jdb666/cao_hc16/book/img/m_glissiere_transp.jpg

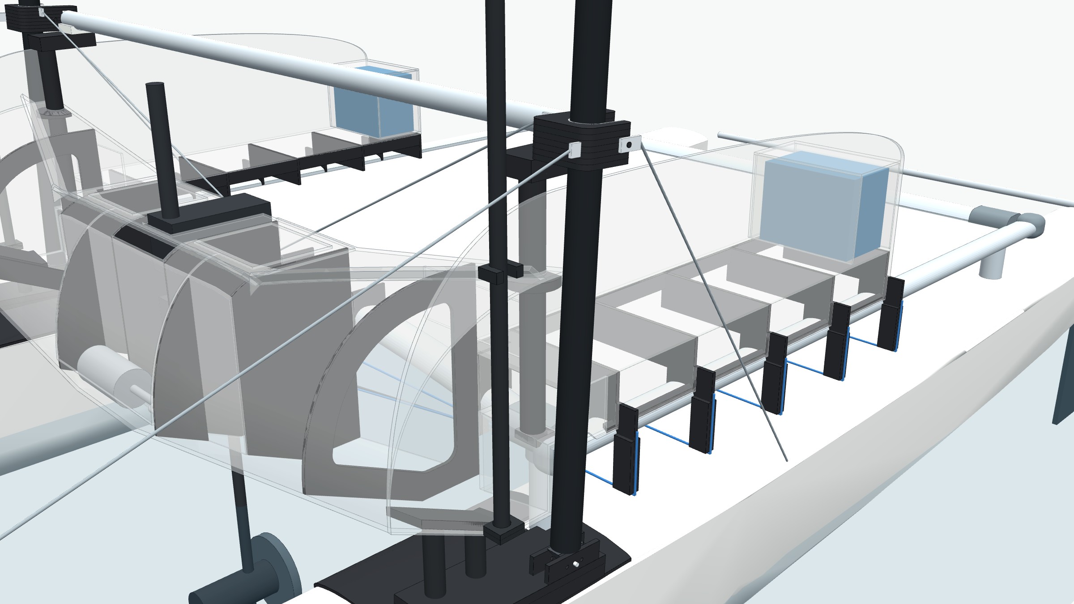
book/img/m_glissiere_transp.jpg
