jdb666/cao_hc16/book/img/blobs/b29e73918799de3eab84e8f3c63f0d14.jpg

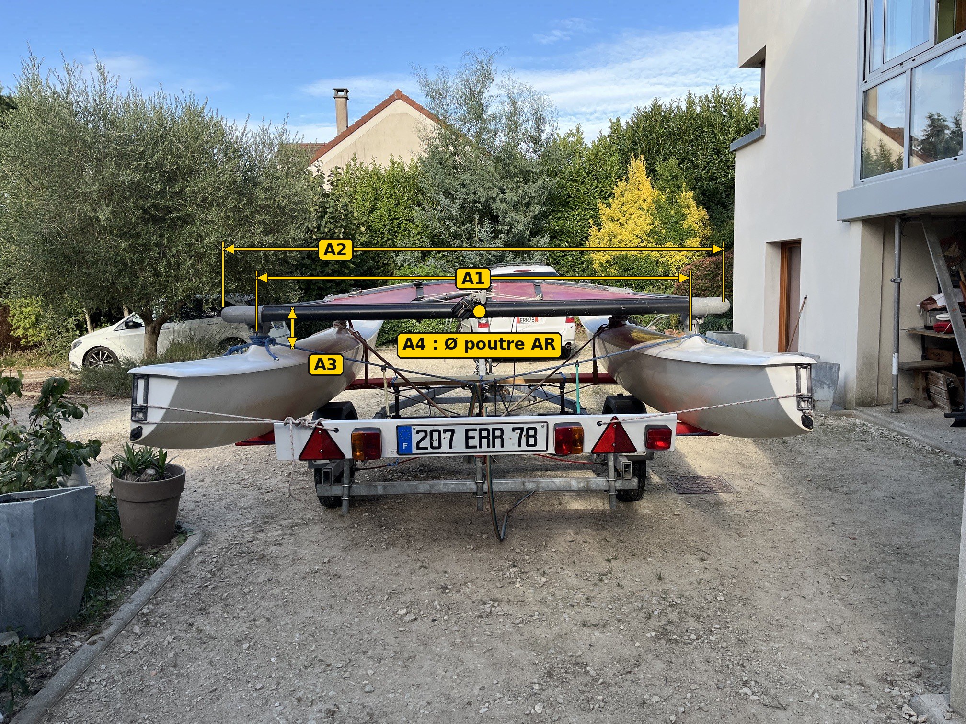
book/img/blobs/b29e73918799de3eab84e8f3c63f0d14.jpg
