jdb666/cao_hc16/SYNTHESE_coffre_hc16.md

# HC16 Rando — coffre porte-mâts et bancs : état du projet (12/10/2026)

## Repère et sources
- Origine : étrave à la flottaison, dans l'axe. X vers l'arrière, Y vers bâbord, Z vers le haut. Unités : mm.
- Ce repère est indirect : un logiciel de CAO affiche les STEP en miroir (bâbord à droite en regardant vers l'avant). Sans effet sur la plateforme, symétrique ; à garder en tête pour le moteur décalé. Les pages 3D (three.js) remettent le bon côté.
- Coques : profil et plan F. Chevalier recalés (±30 mm), sections simplifiées. Plan de voilure : plan Rando de JD (1/25).
- Modèle paramétrique : `hc16_rando.py` lit `cotes.yaml` et régénère le STEP (`python hc16_rando.py cotes.yaml sortie.step`).

## Contraintes figées (décisions JD)
- Nom du projet : HC16 Rando (JD 08/10/2026 : plus de référence au Nacra 5.80).
- Voile d'origine et hauteur de bordure inchangées ; mâts posés sur le pont des coques (pas emplantés au fond).
- Quête 3° ; pied de mât placé pour que le CV voiles pleines = CV HC16 d'origine.
- Collier de mât à 70–80 cm du pied, porté par la joue (JD 06/10 : il tourne sur le tube des colliers ; JD 08–09/10 : c'est le tube qui repose, à plat, sur deux poteaux carbone logés dans le coffre).
- Joues arrondies (JD 30/09) : superellipses, avant tangent à l'horizontale au collier (exposant 2,3 ; 2 = ellipse), dessus plat du collier à C4, dossier en quart de superellipse (2,2) ; extrémités = pointe avant du coffre, collier, bout arrière du banc. JD 09/10 : la joue monte d'un seul trait de la pointe au haut du dossier (400 au-dessus de l'assise, z 1 085), sans décrochage ; le coffre s'arrête dessous (927 contre la joue).
- Coffre cousu-collé : fond et dessus polygonaux à 3 segments (bas au milieu), dessus qui rejoint les colliers de mât ; fond d'abord plat (pente 0°, JD 29/09), puis descendu sous le puits moteur pour que l'hélice relevée y rentre (JD 29/09 soir : z 250, pente 12° vers l'avant) ; rien ne descend sous le fond ; pylônes au bout. JD 09/10 : coffre en moustache, dessus et fond à 10° vers les joues (fond plat ±150 à z 270), fond à 25° vers l'avant, hiloire en haut de l'arrondi ; poche à ancre ouverte devant, puits du moteur ouvert derrière.
- Moteur (JD 29/09/2026 soir) : bascule abandonnée ; relevage vertical dans l'axe, l'arbre coulisse dans sa bride ; l'hélice rentre dans le coffre (puits 256 × 300 ouvert dessous) ; bras rabattu du tube des colliers pour le tenir en haut. Voir « Moteur à relevage vertical dans l'axe ». Variantes « avant2 » (bascule vers l'avant), « arriere », « transversal », « avant » et « vertical » conservées dans le script.
- Batterie (JD 29/09 soir) : bac 650 × 315 × 320 (longueur, largeur, hauteur) devant le moteur, en travers, dans un compartiment ajusté dont les cloisons raidissent le coffre ; pas de couvercle, celui du bac suffit. Coffre agrandi un peu, au milieu seulement (plus haut, pointe du fond avancée). Autres accès au coffre uniquement par des trappes de visite dans C4.
- Joues coffre + dossier d'une pièce, jamais plus hautes que le collier ; le dossier ne couvre que la moitié avant du banc (JD 09/10 : dossier de 400 au-dessus de l'assise, plus haut que le coffre ; la joue va jusqu'à l'accoudoir).
- Un banc par bord sur les longerons, longueur 1,20 m (validée), dossier = joue.
- Voile réduite : ni livarde ni bôme, lattes diagonales ; écoute sur la poutre arrière.

## Poutre avant et martingale (relevées sur photos, 25/09/2026 — remplacé par les relevés du 28/09, voir « Plateforme recalée »)
- Échelle : entraxe des pylônes 2 100, recoupée avec une règle 200 × 100 posée devant ; incertitude ≈ ±20 mm.
- Poutre avant cintrée vers le haut : flèche ≈ +100 au milieu (profil parabolique entre les pièces d'angle) ; diamètre ≈ 65 (à confirmer au pied à coulisse).
- Martingale : pilier sous le milieu de la poutre, pied 144 sous l'axe de poutre aux extrémités (≈ 210 sous le dessous de poutre au milieu), soit z ≈ 446 ; câbles vers les pylônes, fixés ≈ 50 sous l'axe de poutre.
- Hauteurs absolues calées sur l'axe de poutre aux extrémités z 590 (profil Chevalier, à mesurer).

## Géométrie du coffre avant recalage (26/09, plateforme d'avant les relevés — remplacé par « Coffre recalé »)
| Élément | Valeur |
|---|---|
| Pied de mât | x 1 766, y ±1 151 (contre la joue), z 325 ; mât 7 300 × Ø60 |
| Collier | 750 mm du pied (z ≈ 1 074) |
| CV voiles pleines | x 3 010 (= HC16), z ≈ 3 930 ; enroulé 50 % : x ≈ 2 600 |
| Coffre | largeur 2 240, face AR x 1 972, pointe avant x 1 400 ; fond z 378 (milieu) → 465 (joues) ; dessus z 760 (milieu) → 1 099 (joues) ; ≈ 524 L |
| Joues | quart d'ellipse avant + quart d'ellipse arrière jusqu'au bout des bancs (x 3 172), base z 465, sommet z 1 099 au collier ; 9 mm |
| Collier | demi-collier boulonné en haut de la joue (plus de pattes) |
| Pylônes | sous chaque joue, au droit du mât, 120 × 90, CP 9 mm (ou tube alu), du pont à z 500 |
| Bancs | 1 200 × 310 (y 800 → 1 111), assise +100 au-dessus du trampoline, ≈ 40 L dessous, entaillés sur poutre AV et longeron |
| Bois | ≈ 28 kg |

## Moteur (Haswing Protruar 2.0 24 V) — bascule arrière décentrée (26/09/2026 — remplacé le 29/09 par « Moteur à l'envers, relevé vers l'avant »)
| Élément | Valeur |
|---|---|
| Position | arbre à x 1 860, y +620 (bâbord) : tête sous la pente haute du dessus (plat élargi à ±360), loin du pilier de martingale |
| Chaise fixe | sous le fond : planche de serrage 40 × 200 × 70 (M1) entre deux joues massives M2 ; axe de bascule = axe de la bride, z 420 |
| Puits | ouvert en dessous (fond découpé x 1 439–1 966, y 495–745) ; parois N1.1, N1.2, N2 jusqu'au bordé ; encoche 90 × jusqu'à z 470 dans le bas de C4 pour l'arbre basculé |
| Carter | fond M3 et face avant M4 (CP 9) sous le coffre, devant la planche : la tête basculée s'y couche |
| En marche | axe d'hélice −410, haut des pales −292 ; tête jusqu'à +800, dans le puits |
| Relevage | barre tournée de 90° (nacelle en travers ; puits de 250 pour la rotation de la tête), puis bascule vers l'arrière jusqu'à l'horizontale |
| Relevé | embase couchée sous le trampoline (hélice à 19 mm sous la toile), point le plus bas +312 au-dessus de l'eau |
| Contrôle | aucun contact de 0 à 90° ; jeux mini : 6 mm tête / face arrière en marche, 10 mm tête / joues de chaise relevé |

## Batterie 24 V 100 Ah (26/09/2026, au milieu, bac 650 × 315 × 320 — remplacé le 29/09 : en travers à tribord du canal)
| Élément | Valeur |
|---|---|
| Batterie | Dyness 24 V 100 Ah LiFePO4 : 531 × 206 × 217, 19,3 kg ; bac réel 650 × 315 × 320 |
| Place | au milieu, à plat sur C1 (plat élargi à 720), debout, 650 parallèle à la poutre, bornes en haut, dos à 11 mm de C4 |
| Encombrement | x 1 640–1 955, y ±325, z 384–704 ; 15 mm sous la trappe, 164 mm du puits |
| Centre de gravité | x 1 798, y 0, z ≈ 497 |
| Câblage | ≈ 0,5 m jusqu'au moteur, presse-étoupe dans la paroi N1.1 du puits |
| Mise en place | trappe T1 plane dans C5 (x 1 633–1 962, y ±332 ; bords de 28 mm jusqu'aux cassures), découpée après cintrage et stratification ; le bac descend à la verticale. Descente vérifiée sans contact |

## Accès au coffre
- Trappe T1 dans C5 : batterie uniquement.
- Deux trappes de visite dans C4, au-dessus de la poutre : tribord y −1 060 à −812 (248 × 180, à tribord du compartiment batterie depuis le 29/09), bâbord y 770 à 1 060 (290 × 180), z 700–880 ; portes C4.2 et C4.3 prises dans les découpes de C4.1, sur cadre intérieur, joint et verrous.

## Coffre (version bascule arrière, 26/09/2026)
- Fond polygonal : plat C1 z 378 sur ±360 (720 de large, pour le bac), pans jusqu'à z 465 au droit des joues.
- Dessus polygonal : plat C5 z 760 sur ±360, pentes jusqu'à z 1 099 au droit des joues (haut du collier). Le milieu est limité par la tête du moteur (pic ≈ 808 en début de bascule, à y 400–600) et par le bac de batterie (15 mm sous la trappe).
- Joues : base z 465, sommet z 1 099 au collier ; demi-collier boulonné sur la joue.
- Dossier au-dessus de l'assise (z 670) : 414 mm à x 2 100, 341 à 2 500, 175 à 2 900. Garde sous la bordure ≥ 358 mm.
- Cloison C9.1 à y −500 (compartiment tribord, accès par la trappe de visite tribord). Le puits du moteur est côté bâbord.
- Bordé en 3 panneaux : central C5 720 × 785 (cylindrique) ; latéraux développables — les profils sont paramétrés à pente égale, les génératrices relient des points de même tangente (torsion 0° au lieu de 14° avec des génératrices transversales). ≈ 505 L.
- Plans : 2 panneaux + 1 demi-panneau CP 6 mm ; 1 panneau + 1 demi-panneau CP 9 mm ; DXF dans plans/dxf2.

## Tente igloo sur mesure (26/09/2026)
- Couvre bancs, trampoline et arrière du coffre, voiles roulées : 2570 × 2240 au sol (x 1 550 → 4 120, y ±1 120), sommet z 1901 (1331 au-dessus du trampoline). Le nez du coffre (x 1 400–1 550) reste dehors : le bord avant se lace sur une latte transversale du dessus du coffre.
- Arceaux : 2, en diagonale, croisés au sommet ; forme d'équilibre d'une tige élastique articulée aux pieds (elastica) passant par le sommet → longueur 4238 mm entre pointes, angle au pied 51° sur la corde. Tube alu 7001 Ø 9,5–11, 9 brins ≈ 47 cm.
- Pieds : sur le dessus des joues à x 1 550 (z ≈ 958) et aux bouts de la poutre arrière (z 622).
- Surface de toile : les diagonales suivent exactement l'arceau ; le reste est interpolé (courbes de niveau carrées, arêtes aux arceaux). Garde mini toile / coffre 17 mm près du bord avant.
- Patron (simple paroi) : 4 pans séparés par les coutures d'arceau, 4 fuseaux par pan rayonnant du sommet (AV1–4, AR1–4, L1–4 ×2 en miroir) + 2 jupes J ; développement par moindres carrés, allongement max 0.75 %. Couture 15 mm, ourlet 30 mm. 10.9 m² coupés ; 12.61 m de toile en laize 1 500.
- Fichiers : `plans/tente.py` (surface, arceaux), `plans/patron.py` (développés, placement), `plans/dxf_tente/patron_tente_laize1500.dxf` (calques DECOUPE, COUTURE, REPERES).
- Une tente du commerce ne couvre pas le coffre (joues à +530 au-dessus du trampoline, mâts à ±1 151) ; une dôme 210 × 210 × 130 posée entre C4 et la poutre arrière couvre le trampoline seul.

## Contrôles
- Garde tête / bordure (assise +100, tête à 0,98 m de l'axe) : −40 mm à x 2 450, 0 à 2 800, +16 à 2 950, +33 à 3 100, +68 à 3 400. Avec des bancs de 1,20 m, une seule place par bord, au bout.
- Couple de chavirage (surface × hauteur du CV), refait le 05/10 avec le rond de chute compté pour les deux gréements : deux voiles pleines +24 % vs HC16 ; une voile pleine −38 % ; deux voiles à 50 % −44 % ; une seule voile à 50 % −72 %. L'ancien +37 % comparait la Rando avec son rond de chute au HC16 sans (triangles). Réduire tôt.
- Vent arrière : au-delà de ~80° de choqué du même bord, la livarde au vent touche le mât sous le vent → ciseaux.

## Construction (cousu-collé, CP okoumé)
- Bordé cintré (rayon mini ≈ 330 depuis les joues arrondies) : 4 mm ; fond 6 ; face AR 6 ; joues 9 (doublées au collier) ; cloisons 6 (évidées) ; assises 9 (ou 6 + lisses).
- Arêtes extérieures arrondies R ≥ 15 sous tissu ; trappes d'accès sur la face arrière.
- Allègement possible vers ≈ 25 kg de bois : joues 6 mm hors zone collier, assises 6 mm sur lisses, cloisons évidées.

## Écoute (voile réduite)
- Tire idéale = prolongement milieu du guindant → point d'écoute. Surface 75 % : hors bateau (≈ 5,45 m) ; 50 % : ≈ 4,78 m ; 25 % : sur la poutre AR.
- Montage : écoute sur rail de poutre AR ; barber (anneau sur l'écoute → poulie sur pontet extérieur du pont arrière vers 4,90–4,95 m → renvoi le long du bord extérieur → taquet vers 2,8 m, à portée de l'assise).
- Barre d'accouplement 20–30 cm derrière la poutre AR : barber toujours à l'extérieur des bras de safran, jamais sous la barre.
- Côté extérieur, angle d'écoute limité à ~3° sans bras en porte-à-faux.

## Photos du bateau (28/09/2026) et relevés
- 4 photos sur remorque (profil tribord, dessus, avant, arrière) annotées : repères P1–P7, Q, D1–D4, V1–V7, A1–A4 (`releves/`, page « Relevés HC16 » avec saisie).
- Angle du pont au pied de mât, d'après le profil : la bande décorative a son point bas sous la poutre avant ; au pied de mât prévu, le pont monte vers l'étrave de ≈ +1,7° par rapport au longeron (±0,7°). Le modèle donne −0,7° (point bas de la ligne de pont à x 1 630) : table `coques.pont` à recaler après relevé P7. Remorque : bateau nez en bas ≈ 1,1°.
- En travers : non mesurable sur ces photos ; modèle ≈ 10° (pied sur le bombé). À relever (V6, V7) pour les cales d'embase de mât.

## Profils des poutres et longerons (DWG, 28/09/2026)
- Relevés sur les DWG « pince DN » (longerons) et « pince 2 étambrai » (poutres avant et arrière), unités lues en mm ; profils dans `profils_hc16.json`, figure `releves/profils_poutres_dwg.png`.
- Longerons : goutte Ø 44 au nez, ≈ 73 × 44,5, queue vers l'intérieur relevée de 7,5°, fente de trampoline 2 mm au bout (y ≈ ±999).
- Poutres AV et AR : goutte Ø 62 au nez, 95,5 × 62, queue symétrique vers le trampoline (vers l'arrière pour la poutre AV, x ≈ 2 075 ; vers l'avant pour la poutre AR, x ≈ 4 056), fente 2 mm, entrée 10 mm.
- Intégré au modèle : poutres et longerons extrudés au profil (poutre AV cintrée par sections), trampoline lacé au bout des queues (z 593), joues à encoche en U au profil (575–679 mm depuis la pointe), bancs décalés à x 2 084 (derrière la queue de la poutre AV), encoche des bouts de banc B4 au profil du longeron, fond B3 arrêté avant le longeron. Contrôles moteur 0–90°, descente du bac et tente refaits : sans contact ; nez de poutre à 7 mm de C4.

## Plateforme recalée sur les relevés (28/09/2026)
- Relevés JD : P1 5 050 · P2 2 070 · P3 4 140 · P4 +1,7° avec Q 0° (longerons de niveau) · P5 250 · P6 500 · P7 flèches cordeau → pont (bord extérieur) à 0,5 … 5,0 m : 45, 85, 105, 110, 105, 90, 75, 55, 30, 2 · D1 2 080 · D3 190 · D4 2 000 × 2 100 · V1 2 000 · V2 100 · V4 170 · V5 1 000 (distance à l'axe) · A1 2 000 · A2 1 850 · A3 210 · D5 2 170 (face avant de la poutre AV → face arrière de la poutre AR, le long d'un longeron) · V5 : jour de 15 entre le dessous de la poutre AV et la tige, au ras de la pièce d'angle (confirmé sur photo) · D2 : 2 230 entre faces extérieures des longerons, en travers au milieu du trampoline. V6, V7 non disponibles. À relever : D6 (nez à nez des pièces d'angle le long d'un longeron, modèle ≈ 2 269), V9 (dessus de la poutre AV au-dessus du pont au ras de la pièce d'angle, modèle 261). Sections des poutres et longerons : DWG. Martingale : pilier + deux tiges inox rigides (pas des câbles).
- `cotes.yaml` recalé (ancien : `cotes_avant_releves.yaml`, `hc16_rando_avant_releves.py`) : entraxe 2 000 ; demi-largeurs × 1,168 ; quilles × 0,895 ; pont = corde étrave 450 → tableau 380 (plan Chevalier) moins les flèches P7, appliquées à l'axe de coque avec un bouge constant de 35.
- Poutre AV x 2 070, axe z 539,5 aux bouts, flèche 100 ; poutre AR x 4 145 (compromis entre P3 et D1), axe z 524 ; entraxe des poutres 2 075. Plateforme cabrée de 0,43° dans le repère flottaison.
- D5 : l'axe relevé (axe des pièces d'angle) passe au milieu de la section, 16,5 derrière le centre du nez du profil DWG (`poutre_axe_u: 16.5`). Poutre AV : nez x 2 022,5, queue 2 118 ; poutre AR : queue 4 097, nez 4 192,5. Poutres de 2 080 (bouts dans les pièces d'angle, y ±1 040).
- Cintrage de la poutre AV : parabole entre les pièces d'angle (y ±925, flèche 100), horizontale dans les pièces (`poutre_av_y_libre: 925`) ; ajustée sur la photo de face du 25/09 (rms 0,6 px, contre 2 px pour une poutre encastrée). Hauteur poutre / longeron au ras de la pièce supposée égale (V9).
- Longerons en goutte à y ±1 093 (D2 : 2 230 / 2 − 22 de rayon de nez), prolongés de 60 dans les pièces d'angle. Pièces d'angle d'après photos (28/09) : manchon 108 × 80 autour de la poutre (y 925 → 1 050), nez arrondi autour du bout du longeron (y 1 040 → 1 122, 70 de haut) qui dépasse jusqu'à 97 devant l'axe de la poutre AV (derrière pour l'AR), soit ≈ 50 devant la face de la poutre, emboîture Ø 84 sur le pylône. Nez à confirmer par D6.
- Trampoline lacé au bout des queues : 1 979 × 2 084 entre fentes ; D4 (2 000 × 2 100) est plus grand de 21 et 16 : la toile entre d'une dizaine de mm dans chaque fente.
- Martingale : pied du pilier 170 sous l'axe (z 369,5), tiges inox rigides Ø 6 (mesuré sur photo) vers y ±1 000 ; tige à 49 sous l'axe au ras de la pièce d'angle (jour de 15 sous la poutre), z 450,6 au droit du moteur (y 620) : 7 plus haut que l'hypothèse de départ (et non +22 comme annoncé un moment).
- Contrôles : largeur hors-tout 2 396 (fiche HC16 : 2 413). Pente du pont au pied de mât par rapport aux longerons : modèle +0,9° (+1,4° / flottaison), P4 +1,7° ; on retient P4 pour la cale de pied de mât.
- Mât posé à plat sur le pont (x 1 766, y 1 101) : quête 2,1° / flottaison avec P4 (1,3° avec la tonture du modèle) → cale de 0,9° pour 3° (1,5 mm sur 100, plus épaisse à l'avant) ; en travers, le bombé du modèle pencherait le mât de 6,6° vers l'extérieur (cale ≈ 11,5 mm sur 100, plus épaisse à l'extérieur).
- Scripts : `build(cfg, plateforme_seule=True)` → `hc16_plateforme.step` ; `plateforme/dessins.py` (vues cotées SVG), `plateforme/export3d.py` (maillages, modèle précédent en fantôme), `plateforme/page.py` → page « Plateforme HC16 ».
- À reprendre sur le coffre après validation : pieds de mât y ±1 101 et z 312 ; coffre 2 140 de large ; les joues (y ≈ ±1 066) traversent le nez des pièces d'angle AV (y 1 040 → 1 122, jusqu'à x 1 973, au contact de la face C4 à x 1 972) : pied de joue à redessiner autour ; garde du moteur relevé à recalculer (trampoline ≈ 55 plus bas et plus bas sur les côtés, tige à z 450,6 à y 620) ; bancs à partir de x 2 124 (derrière le manchon de la pièce d'angle) ; tente jusqu'à la poutre AR (nez des pièces d'angle à x 4 242).

## Pied de mât : semelle CP sur bourrage époxy (décision JD, 28/09/2026)
- Le pied de mât pose sur un plat CP collé au pont, assez grand pour reprendre la compression du mât ; il est parfaitement parallèle au collier, lui aussi en CP. Ces deux pièces fixent la quête (3°) et l'inclinaison en travers (0° retenu, mât vertical). Le plat est collé sur un bourrage époxy qui rattrape le bombé et la pente du pont.
- Proposition (cotes.yaml `mats.semelle`) : semelle 220 × 190, CP 18 (2 × 9), x 1 656 → 1 876, y 960 → 1 150 (mât à y 1 101) ; elle reçoit aussi le pylône du coffre (y 971 → 1 061).
- Bourrage calculé sur le pont recalé, pente locale P4 (2,13° / flottaison) : 3 mini → 20 maxi (coins : AV int. 7, AV ext. 20, AR int. 4, AR ext. 16), ≈ 350 cm³ par semelle, époxy chargée silice + fibres. Au-delà de 10 mm : cale CP biseautée sous le côté extérieur.
- Dessus de semelle au pied de mât z 340,5 (28 au-dessus du pont) ; centre du collier x 1 805, z 1 090 ; quête à la remorque (longerons de niveau) 2,6°.
- Pose : collier en place, mât ou tube Ø 60 passé dedans jusqu'à l'embase sur la semelle posée sur trois plots, puis bourrage.
- Collier CP fixé / stratifié au coffre (croquis de JD attendu) ; inclinaison en travers 0° retenue (mât vertical : jeu constant le long de la joue, voile qui se recentre seule avec la quête).
- Coffre haubané (décision JD) : à l'avant sur les pattes d'étrave (pointes), à l'arrière sur les cadènes d'origine, sur le bord du pont environ 600 derrière la poutre AV (lu sur la photo de dessus) ; haubans croisés devant et derrière pour l'effort latéral. Ordres de grandeur pour 4,2 kN au collier (20 nœuds apparents, voile pleine) : hauban AR ≈ 5,6 kN (dont 3,7 kN vers le bas sur le coffre), hauban AV ≈ 4,5 kN.
- Tenue : charge de pointe sur une semelle ≈ 5–8 kN (pied de mât 1–3 kN + pylône du coffre qui reprend la composante verticale des haubans), soit 0,1–0,2 MPa : sans souci pour le CP. Points à soigner : talon de pied de mât plein (Ø ≥ 60, mieux une rondelle Ø 90–100) car le tube nu concentrerait 4–8 MPa sur le CP ; embase (bague) collée et vissée pour l'effort horizontal de 3–5 kN ; pont du HC16 (sandwich mousse ancien) à sonder, idéalement renfort intérieur (épontille ou petite cloison) sous la semelle par une trappe de visite.

## Moteur à l'envers, relevé vers l'avant (JD 29/09/2026 — abandonné le soir même pour le relevage vertical)
| Élément | Valeur |
|---|---|
| Montage | bride à l'envers au milieu (arbre à y 35), planche de serrage CP 40 × 70 derrière l'arbre, collée entre les parois du canal (x 1 680–1 720, z 420–490) ; direction serrée à 160° : hélice derrière l'arbre, poussée vers l'avant à 20° de l'axe |
| En marche | arbre x 1 610 ; axe d'hélice −310, bas de pale −428 ; tête (200 × 140 × 260 estimée, barre repliée) au-dessus du dessus, z 640–900 |
| Axe de bascule | axe de la bride, x 1 620, z 530 (avancé de 16 le 29/09 : à 1 636, le coin de la tête passait 5 dans C4 entre 65 et 82°) |
| Puits (réduit au maximum) | fente de 60 pour l'arbre à travers le fond et la face avant, de la pointe à x 1 635, coffrée et fermée à z 580 ; canal de la tête de 236 (y −83 → 153), de x 1 460 à C4, ouvert dessus de x 1 460 à 1 975 ; parois CP 6. Nacelle et hélice n'entrent jamais dans le coffre |
| Relevage | poignée sur 0, barre repliée ; rien à tourner ; levier d'inclinaison (accès par l'ouverture du canal), tête poussée vers l'arrière : elle descend dans le canal, l'arbre glisse dans la fente, la nacelle remonte devant la pointe ; dernier des 10 crans = arbre horizontal |
| Relevé (90°) | arbre horizontal à z 540 ; nacelle debout devant la pointe, jusqu'à x 662 (728 devant la pointe), point bas z 330 ; tête couchée dans le canal (x 1 730–1 990) |
| Contrôle | balayage 0 → 90° tous les 5° contre toutes les pièces (`etudes/balayage_moteur.py` → `plateforme/balayage.json`) : aucun contact. Jeux mini : 10 arbre / fond de fente (0°) et tête / planche (90°), 11 tête / C4 (75°), 31 poutre AV (60°), 57 nacelle / haubans croisés du collier (90°), 75 bac de batterie, ≥ 120 trampoline et laçage |
| Haubans | croisés du collier : traversent le plan de l'arbre à x 811, z 761 et x 866, z 783, 57 au-dessus de la nacelle relevée. Croisés des semelles retirés : devant, leur croisement (x 820, z 412) est dans la nacelle relevée ; vers la cadène opposée (croisés AR, que JD ne voulait pas), ils traversent le pont de l'autre coque sur ≈ 300 (y 872 → 1 168, bombé). Reste dans le plan des semelles : directs AV et AR. Un croisé bas demanderait un pontet neuf sur le bord intérieur du pont d'en face (proposé à JD) |
| Page | bouton « Relevage du moteur » 0–90° : maquette 3D, coupe dans le plan de l'arbre, jeux au cran de 5° le plus proche, bouton Relever / Baisser animé |

## Batterie en travers à tribord du canal (29/09/2026 — remplacé le soir : batterie devant le moteur)
- Demande JD : bac en long (650 dans le sens de la marche), coffre agrandi devant si nécessaire. Sous le dessus à 800, l'arrondi avant ne laisse 320 de haut qu'à partir de x ≈ 1 550 ; dos du bac à 11 de C4 → avant du bac à x 1 355, devant la pointe (1 390) : il faudrait avancer la pointe de 336 (x ≈ 1 054 ; 518 avec l'ancien dessus à 760), et les haubans AV du collier traverseraient alors les joues rallongées. Pas fait, en attente de JD.
- Retenu en attendant : bac en travers x 1 690,5–2 005,5, y −790 → −140 (à tribord du canal), sur deux cales CP qui rattrapent le pan du fond (z 437–757), dos à 11 de C4, CdG x 1 848, y −465, z 549. Dessus relevé de 760 à 800 pour le bac. Compartiment juste au bac : cloisons CP 6 avant (x 1 674,5–1 680,5), côté canal (y −130 → −124) et côté joue (y −806 → −800) + C4 ; trappe T1 x 1 681,5–2 010,5, y −795 → −135, à cheval sur le plat et le pan du dessus. Jeux : 3 au fond, 51 au canal. Sortie verticale du bac libre une fois le tube des colliers démonté (86 au-dessus du bord haut de T1, 272 au-dessus du bord bas).

## Moteur à relevage vertical dans l'axe (JD 29/09/2026 soir, retenu)
| Élément | Valeur |
|---|---|
| Cotes du moteur | Protruar 2.0 85 lbs 24 V (manuel : 960 W, arbre 900, 6,7 kg ; en ligne : arbre 90 cm, aucune course donnée). Relevées sur le schéma p. 13 à l'échelle de l'arbre (900 entre tête et nacelle, Ø 30) : tête 264 de long (135 derrière l'arbre, 129 devant avec l'articulation de la barre), 140 de haut sans la barre, largeur estimée 120 ; barre repliée vers le haut (Ø 40 × 315, articulation 99 devant l'arbre) ; nacelle Ø 100 × 220, nez 159 devant l'arbre ; aileron 90 sous la nacelle ; hélice Ø 236 (9,3"), disque 66 → 91 derrière l'arbre ; fourreau de bride 164 ; collier de hauteur 52 ; face de planche à 56 de l'arbre |
| Course de l'arbre | 900 − 164 − 52 ≈ 684 (736 sans le collier) ; JD pensait 76 cm : il faudrait un fourreau plus court que sur le schéma. Levée retenue 674 (nacelle 10 sous la bride) |
| Montage | normal, dans l'axe : arbre x 1 910, y 0 ; planche CP 40 × 110 (x 1 814–1 854, z 480–590) collée entre les parois du puits, vis de serrage devant elle ; bride fixe z 474–638 ; poussée dans l'axe |
| En marche | tête z 690–830 (barre jusqu'à 1 145), axe d'hélice −260, bas de pale −378, aileron −400 |
| Relevé (674) | l'hélice rentre dans le coffre : z 296 → 532 (bas à +296 au-dessus de l'eau) ; avec le fond descendu (voir plus bas), tout le bas du moteur est dans le puits (bord bas z 250, 24 sous l'aileron, 46 sous l'hélice) ; nacelle z 364–464 (10 sous la bride, 16 sous la planche) ; aileron +274 ; tête z 1 364–1 504, barre jusqu'à 1 819 ; bras alu 30 × 8 rabattu du tube sur l'arbre |
| Puits | CP 6, 256 × 300 intérieur (y ±128, de x 1 717 à C4), ouvert dessous et dessus : c'est le disque d'hélice (Ø 236) qui fixe la largeur ; paroi avant = cloison arrière du compartiment batterie ; C4 échancrée à y ±70 au-dessus de z 680 (l'arrière de la tête dépasse de C4 de 22 au-dessus du nez de la poutre, 20 au-dessus en marche) |
| Tube des colliers | avancé à x 1 741 (de 64) et descendu à z 1 075 (de 22), juste devant les colliers, entre les joues : la tête passe 15 derrière lui et il reste sous le haut des joues ; démontable. Sans ça, la tête (264) ne peut pas passer derrière le tube en gardant l'hélice devant C4 |
| Contrôle | `etudes/balayage_levee.py` (0 → 674 tous les 25, contre toutes les pièces) : aucun contact. Jeux mini : 10 tête / échancrure de C4 (en bas), 10 hélice / parois du puits et nacelle / bride (en haut), 15 tête / tube, 20 tête / poutre (en marche), 26 hélice / bride, 29 arbre / étrier, 43 nacelle / bac (à travers la cloison), 57 hélice / pilier de martingale. Contrôle statique en marche et relevé : seuls les recouvrements voulus |

## Batterie devant le moteur (JD 29/09/2026 soir)
- Bac 650 × 315 × 320 (JD : longueur, largeur, hauteur) en travers : x 1 393–1 708, y ±325, z 384–704, CdG x 1 550,5, y 0 ; depuis le fond descendu, posé de niveau sur deux cales (voir « Fond descendu sous l'hélice relevée »).
- Caisse ajustée à 3 du bac pour qu'il participe à la rigidité (JD) : cloison avant x 1 384–1 390, côtés y ±328 → ±334, arrière = paroi avant du puits moteur (x 1 711–1 717, largeur 668), CP 6 du fond jusqu'à z 900. La caisse traverse le dessus (découpé à son contour extérieur) et monte en parallélépipède au-dessus de l'avant arrondi (JD) ; couvercle CP 9 amovible (z 900–909) ; l'ancre posée dessus, sanglée (JD) : grappin pliant ≈ 3–4 kg dans le modèle (faisceau Ø 100 × 200, verge 120, anneau Ø 50), couché en travers. JD 30/09 : hauteur du compartiment de l'ancre divisée par 2, et il reste ouvert → caisse jusqu'à z 810 là où le dessus du coffre est plus bas (91 au-dessus à l'avant au lieu de 181), affleurant le dessus plus loin ; plus de couvercle ; l'ancre couchée en travers dans la caisse sur le couvercle du bac (z 704 → 804). Paramètres `compartiment_batterie.caisse` {z_haut 810, couvercle 0}, `ancre.sur: bac`.
- Sortie de la batterie : ancre (et couvercle, avant le 30/09) ôtés, le bac monte à la verticale, 8 devant le tube des colliers (face AV x 1 716) : vérifié sans le démonter. Nable au fond de la caisse.
- Coffre agrandi au milieu seulement : dessus z 900 sur ±360 (abaissé à 810 le 30/09, voir « Partie centrale plate et table »), pointe du fond avancée à x 1 250 sur le plat C1, raccord droit jusqu'aux joues ; joues inchangées (pointe 1 390). Bordés latéraux développables (paramétrage à pente égale étendu aux pointes différentes). Volume 774 L (831 L avec le fond descendu). Paramètres `avant_x_milieu`, `avant_plat_demi`.
- Tenue (question JD, 20 kg) : poutre-caisson, contraintes globales négligeables. Fond sous le bac (portée 334 × 670) à 4 g : CP 6 → 7 MPa, 3,5 mm ; CP 9 → 3 MPa, 1 mm. Conseil : fond de la caisse en CP 9 ou CP 6 stratifié des deux côtés, bac sanglé sur ses cales, cloisons collées-congées.

## Couples intérieurs derrière les accroches de la poutre AV (JD 29/09/2026 soir)
- Question JD : pourquoi pas de couples dans le coffre au droit des accroches ? Ils manquaient : les accroches n'étaient que collées sur C4 (CP 6), avec un doublage pour les boulons des cornières ; les efforts de la poutre passaient en flexion dans C4.
- Corrigé : 6 accroches à y ±131, ±331, ±850, chacune dans le plan d'un couple intérieur qui reprend C4, le fond et le dessus : ±131 = parois du puits moteur ; ±331 = côtés de la caisse batterie prolongés jusqu'à C4 (CP 6, évidés derrière la caisse : cadre 50, R 25) ; ±850 = couples CP 9 sur toute la section du coffre (x 1 347 → C4), évidés (cadre 60, R 30), sous l'avant des bancs. Cornières boulonnées à travers C4 dans un tasseau collé contre le couple. Paramètre `couples_coffre`.
- Trappes de visite de C4 déplacées entre les couples : y ±400 → ±790, z 700–880.
- Question JD : assez de couples pour tenir le coffre ? Pas dans les baies latérales : rien en travers entre la caisse ou le puits et les joues, là où le coffre porte sur ses 4 pylônes (x 1 716 et 1 816, y ±1 066, à 45 de la joue) et où les colliers tirent sur les joues ; les panneaux du fond y faisaient 510 × 770 en CP 6.
- Essai du 29/09 (retiré le 30/09, voir la puce suivante) : de chaque côté trois couples transversaux évidés (cadre 60, R 30), de la caisse ou du puits jusqu'à la joue, en tronçons entre les couples longitudinaux ; ceux-ci gardent un poteau plein (épaisseur + cadre) au croisement pour le collage : x 1 705–1 714 CP 9, sur les pylônes AV, 2 devant le tube des colliers ; x 1 811,5–1 820,5 CP 9, sur les pylônes AR et au droit des colliers, dans le plan de la planche du moteur (départ contre le puits, y ±134) ; x 1 497–1 503 CP 6, qui coupe en deux les panneaux de devant. Le haut des pylônes porte sous ces couples (coupé à la pente du fond). Panneaux du fond des baies latérales ≈ 250 × 510 au plus ; le plus grand reste le fond sous la batterie (CP 9 ou CP 6 stratifié). + 13 dm³ de CP (≈ 7 kg) ; pour alléger, CP 6 et cadre 50 : ≈ 4,5 kg. Contrôles : pas de recouvrement nouveau hors dessus des pylônes ; relevage 0 → 674 sans contact, couples à ≥ 74 des pièces mobiles ; sortie du bac inchangée. Paramètre `couples_travers`.
- JD 30/09 : « tous les couples sont nécessaires ? j'aurais gardé que ceux dans le sens de la longueur ». Non, les transversaux ne sont pas indispensables : le coffre est fermé par C4 derrière et se referme en pointe devant (pas de déformation de la section à reprendre loin d'une cloison) ; les colliers sont à 217 de C4 et reliés par le tube ; les tubes carbone portent à 45 des joues, qui reprennent leur effort. Retirés (`couples_travers: []`, paramètres gardés en commentaire) ; restent les couples en long (±131 parois du puits, ±331, ±850), C4 et la caisse. À la place : une semelle CP 18 de 220 × 100 collée sur le fond contre chaque joue, sur les deux tubes, dont le haut est coupé à la pente du fond (`pylones.renfort`). Fond des baies latérales en panneaux de 510 × 700, en V à 14° : à stratifier (ou CP 9). Poids : ≈ 7 kg de moins que l'essai, + 0,4 kg de semelles.

## Haubans et finition (JD 29/09/2026 soir)
- Plan des semelles : directs AV et AR, croisés AV (vers la patte d'étrave opposée) et croisés AR rétablis. Les croisés AR vont à un pontet neuf au bord intérieur du pont d'en face, au droit de la cadène (x 2 690, 186 à l'intérieur de l'axe de coque, 8 au-dessus du pont) : jusqu'à la cadène, ils traversaient le pont bombé sur ≈ 300. Ils se croisent sous le trampoline, derrière la poutre AV. Paramètre `semelle.pontet_interieur`.
- Finition : coffre, joues, assises, trappes C4 et caisse batterie (parois, couvercle) peints en blanc ; couples des bancs, couples intérieurs, accroches de la poutre AV, colliers, fourreaux de livarde, semelles, renforts, bourrages, puits et planche du moteur en noir ; brêlage et laçage en bout bleu. Trampoline en mesh blanc (JD). Couleurs dans le STEP (`peinture` de `cotes.yaml`) et sur la page (trame ajourée pour le mesh).
- Dessin du bateau (JD) : yin-yang (taijitu, anneau noir) Ø 360 sur la face extérieure de chaque joue, sur le dossier derrière le mât (centre x 2 250, z 870) ; sur les deux faces de chaque voile, même taille (JD : plus petit), dans le coin du point d'écoute au-dessus de la livarde (JD, après un essai en haut de la voile) : centre x 4 324, z 2 139, à 100 de la chute et 60 de la livarde (entre la livarde et la bordure, il ne reste que 35 cm) ; voile en partie roulée : il avance avec la toile et la partie roulée le coupe. Décalques de 0,4–0,5 dans le STEP (`decor_yinyang_*`). Paramètre `coffre.yinyang`.

## Fond descendu sous l'hélice relevée (JD 29/09/2026 soir)
- Demande JD : faire descendre le puits arrière central sous l'hélice relevée, quitte à changer la pente du fond. Relevé (674) : aileron à z 274 (x 1 860–1 920), hélice à 296 (x 1 976–2 001), nacelle à 364.
- Fond : z 250 sur ±250, de x 1 860 à C4 : bord bas du puits 24 sous l'aileron, 46 sous l'hélice ; tout le bas du moteur relevé est dans le puits. De x 1 860, le fond remonte à 12° jusqu'à la pointe (z ≈ 380 au milieu, comme avant). Même pente partout (montée calculée à chaque station) : les panneaux de fond restent plans malgré les pointes différentes (x 1 250 au milieu, 1 390 aux joues). Au droit des joues, le bas de la pointe remonte de 100 (465 → 565) ; bas des joues à l'arrière inchangé (465).
- Contrainte : les haubans croisés AR du plan des semelles passent sous les coins arrière du coffre (z 342 au droit de C4, y ±704). Avec le plat à ±360, le V latéral serait passé à 5 d'eux ; plat réduit à ±250 (V à 14°) : 17 sous le fond. Pointe du fond gardée à x 1 250 sur ±360 (paramètre `avant_plat_demi`).
- Batterie : bac de niveau, à la même hauteur (z 384–704), sur deux cales transversales CP de 40 taillées au fond en pente et en V (14 à 91 de haut), 10 au-dessus du point le plus haut ; caisse et cloison du puits descendent jusqu'au fond. Pylônes : haut coupé à la pente du fond (z 490 devant, 469 derrière, au lieu de 466).
- Volume 831 L (774 avant). Contrôles : relevage 0 → 674 sans contact, jeux mini inchangés (10 hélice / parois du puits, 10 nacelle / bride, 15 tête / tube, 20 tête / poutre) ; sortie du bac inchangée (8 au tube) ; recouvrements : seuls les voulus (tubes carbone à travers le fond, coupés à sa pente, sous les semelles CP 18). Haubans croisés AR à 17 du fond, tiges de martingale à 44, pilier à 35.
- Paramètres : `fond_z` 250, `fond_plat_demi` 250, `avant_plat_demi` 360, `fond_pente` {deg 12, x0 1 860}, `batterie.cales` {ep 40, jeu 10}. Sauvegarde avant : `cotes_avant_fond_puits.yaml`, `hc16_rando_avant_fond_puits.py`.

## Partie centrale plate et table (JD 30/09/2026)
- JD : « le niveau haut du coffre batterie + ancre est bien ; mettre au même niveau et plat toute la partie centrale jusqu'au-dessus de la poutre ; une planche légère vient fermer le tout pour faire une table ».
- Dessus central (plat C5, ±360) abaissé de 900 à 810, au niveau du haut de la caisse ; de là il remonte jusqu'aux colliers au droit des joues (1 122, inchangé ; pans à 22,6°). La caisse monte à 810 partout : devant, elle dépasse de l'arrondi (150 à la cloison avant x 1 384). Volume 748 L.
- Table : planche légère de 10 (CP 6 raidi, ou sandwich) posée à z 810, x 1 384 → 2 118 (96 en porte-à-faux au-dessus de la poutre AV), y ±360. Découpe 284 × 140 (x 1 771–2 055, y ±70) pour la tête et la barre du moteur, à 10 de jeu : en marche la tête dépasse de 10, au relevage elle monte au travers ; la vis de direction se desserre par la découpe. Elle ferme la caisse (batterie + ancre, 6 au-dessus de l'ancre) et le haut du puits ; à ôter pour sortir la batterie. Paramètre `table`.
- Trappes de visite de C4 ramenées sous le haut de C4 : y ±500 → ±800, z 700 → 850.
- Question JD : « tu n'as pas dessiné la planche qui maintient la pince du moteur ? » Elle y était (`moteur_tableau`, CP 40 × 110, x 1 814–1 854, z 480–590, collée entre les parois du puits, pince serrée sur son bord haut, vis devant), mais la coupe du relevage la fondait avec la bride sous l'étiquette « bride » : elle est maintenant dessinée à part et nommée « planche ».
- Sauvegarde avant : `cotes_avant_table.yaml`, `hc16_rando_avant_table.py`.

## Assiette avec le coffre chargé (JD 30/09/2026 : « chargé à bloc, 100 kg ou plus »)
- Hydrostatique des coques du modèle, par sections tous les 50 mm : flottaison du plan Chevalier = 259 L de carène (266 kg), centre de carène x 2 311 ; flottaison 2,46 m², centre x 2 506, I_L 2,80 m⁴ ; 2,5 kg par mm d'enfoncement, 50 kg·m par degré d'assiette.
- Charge ajoutée au CdG du coffre (x ≈ 1 700, 0,8 m devant le centre de flottaison), équilibre exact (volume et centre de carène) :

| Charge | Assiette sur le nez | Eau à l'étrave / au tableau | Eau sous le coffre (x 1 250 / 1 860 / C4) | Bas du puits (z 250) / pointe (z 380) au-dessus de l'eau calme |
|---|---|---|---|---|
| 50 kg | 0,75° | +52 / −14 | +36 / +28 / +25 | ≈ 222 / 344 |
| 100 kg | 1,43° | +100 / −26 | +68 / +53 / +49 | ≈ 197 / 312 |
| 150 kg | 2,05° | +144 / −37 | +99 / +77 / +72 | ≈ 173 / 281 |

- Même 100 kg à x 1 550 : 1,71° ; à x 1 850 : 1,16° ; au centre de flottaison (x 2 500) : 0,1° (+38 partout). Pour 100 kg dans le coffre, deux équipiers de 75 kg au bout des bancs (x ≈ 3,1 m) compensent (89 kg·m contre 81). Ranger le lourd sous les bancs, le léger dans le coffre. En marche, l'hélice s'enfonce de ≈ 50 : sans effet gênant.
- Page : menu « coffre vide / chargé 100 kg / 150 kg » qui incline le plan d'eau de la maquette ; flottaison du coffre chargé à 100 kg en pointillé dans la coupe du relevage. Script : `etudes/hydro_assiette.py`.

## Joues arrondies, voiles réglables, livardes rangées (JD 30/09/2026)
- JD : « arrondir un peu les joues pour que la tangente au niveau du collier soit continue et horizontale ». Avant de la joue : superellipse d'exposant 2,3 (2 = ellipse), de la pointe (x 1 390, tangente verticale) au collier (x 1 805, z 1 122, tangente horizontale, sans cassure de courbure) ; dessus plat du collier à C4 (x 2 022,5) ; dossier en quart de superellipse (2,2) de C4 au bout du banc (x 3 212). Le bordé du coffre suit le même arrondi à la station des joues ; le loft reste à pentes égales, les panneaux restent développables. Rayon de cintrage mini ≈ 330 (épaule de l'arrondi aux joues, pointe au milieu). Volume 755 L.
- Le hauban croisé AV touchait presque la joue arrondie (4,6) : œil sur un plot 45 au-dessus du collier (au lieu de 35) et exposant 2,3 : 15 au-dessus de la joue. Paramètres `joues_forme: {n_avant, n_arriere, plat_jusqu_a_c4}`, `haubans.croise_dz`.
- Page : panneau « Voiles et écoute » sous la maquette : enroulement de chaque voile (0–100 % de la surface), choqué, amures, point d'écoute sur la poutre AR (rail, y réglable) ou sur le flotteur AR (pontet sur l'axe, x réglable), bouton « Sur la tire » ; tableau surface, écoute, tire idéale et écart (dans le plan de la voile ; hors du plan, l'écoute borde la voile ou ne la retient plus) ; voilure et couple de chavirage. La voile se roule autour du guindant, le yin-yang suit la toile. Voiles, livardes et écoutes générées dans la page à partir des cotes.
- Livardes rangées (JD : « plus en avant, verticales, trou + collier ouvert, pour ne pas gêner l'enroulement » ; le soir : « il doit être à l'extérieur contre la joue ») : debout, verticales, contre la face extérieure de la joue, 180 devant l'axe du mât au collier (x 1 625, axe à y ±1 137, 2 de la joue). Deux blocs CP de 60 × 45 collés sur la joue : en bas un godet (2 × CP 10, pli percé Ø 34 sur un pli plein, 15 au-dessus du bas de la joue) où repose le pied ; en haut un collier ouvert vers l'extérieur (2 × CP 10, 60 sous le haut de la joue, z 985 → 1 005), sangle pour le fermer. Livarde Ø 30 de z 540 à 3 380 ; garcette au mât si elle bat. Le hauban direct AV du collier passait contre la joue, juste là : son attache est portée 40 plus à l'extérieur sur l'oreille du collier (`haubans.attache_dy_av`) ; jeux : 23 au hauban, 20 entre le hauban et le collier de livarde, 11 au bordé du coffre, plus de 150 à la voile roulée. Le trou dans le dessus et le fourreau intérieur du matin sont supprimés (`coffre.fourreaux_livarde: null`, `coffre.rangement_livarde`). Sauvegarde avant : `cotes_avant_livarde_joue.yaml`, `hc16_rando_avant_livarde_joue.py`.
- Partage de la page à l'extérieur : Share → « Anyone with the link » (Pro / Max ; sur un compte Team ou Enterprise, un Owner doit d'abord autoriser le partage externe) ; les destinataires ont besoin d'un compte Claude. Sinon, envoyer le fichier HTML autonome.

## Attaches clipsées et brêlage (JD 30/09/2026)
- JD : « les mâchoires s'assemblent seules sans pièces supplémentaires, un peu comme si on clipsait tout ça, et ensuite on lace en dessous, aussi en diagonale, pour les mâchoires de la poutre avant ».
- Cornières de la poutre AV et mâchoires des bancs supprimées : accroches et couples de banc (profil + 2) se posent par-dessus, coffre et bancs descendent d'une pièce. Un crochet sous le nez n'est pas possible : C4 touche le nez (la lèvre serait détachée de l'accroche) et la poutre cintrée interdit d'engager un crochet en tournant le coffre.
- Brêlage : au droit de chaque accroche (y ±131, ±331, ±850), un œil dans C4, 12 sous le nez (trou renforcé par un tasseau collé contre le couple) ; un bout Ø 5 file sous la poutre jusqu'au pied du pilier de martingale et passe sous son bord avant, d'où il ne peut pas remonter le long du pilier. Six brins en éventail de 260, 395 et 860 ; 19 sous la poutre, 10 devant les tiges de martingale, 1,5 du pilier. Tendus, ils plaquent C4 et les accroches sur la poutre et tiennent le coffre en travers ; le trampoline reste libre. Paramètre `accroches_poutre.brelage: {diam, sous_nez}`.
- Bancs : laçage dans le plan de chaque couple : il descend le long de la face extérieure, passe sous le bas de la joue du couple, fait le tour du nez du longeron et file sous la toile ; c'est lui qui tient les bancs.
- Contrôles : recouvrements (voiles pleines et moteur relevé) : seuls les voulus (brins du brêlage réunis au pied du pilier, laçage au contact du bas des couples). Relevage 0 → 674 sans contact ; jeux mini 10 (tête / coque), 10 (nacelle / bride), 15 (tête / tube), 20 (tête / poutre), 34 (hélice / brêlage, C4 entre les deux), 43 (nacelle / bac) ; sortie du bac : 8 au tube. Coupes des deux attaches redessinées sur la page.

## Accroches d'une pièce avec les couples, pose en diagonale, couples de banc renforcés (JD 30/09/2026 après-midi)
- JD : « les accroches BC1…2 et AC ne sont pas assez enveloppantes dessous ; BC sera trop fragile, l'encoche pour le dossier est trop profonde ; AC peut être découpé solidairement des couples du coffre ??? »
- Plus d'accroche rapportée : les couples du coffre dans le plan des accroches (±131 parois du puits et ±331 côtés de caisse prolongés, CP 6 ; ±850 couples CP 9) traversent C4 par une fente et se prolongent jusqu'à x 2 112 (6 avant la fente du trampoline) : chacun est l'accroche, d'une seule pièce, et l'effort de la poutre va droit dans le fond et le dessus.
- Plus enveloppantes : lèvre sous le nez (quart avant-bas, jusqu'à 45° sous l'avant du nez, 64 sous l'axe) ; seul le dessous de la queue reste ouvert, pour le trampoline. Découpe = rectangle moins le profil + 2 balayé pendant la pose (paramètres `accroches_poutre.integre`, `pose: {angle, course}`, `sous_axe`).
- Pose : le coffre descend à la verticale jusqu'à 23 au-dessus de sa place et 23 devant, puis finit en diagonale arrière-bas (33 à 45°) : la lèvre passe sous le nez. En place, il ne ressort qu'en avançant et en montant, ce que les haubans directs AR et le brêlage empêchent.
- Simulation de la pose (`etudes/pose_coffre.py` → `plateforme/pose_coffre.json` ; moteur relevé ; de 150 au-dessus jusqu'en place) contre poutre, longerons, pièces d'angle, trampoline, martingale et semelles : aucun contact, jeu mini 1,2 en fin de course, 2 ailleurs. Elle a montré que les poches des pièces d'angle, fermées par le fond, empêchaient de poser le coffre par-dessus (le fond et C4 sous la poche butaient sur la pièce d'angle, défaut déjà présent avant) : poches ouvertes dessous (`poches_pieces_angle.ouverte_dessous`). Le dégagement des joues au-dessus du nez des pièces d'angle suit aussi la diagonale. Premier couple de banc reculé de 2 136 à 2 160 : pendant la diagonale, il passe au-dessus de la queue de la pièce d'angle (fin à x 2 124).
- Brêlage : d'un trou Ø 8 dans la lèvre (20 devant et 50 sous le centre du nez) au pied du pilier ; brins de 255, 390 et 855 ; plus d'œil dans C4 ni de tasseau.
- Couples de banc : c'était le couple qui était entaillé par la joue, et sa joue extérieure ne tenait plus que par 3 mm. Désormais la joue (dossier) est entaillée par le bas au droit de chaque couple (9 × ≈ 55) et le couple reste entier ; sa joue extérieure monte à 25 au-dessus du fond du banc (cou ≈ 50) et descend à 44 sous l'axe (22 sous le nez). Évidement : marge au longeron 15 → 35, âme 45 → 55 (le passage sous les couples perd 10 de haut). Lame d'épaisseur nulle retirée au bord intérieur, sous la queue du longeron. Paramètres `bancs.entaille_dans_joue`, `couple_ext_haut`, `couple_sous_axe`, `evidement`.
- Un couple de banc ne peut pas passer sous le longeron : il est posé d'en haut et la toile quitte le longeron par sa queue. C'est le laçage qui ferme le dessous : il descend le long de la joue du couple, passe sous son bas et file tout droit d'un bord à l'autre (z ≈ 484–491, `lacage.droit`).
- Contrôles : recouvrements (voiles pleines, moteur relevé) : seuls les voulus ; relevage 0 → 674 sans contact, jeux inchangés (10, 10, 15, 20) ; sortie du bac inchangée (8 au tube). Coupes des attaches redessinées. Sauvegardes : `cotes_avant_clips2.yaml`, `hc16_rando_avant_clips2.py`.

## Plan de découpe (30/09/2026)
- `plans/decoupe3.py`, tout depuis le modèle (`v_pleine_0.yaml`) : `plans/dxf3/planche_*.dxf` (une plaque par fichier ; calques PANNEAU, DECOUPE, REPERES), `plans/dxf3/pieces/*.dxf` (une pièce par fichier, échelle 1, mm), `plans/decoupe3.json` ; page « Découpe coffre HC16 » (`plans/page_decoupe.py` → `plans/decoupe_coffre_hc16.html`), publiée à part.
- Bordé : faces extérieures de `coffre_coque` (point pris sur la face : le centre de gravité d'une face en anneau, la tranche du bordé contre la joue, tombait hors de la face et la faisait passer pour un panneau), regroupées en panneaux à moins de 8° entre facettes voisines sans traverser les stations du loft (±250, ±360), puis dépliées exactement facette par facette : surfaces 3D et dépliées égales à 0,01 % près. D'un seul tenant, l'avant + dessus perdait 3 % (non développable). Panneaux : B1 (côtés, avant cintré + dessus jusqu'à C4, trou du fourreau), B2 (avant du milieu), B3 (dessus près du puits), B4 (bandes entre ±250 et ±360), C4, F1–F5 (fond), P1–P3 (poches des pièces d'angle).
- Épaisseurs (construction) : bordé cintré CP 4 ; fond et C4 CP 6 ; joues CP 9 ; cloisons, puits, couples ±331 CP 6 ; couples ±850, accroches, assises, couples de banc CP 9 ; table CP 10 ; plis collés pour 18 à 40 (semelles 2 × CP 9, cales et planche 4 × CP 10, colliers de fourreau 2 × CP 10, renfort de pont 2 × CP 4). Rayon de cintrage mini ≈ 330 : essai à froid du CP 4 sur une chute.
- Résultat (30/09 soir, couples-accroches et supports de livarde sur les joues) : 37 repères, 81 pièces ; plaques 2 500 × 1 220 : CP 4 : 1,5 ; CP 6 : 2,5 ; CP 9 : 2 ; CP 10 : 1. Les deux demi-plaques ne portent qu'une pièce chacune (un renfort de pont en CP 4, un couple ±331 en CP 6) : à prendre dans des chutes si possible. K850, K331 et PM portent leur accroche (lèvre et trou du brêlage compris), C4 a ses 6 fentes, les joues leurs entailles, les poches sont ouvertes dessous. Trappes de C4 découpées dans la chute de C4 (pas imbriquées à part). Supports de livarde : LG (godet, pli percé), LF (pli du fond), LC (collier ouvert, 2 plis), en CP 10 ; plus de trou dans le dessus (B1). Archive `dxf_decoupe_coffre_hc16_3009_v3.zip` (remplace les précédentes).
- Imbrication : grille de 4 mm et corrélation FFT (règle bas-gauche, 150 ordres de pose), puis contrôle exact des jeux (8 entre pièces) et des marges (10) ; l'ancienne imbrication vectorielle ne finissait pas en 20 min. Contours exacts dans `plans/pieces.pkl` : `plans/imbrique3.py [essais] [graines…]` réimbrique sans reconstruire le modèle (petites pièces admises dans les évidements des cadres).
- Non tracés, à percer au montage : tube des colliers Ø 50 (joues, dessus), tubes carbone Ø 40 (fond), œils du brêlage Ø 8 (C4, avec tasseaux), passages du laçage.

## Coffre recalé sur la plateforme relevée (29/09/2026)
- Principe (JD) : le coffre ne touche le pont que par ses pylônes, en tubes carbone ; ailleurs il s'accroche à la poutre AV et aux longerons par des pièces découpées au demi-profil DWG des poutres (+ 2 mm de jeu), ouvertes vers le bas : posé par-dessus, tenu par les haubans.
- Mâts tout près du bord du pont (JD) : y ±1 151 (bord du mât à 9 du bord du pont, 1 190) ; la paroi de coque reprend l'effort vertical, l'épontille carbone intérieure devient inutile. Coffre 2 240 de large, joues à ±1 120, mâts contre les joues.
- Pied de mât : renfort de pont CP cintré sur toute la largeur (2 × CP 4, y 814 → 1 186, x 1 616 → 1 916), semelle CP 18 de 220 × 166 (y 1 020 → 1 186) sur bourrage 3 → 35 (≈ 470 cm³, cale biseautée côté extérieur), dessus de semelle z 348,1 (+23 sur l'ancien pied : raccourcir le mât de 23 garde la bordure) ; collier centré x 1 805, z 1 097.
- Appuis sur le pont : 4 tubes carbone Ø 40 × 2 (x 1 716 et 1 816, y ±1 066) sur les semelles.
- Poutre AV : 7 accroches CP 9 derrière C4 (x 1 962 → 2 112) à y −850, −500, −150, 150, 495, 745, 850 ; 495 et 745 encadrent le moteur.
- Bancs : couples CP 9 à x 2 136, 2 410, 2 680, 2 950, 3 212 accrochés au nez des longerons ; fond z 585 (au-dessus du trampoline), assise 685, de x 2 130 (derrière le manchon des pièces d'angle) à 3 218 ; joues arrêtées au fond du banc le long du longeron, dégagées au-dessus des pièces d'angle AV.
- C4 à x 1 962 (coffre décalé de −10) : 11 devant le nez des pièces d'angle, à confirmer par D6. Volume 511 L.
- Moteur : axe de bascule de la bride à z 405 ; balayage 0 → 90° sans contact, relevé à 17 sous la tige de martingale ; en marche, bas de pale à −543.
- Haubans du coffre Ø 4 (JD 29/09), même configuration à deux niveaux : au collier (±60 de l'axe du mât) et dans le plan des semelles (pontets ±60 du pied) ; directs vers la patte d'étrave et la cadène du même bord, croisés vers la patte d'étrave opposée (au collier, œil sur un plot 45 au-dessus du collier pour passer 15 au-dessus de la joue arrondie, 30/09). Haubans en travers dans le plan de la poutre AV retirés.
- Tube alu Ø 50 × 2 entre les colliers (z 1 097), d'une joue à l'autre : traverse les joues et le dessus près des joues (manchons) ; 312 au-dessus de la trappe de batterie (< bac 320) → tube démontable, goupillé aux colliers.
- Haubans : pas de croisés AR (29/09). Dans le plan du pont, le croisé semelle bâbord → cadène tribord touche l'arbre du moteur entre ≈ 62 et 73° de relevage (tribord → bâbord libre) ; toute diagonale partant de la semelle bâbord vers l'arrière-intérieur traverse y 620 dans le balayage. Les croisés AV aux deux niveaux + le tube entre colliers tiennent le coffre en travers, les directs AR la poussée vers l'avant. Sécurité AR possible : une seule diagonale semelle tribord → cadène bâbord. Martingale comme point d'ancrage : non (hauban bâbord dans le balayage à 55–62°, et il tire le pied du pilier vers l'avant, sens que rien ne tient). Variantes `semelle.croises_arriere` / `semelle.vers_martingale` dans le script, désactivées.
- Livardes (JD 29/09) : un tube carbone droit par voile, d'un seul côté de la toile, du mât (w 2 060, 5,10 m sous la têtière, mâchoire contre le mât) au point d'écoute voile pleine : 2 841 de long. Ø 30 × 1,5 dans le modèle (à confirmer : flambement ≈ 1,2 kN sur cette longueur à 70 GPa, 1,9 kN en Ø 35 × 1,5). Voile roulée, même en partie : livarde démontée et rangée verticale dans un fourreau du coffre (30/09, voir « Joues arrondies, voiles réglables, livardes rangées ») ; ancienne place (debout devant le mât, à 85, pied dans un godet sur le collier) abandonnée : elle gênait l'enroulement. Paramètres `voile.livarde` (`rangee: auto`, `rangement`) ; ancienne livarde double = `type: wishbone`.
- Laçage des bancs (JD 29/09 ; depuis le 30/09, dans le plan de chaque couple et seul à tenir les bancs, voir « Attaches clipsées et brêlage ») : d'un longeron à l'autre sous la toile, aux couples 2 136, 2 410, 2 950, 3 212 ; la ligne descend le long de la face extérieure du couple, fait le tour du nez du longeron et file sous le trampoline (z ≈ 503–511 tendue), sans traverser la toile. Moteur couché : 79–81 sous la ligne aux couples 2 136 et 2 410 (l'arbre tourne autour de l'axe de bride à z 405, ne monte jamais plus haut), 174 de l'hélice au couple 2 950 ; pas de laçage au couple 2 680 (nacelle et hélice couchées x 2 552 → 2 788, 19 sous la toile). Balayage 0 → 90° refait : sans contact.
- Bancs ouverts dessous (JD 29/09) : plus de caisson ; assise CP 9 (z 676 → 685, y 800 → 1 111, x 2 130 → 3 218) posée sur les 5 couples seuls, dont le bas passe à z 585 au-dessus de la toile ; tout repose sur les longerons. Joues arrêtées à z 585 le long du banc. Paramètre `bancs.caisson: false` (true = ancien caisson de 40 L).
- Fond du coffre en pente vers l'avant (JD 29/09) : plat à z 378 (milieu) / 440 (y 900) derrière x 1 625 (batterie dès x 1 630, puits moteur, pylônes inchangés), puis remonte à 10° jusqu'à la pointe (x 1 390) : +41, soit z 419 au milieu et 506 au droit des joues ; les vagues qui passent sous le coffre sont renvoyées vers le bas. Panneaux de fond plans (cassure à x 1 625) ; bas des joues, joues de chaise et face avant du carter suivent. Volume 509 L. Balayage moteur 0 → 90° refait : sans contact. Paramètre `fond_pente: {deg, x0}`.
- Rangement sous l'assise (JD 29/09) : le long du banc, la joue (dossier) descend jusqu'au longeron (bas de joue au-dessus du longeron sous son épaisseur + 2, jeu mesuré 2,8 ; z ≈ 556 → 548 de l'avant à l'arrière) ; les couples sont entaillés pour la laisser passer (assemblage collé). Entre la toile et l'assise : 110 à 145 de haut, fermé côté extérieur, cases de 270 entre couples, ouvertes côté trampoline. Joue toujours dégagée au-dessus des pièces d'angle AV (6,5). Paramètres `bancs.joue_jusqu_au_longeron`, `jeu_joue_longeron`.
- Couples évidés sous l'assise (JD 29/09) : ouverture de y 820 jusqu'à 15 du longeron, âme de 45 sous l'assise, angles R 25 ; passage de 85 à 100 sous chaque couple : le rangement court sur toute la longueur du banc. Paramètre `bancs.evidement`.
- Étude moteur à l'envers, replié vers l'avant, au milieu (JD 29/09, manuel Protruar 2.0 : arbre 900, 6,7 kg, 10 crans d'inclinaison, poignée télescopique 400 et repliable à 180°, collier de hauteur) : `etudes/moteur_avant.py` → `etude_moteur_avant.png`. Axe de bascule x 1 646, z 560 (la tête relevée s'arrête à 10 de C4 : c'est elle qui fixe l'axe) ; en marche nacelle −290, bas de pale −408, tête au-dessus du coffre (z 660–920) ; relevé à 90° nacelle en travers : dépasse de ≈ 710 devant la pointe du coffre (hélice jusqu'à x 678), au-dessus du croisement des haubans de semelle (z 412, hélice au plus bas 452) et 84 sous celui des haubans de collier (z 772) ; nacelle en long relevée : debout, touche les haubans de semelle. Puits central de 380, ouvert dessous, devant et dessus ; plus de carter ni de moteur sous le trampoline. Coffre agrandi pour loger le moteur relevé : pointe à x ≈ 650 avec un avant plus haut, haubans de semelle croisés dedans : déconseillé. Batterie en long à côté du puits : ne rentre pas (pleine hauteur sur ≈ 400 seulement) ; en travers côté tribord. En attente : choix de JD et hauteur réelle de la tête (260 dans le modèle).
- C4 contre la poutre AV, sans jour, et bancs liés au coffre (JD 29/09) : C4 à x 2 022,5 (au lieu de 1 962), en appui sur le nez de la poutre sur toute la largeur ; coins arrière évidés autour du nez et du manchon des pièces d'angle (poches à 4 de jeu, parois CP 6). Coffre 567 L. Puits moteur prolongé jusqu'à C4 (x 2 016,5), bac et trappe T1 reculés avec C4 (bac x 1 690,5–2 005,5, dos à 11 de C4 ; T1 x 1 681,5–2 010,5 ; compartiment x 1 680,5–2 016,5), fond plat jusqu'à x 1 683 puis rampe (10° : +52, pointe z 430 / 517). Assise des bancs collée à C4 : x 2 022,5 → 3 218 (1 195), 79 au-dessus de la poutre, 96 au-dessus des pièces d'angle ; les accroches à ±850 montent jusqu'à l'assise (couples avant). Sous le nez de la poutre : cornière alu 50 × (32 + 40) × 4 à chaque accroche, boulonnée à travers C4 (2 × M6, doublage intérieur), aile à 2 sous le nez jusqu'à son centre ; 30 mm de la tige de martingale. Balayage moteur 0 → 90° : sans contact (tête à 51 de la coque à 0°). Cornières supprimées le 30/09 (voir « Attaches clipsées et brêlage »).
- Attaches à mâchoire (JD 29/09) : chaque attache entoure toute la section sauf le quart inférieur côté trampoline. La partie fixe reste ouverte vers le bas (coffre et bancs posés d'une pièce par-dessus : la poutre AV est cintrée, on ne peut pas engager un crochet fermé en tournant le coffre) ; une mâchoire CP 9 boulonnée (2 × M6) ferme ensuite le dessous du nez. Poutre AV : accroches descendues à 45 sous l'axe devant le nez, mâchoire côté extérieur de chaque accroche, lèvre 12, jeu 2 (calée sur la face la plus basse, poutre cintrée) ; quart inférieur arrière ouvert pour le trampoline et la tige de martingale (29 mm à y ±850). Longerons : joue extérieure des couples jusqu'à y 1 140 et 36 sous l'axe, mâchoire contre la face arrière de chaque couple ; laçage déplacé devant le couple, descend le long de la joue du couple, passe sous le nez et file sous la toile (z ≈ 513) : il devient une sécurité. Balayage moteur 0 → 90° refait : sans contact ; laçage à 79–81 de l'arbre, 167 de l'hélice. Paramètres `accroches_poutre.machoire`, `bancs.machoire`. Mâchoires supprimées le 30/09 (voir « Attaches clipsées et brêlage »).
- Compartiment batterie juste au bac (JD 29/09) : 3 cloisons CP 6 à 10 du bac (avant x 1 614–1 620, côtés y ±335 → ±341) + C4 + trappe T1 : intérieur 336 × 670 pour le bac 315 × 650 ; sortie verticale du bac libre. Cloison C9.1 (y −500) supprimée : le reste du coffre forme un seul volume autour du compartiment, accès par la trappe tribord de C4. Paramètres `compartiment_batterie: {jeu, ep}`, `cloisons_y: []`.
- Page : maquette agrandissable (plein écran ou pleine fenêtre), zoom jusqu'à 12 cm, déplacement (clic droit, Maj + glisser, deux doigts), double-clic / double tape pour centrer sur un point ; bouton de pente du fond (0–30°) avec coupe dans l'axe ; coupes cotées des deux attaches.
- Carter moteur à reprendre, plus hydrodynamique (JD 29/09, à voir) : c'est le point bas du coffre (fond z 295, 83 sous le fond du coffre), face avant plate à x 1 420 ; la tête couchée arrive à x 1 460, z 345.
- Moteur à arbre plus long (question JD 29/09) : tous les Protruar 1.0 à 5.0 ont 900 mm (35,4") ; arbres longs en 24 V sur des moteurs d'étrave (Haswing Cayman B 24 V 80 lb, 48" ou 54") ou quelques moteurs à barre brushless 40–42". Bride remontée dans le coffre : impossible avec la bascule arrière (erreur corrigée le 29/09) : axe à z ≈ 760, l'arbre traverse C4 dès 18°, touche la tige de martingale vers 35° et la poutre AV vers 50°. L'axe doit rester sous la tige et la poutre, et l'hélice couchée (Ø 236) sous la toile : c'est ce qui le fixe à z 405. À axe inchangé, 355 d'arbre en plus iraient soit sous la bride (hélice à ≈ −780 en marche, couchée jusqu'à x ≈ 3 140 : laçage à 2 950 barré), soit au-dessus (tête couchée devant le coffre, x ≈ 1 100). Conclusion : l'arbre de 900 du Protruar est la bonne longueur ; la hauteur du carter vient de la tête couchée à hauteur d'axe (z 345–485), pas de l'arbre. Relevage vertical : un arbre plus long n'aide pas (tête ≈ 600–700 au-dessus du coffre relevé).
- Fichiers : `hc16_rando_complet.step` (voiles pleines, livardes en service, laçage), page « Plateforme HC16 » (maquette avec coffre, voiles, haubans ; case « Voiles roulées, livardes rangées »). Sauvegardes : `cotes_avant_recalage_coffre.yaml`, `hc16_rando_avant_recalage_coffre.py` ; avant évidement des couples : `cotes_avant_evidement.yaml`, `hc16_rando_avant_evidement.py` ; avant joues jusqu'au longeron : `cotes_avant_joue_longeron.yaml`, `hc16_rando_avant_joue_longeron.py` ; avant C4 contre la poutre : `cotes_avant_c4_poutre.yaml`, `hc16_rando_avant_c4_poutre.py` ; avant mâchoires et compartiment batterie : `cotes_avant_machoires.yaml`, `hc16_rando_avant_machoires.py` ; avant fond en pente et bancs ouverts : `cotes_avant_fond_pente.yaml`, `hc16_rando_avant_fond_pente.py` ; avant livardes droites : `cotes_avant_livarde_tube.yaml`, `hc16_rando_avant_livarde_tube.py`.
- État au 29/09 soir (relevage vertical, hélice rentrée) : fond descendu à z 250 sous le puits (plat ±250 de x 1 860 à C4), remontant à 12° jusqu'à la pointe ; partie centrale plate à z 810 fermée par une table (x 1 384 → 2 118, ±360, découpée pour le moteur) ; pointe du fond à x 1 250 au milieu ; volume 748 L ; bac de batterie sur deux cales ; trampoline en mesh blanc ; 6 accroches symétriques sur la poutre AV, sans cornière ; laçage des bancs aux 5 couples ; haubans des semelles : directs et croisés AV et AR ; tube des colliers à x 1 741, z 1 075 ; trappes de visite de C4 à y ±500 → ±800, z 700–850 ; caisse batterie montée à z 900 avec couvercle et ancre ; accroches à ±131, ±331, ±850 sur couples intérieurs ; couples en long seulement (transversaux essayés puis retirés, JD 30/09), semelles CP 18 sur les tubes carbone ; caisse de la batterie ouverte, jusqu'à z 810, ancre dedans ; yin-yang Ø 360 sur les joues et au point d'écoute des voiles. Au 30/09 matin : joues arrondies (superellipses, tangentes au collier), livardes rangées verticales (le soir : à l'extérieur, contre la joue, godet et collier ouvert), attaches posées par-dessus sans pièce en plus, brêlage en diagonale sous la poutre AV jusqu'au pied du pilier de martingale, laçage des bancs dans le plan des couples ; volume 755 L. Au 30/09 après-midi : accroches d'une pièce avec les couples du coffre (au travers de C4), lèvre sous le nez et pose finie en diagonale, poches des pièces d'angle ouvertes dessous, couples de banc entiers (joue entaillée), laçage droit sous leur joue. Au 30/09 soir : livardes rangées contre la face extérieure des joues, hauban direct AV attaché 40 plus à l'extérieur. Les puces précédentes sur le moteur arrière et le moteur à l'envers sont historiques. Sauvegardes : avant les attaches clipsées `cotes_avant_clips.yaml`, `hc16_rando_avant_clips.py` ; avant les joues arrondies `cotes_avant_joues_rondes.yaml`, `hc16_rando_avant_joues_rondes.py` ; avant la table `cotes_avant_table.yaml`, `hc16_rando_avant_table.py` ; avant la caisse basse `cotes_avant_caisse_basse.yaml`, `hc16_rando_avant_caisse_basse.py` ; avant le fond descendu `cotes_avant_fond_puits.yaml`, `hc16_rando_avant_fond_puits.py` ; avant les couples transversaux `cotes_avant_couples_travers.yaml`, `hc16_rando_avant_couples_travers.py` ; avant l'hélice rentrée `cotes_avant_helice_rentree.yaml`, `hc16_rando_avant_helice_rentree.py` ; avant le relevage vertical `cotes_avant_vertical2.yaml`, `hc16_rando_avant_vertical2.py` ; avant le moteur à l'envers `cotes_avant_moteur_avant2.yaml`, `hc16_rando_avant_moteur_avant2.py`.
- Plan de découpe et imbrication refaits le 30/09 (voir « Plan de découpe »). Reste à refaire : la tente ; forme du collier CP (croquis de JD attendu) ; hauteur réelle de la tête du Protruar (260 dans le modèle).

## Centres véliques, gréement HC16 d'origine, book (05/10/2026)
- Gréement HC16 d'origine redessiné (`cotes.yaml` : `hc16_origine` ; `etudes/greement_hc16.py`) : mât 8,08 m sur le milieu de la poutre AV (rotule z 700), quête 7,5° ; GV 13,77 m² (guindant de w 600 à 7 950, bordure 2 740, chute 7 666, rond parabolique de 730), bôme à z 1 295 ; foc 5,12 m² sur l'étai (pattes d'oie de 1 130 depuis les ferrures d'étrave à x 250, point d'étai x 721 z 675, capelage à w 6 100), point d'écoute x 2 250 z 1 000. Contours approchés, surfaces officielles (manuel Hobie Cat Europe 2015, Wikipedia, Good Old Boat).
- CV par les contours, rond de chute compris (comme pour la Rando) : HC16 x 3 206, z 3 735. Par les seuls triangles de voilure : x 2 964, z 3 418, proche de la référence du 24/09 (3 010 / 3 360), qui était donc un CV de triangles.
- À méthode égale, la Rando voiles pleines a son CV devant celui du HC16 : contours x 3 010 contre ≈ 3 206 (196 devant, 216 plus haut) ; triangles 2 884 contre 3 010 (126 devant). Pour retrouver le CV d'origine, il faudrait reculer le pied de mât de 0,13 à 0,2 m : à décider (JD).
- Voilure réduite, voiles dans l'axe : une voile pleine, l'autre roulée : 11,1 m², CV x 3 010 z 3 951, couple 62 % ; une à 50 % : 5,5 m², CV x 2 601 z 3 563, 28 % ; une à 75 % : 2,8 m², CV x 2 359 z 3 173, 12 %.
- Page 3D : case « HC16 d'origine (gréement Hobie) » (plateforme nue, gréement Hobie), case « Centres véliques » : CV de chaque voile et des deux en bleu, CV du HC16 au même réglage en rouge, aplombs jusqu'à la flottaison, ligne « Centre vélique » dans le panneau Voiles ; couple de chavirage rapporté au HC16 calculé de la même façon. Contre-jour doux ajouté (revers des voiles clair). `window.__cam` pour les vues scriptées.
- Book (deck Slides de 63 pages) : HC16 d'origine, modèle actuel, coffre transparent, voilure réduite (0/50/75 % + 100 %), moteur en marche et relevé, détails, plans de découpe, points ouverts. Captures : `book/captures_3d.py` et `book/captures_page.py` (Playwright, three.js et polices en local) → `book/img/`.
- Plan de découpe : notes corrigées (plus de trous de fourreau de livarde dans le dessus ni de fourreaux en tube carbone).
- Demandé par JD le 05/10 : hauban du collier au milieu de la poutre AV, en diagonale au-dessus du coffre, avec plus de pente au capot (fait, section suivante) ; puis emplantures et collier.

## Haubans des colliers vers le milieu de la poutre AV, capot arrière en pente (JD 05/10/2026)
- Demande JD : un hauban de chaque collier au milieu de la poutre AV, en diagonale, qui passe au-dessus du coffre ; le capot peut prendre plus de pente.
- Tracé : de l'attache arrière du collier (60 derrière l'axe du mât), sur un plot de 100 (œil x 1 865, y ±1 151, z 1 194), jusqu'à une ferrure sur le dessus de la poutre AV au milieu, 15 derrière son axe (x 2 085, y 0, z 677), là où était le pied de mât du HC16 ; Ø 4, 1 285 de long, 24° sous l'horizontale, 11° vers l'arrière en plan ; les deux haubans arrivent sur la même ferrure. Avec le tube entre les colliers, ils tiennent les mâts en travers : le hauban sous le vent travaille quand le mât pousse son collier vers l'extérieur.
- Le hauban descend en travers presque à la pente des pans du dessus (21° contre 22°) : avec un œil à 45 il raclait les pans ; à 100 il passe 28 à 51 au-dessus. Le puits moteur n'aide pas : il s'arrête à C4, et le hauban passe derrière C4 pour |y| < 270, au-dessus de la poutre.
- Ce qui coinçait : le milieu du dessus contre C4 (table et haut de C4 à z 810, le hauban à 795 au droit de C4). D'où le capot arrière : la table s'arrête à x 1 760 (elle ne couvre plus que la caisse) ; derrière, panneau fixe CP 6 en pente (15°) de z 810 à x 1 760 jusqu'à z 740 contre C4, sur ±360, découpé sur ±70 pour la tête et la barre du moteur ; deux joues triangulaires CP 4 à y ±360 jusqu'aux pans ; C4 arasée à 740 au milieu, couples ±331 et parois du puits arasés sous le capot ; plus de porte-à-faux de la table au-dessus de la poutre.
- Jeux, moteur en marche et relevé : pans 28 à 51, capot 36, coin des joues du capot 22, tête du moteur en marche 26 (ferrure reculée de 15 pour cela : 12 sur l'axe de la poutre), accroches des parois du puits derrière C4 17, joue 47, trampoline 48. Contrôle de toutes les paires : aucun recouvrement nouveau.
- Paramètres : `coffre.haubans.collier_poutre: {dz: 100, poutre_dz: 10, x_poutre: 2085}`, `coffre.capot_arriere: {x0: 1760, z_c4: 740, demi_y: 360, ep: 6, decoupe_moteur}`, `coffre.table.x1: 1760`. Étude : `etudes/hauban_collier_poutre.py`. Sauvegardes : `cotes_avant_hauban_poutre.yaml`, `hc16_rando_avant_hauban_poutre.py`.
- À refaire une fois les modifications des emplantures et du collier arrêtées : plan de découpe (nouvelles pièces CR et CJ ; C4, table, K331 et PM modifiés), STEP, balayage du relevage, book.

## Collier indépendant du coffre, emplanture sur rail (JD 06/10/2026)
- Demandes JD : « la pièce de collier de mât doit accueillir le mât bien sûr mais aussi s'emmancher dans le tube pour pouvoir tourner, elle est aussi le point d'accroche des haubans, collier haubans tube mât forme un ensemble indépendant du coffre » ; « l'emplanture est mobile le long d'un petit rail pour régler la quête (un simple U avec des perçages pour un boulon transverse). Le mât tourne sur un ergot reposant sur une pièce solide de profil triangulaire percée qui s'emmanche dans le rail et est boulonnée ».
- Puis (JD 06/10, 9 h) : « le collier doit rester ouvert vers l'arrière pour installer le mât ; le hauban vers l'arrière reste à l'extérieur du mât ; le triangle sous l'emplanture a sa pointe vers le bas pour permettre une rotation, ça tient avec le boulon » ; « le mât ne peut pas être raccourci » ; matériau du collier : POM ou Ertalyte ?
- Lecture retenue : le collier tourne autour de l'axe du tube quand on change de trou à l'emplanture (il suit la quête) ; le mât tourne dans le collier et sur l'ergot ; pour le poser, on le relève depuis l'arrière en pivotant sur le boulon de l'emplanture, il entre dans le collier par l'arrière.
- Emplanture : rail U alu 40 × 30 × 4, 180 de long, sur la semelle (perpendiculaire au mât), 5 trous Ø 8 tous les 20 dans les ailes, axe à 18 au-dessus de la semelle ; cale alu pleine en triangle pointe en bas (70 en haut, 6 à la pointe, 38 de haut, 31,5 de large ; pointe à 7 au-dessus de la semelle, 3 au-dessus de l'âme) : elle pivote sur le boulon Ø 8, qui la tient, jusqu'à ±55° avant de toucher l'âme ; ergot inox Ø 20 × 20 sur le dessus, embout du mât percé.
- Mât non raccourci (JD) : pied à z 393, 45 au-dessus de la semelle ; voile, bordure et CV montent de 45 (68 avec la semelle, par rapport au plan) : CV deux voiles pleines x 3 012, z 3 996 ; couple de chavirage 126 % de celui du HC16 (124 % avant).
- Quête (le mât pivote sur le boulon, le collier reste en place et tourne sur le tube) : 5,8 · 4,4 · 3,0 · 1,6 · 0,2° du trou avant au trou arrière, 1,4° par trou, 3° au milieu. Le direct AR bouge d'environ 3 par trou : retendre après un changement.
- Collier : bloc d'Ertalyte (PET-P) ou de POM, 70 d'épaisseur, 160 × 110 (105 devant l'axe du mât, 55 derrière), tout boulonné ; alésage Ø 62 où le mât tourne directement ; ouvert vers l'arrière sur 62, fermé par un axe inox Ø 10 goupillé à 38 derrière l'axe du mât (3 du mât) à travers les deux branches ; tourillon alu Ø 45 × 80 vers l'intérieur, sur l'axe du tube (68 devant l'axe du mât, x 1 741), gorge + goupille : le tube ne sort pas et tourne ; ferrures inox boulonnées : devant, direct AV (40 vers l'extérieur) et croisé AV (30 vers l'intérieur) ; sur la face extérieure, de 20 à 70 derrière l'axe du mât, le direct AR (à 61 du mât, l'axe de fermeture traverse aussi la ferrure) ; en haut de la face intérieure, la diagonale vers la poutre. Centre x 1 809, z 1 170 (823 le long du mât depuis le dessus de semelle, 778 depuis le pied du mât) ; dessous 10 au-dessus du haut des joues (hauteur calculée par `jeu_joue`).
- Matériau du collier (question JD) : charges de l'ordre de 4 kN du mât et 5,6 kN par hauban au plus fort (20 nœuds apparents, voile pleine). Contraintes dans le bloc : ≈ 5 MPa sous une ferrure tenue par deux vis M8 (10 avec une seule), ≈ 9 MPa sur l'axe de fermeture Ø 10 dans les deux branches de 24 si le mât pousse vers l'arrière, 1 à 2 MPa ailleurs. POM-C : ≈ 65 MPa à la limite élastique en traction, ≈ 19 MPa en compression à 1 % de déformation ; Ertalyte (PET-P) : ≈ 90 et ≈ 26 MPa, plus raide, flue moins, plus stable ; plus cassant (rayons aux angles de l'ouverture, pas de chocs). Les deux tiennent ; Ertalyte préférable pour le fluage sous la prétension des haubans. En noir pour les UV ; pas de colle ; contre-plaques sous les écrous ; ≈ 1,2 kg par collier.
- Mâts à y ±1 161 (1 151 avant) : 11 de jeu à la joue, le mât tourne et ne tient plus au coffre ; bord du mât au bord du pont (1 190). Semelle inchangée (dy −141 → 25). Coffre inchangé (2 240, joues à ±1 120) ; plus de demi-collier boulonné sur la joue.
- Tube alu Ø 50 × 2 d'un collier à l'autre, au-dessus du coffre : axe x 1 741 (la tête du moteur passe toujours 15 derrière), z 1 174, 2 206 de long ; 31 au-dessus du haut des joues : plus de trous ni de manchons dans le coffre. Le bras du moteur relevé reste sur le tube.
- Haubans : sur les ferrures du collier, plus de plot (croisé AV à plus de 60 de la joue) ; direct AV à 40 et croisé AV à 30 des livardes rangées ; pontets du pied à ±100, au bout du rail (60 avant). Diagonale vers la poutre AV : 1 231 de long, 25° sous l'horizontale ; jeux 23 au coin de C4, 28 au capot, 30 aux joues du capot, 22 à la tête du moteur en marche, 20 aux parois du puits.
- Jeux du gréement au coffre : collier 10 (joue), mât 11 (joue) et 20 (bordé, renfort des tubes), tourillon 32, tube 31 (joues) et 33 (barre du moteur). Direct AR à 61 du mât, diagonale à 48. Contrôle de toutes les paires : aucun recouvrement nouveau. Relevage du moteur (pas de 25) : aucun contact, tête à 15 derrière le tube.
- Paramètres : `mats.collier`, `mats.emplanture`, `mats.y_axe: 1161`, `mats.semelle.{y_mat, dy}`, `coffre.haubans.tube_colliers: {diam, ep, x}` (z calculé), `coffre.haubans.semelle.attache_dx: 100`. Fonctions `collier_geom`, `collier_tourillon`, `emplanture`, `quetes_crans` (`hc16_rando.py`). Étude : `etudes/collier_tube.py` → `etudes/collier_tube.json`. Sauvegardes : `cotes_avant_collier_tube.yaml`, `hc16_rando_avant_collier_tube.py`.
- Reste à refaire avec ces pièces : plan de découpe (collier en 7 × CP 10 ; capot arrière du 05/10), STEP, book.

## CV réalignés : mâts reculés de 194, côtés du coffre raccourcis (JD 06/10/2026)
- Demande JD : « vérifier et réaligner les CV ; tu peux diminuer la taille du coffre en longueur, il faut conserver la place pour la batterie et le moteur, c'est la cote incompressible » ; puis « mettre à jour le book ». Choix JD pour le coffre : côtés raccourcis, joue toujours tangente au collier, milieu inchangé.
- Vérification, voiles dans l'axe, même méthode pour les deux gréements : HC16 d'origine (GV 13,77 m² + foc 5,12 m²) : contours, rond de chute compris, x 3 206, z 3 735 ; triangles x 2 964, z 3 418 (la référence du 24/09, 3 010 / 3 360, était un CV de triangles). Rando avec le pied de mât à x 1 766 (mât posé sur la cale) : contours x 3 012, z 3 996 ; triangles x 2 886. Écart : 194 par les contours, 78 par les triangles ; la différence vient du grand rond de la GV du HC16. Retenu : les contours, la vraie surface des deux gréements.
- Mâts reculés de 194 : pied à x 1 960. CV Rando x 3 206, z 3 993, aligné sur le HC16 ; 258 plus haut ; couple de chavirage 125 % du HC16. Quête au cran inchangée : 5,8 · 4,4 · 3,0 · 1,6 · 0,2°.
- Coffre : sommet des joues au droit du collier (x 1 999), pointe des joues reculée de 1 390 à 1 584, même arrondi ; milieu inchangé (courbe avant sur l'ancien pied de mât : batterie, caisse, puits, table, capot) ; raccord linéaire de ±360 aux joues. Volume 754 → 676 L ; environ 1,8 dm³ de CP de bordé et 1 dm³ de joues en moins. Livardes rangées à x 1 819, toujours 180 devant le mât.
- Pont : semelle du mât 250 × 141 (x 1 860 → 2 110, y 1 045 → 1 186, à 10 du pylône de la poutre AV), dessus z 345,4, bourrage 3 → 34 (≈ 525 cm³) ; les tubes carbone du coffre restent à x 1 716 et 1 816, sur leurs semelles CP 18 (190 × 91, dans le plan de l'ancienne semelle, 14 devant celle du mât) ; renfort de pont de x 1 616 à 2 130, découpé autour du pylône de la poutre AV.
- Collier : centre x 2 003, z 1 173 (829 le long du mât depuis la semelle, 784 depuis le pied) ; le tube passe derrière la tête du moteur, au-dessus de la poutre AV : x 2 085, z 1 169, 2 156 de long ; tourillon 82 derrière l'axe du mât, sur la branche intérieure prolongée (collier 180 × 135, face intérieure à 80 de l'axe du mât) ; l'ouverture arrière reste libre, le tube est à l'intérieur.
- Moteur : la tête passe 15 devant le tube ; le bras qui tient le moteur relevé se rabat vers l'avant ; la batterie sort sans gêne (≥ 129 du tube). Balayage du relevage tous les 25 : aucun contact.
- Haubans du pied : pontet AV 14 vers l'extérieur (le croisé AV passait à 5 du tube arrière du coffre, maintenant 14) ; pontet AR à 140 derrière le pied (le croisé AR passait à 2 du pylône de la poutre AV). Jeux : mât 18 à la pièce d'angle, 31 au longeron, 11 à la joue ; collier 11 à la joue ; diagonale (1 181, 26° sous l'horizontale, presque en travers) 21 au puits, 33 à la tête du moteur, 50 au-dessus du bordé ; tube 22 au-dessus des joues ; direct AV à 36 de la livarde rangée. Contrôle de toutes les paires : aucun recouvrement nouveau.
- Paramètres : `mats.x_pied: 1960`, `z_pied: 345.4`, `semelle.dx/dy`, `renfort.dx/evite` ; `coffre.ref_mat: {z_pied}`, `coffre.milieu_x_pied: 1766`, `coffre.avant_x: 1584`, `pylones.x_ref: 1766` et `pylones.semelle` ; `tube_colliers.x: 2085` ; `collier.nez: 60`, `demi_y_int: 80` ; `haubans.semelle.attache_dx_av/ar`, `attache_dy_av`. Sauvegardes : `cotes_avant_recul_mats.yaml`, `hc16_rando_avant_recul_mats.py`.
- Voilure réduite, voiles dans l'axe : une pleine, l'autre roulée : 11,1 m², CV x 3 206 z 3 993, couple 63 % ; une à 50 % : 5,5 m², x 2 797 z 3 605, 28 % ; une à 75 % : 2,8 m², x 2 555 z 3 216, 13 %.
- Volume du coffre (question JD) : intérieur 649 L (725 avant le recul) ; zone centrale entre les couples ±331, inchangée, 216 L (caisse de la batterie 93, puits 42, flancs du puits 64, devant la caisse 17) ; hors zone centrale 432 L (509 avant) : 306 L entre ±331 et ±850, 127 L entre ±850 et les joues, soit 216 L par côté. Volumes d'air, poches des pièces d'angle déduites, bancs non compris (`etudes/vol_zones.py`).
- Contrôles finaux : recouvrements 87, la base (fonderies, pylônes, bouts de haubans, yin-yang), plus de renfort ↔ semelle ; balayage du relevage refait, identique à 0,1 près ; STEP complet exporté. Book mis à jour (65 pages, deux nouvelles : collier sur le tube, emplanture sur rail ; retouches de JD des pages 9 et 28 gardées), page 3D v29, plan de découpe v5.

## Formulaire des cotes manquantes (06/10/2026)
- Demande JD : « prépare un formulaire clair pour les cotes manquantes ». Page « Cotes manquantes HC16 » (https://claude.ai/artifact/5wKurd3juf33NEJfvPDqQu), générée par `releves/page_cotes.py` : 45 cotes en 5 sections, chacune avec son croquis coté (repères jaunes) et la valeur du modèle.
- 1 · Pied de mât et pièce d'angle AV (avant de découper) : M4 bord de la coque → flanc du nez de la pièce d'angle (modèle 71 ; le mât Ø 60 loge là), M5 dépassement du nez devant la poutre (50), M6 bord → pylône (159), M7 Ø du pylône (70), D6 (2 269) ; bâbord et tribord.
- 2 · Pont au pied de mât et poutre AV (avant de découper) : M1 largeur bord à bord (385), T1–T5 jours sous une règle de niveau à 10, 30, 60, 100, 150 du bord (24, 16, 10, 4, 1), M2–M3 liston, V9 (261), L1 pente en long (+0,6° / longerons), Q, R (gîte de la plateforme).
- 3 · Haubans : H1–H3 patte d'étrave (50 de la pointe, 12 de haut, Ø), H4–H7 cadène (620 de l'axe du pylône, 12 du bord, 8 de haut, Ø). 4 · Moteur Protruar : seulement E1, largeur de la tête (estimée 120 ; elle passe dans l'échancrure de C4, 140), et E2, ouverture maxi de la bride (planche PL 40) ; les cotes de profil viennent du schéma du manuel p. 13 (remarque JD : déjà connues), affichées en gris sur le croquis. 5 · Barre et safrans : S1–S7.
- Saisie enregistrée dans le db de la page : collection `releves` (un document par repère, `-bd` / `-td` pour bâbord / tribord, `{v, at}`), `remarques` (une par section), `photos` (ids d'assets) ; « Copier le texte » en secours. Lecture : ArtifactData `list` sur `releves`.

## Collier et emplanture en CP collé stratifié, haubanage à nu, fiche technique (JD 06/10/2026 soir)
- Demande JD : « dessiner le système d'emplanture et de collier en CP collé stratifié et le mettre dans les panneaux à découper ; ajouter au book le projet sans le coffre et le trampoline pour voir le haubanage des pieds de mât ; donner les specs (volume, poids du coffre…), le poids maxi en charge, équipage et bagages ; estimer la différence entre le HC16 et cette version deux mâts, coffre et moteur ».
- Collier : 7 plis de CP 10 collés à l'époxy (70), contour inchangé 180 × 135, verre-époxy sur toutes les faces, arêtes arrondies. Alésage Ø 66 dans le bois, chemise PEHD de 2 (Ø 62, le mât tourne dedans) qui borde aussi l'ouverture ; le PEHD ne se colle pas : chemise fendue, emboîtée par l'ouverture, tenue par deux vis inox noyées à ses bouts (variante : 2 d'époxy graphite coulée sur le mât ciré). Tourillon : tube alu Ø 45 de 115, 35 collés dans une encoche des plis 2 à 6 (34 de large aux plis 2 et 6, 45 aux plis 3 à 5) et goupillé, 80 dans le tube. Axe de fermeture Ø 10 percé après collage à travers les 7 plis. Ferrures inox boulonnées à travers les plis, sur contre-plaques. ≈ 0,6 kg par collier (CP 0,41, stratification 0,15, chemise 0,03), ≈ 0,9 kg avec tourillon, axe et ferrures (bloc d'Ertalyte : 1,2 kg).
- Emplanture : le rail U alu devient deux joues de CP 10 × 40 × 180 collées sur la semelle avec congés et stratifiées, 31 entre elles (cale 30 + 2 × 0,5), percées Ø 8 tous les 20 (5 crans, axe à 18 au-dessus de la semelle : quêtes inchangées 5,8 · 4,4 · 3,0 · 1,6 · 0,2°). Cale en 3 plis de CP 10 (30), même triangle pointe en bas (70 en haut, 38 de haut, pointe à 7 au-dessus de la semelle), ergot inox Ø 20 dessus. ≈ 0,2 kg par emplanture.
- Boulon de l'emplanture : au plus fort (voile pleine, 20 nœuds apparents) le collier reprend ≈ 4 kN et le pied ≈ 3 kN, tout entier par le boulon Ø 8 (la pointe de la cale ne porte pas) : ≈ 20 MPa de matage sur 2 × 10 de CP nu, trop pour le bois. Trous surpercés Ø 16, remplis d'époxy chargée et repercés Ø 8 (≈ 10 MPa sur le bois), dans les joues et dans la cale.
- Plan de découpe : CO1 (plis 1 et 7, ×4), CO2 (plis 2 et 6, encoche 34, ×4), CO3 (plis 3 à 5, encoche 45, ×6), 176 × 135 ; JE joues 180 × 40 (×4) ; CE plis de cale 70 × 30 (×6) ; tous en CP 10, sur la plaque 10-A (45 pièces, 31 % utilisés). SM semelle 250 × 142 (2 × CP 9). Total : 45 repères, 112 pièces, 7 plaques (CP 4 : 1,5 ; CP 6 : 2,5 ; CP 9 : 2 ; CP 10 : 1). Notes et fournitures mises à jour (tourillons, chemises et vis, axes, ferrures, ergots, boulons Ø 8 × 70).
- Modèle : `mats.collier.{materiau: cp, plis: 7, chemise: 2}`, `tourillon.prise: 35` ; `mats.emplanture.rail.type: joues_cp` (`joue_ep`, `h`, `jeu`), `cale.plis: 3` ; pièces `collier_pli1…7_*`, `collier_chemise_*`, `emplanture_joue_int/ext_*`. Semelle 250 × 142 (y 1 045 → 1 187), bourrage 3 → 35 (≈ 535 cm³). Contrôles : recouvrements 89 = les 87 de base + l'axe de fermeture dans le pli 4 de chaque collier (voulu, percé après collage) ; jeux (`collier_tube.py`) : plis du collier 11 à la joue du coffre, chemise 16, tourillon 25, tube 40, mât 18 à la pièce d'angle. Sauvegardes : `cotes_avant_collier_cp.yaml`, `hc16_rando_avant_collier_cp.py`.
- Book (71 pages, v11) : « Haubans des mâts, pieds de mât à nu » (sans coffre ni trampoline : 3/4 avant et dessus) et le détail d'un pied ; collier, emplanture, semelle, nomenclature (4 pages) et fabrication refaits en CP ; section 08 « Fiche technique » (intercalaire, comparaison avec le HC16, poids et assiette). Page 3D v31, plan de découpe v7, STEP complet refait.
- Fiche technique (`etudes/fiche_technique.py` → `etudes/fiche_technique.json`), poids estimés : HC16 145 kg prêt à naviguer (Hobie), dont un gréement d'origine estimé à 34 kg (mât 18, bôme 3, voiles 9, câbles 2, écoutes 2) : plateforme nue ≈ 111 kg.

| | HC16 d'origine | HC16 Rando |
|---|---|---|
| Gréement | ≈ 34 kg | ≈ 34 kg : mâts carbone 2 × 6,5 (estimé), voiles 2 × 3,5, livardes 1,2, colliers 1,8, emplantures 0,4, semelles, renforts et bourrage 3,6, tube 1,8, haubans 2,8, écoutes 2 |
| Coffre et bancs | — | ≈ 40 kg : CP 33 kg sur 9,2 m² ; époxy, verre et peinture 5,5 (0,6 kg/m²) ; tubes, cordages, quincaillerie 1,7 |
| Moteur et batterie | — | 30,5 kg : Protruar 6,7 ; Dyness 19,3 ; bac 3 ; câbles 1,5 |
| À vide, prêt à naviguer | 145 kg | ≈ 215 kg (+ 70), ancre 3,5 en plus |
| Rangement | — | coffre 649 L intérieur (676 extérieur) : 432 L hors zone centrale (216 par côté), 216 L au centre ; 47 L sous chaque banc |
| Voilure, CV, couple de chavirage | 18,9 m², x 3 206 z 3 735, 100 % | 22,2 m², x 3 206 z 3 993, 125 % |
| Charge utile au déplacement maxi CE (385 kg) | 240 kg | ≈ 170 kg : 2 équipiers de 80 + 10 kg de bagages |
| Charge utile au déplacement maxi US (507 kg) | 362 kg | ≈ 292 kg : 2 × 80 + 130 kg |

- Charge maxi : la plaque du HC16 (240 kg en CE catégorie C, 362 kg aux États-Unis) vaut pour son déplacement ; en gardant ce déplacement maxi, la Rando perd ce que pèsent coffre, moteur et batterie. Ce n'est pas une limite de flottabilité : 2,52 kg par mm d'enfoncement, 100 kg de plus enfoncent de 4 cm.
- Assiette, refaite après les remarques de JD (06/10 soir : « on navigue assis près de la poutre avant » ; 07/10 : « le Hobie a plutôt tendance à s'enfoncer derrière en navigation, tu es sûr de tes calculs d'assiette ? »). Calcul statique, au repos : référence = HC16 avec 2 équipiers près de la poutre AV (x 2 300), supposé à plat ; CdG des gréements calculés poste par poste (HC16 x 2 869 : mât à 7,5° de quête, bôme, voiles ; Rando x 2 404) au lieu d'un décalage fixe sur le pied de mât (2 370 et 2 210), d'où un CdG du HC16 nu à x 2 382.
- Écart Rando − HC16 à équipage égal : 1,1° de plus sur le nez coffre vide (étrave + 75 mm, tableau − 23) ; 1,4° avec 30 kg au coffre ; 1,8° avec 60 kg (étrave + 125) ; 0,7° avec 60 kg sous l'arrière des bancs (x 2 920). Point bas du coffre (puits, z 250) à 196 au-dessus de l'eau calme coffre vide, 168 avec 60 kg. Bilan des moments (kg·m, sur le nez) : batterie, bac et câbles 22,7 ; coffre et bancs 21,6 ; gréement 15,8 (12,4 en enlevant celui du HC16, 3,4 pour celui de la Rando) ; moteur 4,0 ; total 64,1 ≈ 1,1° (58,8 kg·m par degré vers 375 kg).
- Ce que le calcul ne voit pas : il est statique. En route, la vitesse enfonce l'arrière (vague d'étrave, creux sous l'arrière ; le plus fort vers Fn 0,5–0,6, 6 à 8 nœuds pour ces coques de ≈ 4,7 m à la flottaison) et la poussée de la voile, appliquée haut, appuie sur le nez (CV de la Rando 258 plus haut : + 7 % de couple à poussée égale). Ces effets valent pour les deux bateaux ; l'écart statique s'y ajoute. Le HC16 s'assied sur l'arrière en navigation (JD), d'où l'équipage près de la poutre AV : la Rando le fera d'environ 1° de moins, à son avantage par petit et moyen temps ; au portant dans la brise (enfournement), réduire tôt et reculer, comme sur le HC16.
- Conclusion : la batterie reste au centre du coffre (la reculer ramènerait l'assiette du HC16 et son arrière qui s'enfonce) ; l'équipage règle l'assiette comme sur le HC16 : même assiette que lui en s'asseyant 0,43 m plus en arrière coffre vide, 0,76 m avec 60 kg au coffre ; le lourd sous les bancs plutôt qu'au coffre. À vérifier aux essais : repères de flottaison à l'étrave et au tableau.

## Batterie sur le banc, coffre raccourci, coffre à ancre (JD 07/10/2026)
- Demande JD : « supprimer le coffre de batterie, garder un petit coffre pour l'ancre, diminuer la longueur du coffre vers l'avant ; faire deux petits caissons sur les bancs contre la poutre avant pour accueillir une batterie 50 Ah ». Réponses de JD : une seule batterie 24 V 50 Ah ; avant au ras des joues.
- Coffre : avant droit à x 1 584 sur toute la largeur (le bec central jusqu'à 1 250 disparaît) ; au milieu, l'avant monte en quart d'ellipse jusqu'au dessus plat (z 810, x 1 805). Plus de caisse ni de bac de batterie, plus de table. Volume 481 L à l'extérieur, 457 L à l'intérieur (676 et 649 avant) : 162 L de chaque côté hors du milieu, coffre à ancre 20 L, puits 42 L et ses flancs 64 L, coins 6 L.
- Coffre à ancre : deux cloisons CP 6 à ±250, de l'avant à la cloison du puits (x 1 711), élargie à ±256 pour le fermer. Couvercle (CV) : le bordé central (±250, station du loft : une seule pièce développable, 0,19 m²) au-dessus de z 450, de l'avant au capot arrière (x 1 590 → 1 776), rogné au plan du capot et échancré au-dessus du puits ; ses bords portent sur des tasseaux le long des cloisons. Grappin plié couché en travers sur le fond, contre la cloison du puits (x 1 606 → 1 706, z 302 → 402).
- Caissons sur l'avant des bancs, contre C4 : C4 fait l'avant, la joue l'extérieur, l'assise le fond ; côté intérieur (BB) et face arrière (BR) en CP 6 collés sur l'assise, couvercle amovible (BV) ; x 2 022,5 → 2 308,5, y ±920 → ±1 111, z 685 → 916 ; intérieur 280 × 185 × 225 (11,7 L). Batterie LiFePO4 24 V 50 Ah (type Sterling LH2450 : 260 × 165 × 210, 11 kg, 80 A en continu, 1,3 kWh, la moitié de l'ancienne) à bâbord, sanglée sur l'assise, câbles 25 mm² par un presse-étoupe dans C4 (≈ 1,3 m jusqu'au moteur) ; caisson tribord pour le rangement. Sortie de la batterie : couvercle ôté, elle monte de 230 (5 au-dessus des parois, 19 sous le tube des colliers), puis glisse vers l'intérieur ; à + 250 elle toucherait le collier et le tube.
- Contrôles : recouvrements 89, la base, aucun nouveau ; relevage du moteur : aucun contact, mêmes jeux (hélice et nacelle à 38–46 du brêlage et du grappin, moteur relevé) ; jeux du gréement inchangés, le mât passe à 30 du couvercle du caisson, la joue entre les deux.
- Plan de découpe : 44 repères, 107 pièces, 7 plaques dont 2 demi-plaques (CP 4 : 1,5 ; CP 6 : 2 ; CP 9 : 2 ; CP 10 : 0,5). Nouvelles pièces AN, BB, BR, BV, CV ; disparues CA, CB, TA, CL, B4. L'imbrication essaie maintenant aussi la demi-plaque quand une épaisseur tient sur une seule plaque (CP 10).
- Fiche technique : à vide ≈ 200 kg (215 avant ; coffre et bancs 33,7 kg, moteur et batterie 19,2 kg) ; charge utile au déplacement maxi CE du HC16 ≈ 185 kg (2 × 80 + 25 kg), chiffre US ≈ 307 kg. Assiette au repos, équipage égal près de la poutre AV : 0,7° de plus sur le nez que le HC16 coffre vide (étrave + 49), 1,4° avec 60 kg au coffre, 0,3° avec 60 kg sous l'arrière des bancs (1,1 ; 1,8 ; 0,7° avant) ; même assiette que le HC16 avec l'équipage 0,26 m plus en arrière, 0,58 m avec 60 kg au coffre. Bilan (kg·m, sur le nez) : gréement 15,8 ; coffre et bancs 13,8 ; batterie et câbles 4,3 ; moteur 4,0 ; total 37,9 ≈ 0,6°.
- Book (71 pages) : nouvelle page « Batterie sur le banc, coffre à ancre », vues du coffre refaites, nomenclature (AN, BB, BR, BV, CV), demi-plaques 4-B et 10-A, fiche technique. Page 3D v32, plan de découpe v8, STEP refait. Paramètres : `coffre.avant_x_milieu: 1584`, `batterie: null`, `batterie_banc`, `compartiment_batterie: null`, `table: null`, `coffre_ancre`, `trappe` (x 1 560 → 1 800, ±250, z 450, couvercle). Sauvegardes : `cotes_avant_batterie_bancs.yaml`, `hc16_rando_avant_batterie_bancs.py`.

## Accoudoirs, rangements, trappes de C4, glissière du tube, bancs renforcés (JD 08/10/2026)
- Batteries (JD 08/10, après le caisson sur l'avant du banc du 07/10 et un essai au fond du coffre, de chaque côté du puits, le matin) : deux LiFePO4 24 V 50 Ah en parallèle (100 Ah, 2,6 kWh ; 260 × 165 × 210, 11 kg), une dans chaque **accoudoir** au bout des bancs, « la version avec coffre au bout est OK, pas besoin d'allonger le banc ». Accoudoir : caisson CP 6 étanche, x 3 031 → 3 218, toute la profondeur de l'assise (y 800 → 1 111), z 685 → 916 ; batterie en travers, 5 de jeu devant et derrière, 15 dessus ; la joue fait l'extérieur, l'assise le fond ; couvercle sur joint, deux grenouillères ; l'arrondi du dossier finit sur son dessus ; 12 L à l'intérieur. Câbles 25 mm² sous l'assise, presse-étoupe dans C4, ≈ 2,2 m par batterie. Paramètre `coffre.accoudoirs` ; `batterie_banc: null`, `batteries_puits: null`.
- Dessus plat élargi (JD : « agrandir la surface plate de chaque côté du moteur ») : ±360 → ±450 (`dessus_plat_demi`), capot arrière élargi d'autant (±450). **Caissons de rangement** de chaque côté du moteur : de la paroi du puits à un **couple plein** CP 6 déplacé de ±331 à ±420 (« déplacer le couple un peu vers l'extérieur »), de la cloison du puits (prolongée jusqu'aux couples) à C4, fermés par le capot : 42 L chacun. Trappe 205 × 250 découpée dans le capot (x 1 785 → 1 990, y ±150 → ±400), sur un cadre de tasseaux 15 × 15, joint, deux tourniquets. Le couple ±420 est aussi l'accroche de la poutre AV ; brêlage 255, 462 et 854 (±131, ±420, ±850).
- **Trappes de C4** (JD : « la plus grande trappe rectangulaire possible sur la paroi verticale pour les compartiments extérieurs seulement ») : une par compartiment extérieur (de ±420 à la joue, 139 L chacun), 398 × 188 (y ±690 → ±1 088, z 710 → 898) : sous le haut de C4 qui monte vers la joue (25 de bord), 25 au-dessus de l'assise. Le couple ±850 passe derrière, au milieu, et porte le couvercle ; le poteau de la glissière est à 33 derrière C4, devant le bout extérieur : le couvercle se retire en glissant vers l'intérieur. Un essai de grande trappe dans le dessus a été abandonné (`trappes_exterieures: null`).
- **Glissière du tube des colliers** (JD : « il faut que le tube dans lequel les colliers peuvent tourner repose sur le sabot et que le sabot soit suffisamment long ; ce n'est pas le collier qui repose sur le sabot ») : à chaque bout, le tube repose dans un berceau en U (4 × CP 9, de y 990 à 1 078) garni de PEHD 3, où il glisse dans son axe et tourne ; ses joues s'arrêtent 11 sous l'axe (le tube s'enlève par le haut). Berceau collé sur un sabot de 70 × 121 × 60 (6 × CP 10) au ras du haut de la joue, de y 990 à la joue, sous tout le tourillon (1 001 → 1 081). Dessous, poteau caisson de trois parois CP 9 (60 × 121) collé contre la joue, du sabot à l'assise et de l'assise au bas de la joue, sur une cale coulée en époxy chargée posée sur la pièce d'angle AV et le longeron (coulée coffre en place). Le collier ne touche rien : 10 au-dessus du sabot, 3 du berceau (en long) ; tube 0,5 du PEHD (contact), 3,5 des joues du U. Paramètre `coffre.glissiere_collier`.
- Efforts (`etudes/efforts_colliers.py` → `etudes/efforts_colliers.json`) : modèle à deux nœuds (les colliers), haubans en traction seule, tube en compression ; prétension 300 à 500 N ; poussée de la voile limitée par le couple de redressement (une coque décolle, 160 kg d'équipage au rappel) : 642 N par voile, réaction d'étambrai 3,0 kN par collier, dans toutes les directions de −30 à 90°. Effort vertical sur chaque glissière : 0,95 à 1,6 kN au réglage, 5,1 kN au plus, 7,4 kN avec × 1,5. À 7,4 kN : PEHD 2,8 MPa, poteau 2,9 MPa, tourillon alu 38 MPa, pièce d'angle 1,0 MPa. Haubans : jusqu'à 5,3 kN (8,0 kN × 1,5) : **Ø 5** inox 1 × 19 (rupture 19,5 kN, 3,7 fois ; le Ø 4, 12,6 kN, était juste). Tube : 4,6 kN de compression au plus, flambage 12,7 kN. Le collier pique autour du tube (50 à 84 N·m au réglage, 305 au plus) : le mât, dans l'alésage, l'en empêche (≈ 4,4 kN aux bords).
- **Bancs renforcés** (JD : « es-tu sûr que le banc va être assez costaud pour s'asseoir à deux ? »), étude `etudes/banc_resistance.py` (assise en plaque orthotrope, éléments de Morley ; 100 kg par personne, × 2 assis, × 1,5 pour un pied ; CP okoumé 40 MPa le long du fil, 22 en travers). Le point faible était la jambe des couples sous le laçage : le banc ne peut que basculer vers l'intérieur autour de la queue du longeron, le laçage le retient ; pied sur la rive au-dessus d'un couple : 4,5 kN de laçage, 252 MPa dans la jambe, 8,3° de bascule. Renforts : lisse CP 9 × 40 collée sous la rive intérieure de l'assise d'un couple à l'autre ; couples pleins (plus d'évidement) ; jambe descendue à 115 sous l'axe du longeron, jusqu'à y 1 162, doublée de deux joues CP 9 ; laçage Dyneema Ø 5 en double. Résultat (avant → renforcé) : deux assis, assise 2,6 fois sous la rupture (inchangé) ; un pied sur la rive entre couples 1,1 → 2,9 ; âme des couples 23 → 9 MPa ; laçage 4,5 → 2,1 kN ; jambe 252 → 26 MPa ; bascule 8,3 → 0,9°. Dossier : 500 N en haut, solide mais souple (1,4 à 4,7 cm). Paramètres `bancs.evidement: null`, `jambe`, `lisse_rive`, `lacage.matiere`.
- Contrôles : recouvrements 89, la base, aucun nouveau ; pose du coffre : aucun contact, jeu mini 1,2 en fin de course, 1,9 ailleurs (couples ±420 contre la poutre) ; relevage du moteur : aucun contact, jeux inchangés (10 tête / capot en marche, 10 nacelle / bride relevé, 15 tête / tube, 20 tête / poutre) ; gréement : tube 0,5 du PEHD, collier 3 du berceau et 10 au-dessus du sabot, mât 11 de la joue ; hauban collier → poutre AV : 21 au-dessus des parois du puits, 33 de la tête du moteur, 41 du berceau, 55 du capot.
- Volumes : coffre 469 L à l'extérieur, 446 L à l'intérieur ; compartiments extérieurs 139 L par côté ; caissons de rangement 2 × 42 L ; puits 42 L ; coffre à ancre 20 L ; accoudoirs 2 × 12 L.
- Plan de découpe : 56 repères, 173 pièces (plis compris), 5,5 plaques (CP 4 : 1 ; CP 6 : 2 ; CP 9 : 2 ; CP 10 : 0,5) : la demi-plaque de CP 4 disparaît. Nouvelles pièces K420 (remplace K331), TG, AF, AI, AV (remplacent BB, BR, BV), BL1–BL4, BJ, GS, GB, GP1–GP4 ; TR et TG sont pris dans la chute de C4 et du capot. Dépliage : les panneaux plans et coplanaires sont réunis (le fond de chaque côté, de ±250 à la joue, sort d'un seul tenant : F1, au lieu de F1, F5 et F6) ; le biseau de la peau coupée par le plan du capot (16 de large) n'est plus pris pour un panneau.
- Fiche technique : à vide ≈ 215 kg (216 : coffre et bancs 40,2 ; gréement 35,0 dont haubans Ø 5 4,2 ; moteur et batteries 30,2), ancre 3,5 en plus ; charge utile au déplacement maxi CE du HC16 ≈ 170 kg (US ≈ 292). Assiette au repos, équipage égal près de la poutre AV : 0,4° de plus sur le nez que le HC16 coffre vide (étrave + 43, tableau + 10), 1,1° avec 60 kg au coffre, 0,1° avec 60 kg sous l'arrière des bancs (0,7 ; 1,4 ; 0,3° le 07/10) ; garde du coffre 204, 175 avec 60 kg. Bilan (kg·m, sur le nez) : gréement 17,0 ; coffre et bancs 13,1 ; moteur 4,0 ; batteries − 14,5 ; total 19,6 ≈ 0,3°. Rangement : coffre 2 × 139 L, caissons 2 × 42 L, 45 L sous chaque banc.
- Book (74 pages) : nouvelles pages « Le tube des colliers repose sur les joues » (coupes), « Caissons de rangement et trappes de C4 », « Assez costaud pour s'asseoir à deux » (tableau de résistance) ; « Bancs renforcés et laçage » (coupes), « Batteries dans les accoudoirs, coffre à ancre » refaites ; vues du coffre, nomenclature, plaques, fiche technique refaites. Page 3D (v33), plan de découpe (v9) et STEP refaits. Figures : `book/fig_coupes.py` (depuis `etudes/coupes_book.py`). Sauvegardes : `cotes_avant_rangements.yaml`, `hc16_rando_avant_rangements.py`.

## Simplifications du gréement, pont surélevé essayé puis abandonné (JD 08/10/2026 soir – 09/10 matin)
- **Trois haubans par collier** : direct AV vers la patte d'étrave, direct AR vers la cadène, diagonale vers le milieu de la poutre AV ; plus de croisé AV (`haubans.croises_avant: false`). **Plus de haubans de pied** (`haubans.semelle: null`) : la semelle collée sur le renfort passe au pont l'effort du pied (≈ 2,4 kN). Le plus chargé monte à 6,5 kN à la gîte maxi (Ø 5 : 3,0 fois sous la rupture).
- **Semelle unique** par bord pour le mât et les deux tubes du coffre : x 1 656 → 2 050, y 1 020 → 1 187 (394 × 167, CP 18), coin arrière intérieur échancré autour du pylône de la poutre AV (10 de jeu) ; tubes posés dans son plan ; plus de pontets. Bourrage 3 → 39, ≈ 980 cm³ par semelle.
- **Emplanture à 3 crans** (quête 4,4 · 3,0 · 1,6°), joues de 140 (180 et 5 crans avant).
- Glissière du 08/10 soir (`glissiere_collier_avant_0910`) : bloc PEHD vissé à la joue, poteau carbone Ø 40 × 2 à travers l'assise, sur la pièce d'angle ; remplacée le 09/10 par le poteau dans le coffre (ci-dessous).
- **Pont surélevé** en mousse sur les coques (cc8a5ac, 08/10 soir : de l'étrave au plateau z 495, coffre et bancs posés dessus, puits de mât) : abandonné le 09/10 matin (4453534) — il ne porte qu'une fois le bord du pont dans l'eau et ses 32 kg font enfoncer davantage la coque sous le vent à la gîte. À la place : liston en mousse sur le flanc extérieur des coques, à l'étude.

## Coffre en moustache, hiloire, poteau de glissière dans le coffre, trampoline étanche (JD 09/10/2026)
- Gîte au décollage d'une coque (question JD) : HC16 à 305 kg, 9,2° ; Rando à 376 kg, 10,8° (385 kg : 11,0° ; 406 kg : 11,6°). Au décollage, le pont sous le vent au droit du coffre est à 130 au-dessus de l'eau à l'axe de la coque, 60 au bord extérieur (376 kg).
- Étrave étanche formée par le fond du coffre : dessinée, puis abandonnée (JD : « ça ne sert pas à grand-chose »).
- **Moustache** (JD : « angle de 10° à peu près, même angle au-dessus et en dessous ») : vu de face, le dessus va de 810 (plat sur ±450) à 926,6 contre la joue (avant : jusqu'au collier, ≈ 25°) ; le fond, plat sur ±150 à z 270 (250 sur ±250 avant), remonte à 10° jusqu'à 439,4 contre la joue (465, 14° avant). Variante B (fond relevé à 25° au-dessus des coques, 12 L de moins) écartée : A retenue (« 3 A »). Garde au-dessus du pont à l'axe des coques (x 1 900) : 105 (123 avant). Fond remonté de 20 : l'aileron relevé (274) est au ras, l'hélice 26 au-dessus. Paramètres `fond_plat_demi`, `fond_z_cotes`, `dessus_pente_cotes_deg`.
- **Fond vers l'avant** (JD : « garder voire augmenter l'angle du fond vers l'avant, c'est lui qui protège des vagues ») : 25° depuis x 1 860 (12° avant ; 20° coûtait 5 L, 25° 10 L) : pointe à z ≈ 400 au milieu, ≈ 565 contre les joues. Le bas du coffre protège aussi le trampoline des vagues qui passent dessous ; en cas d'enfournement, le coffre porte.
- **Hiloire** (JD : « petit hiloire en haut de la partie bombée », puis « moins haut et 45° vers l'avant ») : CP 9, 30 de haut, penchée à 45° vers l'avant ; droite devant le capot et les trappes (x 1 755, ±460), puis en V jusqu'aux joues (x 1 950, devant le poteau de la glissière). Paramètre `coffre.hiloire`.
- **Trampoline étanche** en toile PVC (mesh avant). Eau entre les poutres et le dessous du banc (JD : « s'assurer que l'eau ne peut pas entrer ») : joint néoprène 10 × 10 sur le longeron, sous la joue, de x 2 130 au bout du banc ; tape CP 6 contre la joue au-dessus de la pièce d'angle AV, de C4 à x 2 130, au profil de la pièce d'angle et du longeron (1 de jeu), jusque sous l'assise. Les deux se posent une fois le coffre en place (la fin de pose en diagonale les heurterait). Paramètre `bancs.etancheite`.
- Yin-yang retiré des joues (JD), gardé sur les voiles (`yinyang.joues: null`).
- **Poteau de la glissière dans le coffre** (JD : « essaie de mettre le poteau du collier dans le coffre », « 4 ok ») : tube carbone Ø 50 × 2,5, axe x 1 988,5 (3 devant C4), y ±1 045, de z 589,5 (toit de la poche de la pièce d'angle, cale coulée dessous) à 1 113,8 (524 de long) ; il sort par le dessus du coffre (z 915) dans une bague CP 18 collée dessous ; potence 4 × CP 10 (40 de haut) de x 1 953,5 à 2 120, au-dessus de C4, douille de 20 ; bloc PEHD sous le bout du tube (berceau creusé, 0,5 de jeu, joues 11 sous l'axe) ; porte-à-faux 96,5. Efforts par collier : 0,6 à 1,0 kN au réglage, 4,8 kN à la gîte maxi, 7,2 kN avec × 1,5 ; à 7,2 kN : poteau ≈ 165 MPa en flexion (693 N·m), 2,1 kN à la bague et au pied, PEHD 2,7 MPa, potence 22 MPa, tourillon 37 MPa. Collier à 3 du bloc et de la potence. `glissiere_collier.type: poteau_coffre`.
- **Dossier** (JD : « est-ce que 24 cm de dossier est confortable ? », puis « 2 oui ») : 400 au-dessus de l'assise (z 1 085), indépendant du dessus du coffre ; courbe de la joue continue de la pointe au dossier (JD : « sans remonter le coffre, pas de décrochage ») : `dossier: {h: 400, courbe_continue: true}`. Collier 47 au-dessus de la joue.
- **Capot arrière horizontal** à 810 (question JD : « le dessus des compartiments adjacents au moteur est-il bien horizontal ? ») : il descendait à 740 contre C4 ; les haubans collier → poutre AV passent à 38 au-dessus ; plus de joues triangulaires ; trappes des caissons de rangement à plat. Trappes de C4 : 320 × 117 (y ±690 → ±1 010, z 710 → 827) sous le dessus abaissé, le poteau à 10 du bout.
- **CP 4 + verre** (JD : « ok pour CP 4 + verre ») : tout le bordé (dessus, fond, C4, poches), le capot et les trappes ; verre compté à 0,35 kg/m² dans la fiche technique.
- Contrôles : recouvrements 66, la base, en marche et relevé ; pose du coffre : aucun contact, jeu mini 1,2 en fin de course, 2,0 ailleurs ; relevage du moteur : aucun contact (10 tête / coffre en marche, 15 tête / tube en montant, 10 hélice / puits et 10 nacelle / bride relevé) ; gréement : tube 0,5 du PEHD, collier 3 du bloc et de la potence, mât 11 de la joue et 31 de l'hiloire ; hauban collier → poutre AV : 21 au-dessus des parois du puits, 24 de la potence, 33 de la tête du moteur, 38 du coffre.
- Volumes : coffre 400 L à l'extérieur (469 avant), 378 L à l'intérieur ; compartiments extérieurs 112 L par côté (139) ; caissons de rangement 2 × 41 L ; puits 40 L ; coffre à ancre 17 L ; accoudoirs 2 × 12 L.
- Plan de découpe : 52 repères, 150 pièces (plis compris), 5,5 plaques (CP 4 : 2 ; CP 6 : 1 ; CP 9 : 2 ; CP 10 : 0,5). Nouvelles pièces HI1 et HI2 (hiloire : bandes droites, pied biseauté en place ; le milieu de la bande droite restait sur le couvercle du coffre à ancre), GQ (potence), GA (bague), TP (tape) ; plus de GS, GB, GP, CJ, ST ; tout le bordé, le capot (CR) et les trappes en CP 4. Dépliage : plus de borne au bord du plat du fond (±150 : le fond se sépare déjà à l'angle du V ; elle coupait le bordé avant et le couvercle du coffre à ancre en trois) ; faces extérieures sondées à plusieurs profondeurs (avec le fond à 25°, la peau du fond avant fait plus de 7 d'épaisseur normale : le fond du milieu manquait) ; copeaux sans épaisseur laissés sous le capot horizontal écartés.
- Fiche technique : à vide ≈ 210 kg (212,3) ; charge utile au déplacement maxi CE du HC16 ≈ 175 kg. Assiette au repos, équipage égal près de la poutre AV : 0,3° de plus sur le nez que le HC16 coffre vide, 1,0° avec 60 kg au coffre, 0,1° avec 60 kg sous l'arrière des bancs ; garde du coffre (z 270) 226, 197 avec 60 kg.
- Book : nouvelles pages « Coffre en moustache, fond qui ouvre les vagues, hiloire » et « Dessous des bancs fermé à l'eau » ; « Le tube des colliers repose sur deux poteaux, dans le coffre » (coupes), haubans, pied de mât, semelle, emplanture, joue, rangements refaits ; plus de page « Haubans des pieds de mât » ; toutes les vues refaites. Sauvegardes : `cotes_avant_moustache.yaml`, `hc16_rando_avant_moustache.py`.

## Plus de glissière, poche à ancre et puits ouverts, trampoline lacé au milieu, tente igloo (JD 09/10/2026 après-midi)
- **Plus de glissière** (JD : « la glissière est inutile car c'est le collier qui tourne dans le tube ; par contre on peut utiliser les haubans pour avancer ou reculer le tube ») : plus de bloc PEHD (`glissiere_collier.bloc: null`) ; le tube repose **à plat sur la potence** (4 × CP 10, x 1 953,5 → 2 120, y 990 → 1 078, z 1 103,8 → 1 143,8 : remontée de 40, son dessus au bas du tube) et les haubans l'avancent ou le reculent. Le poteau carbone Ø 50 × 2,5 monte d'autant : z 589,5 → 1 123,8 (534 de long). À 7,2 kN (× 1,5) : poteau 164 MPa en flexion (96,5 de porte-à-faux ; 130 à 198 si le tube avance ou recule de 20 ; en Ø 50 × 4 : ≈ 112), potence 22 MPa. Collier : tourillon à 2,5 de la potence (au travers de la paroi du tube), plis à 3 ; hauban collier → poutre AV à 15 de la potence.
- **Coffre à ancre ouvert, comme une poche** (JD : « le bac à ancre n'est pas fermé, c'est comme une poche avec évacuation en dessous », puis « face du coffre à ancre remonte plus haut ») : plus de couvercle (`trappe.ouverte: true`, `x1: 1711`) ; la face avant remonte jusqu'à z 650 (`z_seuil`, 450 d'abord : une simple lèvre de 50) ; ouverture en pente ≈ 150 × 500 (x 1 625 → 1 711, z 650 → 775, ±250) ; deux trous Ø 25 dans le fond, au point bas, contre la cloison du puits (x 1 698, y ±120 : `trappe.evacuation`). 17 L.
- **Puits du moteur sans face arrière** (JD : « face arrière du puits à supprimer pour ne pas embarquer d'eau (vagues qui frappent) ») : C4 ouverte sur la largeur intérieure du puits (±128), du dessous du fond jusqu'au capot (`vertical2.puits.arriere_ouvert: true`) : l'eau des vagues qui frappent sous le coffre ressort derrière, vers la poutre AV et le trampoline, au lieu de monter dans le puits. C4 en deux moitiés (C4 × 2 au plan de découpe), collées aux parois du puits ; le capot garde sa découpe ±70 pour la tête. Relevage refait : aucun contact ; en marche 10 tête / capot, 20 tête / poutre ; relevé 10 hélice / puits, 10 nacelle / bride ; tête à 15 du tube en montant.
- **Trampoline lacé au milieu** (JD : « le trampoline est lacé au milieu dans la longueur et derrière ça se vide tout seul ») : deux moitiés, 20 de jour, laçage Dyneema Ø 4 tous les 150 (`plateforme.trampoline_milieu`) ; l'eau s'en va par l'arrière : le point ouvert « évacuation du trampoline » est réglé.
- **Trappes en jaune** (JD) : celles des caissons de rangement, dans le capot ; les couvercles des accoudoirs restent blancs.
- **Ouvertures de C4 à la place des trappes** (JD 17 h 30 : « pas de trappes sur les caissons extérieurs, une ouverture polygonale aussi grande que possible au-dessus du niveau des sièges ») : une par compartiment extérieur, sans couvercle (`trappes_c4: null`, `ouvertures_c4`) : de y ±448 (25 du couple plein ±420) à ±1 015 (5 du poteau d'appui), de z 710 (25 au-dessus des assises) à 25 sous le haut de C4, qui monte à 10° vers la joue : 567 de large, 75 à 175 de haut, coins R 30, 0,07 m² (0,037 pour la trappe de 320 × 117) ; le couple ±850, évidé, passe derrière.
- **Tente igloo** (JD : « ajouter une tente igloo 2 arceaux diagonaux », puis « tente inclut le coffre, ou derrière l'hiloire ») : `plans/tente.py` refait ; toile simple paroi sur deux arceaux alu Ø 11 de 4,03 m croisés au sommet, pieds aux quatre coins (52°). Elle couvre le dessus du coffre derrière l'hiloire, le tube des colliers, les bancs et le trampoline : de x 1 770 au milieu (1 902 aux coins) à la poutre AR, 2 375 × 2 224, sommet z 1 884, 1 304 au-dessus du trampoline. Bord avant posé sur le dessus du coffre 15 derrière le pied de l'hiloire (z 813 au milieu), en V jusqu'aux coins sur les joues, juste devant les colliers (z 1 077) : la poche à ancre et la pointe restent dehors ; bords latéraux sur dossiers et accoudoirs puis longerons ; bord arrière sur la poutre AR, porte dans le pan arrière ; jupes derrière les bancs. La toile est soulevée à 25 au moins au-dessus du coffre, du tube et du moteur (petite bosse sur la barre relevée : la rabattre) ; les colliers traversent les flancs juste au-dessus des joues (manchons). Toile 8,8 m², jupes 0,5 m². Page 3D : bouton « Tente » (toile opaque). Première version (16 h 40) : bord avant lacé sur le tube des colliers, porte dessous jusqu'au trampoline (2 020 × 2 224, 7,7 m²).
- Contrôles : recouvrements 66, la base, en marche et relevé ; pose du coffre : aucun contact, jeu mini 1,2 en fin de course, 2,0 ailleurs ; hauban collier → poutre AV : 21 au-dessus des parois du puits, 15 de la potence, 33 de la tête du moteur, 38 du coffre.
- Plan de découpe : 49 repères, 147 pièces (plis compris), 5,5 plaques (CP 4 : 2 ; CP 6 : 1 ; CP 9 : 2 ; CP 10 : 0,5) ; plus de couvercle CV ; C4 en deux moitiés ; bordé central (B2) plus grand avec la face avant de la poche ; hiloire d'un tenant devant le capot (plus de coupe à ±250).
- Fiche technique : à vide ≈ 210 kg (211,3) ; charge utile au déplacement maxi CE du HC16 ≈ 175 kg. Assiette au repos, équipage égal près de la poutre AV : 0,3° de plus sur le nez que le HC16 coffre vide, 1,0° avec 60 kg au coffre, 0,1° avec 60 kg sous l'arrière des bancs ; garde du coffre (z 270) 227, 197 avec 60 kg.
- Book : trois pages « Coffre par en dessous » (3/4 avant, 3/4 arrière sans le trampoline, de face), « Poche à ancre ouverte, puits ouvert derrière », « Tente igloo sur deux arceaux en diagonale », « Caissons de rangement, ouvertures de C4 » (figure refaite) ; « Le tube des colliers posé à plat sur deux poteaux » (coupes refaites), « Dessous des bancs fermé à l'eau », coffre de près, fabrication, points ouverts mis à jour ; toutes les vues refaites (trappes jaunes). Page 3D : bouton « Tente », vue « Dessous ». Sauvegardes : `cotes_avant_tente.yaml`, `hc16_rando_avant_tente.py` (16 h 40), `cotes_avant_puits_ouvert.yaml`, `hc16_rando_avant_puits_ouvert.py` (17 h) ; les trappes de C4 restent en commentaire dans `cotes.yaml`, la tente de 16 h 40 dans `plans/tente_avant_hiloire.py`.

## Équipage assis face à face, point d'écoute automatique (JD 12/10/2026)
- **Équipage** (JD : « visualisation de deux personnes assises face à face, 1,80 m et 1,60 m (H/F) ») : page 3D, case « Équipage assis » (cochée par défaut) ; un homme de 1,80 m et une femme de 1,60 m, un sur chaque banc, face à face, à la même hauteur (x 2 450 par défaut, réglable de 2 290 à 2 780) ; « Changer de bord » les échange. Mannequins en ellipsoïdes et cylindres, proportions moyennes en fractions de la taille (Drillis et Contini : cuisse 0,245 H, jambe 0,246 H, bras 0,186 H, avant-bras 0,146 H, hauteur assise 0,52 H ; écart des épaules 0,21 H pour H, 0,194 H pour F, hanches plus larges chez F). Assis au fond de l'assise (z 685), dos contre la joue (y ±1 111), pieds à plat sur le trampoline (bombé : z 640 à l'axe, 614 à ±470, 540 aux longerons), mains sur les cuisses ; l'assise n'est qu'à 61 au-dessus du trampoline sous les pieds (125 au bord du banc) : genoux relevés, pointes de pied à 0,2 m l'une de l'autre.
- **Gardes** calculées en direct par la page (`etudes/equipage_ecoutes.py` → `etudes/equipage_ecoutes.json`) : tête (ellipsoïde) / toile des deux voiles ; bras / tube des colliers. Sommet des têtes à z 1 621 (H) et 1 517 (F) ; la bordure passe à z ≈ 1 560 au-dessus des bancs (x 2 450). Voiles dans l'axe, la toile est à côté des têtes : 108 (H) et 142 (F). Choquée, la voile au vent passe au-dessus du banc au vent : F y tient sous la bordure (45 à 67 à 15–25°) ; **H a la bordure sur la tête** : −1 à 15°, −52 à 25° à x 2 450 ; de +8 à −24 le long du banc à 15° (x 2 400 → 2 780) ; à 25°, dégagé à partir de x 2 700. Sous le vent : 196 au moins. Bras : contact avec le tube des colliers devant x 2 370 (H) et 2 320 (F), 81 et 127 de jeu à x 2 450.
- **Point d'écoute automatique** (JD : « on avait déjà étudié les points d'écoute optimaux, entre l'angle des poutres et le flotteur arrière, en fonction de l'enroulement : il faut un switch automatique quand on enroule les voiles ») : page 3D, case « automatique » (par défaut) ; chaque voile a son point. Voile pleine, livarde posée : rail de la poutre AR (y 900). Roulée, même en partie : point qui suit au mieux la tire idéale en bordant la voile, cherché tous les 5 mm sur un pontet du flotteur (x 4 300 → 5 000) si la tire tombe sur le flotteur ou derrière, sinon sur la poutre AR (y 150 → 1 000, angle des poutres) ; à écart égal, le plus près du plan de la voile. Choqué 15°, voile sous le vent : 10 à 55 % → bout du flotteur (x 5 000 ; écart 37° à 10 %, 24° à 25 %, 4° à 50 %) ; 60 % → x 4 890 ; 70 % → 4 595 ; 75 % → 4 425 ; 78 % → poutre AR à l'angle (y 1 000) ; 80 % → y 950 ; 85 % → y 205 ; 90 % → y 150 (6°). Plus choquée, la bascule vient plus tôt (25° : vers 75 % ; 40° : vers 60 %). Même résultat que l'étude du 25/09 (tire à ≈ 5,45 m pour 75 % de surface, ≈ 4,78 pour 50 %, sur la poutre pour 25 %). À la main (case décochée) : un même point pour les deux voiles, comme avant.
- Page 3D : coupe du relevage sans toile dans l'axe (erreur d'affichage depuis le laçage du trampoline au milieu, 09/10).
- Book (81 pages) : nouvelle page « Deux équipiers assis face à face » (de l'arrière, bâbord amures : la voile au vent sur la tête de H ; de face, tribord amures : F sous la bordure) ; « Point d'écoute automatique : il suit l'enroulement » refaite (tableau) ; vues des voiles à 50 et 75 % refaites (écoute sur le flotteur) et une phrase sur l'écoute dans ces pages.

## Tente : arceaux sur le tube des colliers et la poutre AR, avancée sous le tube (JD 12/10/2026)
- Demande JD : « une tente avec arceaux reposant sur les poutres arrière et le tube avant au niveau du collier (dimension de ce rectangle ?) avec une avancée qui permettrait de couvrir l'avant sous le tube » ; arceaux : igloo, deux arceaux croisés ; avancée : « sur le tube au niveau du collier ». `plans/tente.py` refait (v3).
- **Rectangle d'appui** des quatre pieds : **2 060 × 2 100** (2 080 derrière) ; devant, sur le dessus du tube des colliers, à ses bouts, contre les joues (x 2 085, y ±1 050, z 1 194) ; derrière, sur la poutre AR, à ses bouts, contre les pièces d'angle (x 4 145, y ±1 040, z 555) : l'avant est 639 plus haut. Paramètres `tente.pieds_av`, `tente.pieds_ar`.
- **Arceaux** alu Ø 11 croisés, chacun d'un pied avant au pied arrière de l'autre bord, en élastique articulée aux pieds (forme d'une tige souple) : 3 755 de long, 40° au pied avant, 65° au pied arrière ; croisement à x 3 120, z 1 885. Sommet de la toile à z 1 881 (x 3 076), 1 301 au-dessus du trampoline.
- **Toile** : membrane tendue (surface harmonique) accrochée sous les arceaux et à ses bords, soulevée à 25 au moins au-dessus du coffre, du tube et du moteur. Bords latéraux sur le haut des dossiers et des accoudoirs, puis le long des longerons ; bord arrière sur la poutre AR, porte dans le pan arrière ; jupes derrière les bancs ; les colliers traversent les flancs (manchons). Toile 8,48 m², jupes 0,46 m².
- **Avancée** (`tente.avancee`) : `hiloire`, par défaut : devant le tube, la toile redescend jusqu'au dessus du coffre, 15 derrière le pied de l'hiloire (x 1 770, z 813 au milieu, 315 devant le tube ; aux coins, sur les joues devant les colliers, x 1 902, z 1 077) ; elle couvre le capot, la tête du moteur et les haubans collier → poutre AV ; la poche à ancre et la pointe restent dehors. `c4` : rideau du tube au haut de C4 (x 2 020, z 833 ; toile 8,22 m²) : les haubans collier → poutre AV le traversent et la tête du moteur reste dehors. À choisir (JD).
- **Hauteur sous la toile** : assis sur les bancs, dos à la joue, il manque 0,40 (H) et 0,31 (F) au-dessus de la tête (x 2 450 ; 0,43 et 0,34 à x 2 700) : la tête est à 15 cm à l'intérieur du bord de la toile, posé sur le haut du dossier (z 1 085), et 54 cm plus haut ; monter le sommet n'y change rien, il faudrait des parois presque verticales. Assis au milieu du trampoline : 0,08 (x 2 600) à 0,30 (x 3 100) au-dessus de la tête de H, 0,19 à 0,41 pour F.
- Page 3D : bouton « Tente » ; book : page « Tente igloo : arceaux croisés du tube des colliers à la poutre AR » (vues refaites). Version du 09/10 (arceaux aux coins du bord avant) : `plans/tente_avant_tube.py`, `plans/tente_info_avant_tube.json`, `plans/tente_3d_avant_tube.json` ; variante `c4` : `plans/tente_info_c4.json`, `plans/tente_3d_c4.json` (`python3 plans/tente.py c4`).

## CP 6 partout ? (JD 12/10/2026, étude)
- Demande JD : « tout faire en CP 6 mm ? ». Poids : CP 4 → 6 (bordé, fond, C4, poches, capot, trappes : 3,2 m²) +3,2 kg ; CP 9 → 6 (joues, assises, couples de banc, ±850, hiloire : 3,2 m²) −4,8 kg ; plis collés à même épaisseur (colliers 12 × 6 = 72, potences et planche du moteur 7 × 6 = 42, semelles 3 × 6 = 18, joues d'emplanture 2 × 6) +0,1 kg : −1,6 kg sur 35,6 (coffre et bancs), avant renforts. 9,3 m² à débiter, ≈ 4 plaques au lieu de 5,5 en quatre épaisseurs.
- Ne passe pas tel quel : **bordé cintré de l'avant** (rayons de 150 à 500 mesurés sur la maquette, ≈ 100 vers le dessus au milieu ; CP 6 à 5 plis : 0,5 m au mieux à froid, 0,8 en travers du fil ; CP 4 : 0,25 à 0,4, déjà juste : cintrer humide ou chaud là où ça serre ; tableau FAA AC 43.13-1B) et **renfort de pont** cintré en place : rester en CP 4. **Assises** (`etudes/banc_resistance.py` relancé en CP 6) : coefficient 2,5–2,9 → 1,1–1,3, flèche 2 → 7, jambes des couples 39 MPa (40) ; couples doublés : flèche 0,5 mais 1,1–1,2 sous un pied au bord → CP 9, ou CP 6 avec un doublant de 150 le long de la rive et couples doublés (même poids). **Dossiers** : coefficient 2,5 → 1,1, flèche en tête × 3,4 (5 à 16 cm sous 500 N) → raidisseur en tête de dossier.
- Proposé : CP 6 pour tout le plat et les plis collés, CP 4 pour le bordé cintré et le renfort de pont, CP 9 (ou CP 6 doublé) pour les assises. Plan de découpe non refait : en attente de JD.
- Fichiers : `etudes/cp6_poids.py` → `etudes/cp6_poids.json` (poids, surface, rayons du bordé) ; `etudes/banc_cp6.json`, `etudes/banc_cp6_couples_doubles.json` (`BANC_EP=6 [BANC_COUPLES_DOUBLES=1] BANC_OUT=… python3 etudes/banc_resistance.py`).

## Tente igloo du commerce ? (JD 12/10/2026, étude)
- Demande JD : « pour les arceaux c'est bien ; pour la toile, il faudrait trouver une tente du commerce dont la dimension correspondrait à des arceaux un peu plus longs devant, on pourra recouvrir le coffre et les joues », puis « tente igloo du commerce en 200 × 250 à peu près ».
- Calcul (`etudes/tente_commerce.py`) : dôme du commerce à deux arceaux croisés monté normalement (arceaux en élastique, toile en membrane), incliné sur ses quatre pieds ; pieds AR sur la poutre AR comme aujourd'hui, pieds AV posés sur le bateau à la distance L (arceaux rallongés devant). **250 × 200 × 130** : pieds AV à x 1 655, y ±1 000, z ≈ 805, sur l'arrondi avant du coffre, 7 cm derrière la pointe et 43 cm devant le tube ; arceaux de 4,35 m (4,51 pour 140 de haut ; 3,76 aujourd'hui) ; 5,4° ; sommet à 1,40 m au-dessus du trampoline (1,50 pour 140 de haut ; 1,30 avec la toile sur mesure) ; le coffre est couvert jusqu'à la poche à ancre. **240 × 210 × 130** : pieds AV à x 1 765, y ±1 050, z ≈ 885, sur le dessus du coffre contre les joues, 32 cm devant le tube ; arceaux 4,34 m ; 7,5° ; sommet 1,43 m ; couvert à partir de l'hiloire. **260 × 210 (Quechua MH100 4 places)** : trop long, les pieds AV tombent sur les coques devant le coffre et la toile retombe de partout (+ 8 % de toile).
- Sous la toile : coffre, capot, tête du moteur (barre rabattue), tube, haubans collier → poutre AV, bancs, trampoline ; dehors : mâts, colliers, livardes rangées, haubans AV et AR. **Les joues restent dehors** : bords latéraux 6 (210) à 11 cm (200) à l'intérieur des joues, 8 à 16 cm au-dessus de l'avant des assises, au niveau de l'assise au bout ; pour couvrir les joues, il faudrait au moins 2,3 m de large, et le mât (11 mm de la joue), la livarde rangée (2 mm) et le collier traverseraient la toile.
- À adapter : de chaque côté, juste derrière le pied AV (x 1 950 à 2 130), une fente à rabat velcro (bout du tube, potence, tourillon du collier, pied du hauban collier → poutre AV traversent la toile de 35 à 43 cm) ; bosse d'environ 25 cm sur les accoudoirs ; fond cousu à découper ; bord avant à brider sur l'hiloire. Sur les bancs, on tient encore moins assis qu'avec la toile sur mesure (la paroi part de l'intérieur du dossier).
- Modèles trouvés : High Peak Monodome XL 240 × 210 × 130 (simple paroi, polyester 190T PU 1 500 mm, UV 60, arceaux fibre Ø 7,9 dans des fourreaux courts, fond PE cousu, 2,6 kg, ≈ 65–70 €) ; Aktive 210 × 240 × 130 (polyester 170T, arceaux fibre au velcro, double toit, ≈ 45 €) ; entrée de gamme : garder leur toile, arceaux alu de 4,35 m. Recherche d'un modèle plus robuste (≥ 3 000 mm, alu) à ce format à finir.
- Fichiers : `etudes/tente_commerce/` (chiffres `*.json`, maillages `*_3d.json`, vues `*.jpg` par `etudes/tente_vues.py`) ; page 3D d'une variante : `TENTE_JSON=etudes/tente_commerce/igloo_250x200_3d.json PAGE_OUT=… python3 plateforme/page.py`.

## Points ouverts / mesures à prendre
- Équipage (12/10) : au vent, la tête de H (1,80 m) touche la bordure de la voile au vent dès 15° de choqué (−1 à −52) ; F (1,60 m) passe dessous (45 à 67). Baisser la tête quand on choque, ou relever la bordure d'environ 100 mm (point d'amure), à décider (JD) ; s'asseoir à x 2 400 au moins (tube des colliers devant les épaules).
- Tente (12/10) : toile du commerce (igloo ≈ 250 × 200 ou 240 × 210 sur arceaux alu de 4,35 m, voir « Tente igloo du commerce ? ») ou toile sur mesure (avancée jusqu'à l'hiloire ou rideau du tube au haut de C4) : à choisir (JD) ; on ne tient pas assis droit sur les bancs sous la toile, seulement au milieu du trampoline.
- Épaisseurs (12/10) : CP 6 pour tout le plat et les plis collés, CP 4 pour le bordé cintré, CP 9 ou CP 6 doublé pour les assises ? (voir « CP 6 partout ? ») ; plan de découpe à refaire après le choix.
- À valider (JD) : tente sur arceaux croisés du tube des colliers à la poutre AR (12/10) ; équipage assis et point d'écoute automatique (12/10) ; tube posé à plat sur les potences et déplacé par les haubans, poche à ancre ouverte (face avant à z 650), puits ouvert derrière, ouvertures de C4 sans trappe, trampoline lacé au milieu, trappes jaunes, tente igloo derrière l'hiloire (09/10 après-midi) ; coffre en moustache, hiloire, poteaux d'appui dans le coffre, dessous des bancs fermé, dossier à 400, CP 4 + verre (09/10) ; trois haubans par mât, semelle unique, emplanture à 3 crans (08/10 soir) ; accoudoirs, caissons de rangement et trappes de C4, bancs renforcés (08/10) ; collier et emplanture en CP collé stratifié (06/10 soir) : chemise PEHD vissée ou époxy graphite, trous du boulon d'emplanture bouchés à l'époxy.
- Poteau d'appui du tube dans le coffre : 164 MPa en flexion à 7,2 kN (× 1,5), 130 à 198 si les haubans avancent ou reculent le tube de 20 : à vérifier sur la fiche du tube carbone retenu (roulé ou pultrudé), ou Ø 50 × 4 (≈ 112) ; potence CP 22 MPa (CP okoumé ≈ 40 à la rupture) : plis à fil croisé ou renfort carbone dessus si besoin.
- Poche à ancre : hauteur de la face avant (z 650) et taille de l'ouverture (≈ 150 × 500) à confirmer avec le grappin et le mouillage réels.
- Liston en mousse sur le flanc extérieur des coques (après l'abandon du pont surélevé) : options à étudier.
- Appui du tube : course du tube sur la potence (axe de x 1 979 à 2 095 au plus) et réglage par les haubans, à l'essai ; cale coulée sous le poteau, sur le toit de la poche de la pièce d'angle, une fois le coffre posé et brêlé.
- Tente : patron (toile, avancée, jupes, porte arrière, manchons des colliers, fourreaux des arceaux) à refaire sur la tente du 12/10 avec `plans/patron.py`.
- Compartiments extérieurs ouverts dans C4 : l'eau qui y entre (embruns, pluie) reste au fond ; un trou d'évacuation au point bas, comme la poche à ancre ? (à décider par JD).
- Assiette en route : relever aux essais les hauteurs d'eau à l'étrave et au tableau (repères), au repos et en navigation, pour recaler le CdG du HC16 nu et l'écart calculé (0,3° statique avec les batteries dans les accoudoirs, 09/10).
- Batteries : deux 24 V 50 Ah en parallèle (2,6 kWh), une dans chaque accoudoir (paramètre `accoudoirs.cotes`) ; câbles de même longueur vers le moteur.
- Poids : mâts carbone, voiles et gréement du HC16 estimés ; peser le HC16 nu et les mâts pour recaler la fiche technique.
- Cotes à relever : formulaire « Cotes manquantes HC16 » (45 cotes ; sections 1 et 2 avant de découper la semelle et le renfort de pont : nez de la pièce d'angle, pylône, bombé du pont, D6, V9).
- Système de barre : section 5 du formulaire (recul et hauteur de la barre d'accouplement, bras, débattement, axe des safrans).
- Choix restant : hauteur de coupe du coffre, longueur du plateau devant les mâts, hauteur exacte du collier (700–800 mm).
- Développés des panneaux en DXF, imbriqués sur 2 500 × 1 220 : faits le 30/09 (`plans/decoupe3.py`).

## Fichiers
- `hc16_plateforme.step` : plateforme HC16 seule, recalée sur les relevés du 28/09/2026 (D5 et V5 inclus ; sauvegardes `cotes_avant_D5.yaml`, `hc16_rando_avant_D5.py`) ; `plateforme/plateforme_hc16.html` : page correspondante.
- `hc16_rando_complet.step` : bateau complet au 09/10 (coffre en moustache, hiloire, poche à ancre ouverte, puits ouvert derrière, grandes ouvertures dans C4, tube posé à plat sur deux poteaux dans le coffre, trampoline étanche lacé au milieu, joint et tapes sous les bancs ; trois haubans par mât, semelle unique, emplanture à 3 crans ; batteries dans les accoudoirs, caissons de rangement et trappes de C4, bancs renforcés ; moteur en marche ; voiles pleines ; peint, trappes jaunes ; sans la tente), exporté par `export_step.py`. `etudes/balayage_levee.py` : balayage de la levée et sortie du bac → `plateforme/balayage_levee.json` ; `etudes/recouvrements.py` : contrôle statique de toutes les paires de pièces ; `etudes/balayage_moteur.py` : ancien balayage de la bascule vers l'avant.
- `hc16_rando_moteur_en_marche.step`, `hc16_rando_moteur_releve.step` : anciens assemblages complets (moteur arrière, en marche / basculé à 90°).
- `cotes_bac_590.yaml` : variante bac 590 × 260 × 330 (plats ±200, moteur à +500).
- `hc16_rando_hayon_batterie_tribord.py`, `cotes_hayon_batterie_tribord.yaml` : variante batterie à tribord avec hayon d'angle.
- `hc16_rando_avant_bascule_arriere.py`, `cotes_transversal_dessus_polygonal.yaml`, `plans/*_transversal.*` : version moteur transversal.
- `hc16_rando_avant_dessus_polygonal.py`, `cotes_avant_dessus_polygonal.yaml` : version à dessus plat (960).
- `regen_v.py` : génère v_pleine_0.yaml / v_releve.yaml depuis cotes.yaml.
- `etudes/equipage_ecoutes.py` → `etudes/equipage_ecoutes.json` (12/10) : gardes de l'équipage et points d'écoute automatiques, calculés par la page 3D (après `plateforme/page.py`) ; `book/slides_1210.py` : pages du book correspondantes.
- `plans/tente.py [hiloire|c4]` (12/10) : tente sur arceaux croisés du tube des colliers à la poutre AR (élastiques, membrane au-dessus du bateau) → `plans/tente_3d.json`, `plans/tente_info.json` (à lancer après `export3d.py`, avant `plateforme/page.py`).
- `plans/decoupe3.py` (plan de découpe du 30/09 : dépliage, imbrication, DXF), `plans/imbrication.py` (imbrication par grille + FFT, contrôle exact), `plans/page_decoupe.py` → `plans/decoupe_coffre_hc16.html`, `plans/dxf3/` (plaques et pièces), `plans/decoupe3_extra.json` (notes et fournitures). `plateforme/attaches.py` : coupes des attaches (accroche posée + brêlage, couple de banc + laçage).
- `plans/` : tente.py (toile et arceaux), construire2.py (plans, data2.json), vue_globale.py (maillage du bateau complet, global.json), page.py (assemble gabarit2.html → coffre_hc16_plans.html), dxf2/.
- `hc16_rando_coffre_joues_voiles_pleines.step`, `hc16_rando_coffre_joues_voiles_50.step` : assemblage complet.
- `hc16_rando.py` + `cotes.yaml` : modèle paramétrique (CadQuery 2.8).
- `etudes/greement_hc16.py` : gréement HC16 d'origine approché et ses CV ; `book/` : scripts de capture et images du book.
- `etudes/collier_tube.py` : jeux du gréement indépendant (collier, tube, emplanture, haubans) contre le reste, moteur en marche, relevé, voiles roulées. `etudes/vol_zones.py` : volume intérieur du coffre par zones.
- `releves/page_cotes.py` → `releves/cotes_manquantes_hc16.html` : formulaire des cotes manquantes (06/10).
- `etudes/fiche_technique.py` → `etudes/fiche_technique.json` : poids estimés, charge utile, assiette, comparaison avec le HC16 (06/10 soir). `book/fiche_slides.py` : pages de la fiche technique ; `book/maj_book.py` : numéros, sommaire, nomenclature et images du book ; `book/deck/` : sources du deck.
- Études du 08/10 : `etudes/efforts_colliers.py` → `etudes/efforts_colliers.json` (efforts sur les colliers, le tube, les glissières et les haubans) ; `etudes/banc_resistance.py` → `etudes/banc_resistance.json` (assise, couples, laçage, dossier) ; `etudes/infos_texte.py` → `etudes/infos_texte.json` (chiffres du modèle pour les textes) ; `etudes/coupes_book.py` → `etudes/coupes_book.json` (coupes planes) et `book/fig_coupes.py` (figures du book) ; `book/slides_0810.py`, `book/textes_book_0810.py`, `plateforme/maj_textes_0810.py` (textes du book et de la page 3D) ; 09/10 : `book/slides_0910.py`, `book/textes_book_0910.py`, `plateforme/maj_textes_0910.py`, `book/fig_trappe_c4.py` ; 09/10 après-midi : `book/slides_0910b.py`, `book/textes_book_0910b.py`, `plateforme/maj_textes_0910b.py`, `plans/tente.py` (→ `plans/tente_3d.json`, `plans/tente_info.json`, fusionnés dans la page par `plateforme/page.py`).
- `dessins/` : superpositions profil Chevalier, plans de pont, vues 3D de la conversation « Centre vélique sur la voile du HC 16 ».
