jdb666/cao_hc16/book/img/blobs/5de96b645b316623129a3217aa1db5d4.jpg

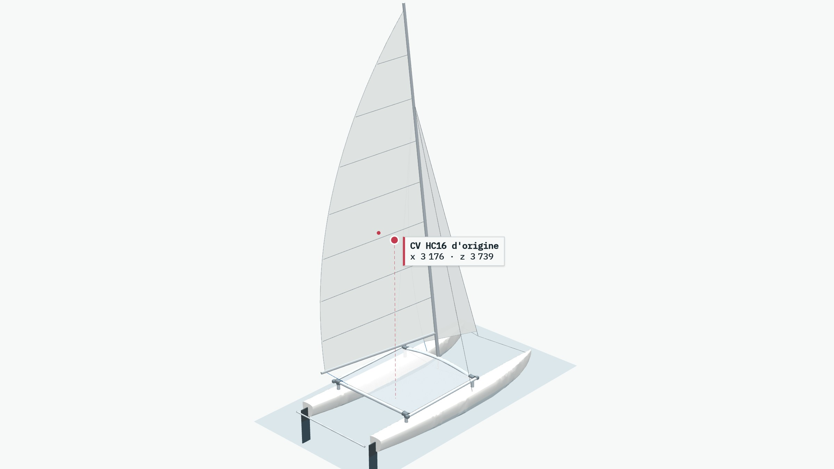
book/img/blobs/5de96b645b316623129a3217aa1db5d4.jpg
