jdb666/cao_hc16/book/img/blobs/6c7d9499422aae9bc247626f5ca647bf.jpg

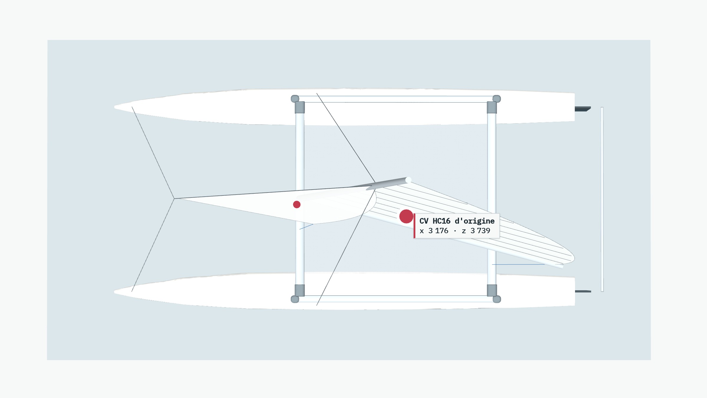
book/img/blobs/6c7d9499422aae9bc247626f5ca647bf.jpg
