jdb666/cao_hc16/book/img/blobs/6c9f9e04f1f5fb8762b66dff07506649.jpg

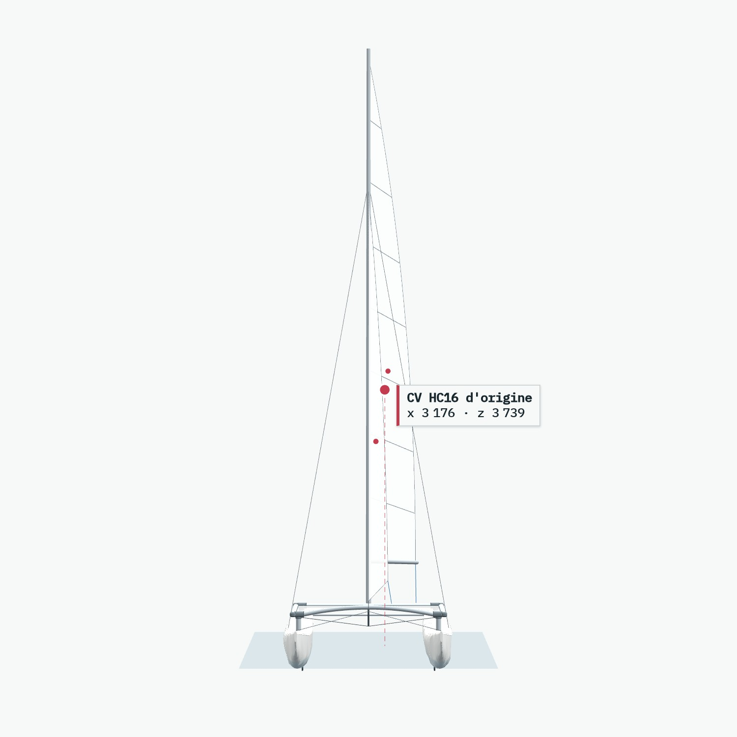
book/img/blobs/6c9f9e04f1f5fb8762b66dff07506649.jpg
