jdb666/cao_hc16/book/img/blobs/9b3d16ed749dcf8eda2864bda4eeb75a.jpg

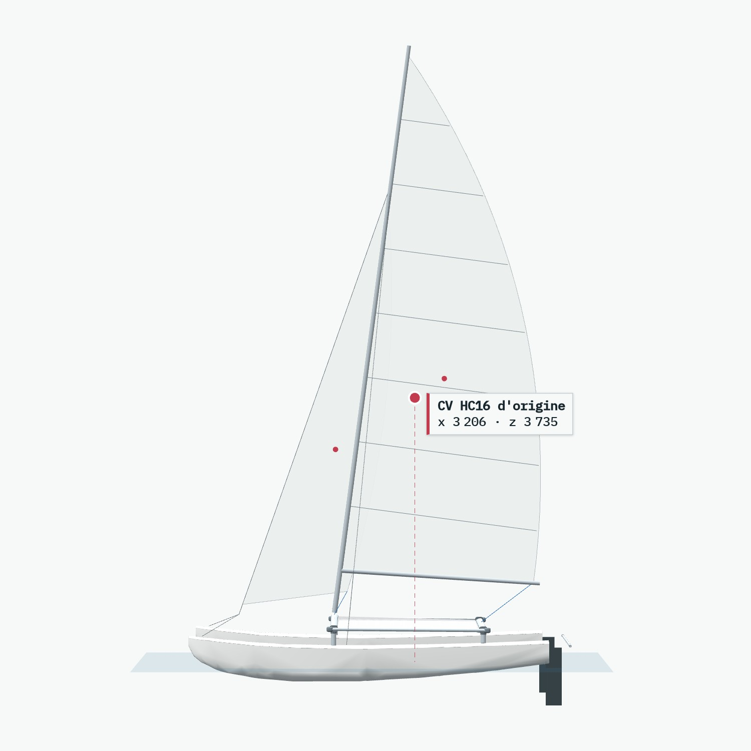
book/img/blobs/9b3d16ed749dcf8eda2864bda4eeb75a.jpg
