jdb666/cao_hc16/book/img/blobs/119724a5bfda7cafe2361aaf8632432a.jpg

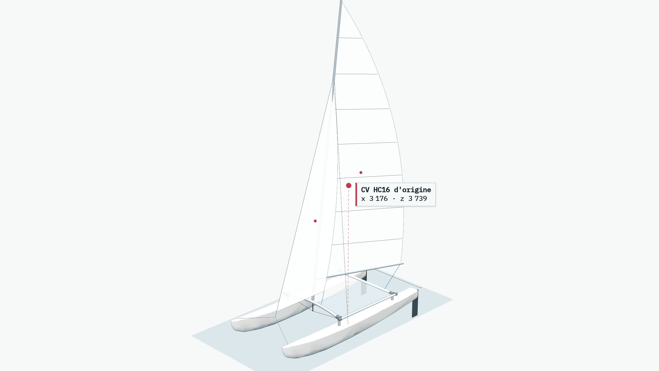
book/img/blobs/119724a5bfda7cafe2361aaf8632432a.jpg
