jdb666/cao_hc16/book/img/blobs/dd07590b8cb2da6c8de052697ad0b4f4.jpg

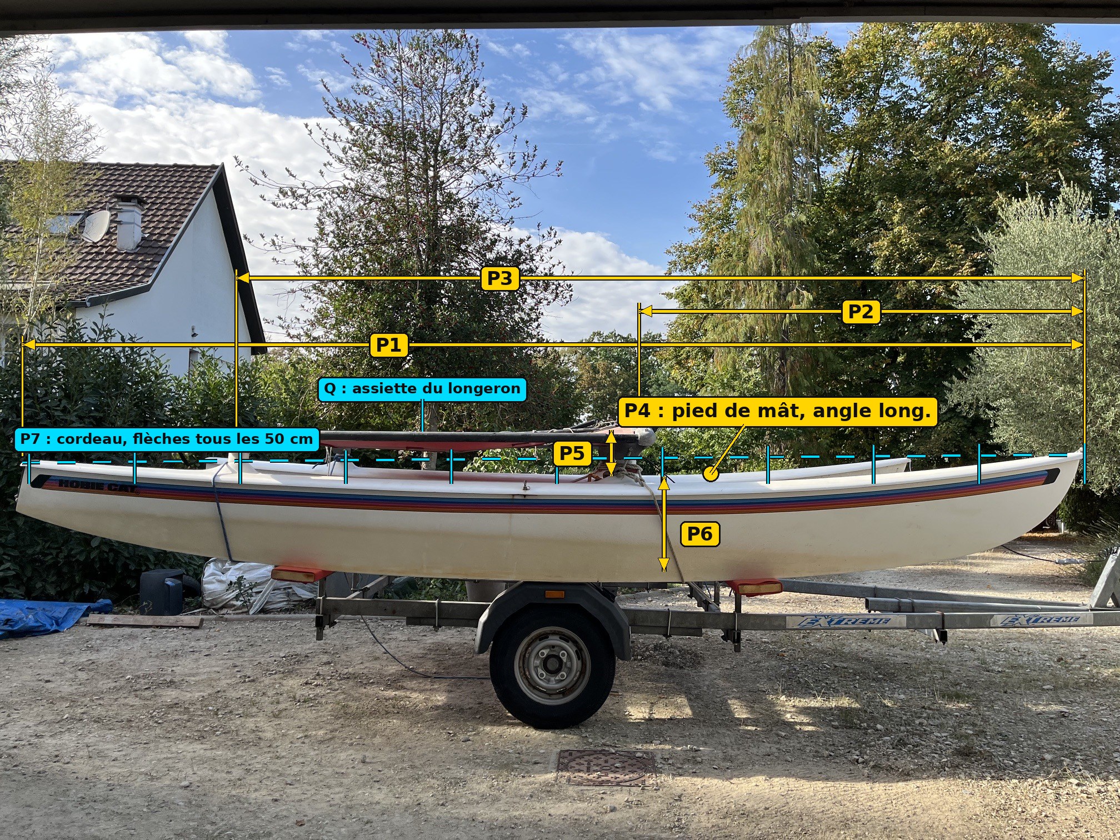
book/img/blobs/dd07590b8cb2da6c8de052697ad0b4f4.jpg
