jdb666/cao_hc16/book/img/d_accroches.jpg

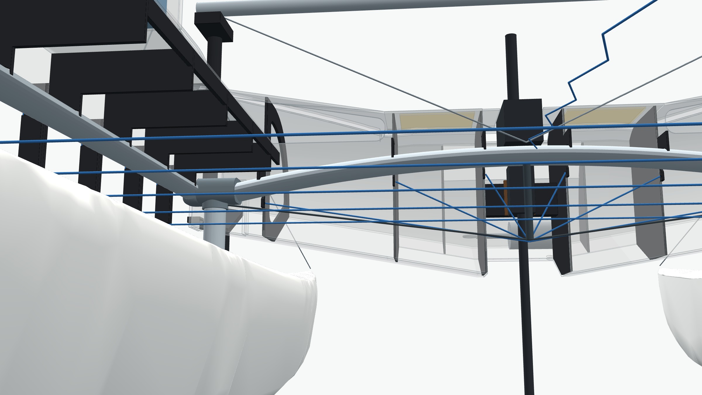
book/img/d_accroches.jpg
