jdb666/cao_hc16/book/img/d_assiette_0.jpg

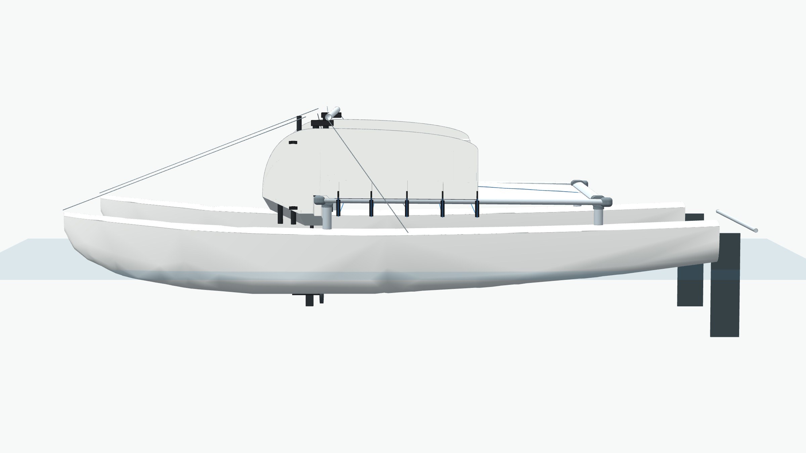
book/img/d_assiette_0.jpg
