jdb666/cao_hc16/book/img/d_bancs.jpg

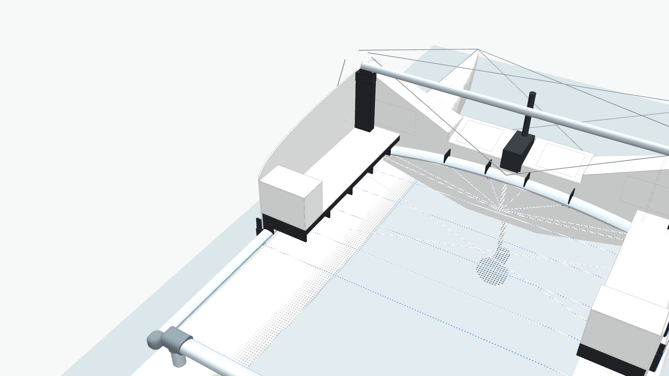
book/img/d_bancs.jpg
