jdb666/cao_hc16/book/img/d_brelage.jpg

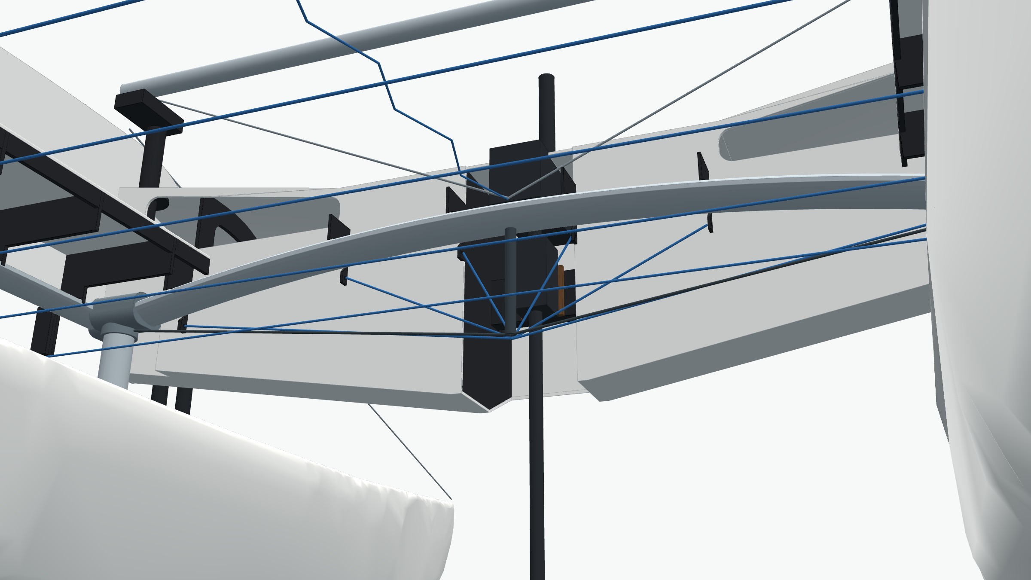
book/img/d_brelage.jpg
