jdb666/cao_hc16/book/img/h_pieds_ar.jpg

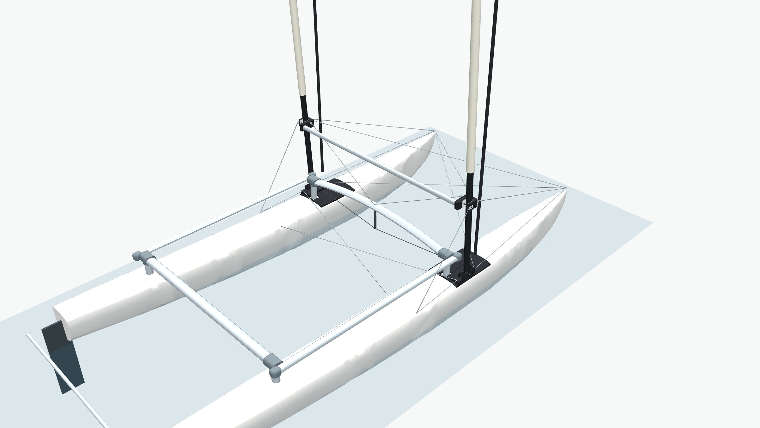
book/img/h_pieds_ar.jpg
