jdb666/cao_hc16/book/img/h_pieds_de.jpg

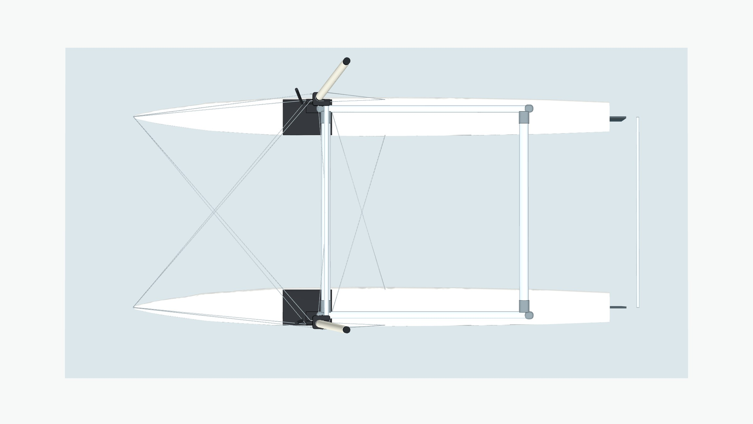
book/img/h_pieds_de.jpg
