jdb666/cao_hc16/book/img/m_coffre_ar.jpg

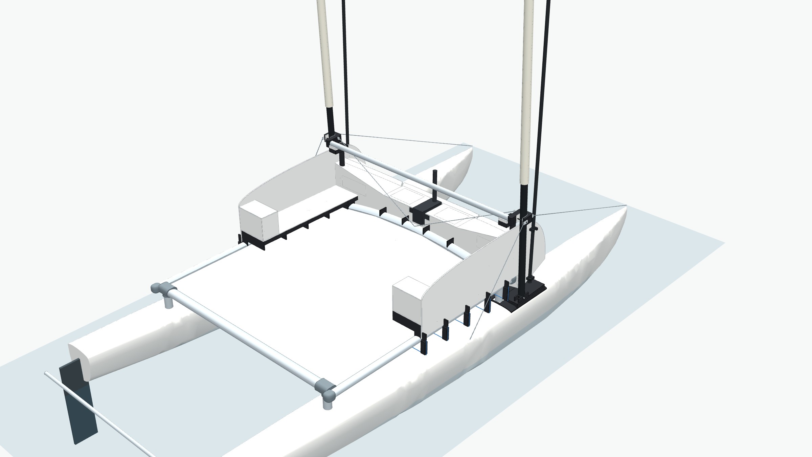
book/img/m_coffre_ar.jpg
