jdb666/cao_hc16/book/img/m_coffre_av.jpg

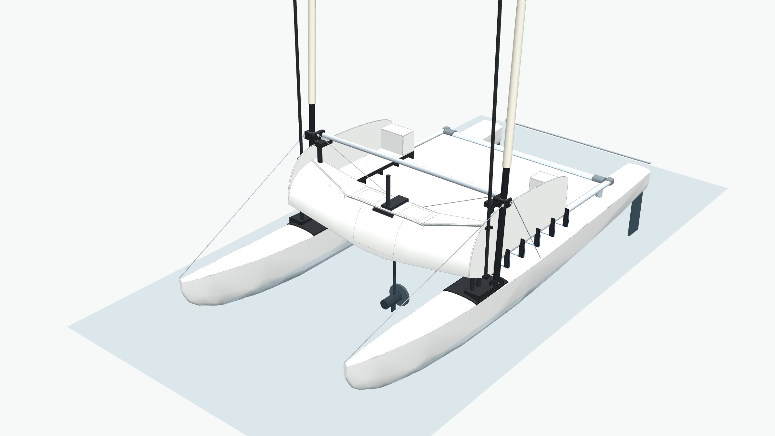
book/img/m_coffre_av.jpg
