jdb666/cao_hc16/book/img/planche_4-B.png

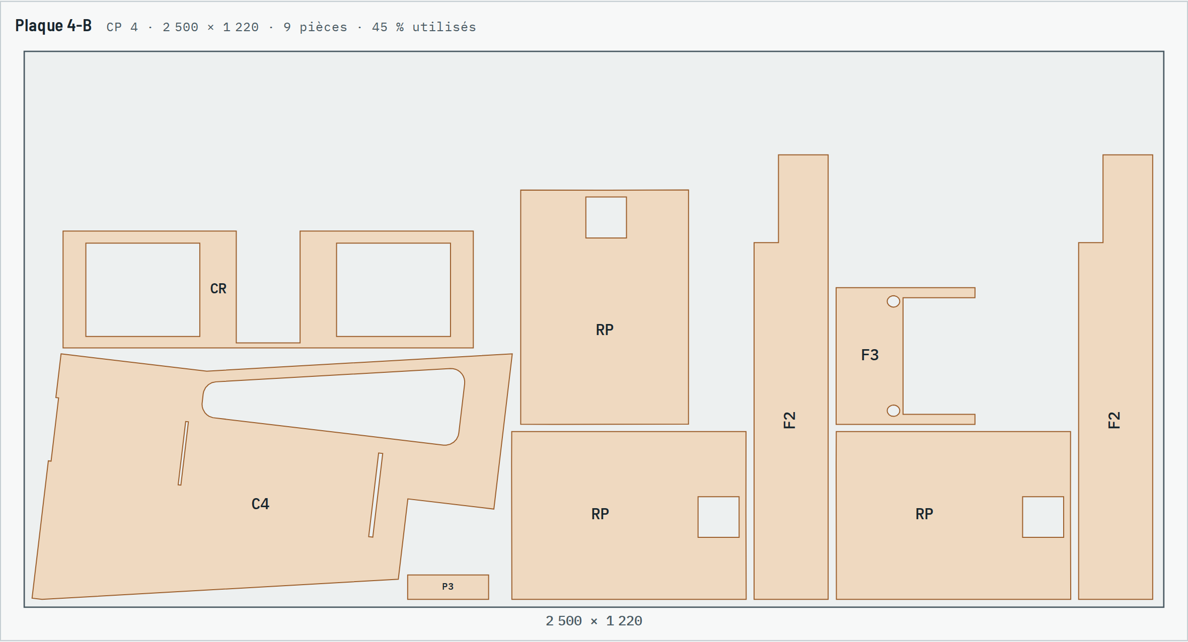
book/img/planche_4-B.png
