jdb666/cao_hc16/book/img/planche_6-A.png

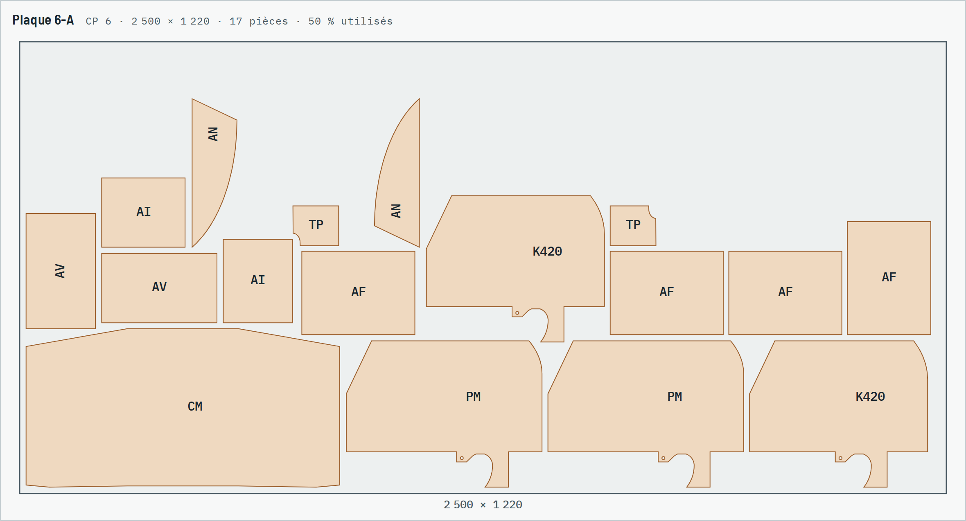
book/img/planche_6-A.png
