jdb666/cao_hc16/book/img/planche_9-A.png

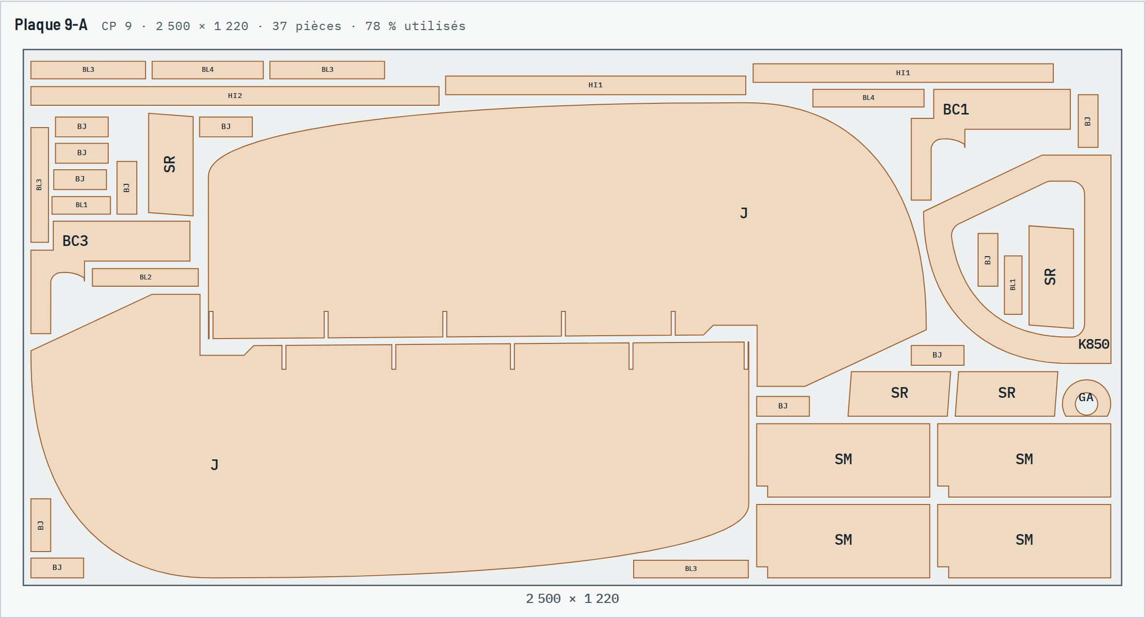
book/img/planche_9-A.png
