jdb666/cao_hc16/book/img/s2_rando_av.jpg

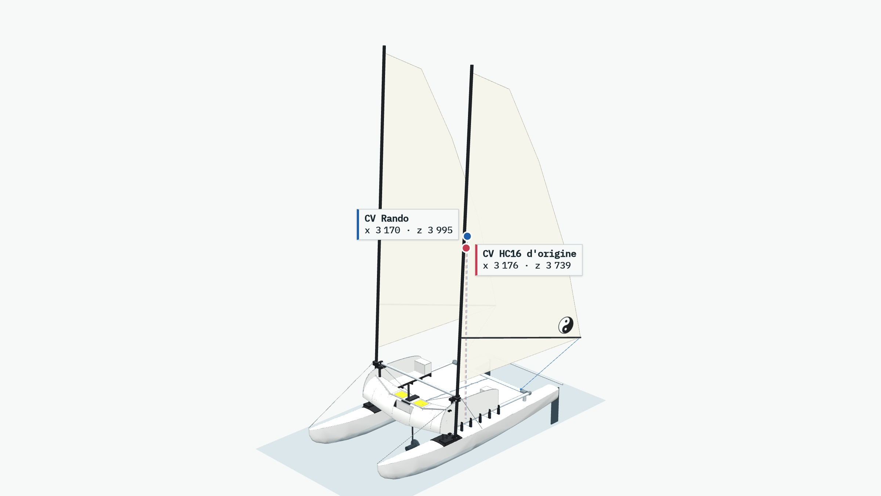
book/img/s2_rando_av.jpg
