jdb666/cao_hc16/book/img/s2_rando_fa.jpg

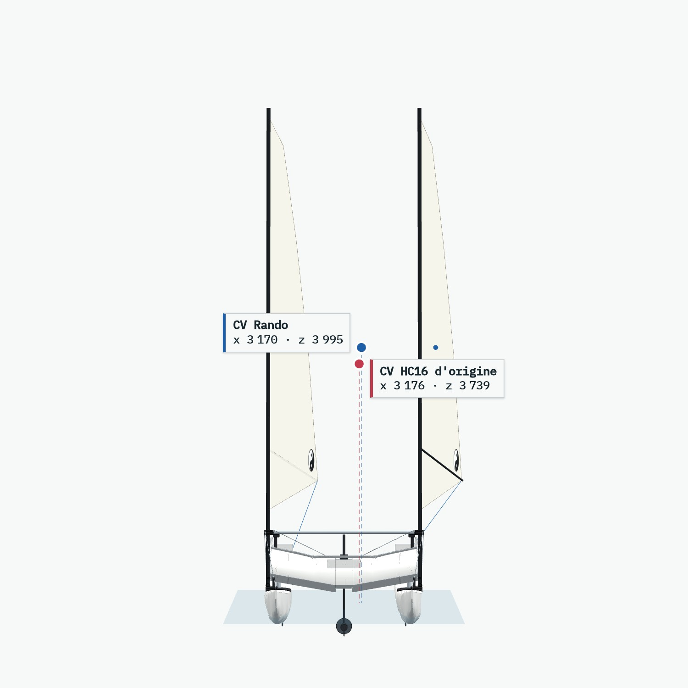
book/img/s2_rando_fa.jpg
