jdb666/cao_hc16/book/img/s2_rando_pr.jpg

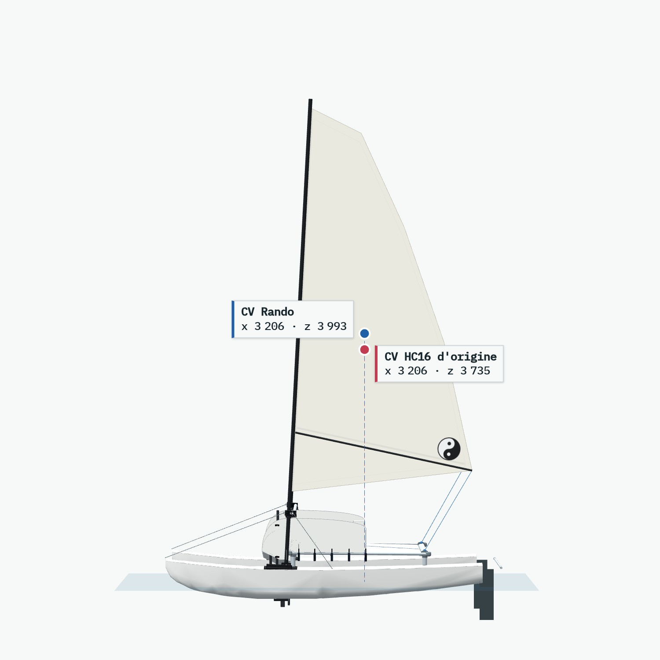
book/img/s2_rando_pr.jpg
