jdb666/cao_hc16/book/img/s3_coffre_av.jpg

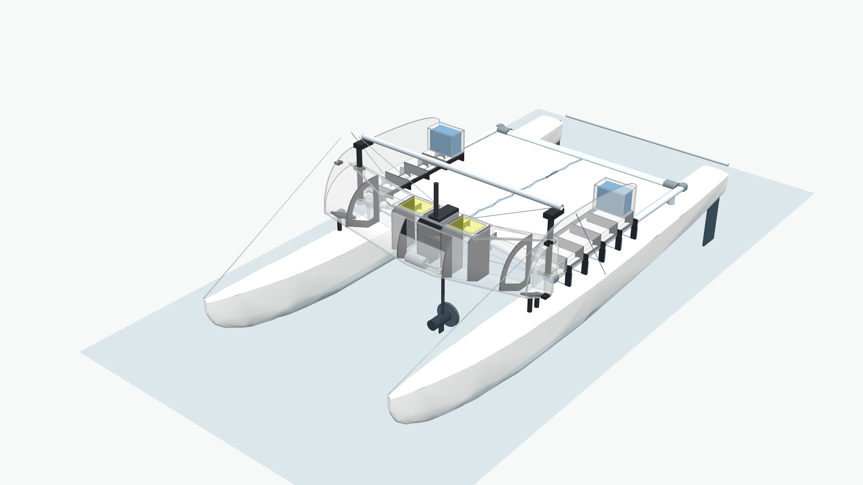
book/img/s3_coffre_av.jpg
