jdb666/cao_hc16/book/img/s3_dessous_ar.jpg

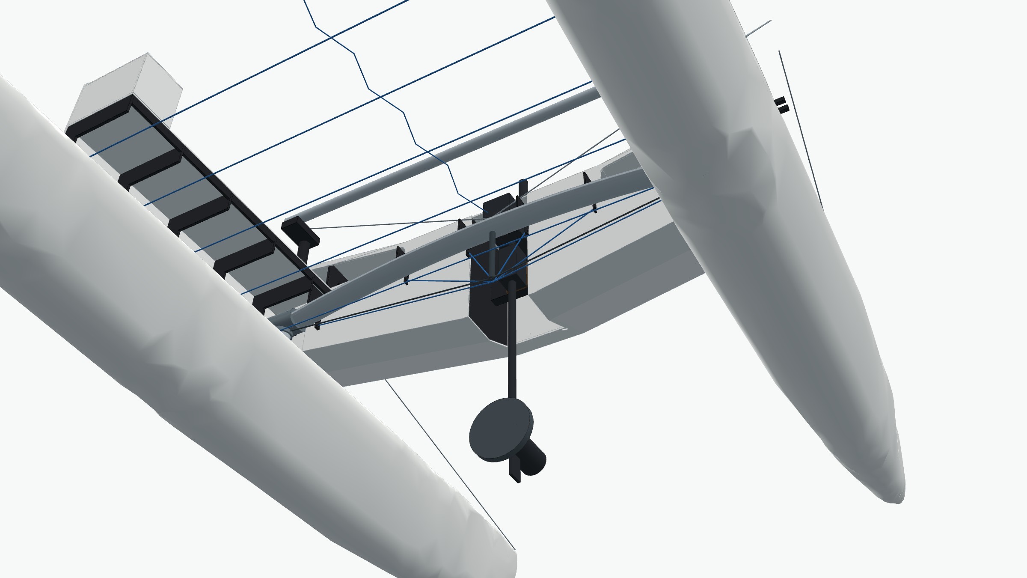
book/img/s3_dessous_ar.jpg
