jdb666/cao_hc16/book/img/s3_transp_de.jpg

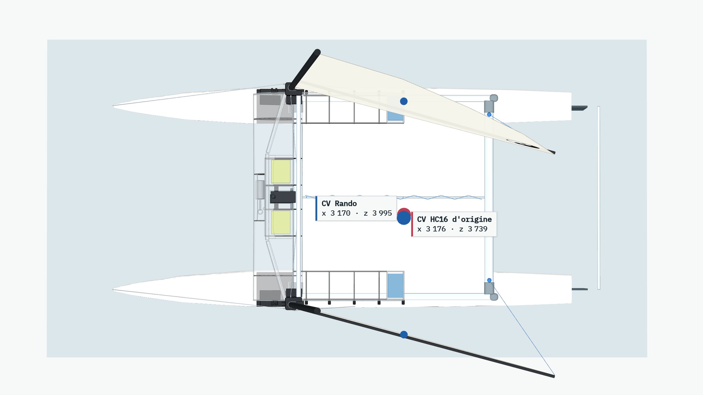
book/img/s3_transp_de.jpg
