jdb666/cao_hc16/book/img/s4_75_av.jpg

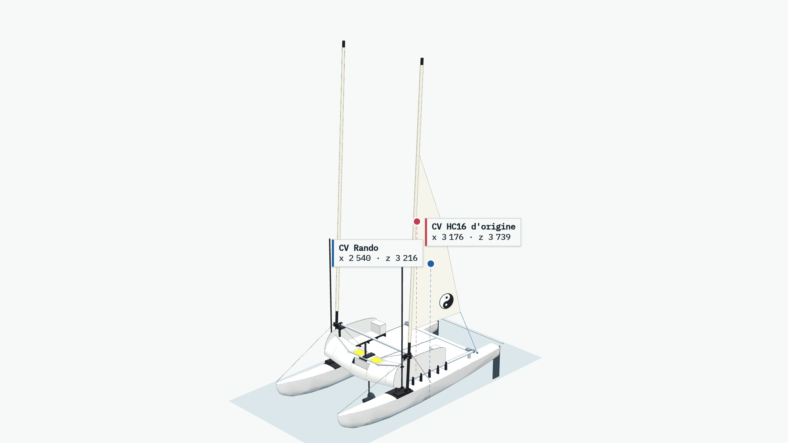
book/img/s4_75_av.jpg
