jdb666/cao_hc16/book/img/s5_bas_ar_transp.jpg

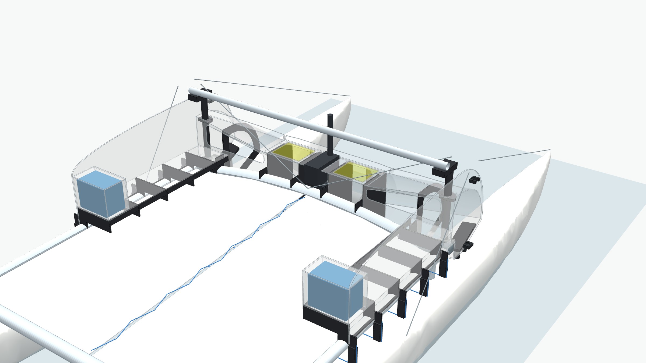
book/img/s5_bas_ar_transp.jpg
