jdb666/cao_hc16/book/img/s5_haut_ar.jpg

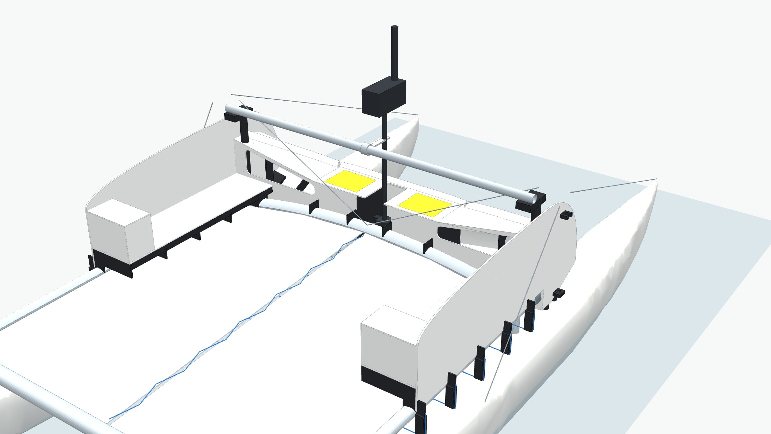
book/img/s5_haut_ar.jpg
