jdb666/cao_hc16/book/img/s5_haut_av_transp.jpg

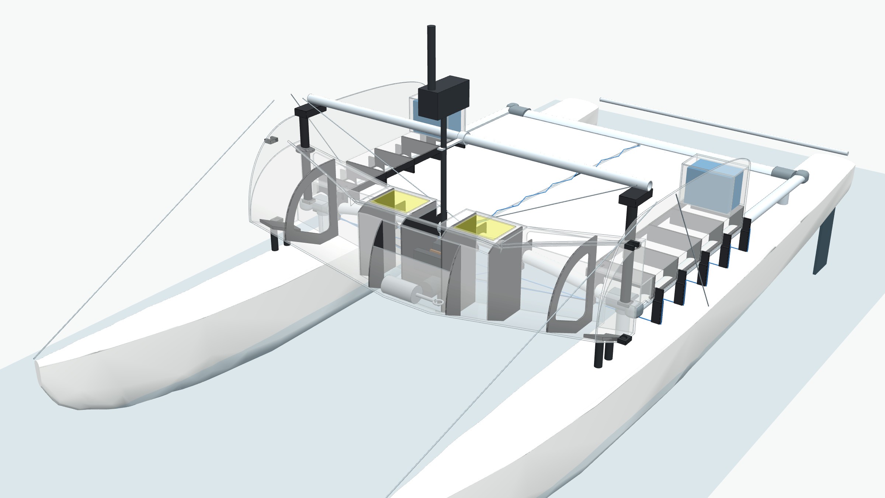
book/img/s5_haut_av_transp.jpg
