jdb666/cao_hc16/book/img/t_tente_ar.jpg

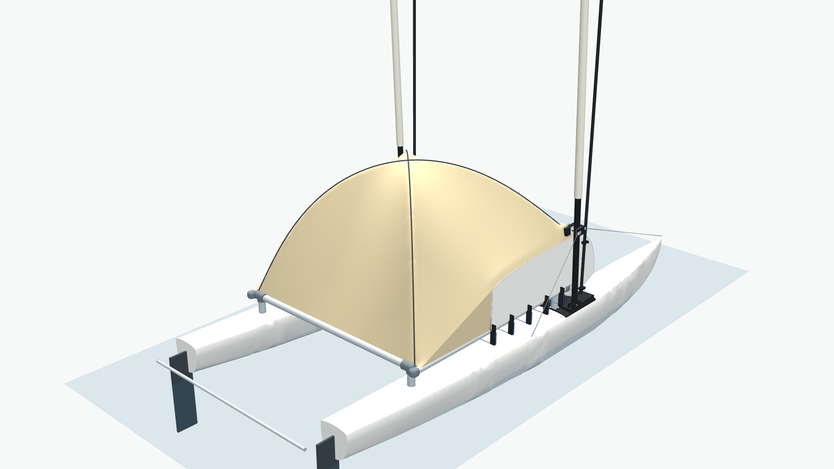
book/img/t_tente_ar.jpg
