jdb666/cao_hc16/book/img/v_acc_ar.jpg

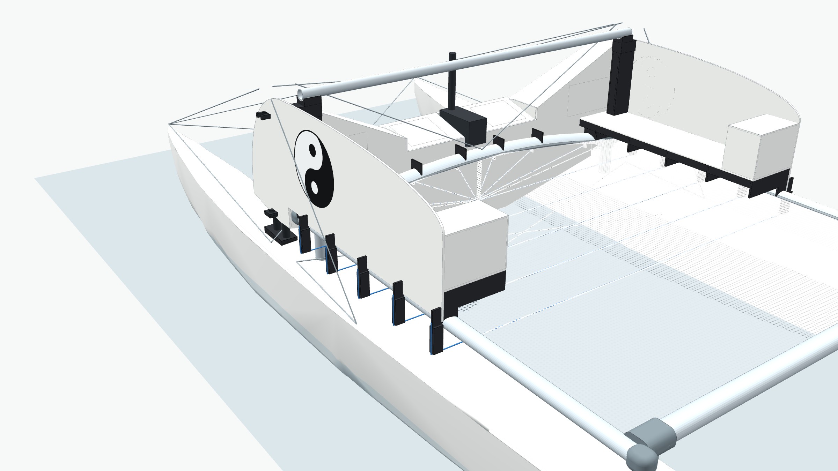
book/img/v_acc_ar.jpg
