jdb666/cao_hc16/book/img/v_acc_int.jpg

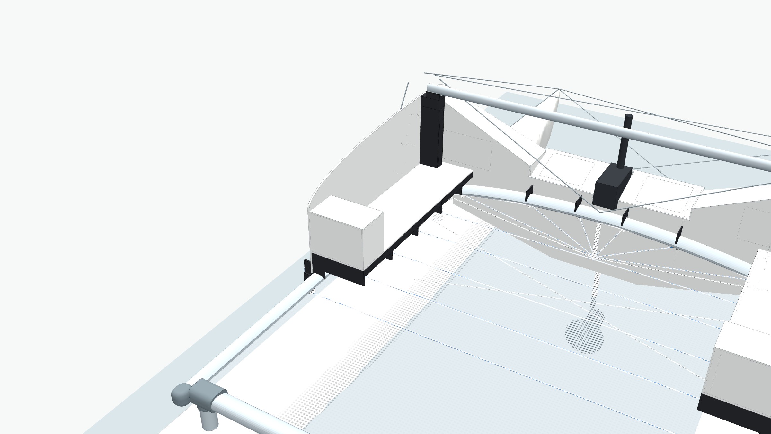
book/img/v_acc_int.jpg
