jdb666/cao_hc16/book/img/v_acc_pr.jpg

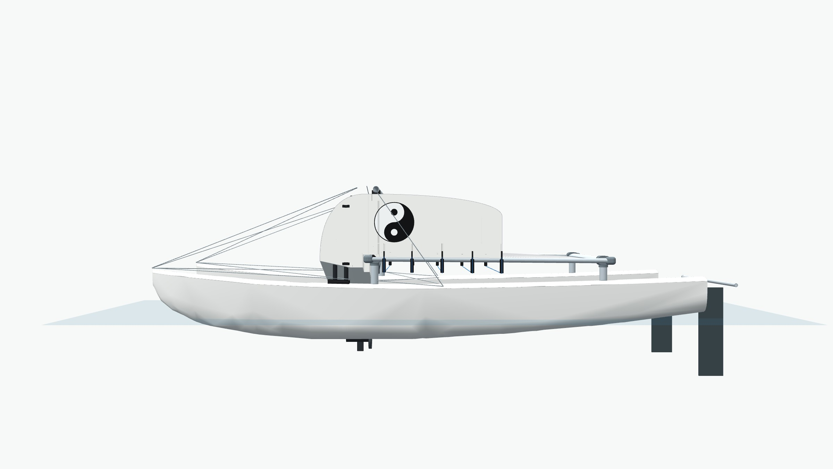
book/img/v_acc_pr.jpg
