jdb666/cao_hc16/book/img/v_banc_dessous.jpg

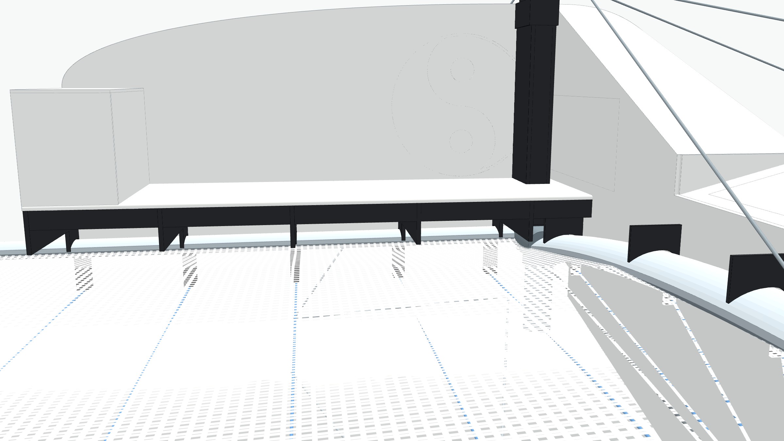
book/img/v_banc_dessous.jpg
