jdb666/cao_hc16/book/img/v_glissiere.jpg

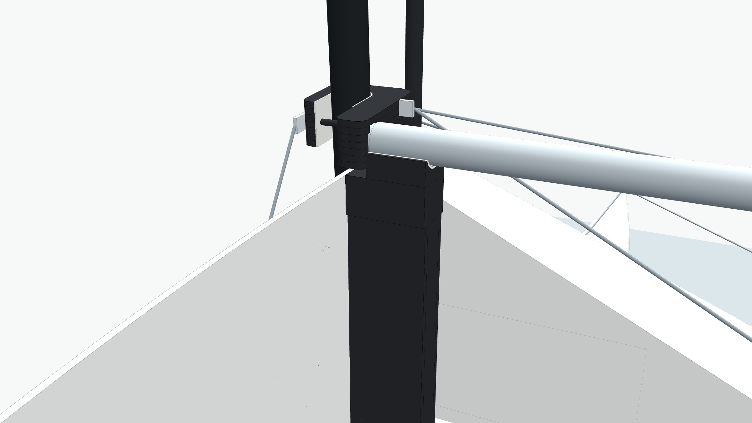
book/img/v_glissiere.jpg
