jdb666/cao_hc16/book/img/v_glissiere_berceau.jpg

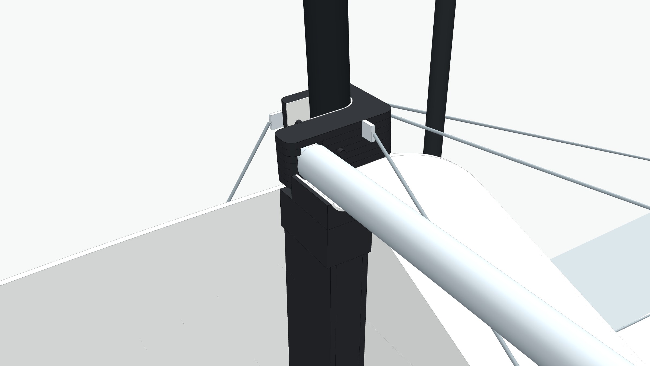
book/img/v_glissiere_berceau.jpg
