jdb666/cao_hc16/book/img/v_rang_ar.jpg

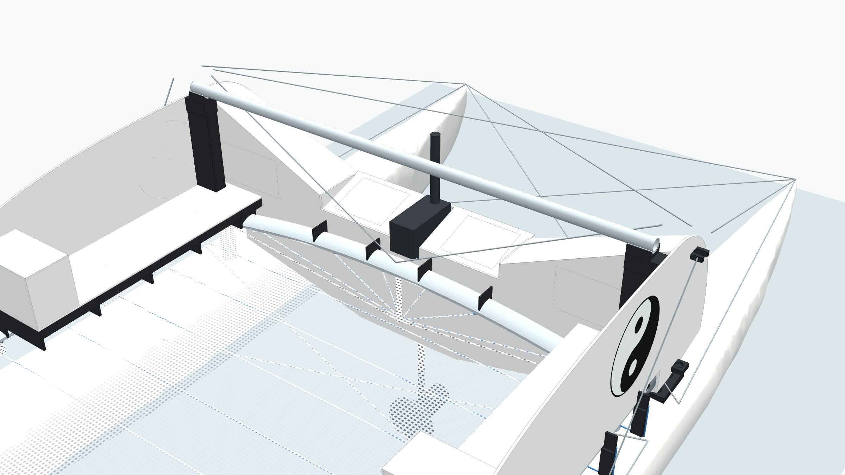
book/img/v_rang_ar.jpg
