jdb666/cao_hc16/book/img/v_trappes_c4.jpg

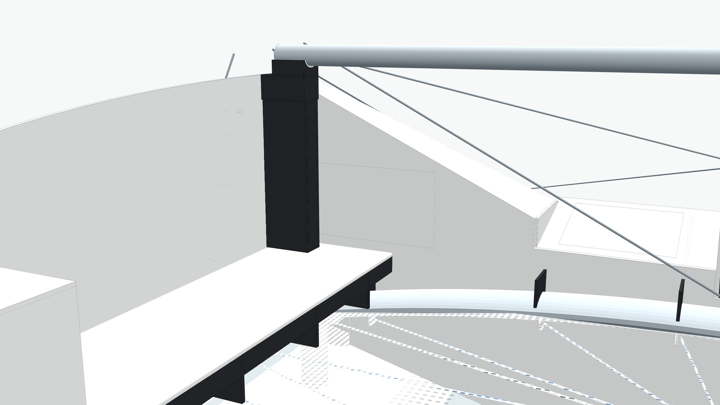
book/img/v_trappes_c4.jpg
