jdb666/cao_hc16/book/img/v_trappes_dessus.jpg

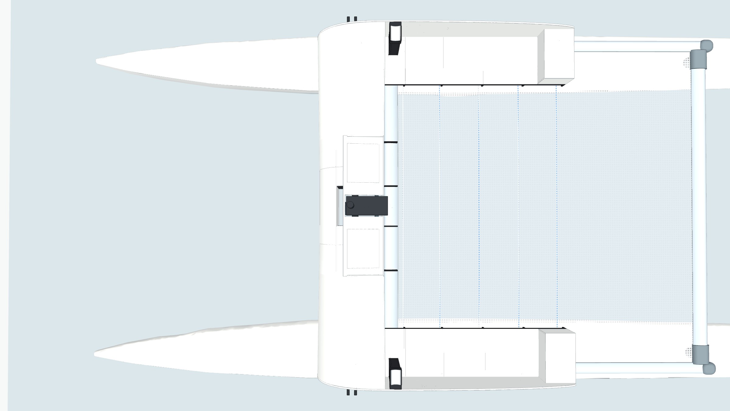
book/img/v_trappes_dessus.jpg
