jdb666/cao_hc16/bundle/dessins/plan_pont_hc16_chaises.png

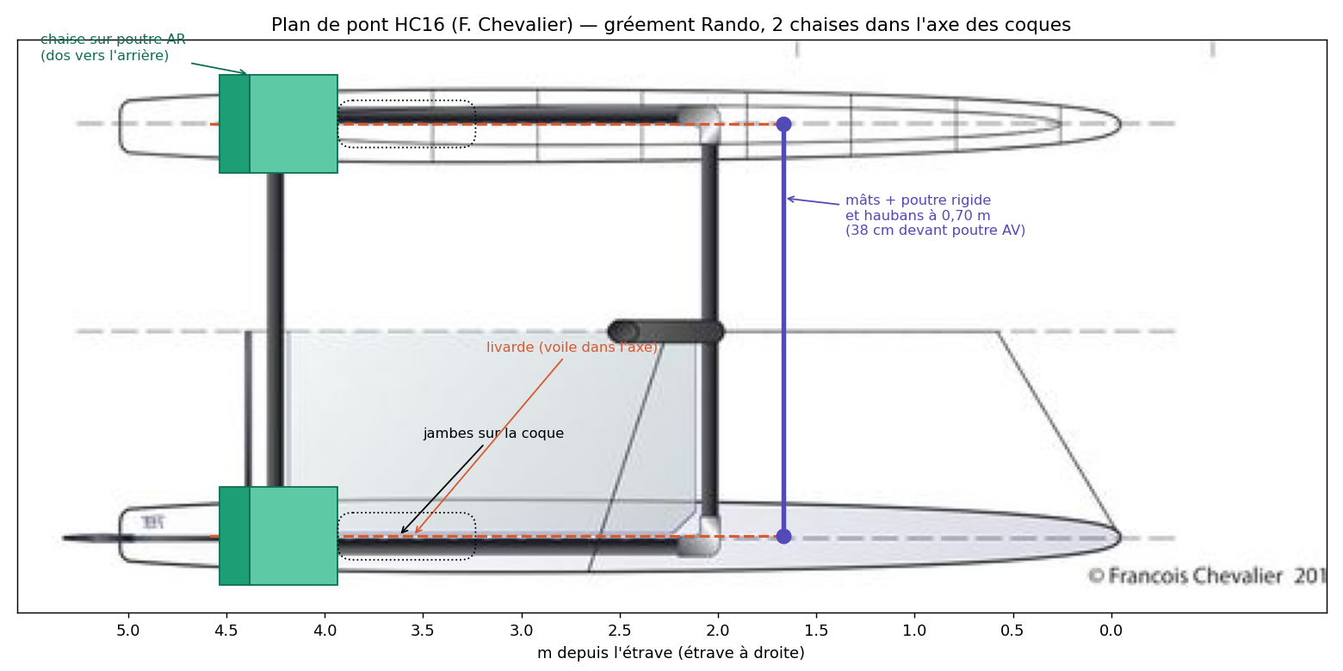
bundle/dessins/plan_pont_hc16_chaises.png
