jdb666/cao_hc16/bundle/dessins/rando_hc16_mats_exterieurs.png

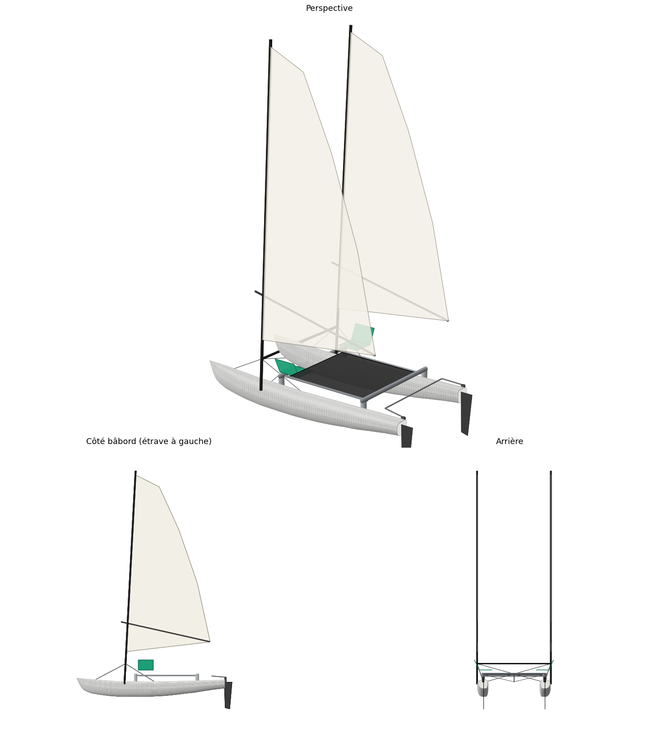
bundle/dessins/rando_hc16_mats_exterieurs.png
