jdb666/cao_hc16/bundle/dessins/rando_hc16_vues_3d_v2.png

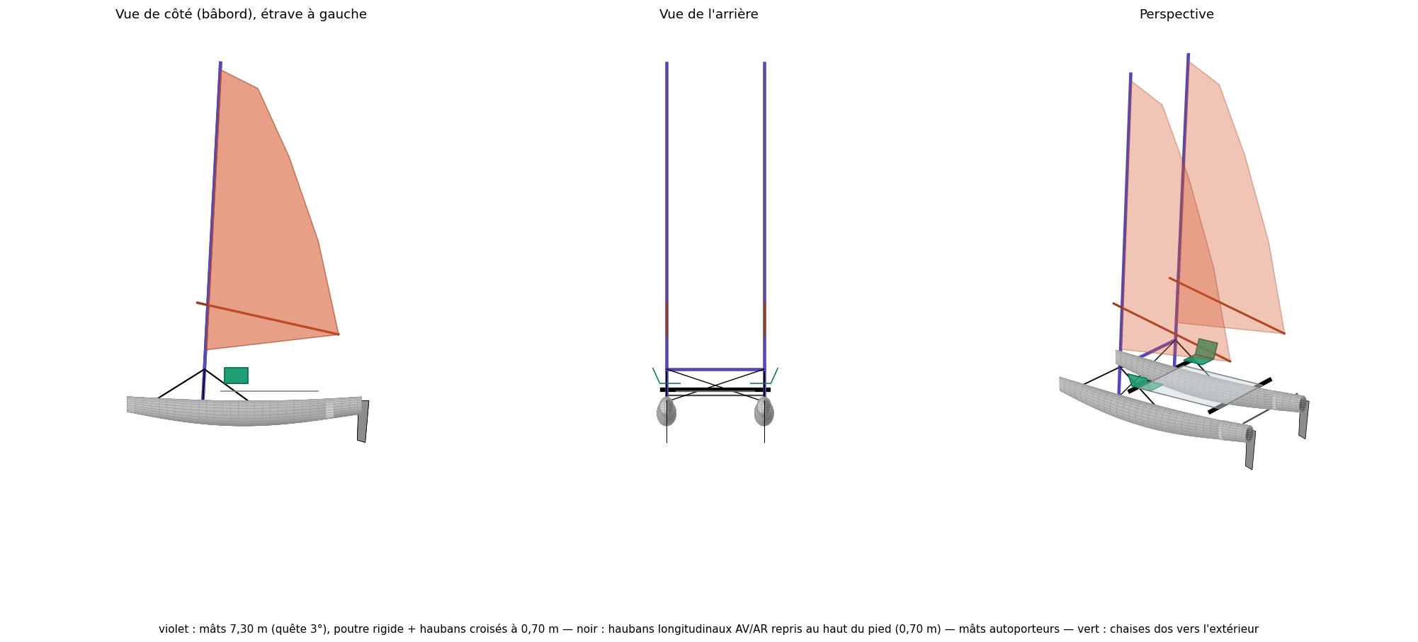
bundle/dessins/rando_hc16_vues_3d_v2.png
