jdb666/cao_hc16/bundle/dessins/rando_profil_complet.png

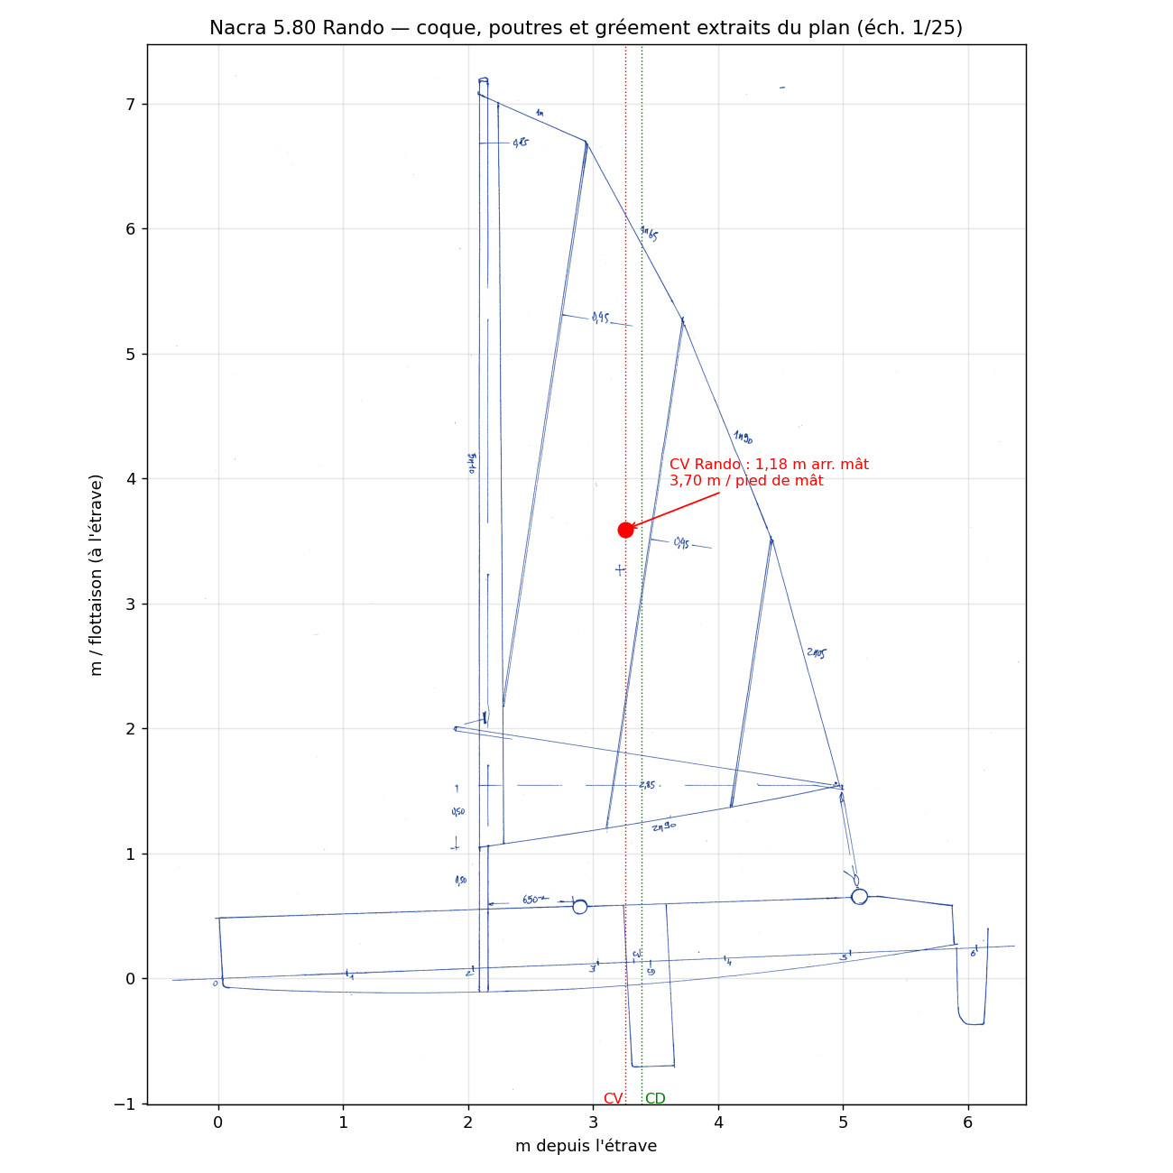
bundle/dessins/rando_profil_complet.png
