jdb666/cao_hc16/bundle/dessins/rando_sur_hc16.png

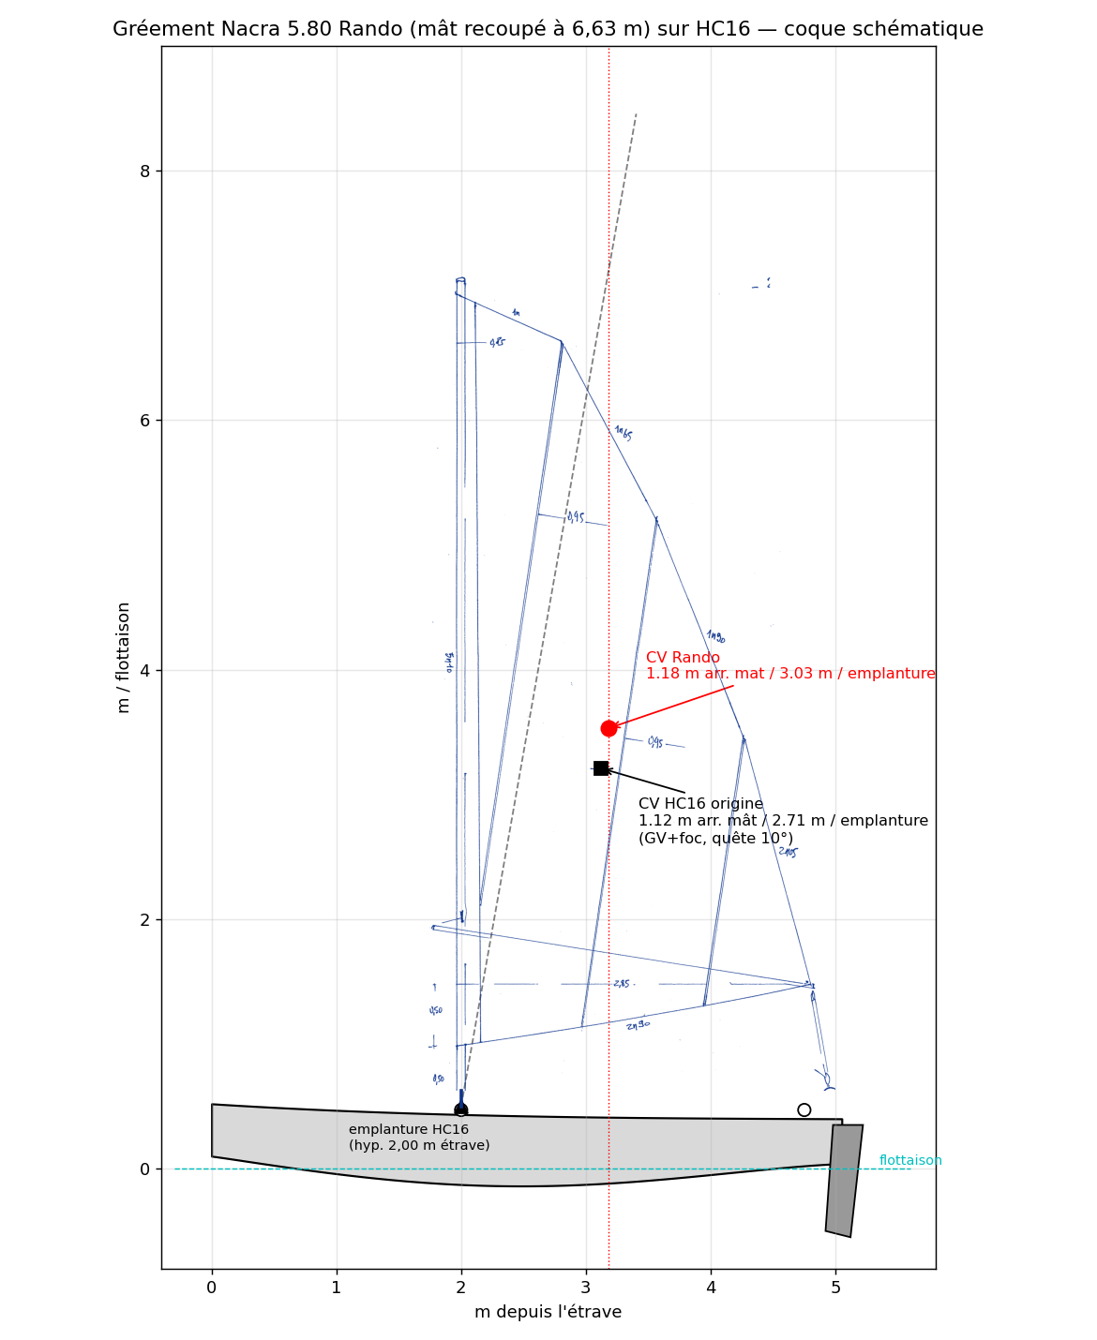
bundle/dessins/rando_sur_hc16.png
