jdb666/cao_hc16/bundle/dessins/rando_sur_hc16_v3.png

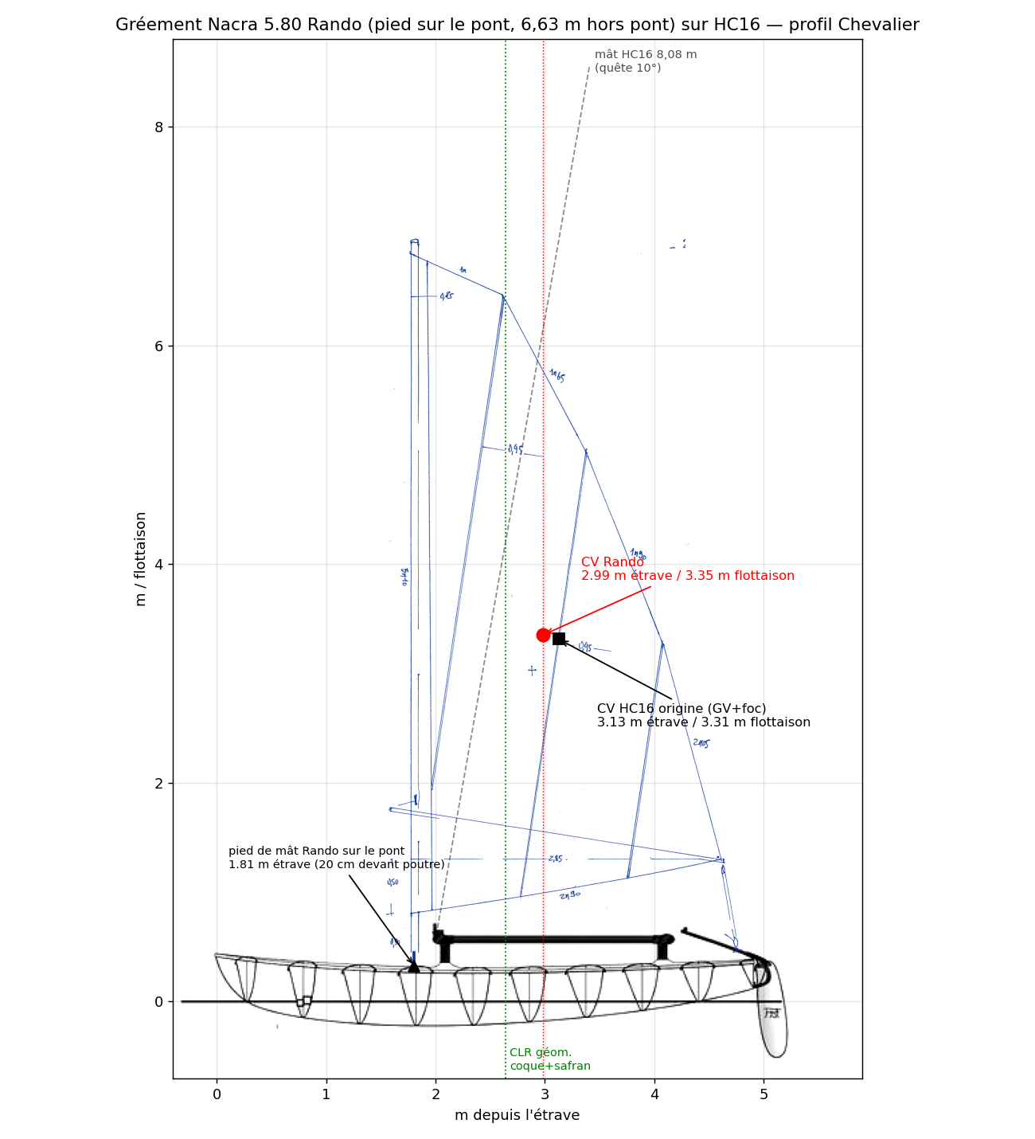
bundle/dessins/rando_sur_hc16_v3.png
