jdb666/cao_hc16/bundle/dessins/rando_sur_hc16_v5.png

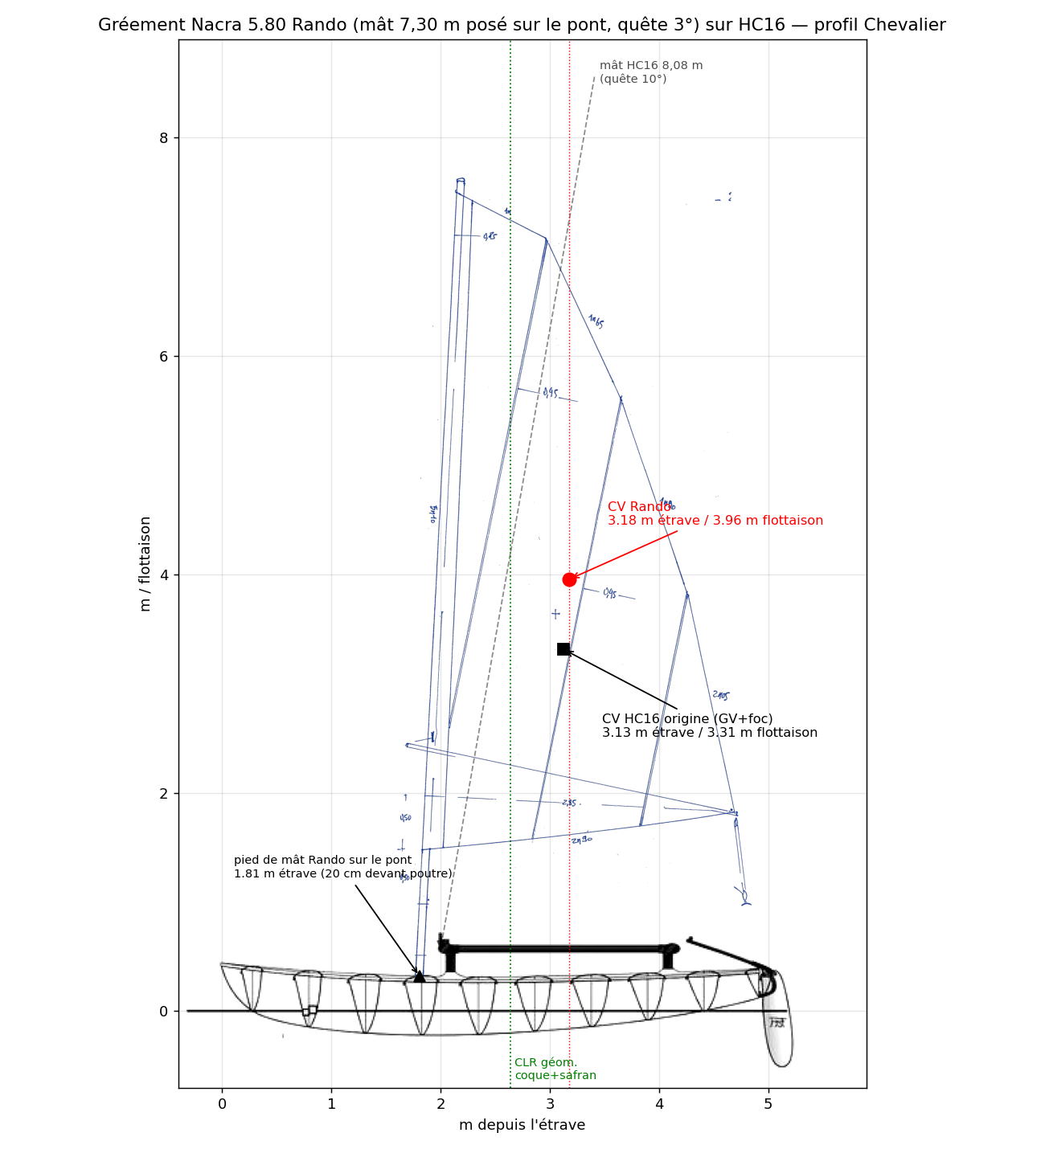
bundle/dessins/rando_sur_hc16_v5.png
