jdb666/cao_hc16/bundle/photos/IMG_8672.jpeg

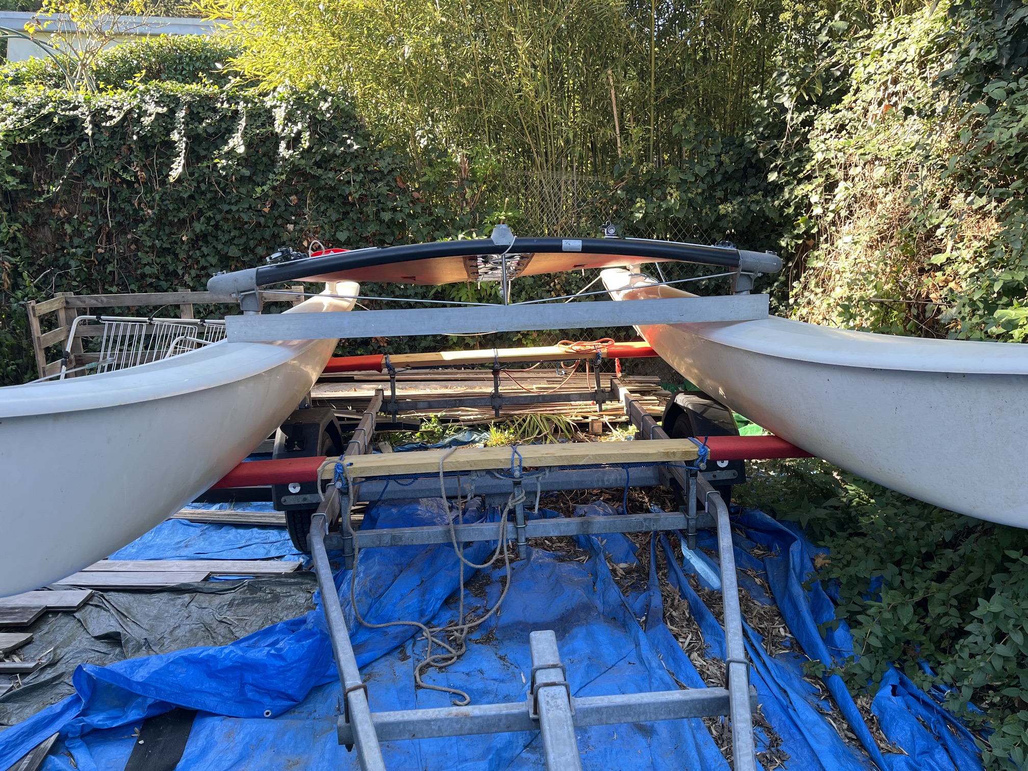
bundle/photos/IMG_8672.jpeg
