jdb666/cao_hc16/bundle/photos/IMG_8673.jpeg

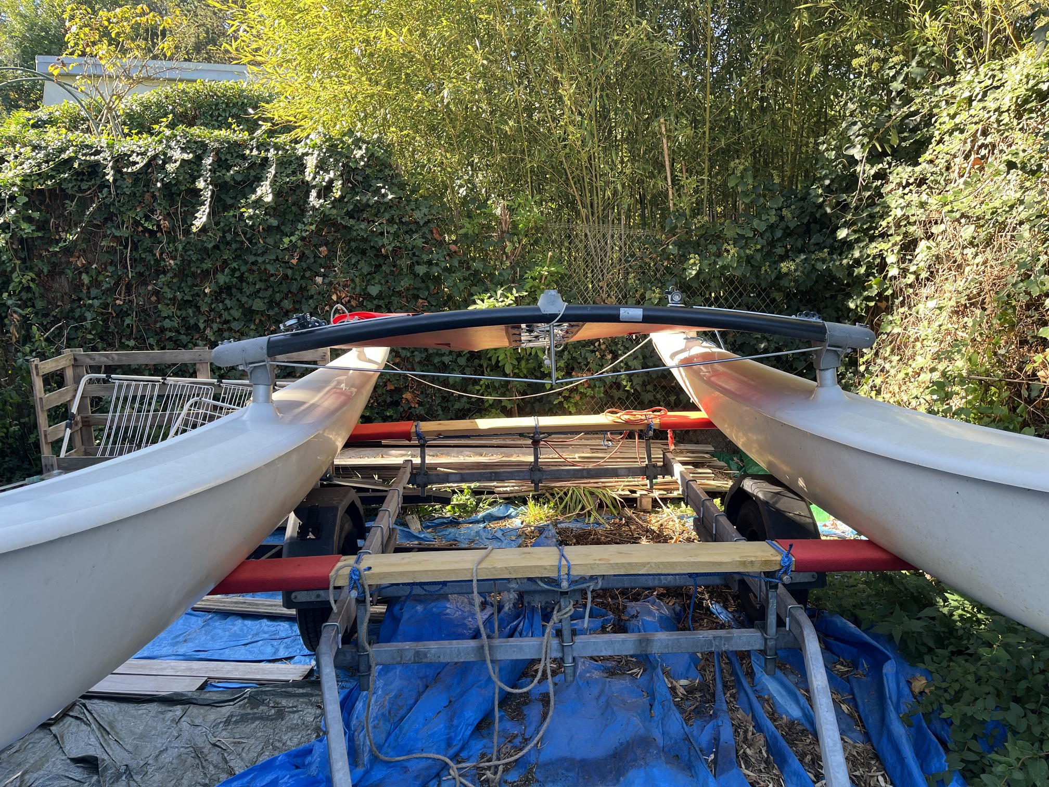
bundle/photos/IMG_8673.jpeg
