jdb666/cao_hc16/dessins/rando_profil_redresse.png

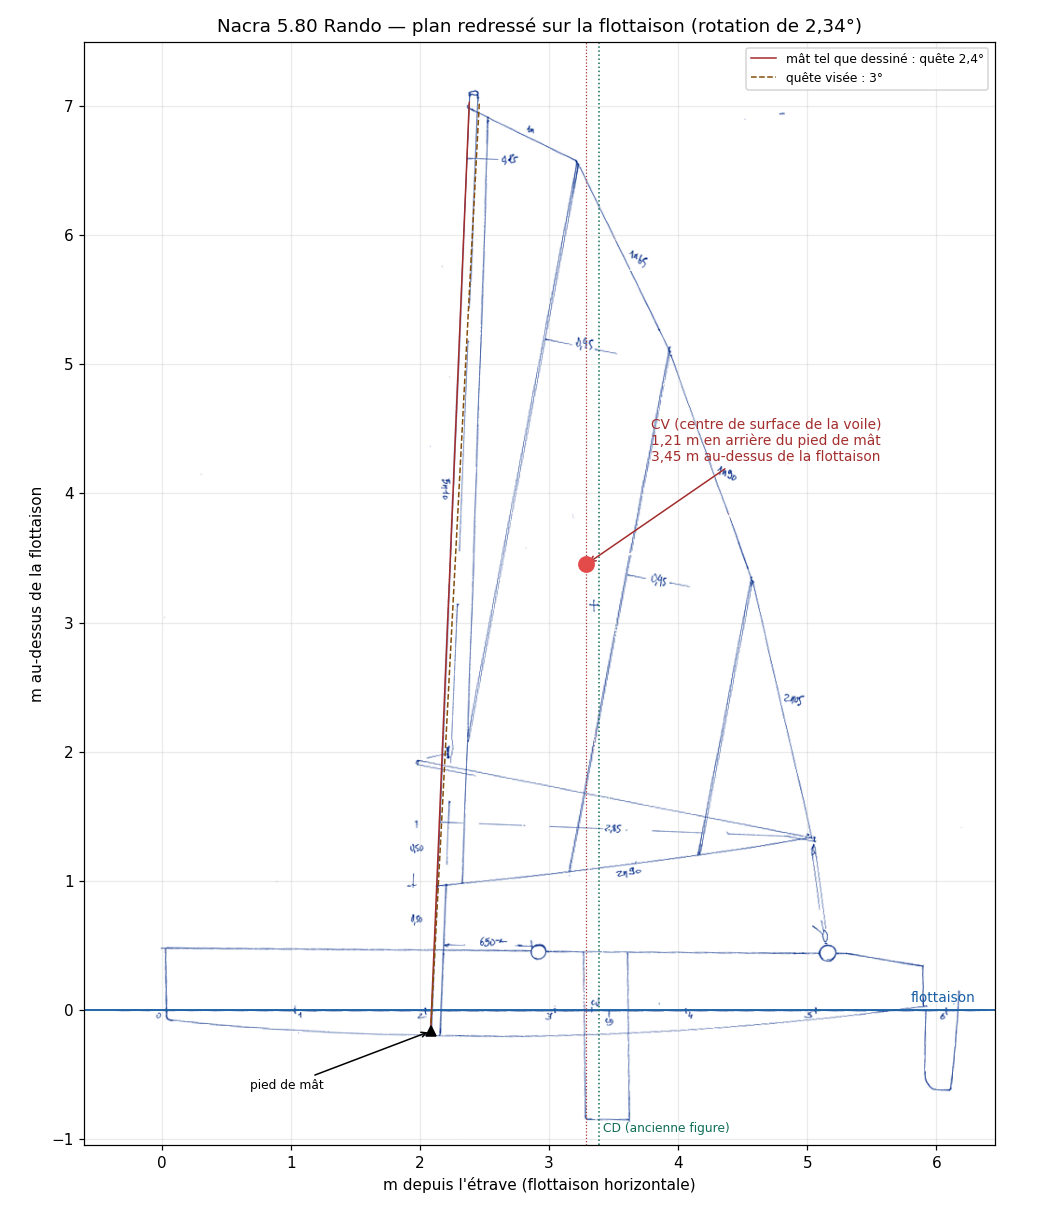
dessins/rando_profil_redresse.png
