jdb666/cao_hc16/etudes/etude_moteur_avant.png

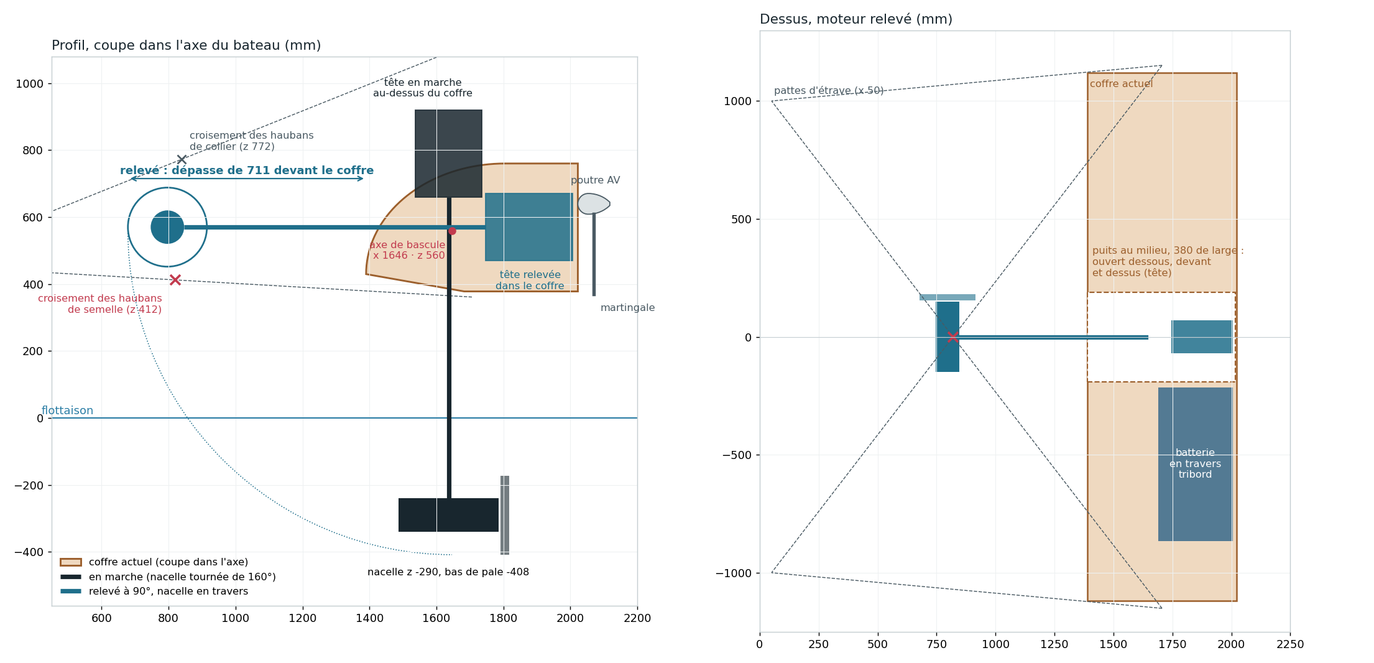
etudes/etude_moteur_avant.png
