jdb666/cao_hc16/etudes/tente_commerce/igloo_250x200_ar.jpg

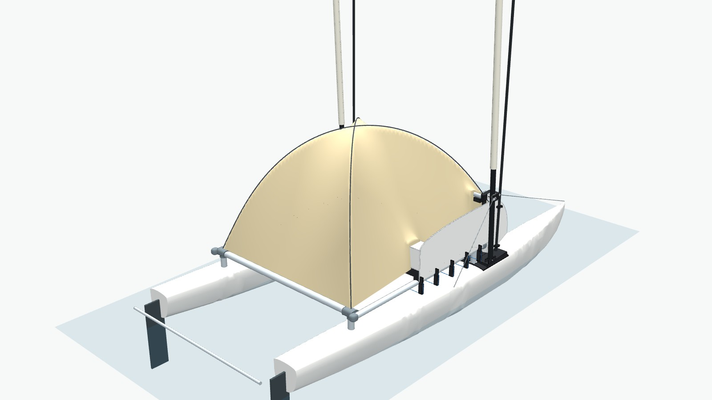
etudes/tente_commerce/igloo_250x200_ar.jpg
