jdb666/cao_hc16/etudes/tente_commerce/igloo_250x200_fa.jpg

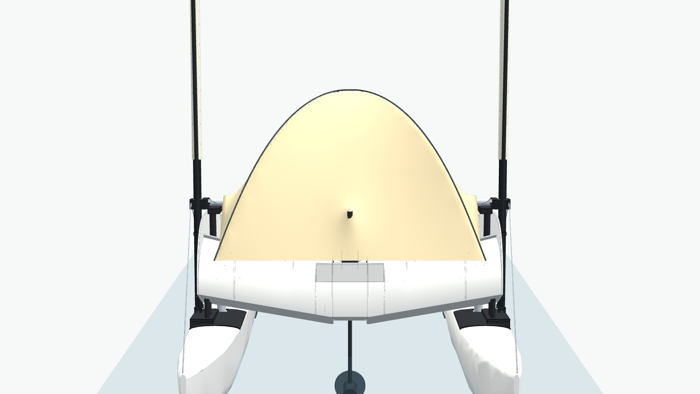
etudes/tente_commerce/igloo_250x200_fa.jpg
