jdb666/cao_hc16/etudes/tente_commerce/monodome_240x210_pr.jpg

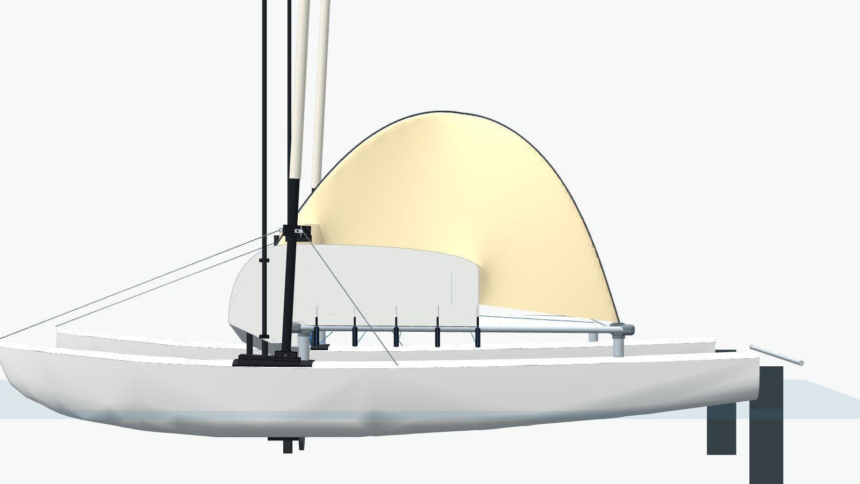
etudes/tente_commerce/monodome_240x210_pr.jpg
