jdb666/cao_hc16/releves/avant.jpg

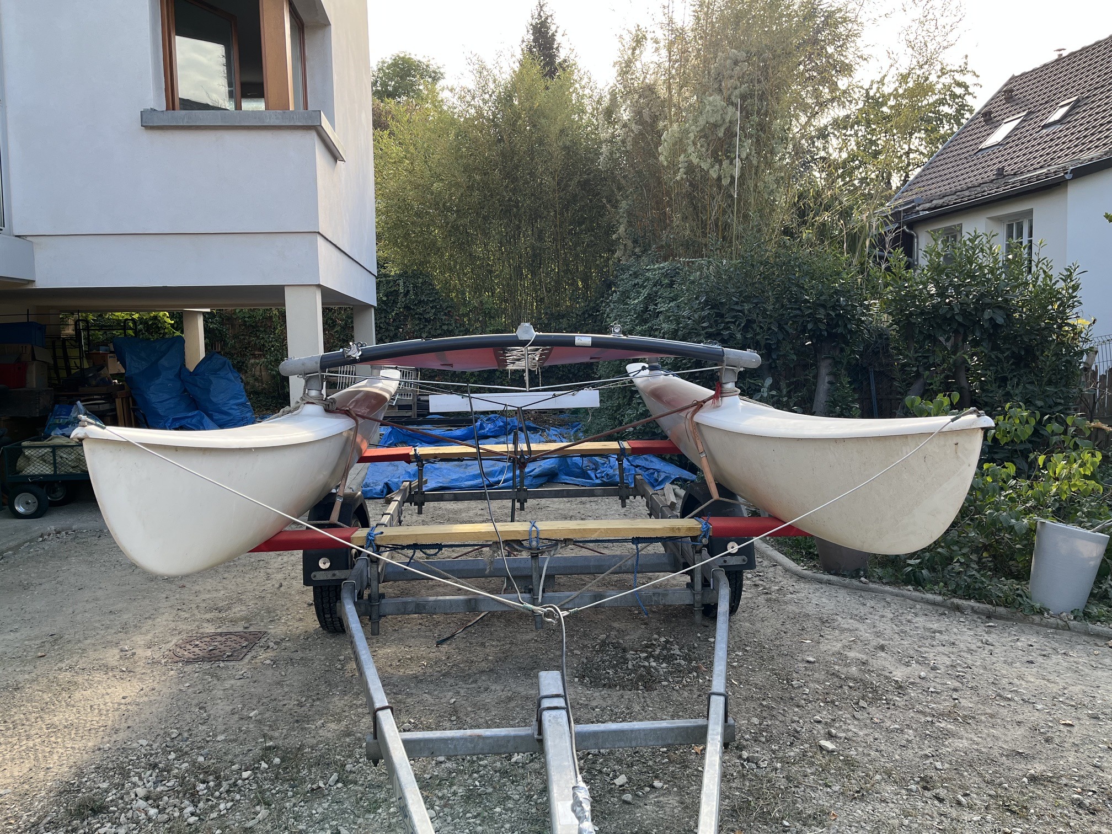
releves/avant.jpg
