jdb666/cao_hc16/releves/profils_poutres_dwg.png

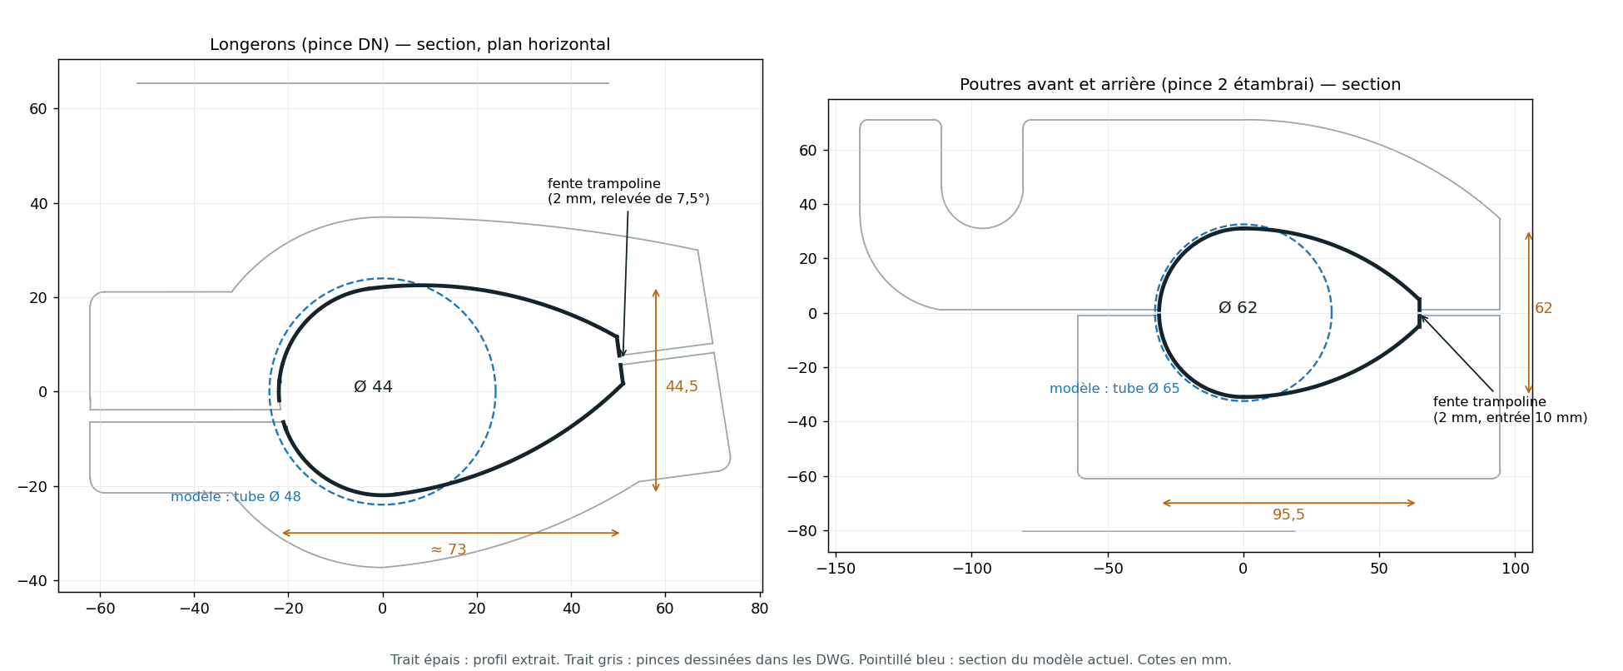
releves/profils_poutres_dwg.png
