jdb666/cao_hc16/bundle/hc16_rando_moteur_releve.step

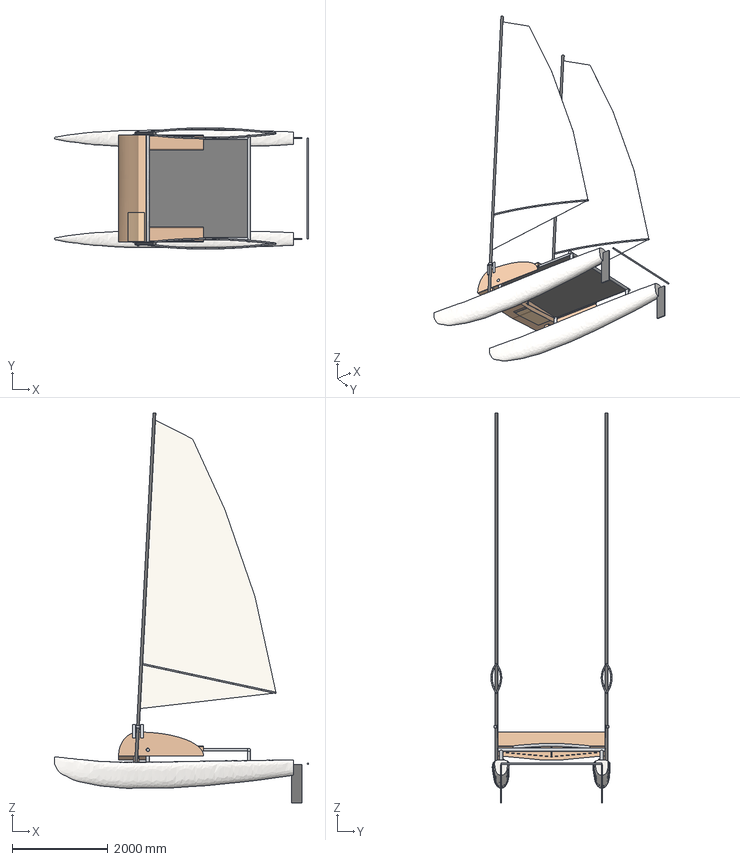
[picture p155: CAD file, 2026-10-05]
bundle/hc16_rando_moteur_releve.step
5305.0 x 2532.0 x 8136.6 mm
coque_babord
pylone_av_babord
pylone_ar_babord
longeron_babord
safran_babord
coque_tribord
pylone_av_tribord
pylone_ar_tribord
longeron_tribord
safran_tribord
poutre_av
poutre_ar
barre_accouplement
trampoline
fond_volet
coffre_capot
coffre_coque
coffre_cloison_1
coffre_cloison_2
patte_collier_babord_av
patte_collier_babord_ar
patte_collier_tribord_av
patte_collier_tribord_ar
joue_babord
joue_tribord
martingale_pilier
martingale_cable_babord
martingale_cable_tribord
charniere_palier_av
charniere_palier_ar
charniere_axe
chaise_planche
chaise_flasque
chaise_bras
moteur_arbre
moteur_tete
moteur_nacelle
moteur_helice
pylone_coffre_babord
pylone_coffre_tribord
banc_babord_caisson
banc_babord_assise
banc_tribord_caisson
banc_tribord_assise
mat_babord
collier_babord
repere_haubanage_babord
voile_babord
livarde_babord_a
livarde_babord_b
mat_tribord
collier_tribord
repere_haubanage_tribord
voile_tribord
livarde_tribord_a
livarde_tribord_b
