jdb666/cao_hc16/bundle/plans/dxf/planche_9-A.dxf

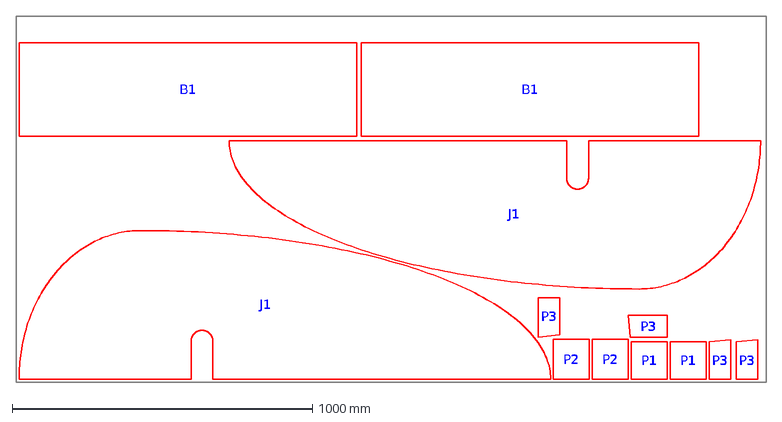
[picture p156: CAD file, 2026-10-05]
bundle/plans/dxf/planche_9-A.dxf
J1
B1
P2
P1
P3
