jdb666/cao_hc16/hc16_plateforme.step

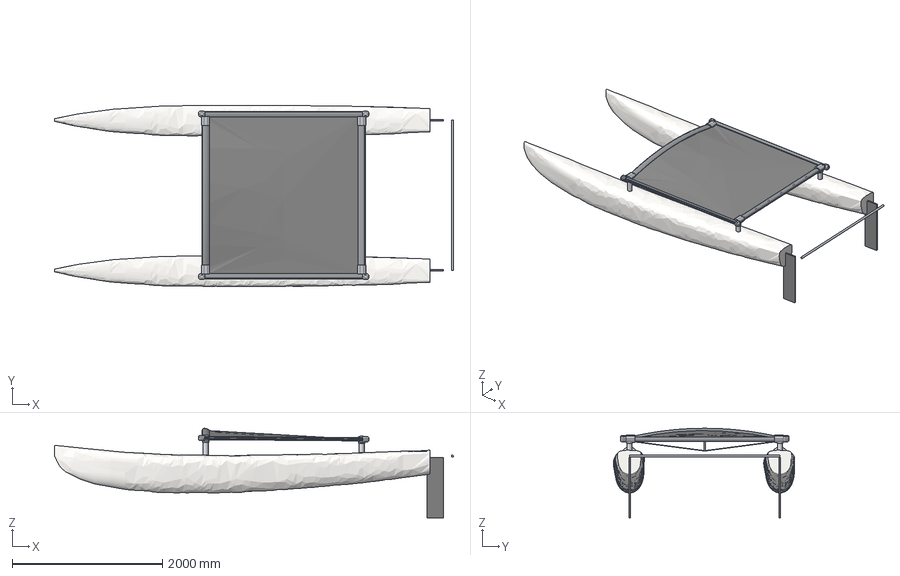
[picture p157: CAD file, 2026-10-05]
hc16_plateforme.step
5304.9 x 2412.7 x 1190.4 mm
coque_babord
pylone_av_babord
pylone_ar_babord
longeron_babord
piece_angle_av_babord
piece_angle_ar_babord
safran_babord
coque_tribord
pylone_av_tribord
pylone_ar_tribord
longeron_tribord
piece_angle_av_tribord
piece_angle_ar_tribord
safran_tribord
poutre_av
poutre_ar
barre_accouplement
trampoline
martingale_pilier
martingale_tige_babord
martingale_tige_tribord
