jdb666/cao_hc16/plans/dxf/planche_9-A.dxf

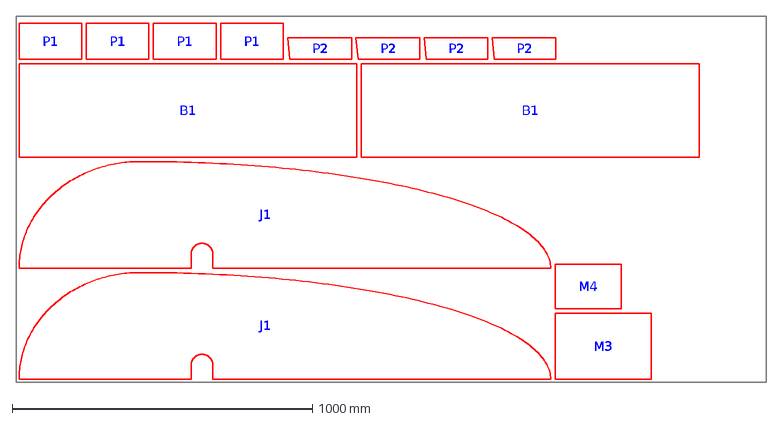
[picture p158: CAD file, 2026-10-05]
plans/dxf/planche_9-A.dxf
J1
B1
P1
P2
M3
M4
