jdb666/cao_hc16/plans/dxf2/planche_9-A.dxf

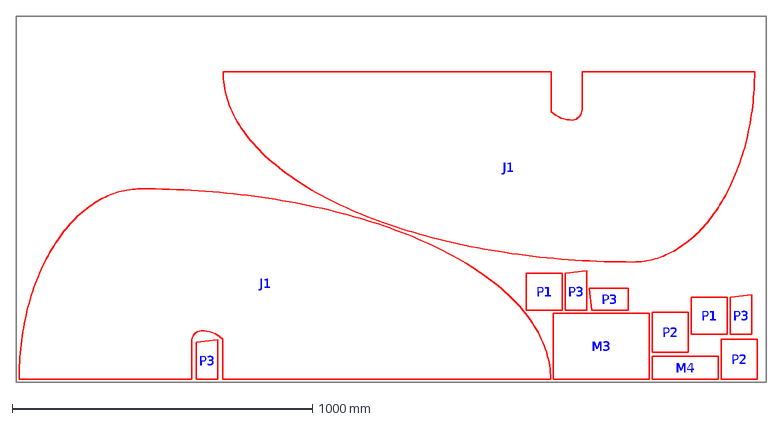
[picture p159: CAD file, 2026-10-05]
plans/dxf2/planche_9-A.dxf
J1
M3
M4
P2
P1
P3
