jdb666/cao_hc16/plans/dxf3/pieces/CM.dxf

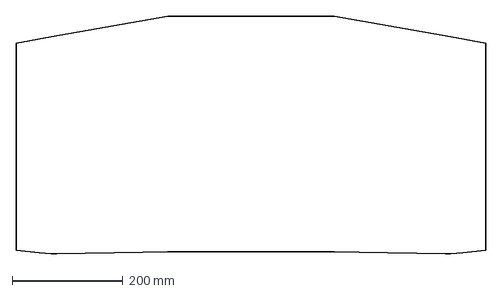
[picture p160: CAD file, 2026-10-10]
plans/dxf3/pieces/CM.dxf
846.0 x 428.0 mm
