jdb666/cao_hc16/plans/dxf3/planche_9-B.dxf

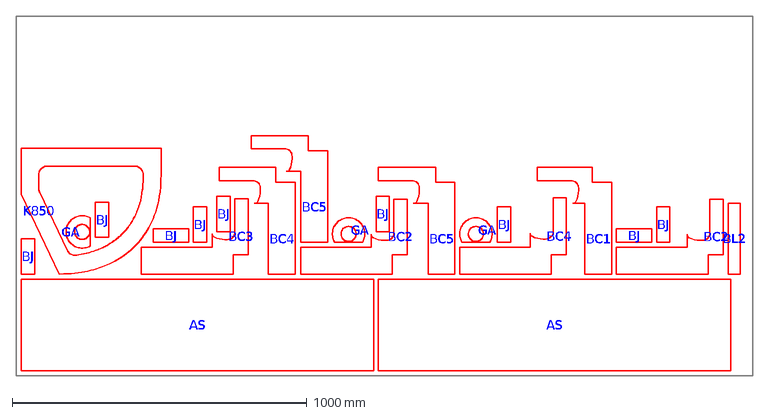
[picture p161: CAD file, 2026-10-10]
plans/dxf3/planche_9-B.dxf
AS
K850
BC3
BC4
BC2
BC5
BC1
BL2
GA
BJ
