jdb666/cao_hc16/bundle/plans/dxf/planche_6-B.dxf

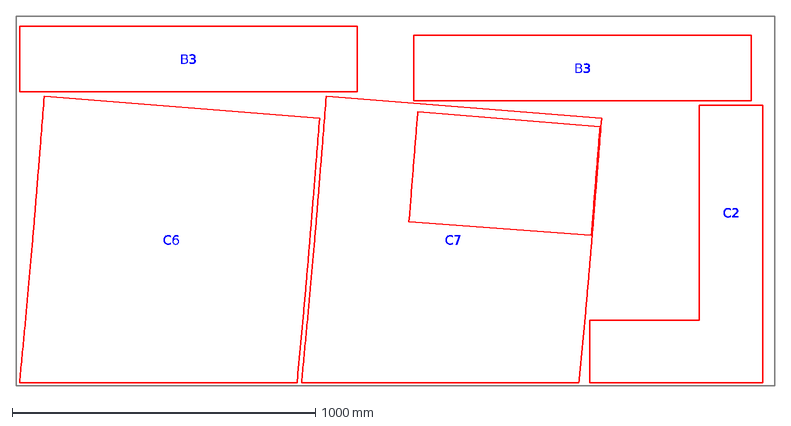
[picture p162: CAD file, 2026-10-05]
bundle/plans/dxf/planche_6-B.dxf
C6
C7
C2
B3
