jdb666/cao_hc16/cata_pleine_0.step

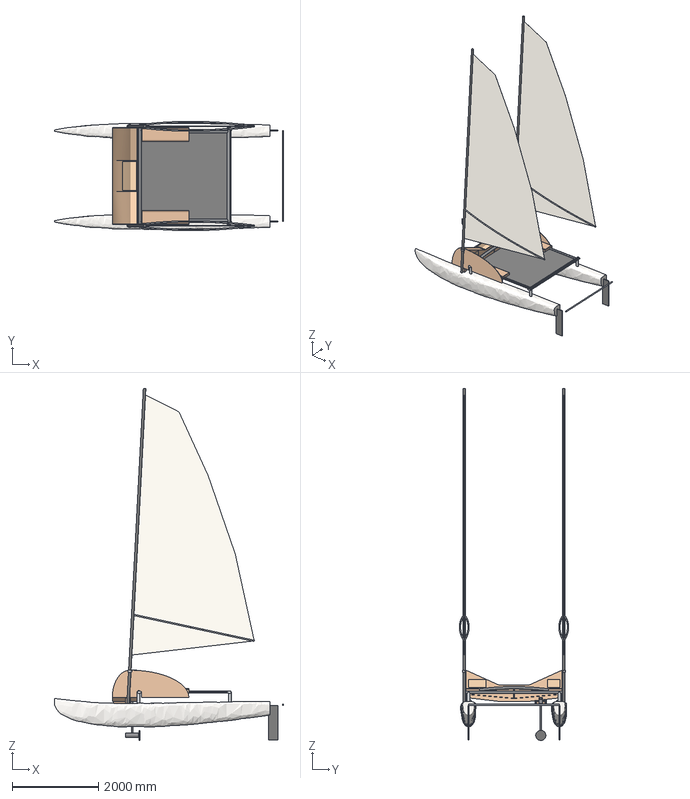
[picture p163: CAD file, 2026-10-05]
cata_pleine_0.step
5304.9 x 2531.8 x 8144.6 mm
coque_babord
pylone_av_babord
pylone_ar_babord
longeron_babord
safran_babord
coque_tribord
pylone_av_tribord
pylone_ar_tribord
longeron_tribord
safran_tribord
poutre_av
poutre_ar
barre_accouplement
trampoline
moteur_niche
coffre_capot
coffre_trappe_c4_1
coffre_trappe_c4_2
coffre_coque
coffre_cloison_1
batterie_bac
batterie
joue_babord
joue_tribord
martingale_pilier
martingale_cable_babord
martingale_cable_tribord
chaise_planche
chaise_joue_babord
chaise_joue_tribord
carter_fond
carter_face_av
moteur_arbre
moteur_tete
moteur_nacelle
moteur_helice
moteur_bride
pylone_coffre_babord
pylone_coffre_tribord
banc_babord_caisson
banc_babord_assise
banc_tribord_caisson
banc_tribord_assise
mat_babord
collier_babord
repere_haubanage_babord
voile_babord
livarde_babord_a
livarde_babord_b
mat_tribord
collier_tribord
repere_haubanage_tribord
voile_tribord
livarde_tribord_a
livarde_tribord_b
