jdb666/cao_hc16/plans/dxf/planche_6-A.dxf

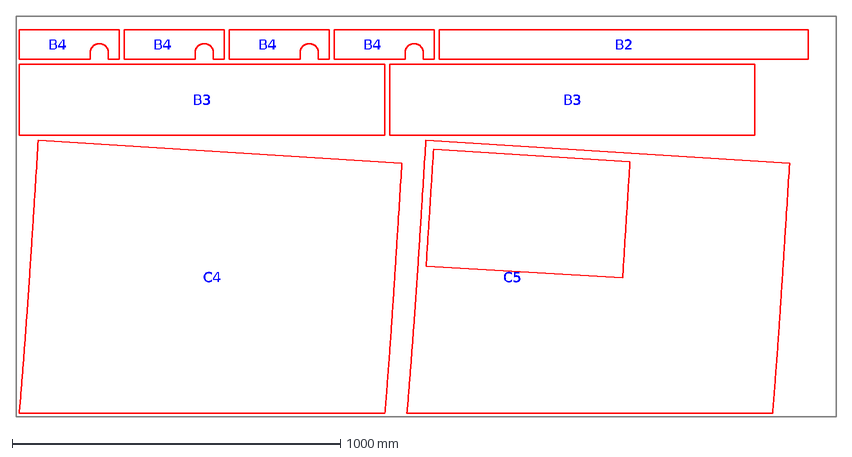
[picture p164: CAD file, 2026-10-05]
plans/dxf/planche_6-A.dxf
C4
C5
B3
B4
B2
