jdb666/cao_hc16/plans/dxf2/chaise_massif.dxf

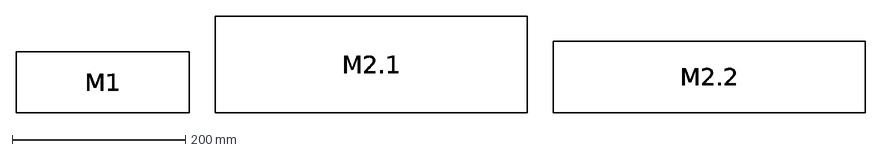
[picture p165: CAD file, 2026-10-05]
plans/dxf2/chaise_massif.dxf
M1
M2.1
M2.2
