jdb666/cao_hc16/plans/dxf3/planche_6-A.dxf

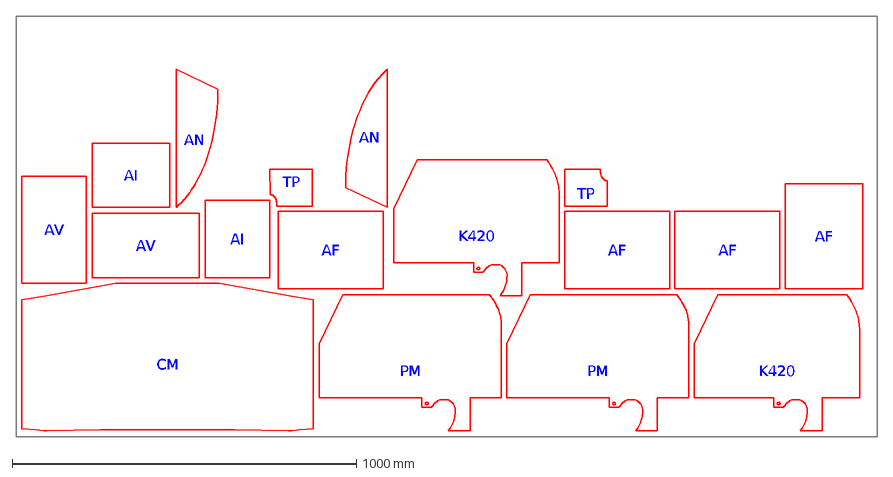
[picture p167: CAD file, 2026-10-10]
plans/dxf3/planche_6-A.dxf
CM
PM
K420
AF
AV
AI
AN
TP
