jdb666/cao_hc16/bundle/plans/dxf/planche_6-C.dxf

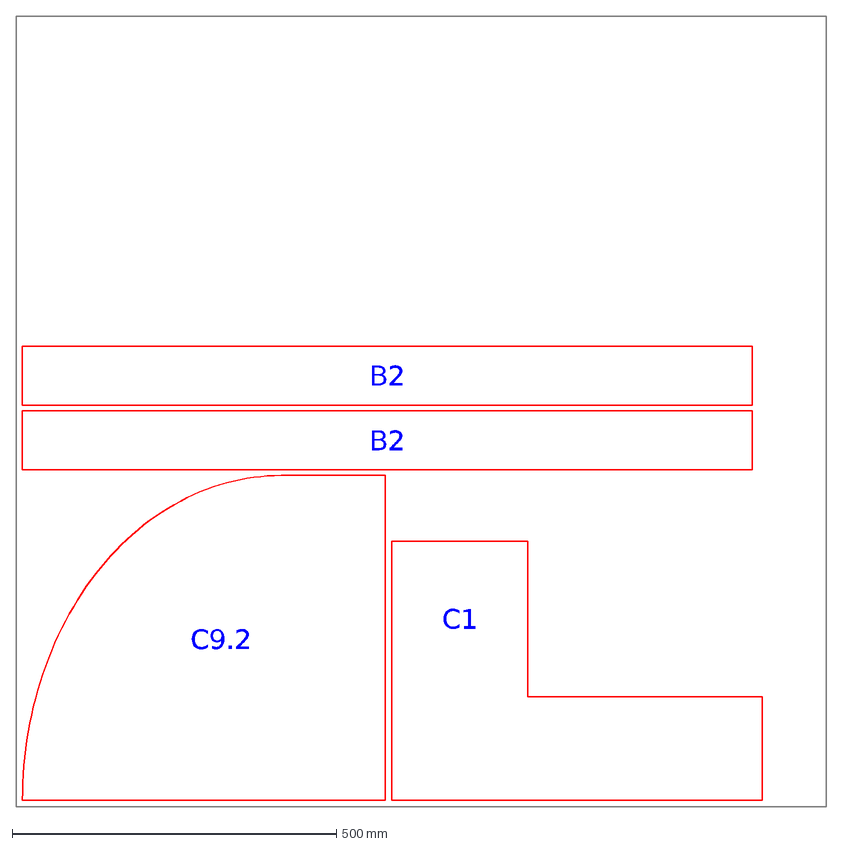
[picture p168: CAD file, 2026-10-05]
bundle/plans/dxf/planche_6-C.dxf
C9.2
C1
B2
