jdb666/cao_hc16/plans/dxf/planche_6-B.dxf

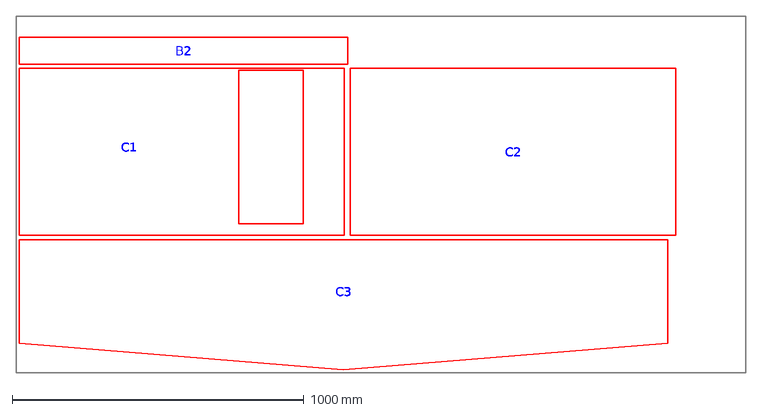
[picture p169: CAD file, 2026-10-05]
plans/dxf/planche_6-B.dxf
C3
C1
C2
B2
