jdb666/cao_hc16/plans/dxf2/planche_6-A.dxf

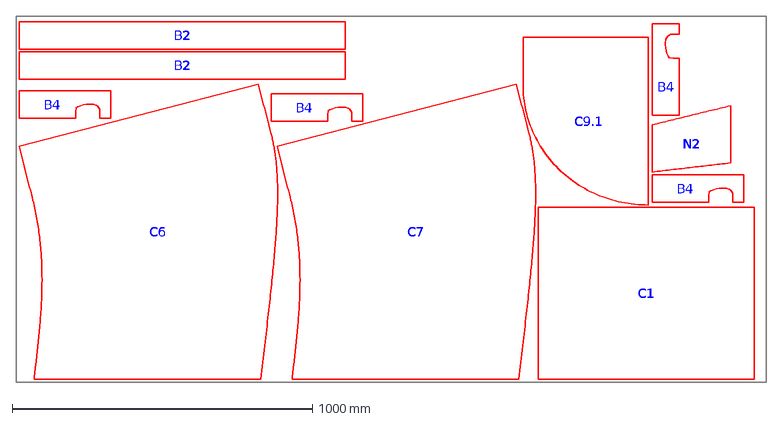
[picture p170: CAD file, 2026-10-05]
plans/dxf2/planche_6-A.dxf
C6
C7
C1
C9.1
B2
B4
N2
