jdb666/cao_hc16/plans/dxf3/pieces/GQ.dxf

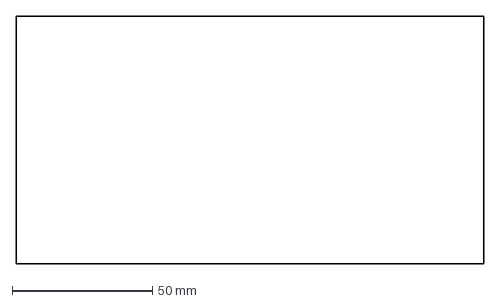
[picture p171: CAD file, 2026-10-10]
plans/dxf3/pieces/GQ.dxf
166.5 x 88.0 mm
