jdb666/cao_hc16/plans/dxf3/planche_4-A.dxf

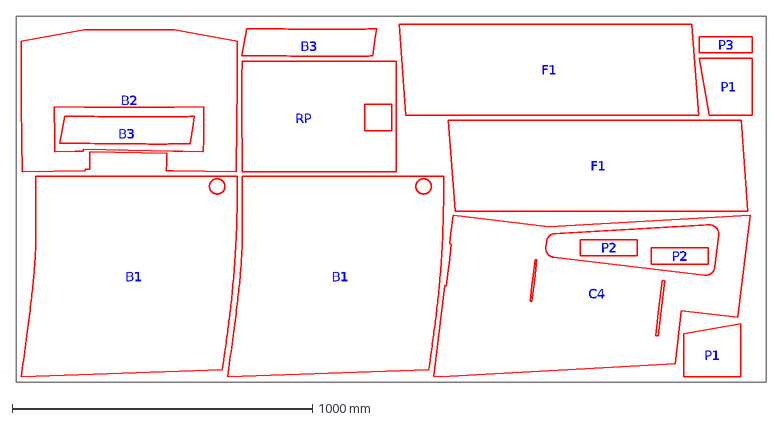
[picture p172: CAD file, 2026-10-10]
plans/dxf3/planche_4-A.dxf
B1
C4
F1
B2
RP
B3
P1
P2
P3
