jdb666/cao_hc16/bundle/plans/dxf/planche_6-A.dxf

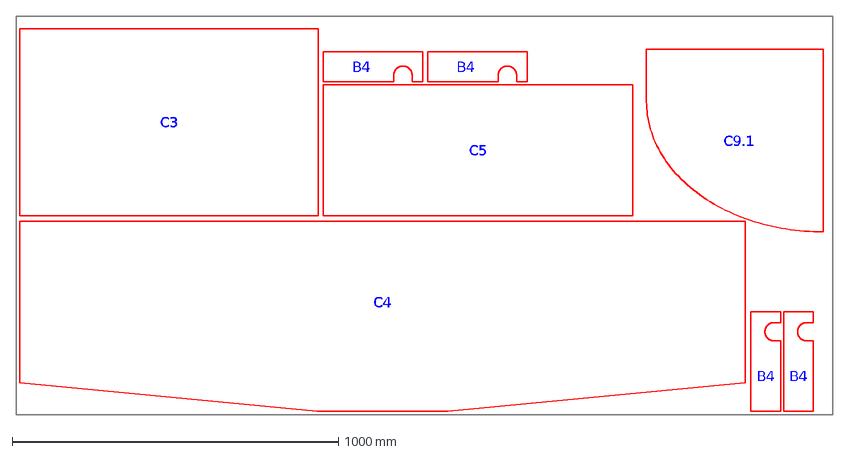
[picture p173: CAD file, 2026-10-05]
bundle/plans/dxf/planche_6-A.dxf
C4
C3
C5
C9.1
B4
