jdb666/cao_hc16/plans/dxf/pieces_massif_CP25.dxf

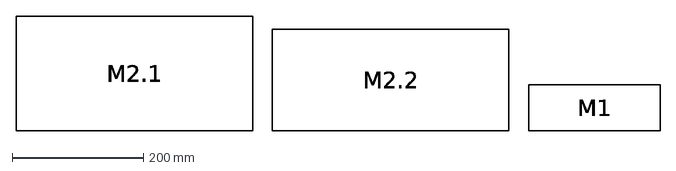
[picture p174: CAD file, 2026-10-05]
plans/dxf/pieces_massif_CP25.dxf
M2.1
M2.2
M1
