jdb666/cao_hc16/plans/dxf2/planche_6-B.dxf

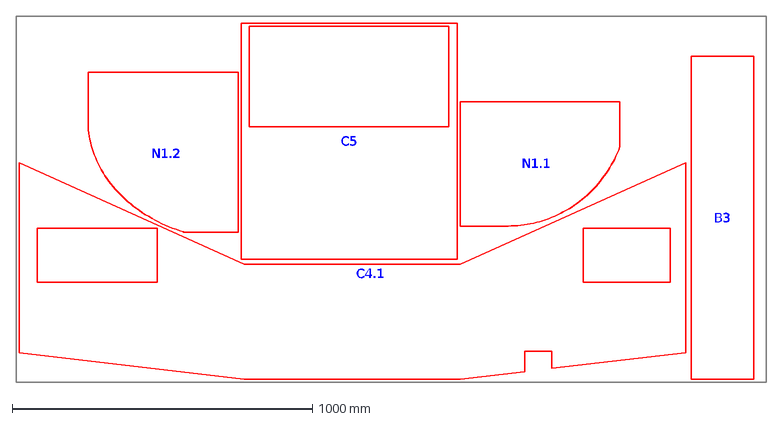
[picture p175: CAD file, 2026-10-05]
plans/dxf2/planche_6-B.dxf
C4.1
C5
B3
N1.2
N1.1
