jdb666/cao_hc16/plans/dxf3/pieces/SM.dxf

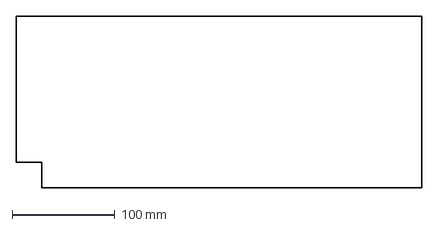
[picture p176: CAD file, 2026-10-10]
plans/dxf3/pieces/SM.dxf
394.0 x 167.0 mm
