jdb666/cao_hc16/plans/dxf3/planche_9-A.dxf

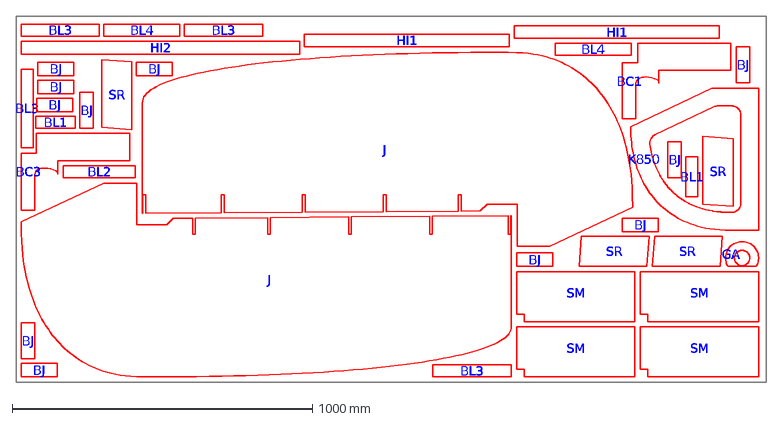
[picture p177: CAD file, 2026-10-10]
plans/dxf3/planche_9-A.dxf
J
SM
K850
HI2
BC3
BC1
SR
HI1
BL3
BL2
BL4
BJ
GA
BL1
