jdb666/cao_hc16/bundle/plans/dxf/chaise_massif.dxf

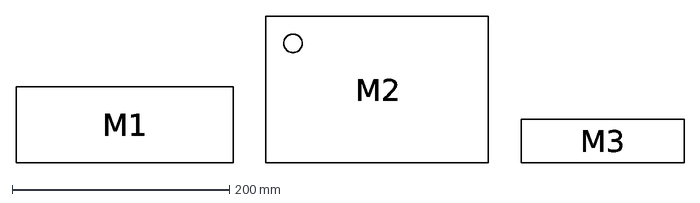
[picture p178: CAD file, 2026-10-05]
bundle/plans/dxf/chaise_massif.dxf
M1
M2
M3
