jdb666/cao_hc16/plans/dxf/planche_6-C.dxf

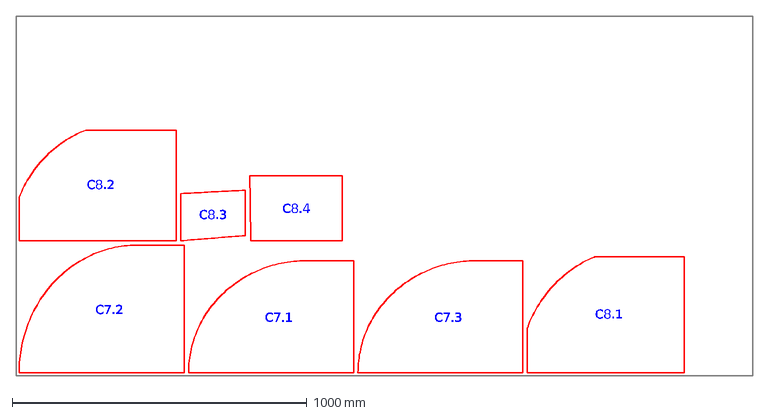
[picture p179: CAD file, 2026-10-05]
plans/dxf/planche_6-C.dxf
C7.2
C7.1
C7.3
C8.1
C8.2
C8.3
C8.4
