jdb666/cao_hc16/plans/dxf2/planche_6-C.dxf

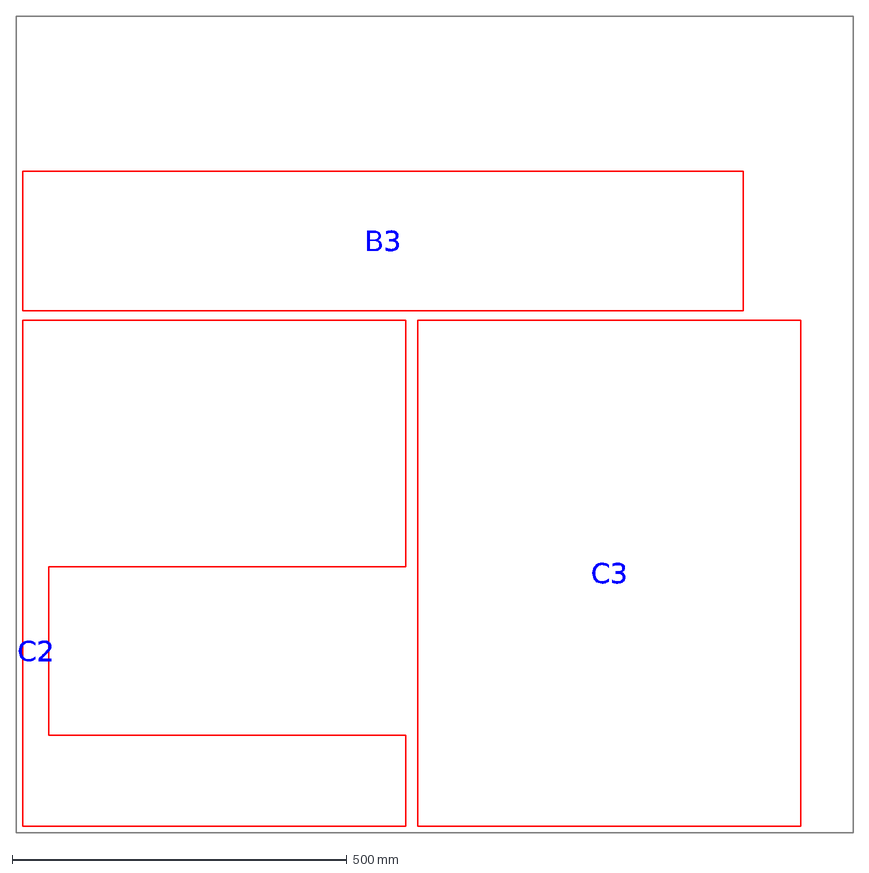
[picture p180: CAD file, 2026-10-05]
plans/dxf2/planche_6-C.dxf
C2
C3
B3
