jdb666/cao_hc16/plans/dxf3/pieces/F3.dxf

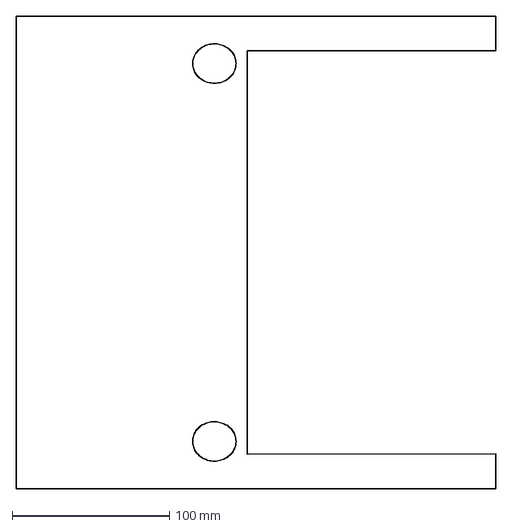
[picture p181: CAD file, 2026-10-10]
plans/dxf3/pieces/F3.dxf
304.7 x 300.1 mm
