jdb666/cao_hc16/plans/dxf3/planche_10-A.dxf

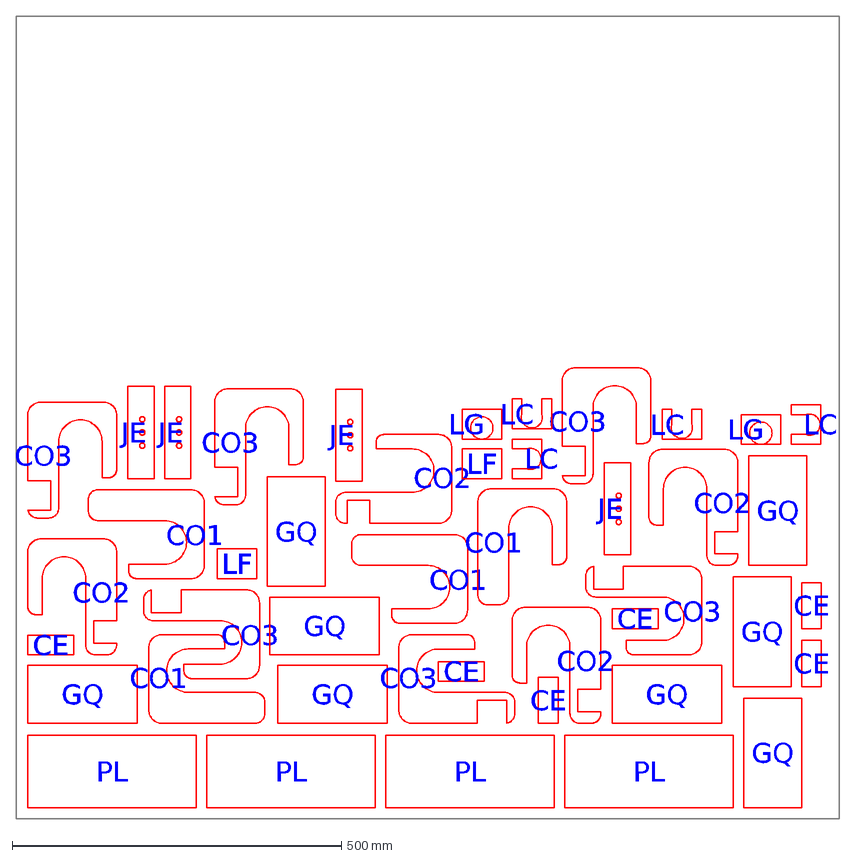
[picture p182: CAD file, 2026-10-10]
plans/dxf3/planche_10-A.dxf
PL
GQ
CO1
CO3
CO2
JE
LF
CE
LC
LG
