jdb666/cao_hc16/plans/dxf2/planche_9-B.dxf

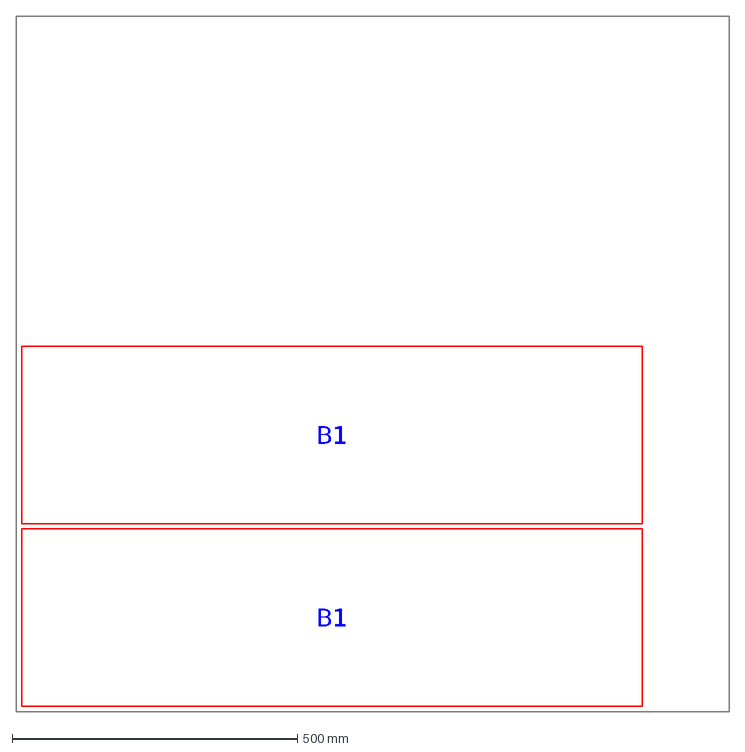
[picture p183: CAD file, 2026-10-05]
plans/dxf2/planche_9-B.dxf
B1
