jdb666/cao_hc16/plans/dxf3/pieces/LF.dxf

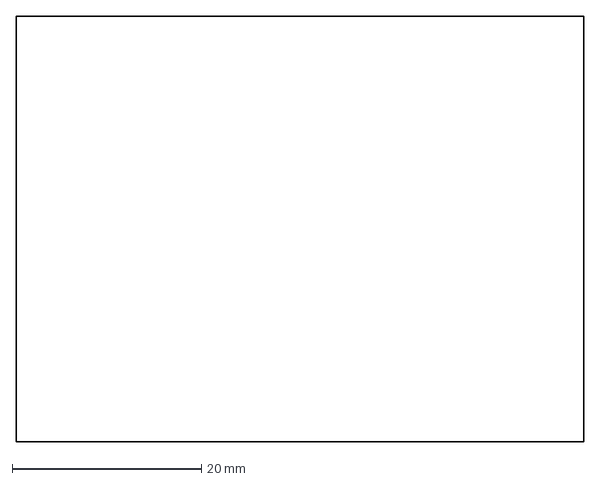
[picture p184: CAD file, 2026-10-10]
plans/dxf3/pieces/LF.dxf
60.0 x 45.0 mm
