jdb666/cao_hc16/plans/dxf3/planche_4-B.dxf

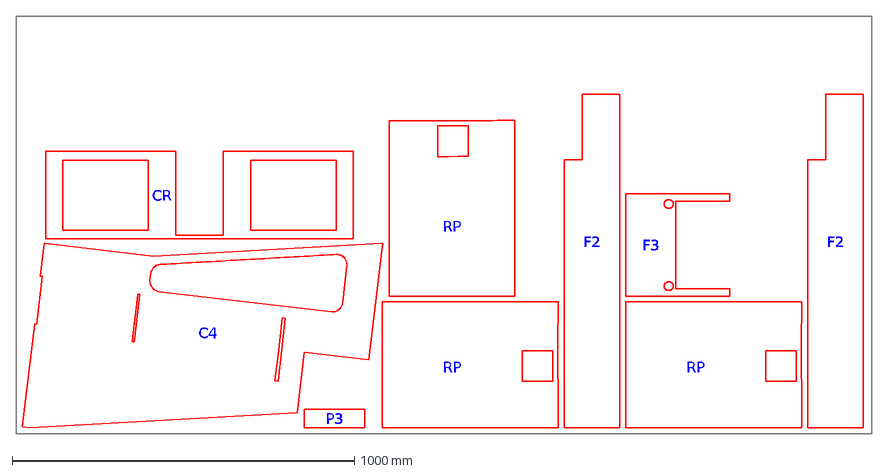
[picture p185: CAD file, 2026-10-10]
plans/dxf3/planche_4-B.dxf
C4
RP
F2
CR
F3
P3
