jdb666/cao_hc16/plans/dxf3/pieces/BC4.dxf

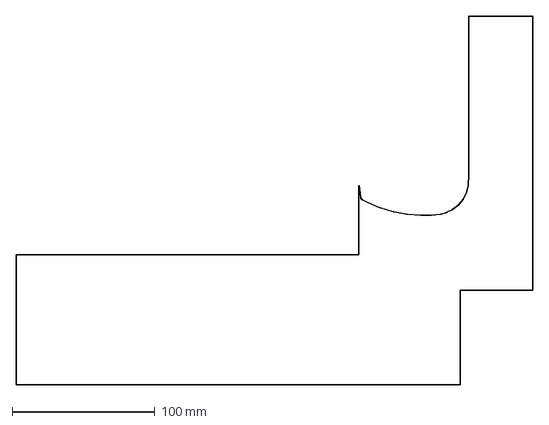
[picture p186: CAD file, 2026-10-10]
plans/dxf3/pieces/BC4.dxf
362.0 x 258.1 mm
