jdb666/cao_hc16/plans/dxf3/planche_6-B.dxf

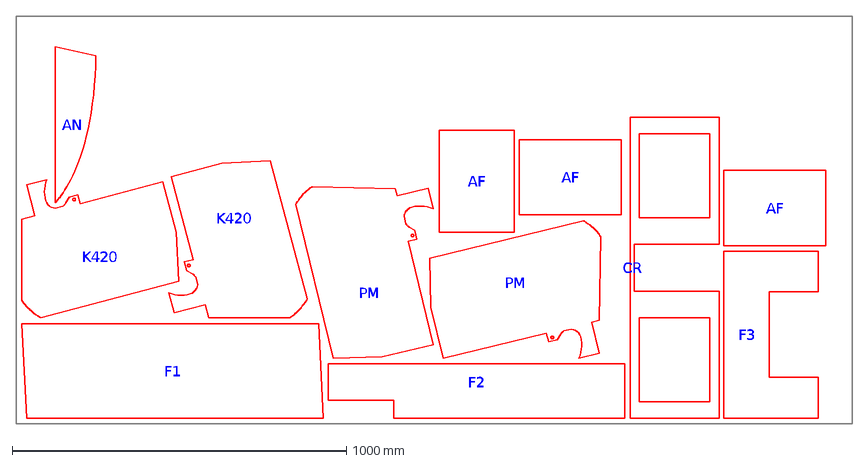
[picture p187: CAD file, 2026-10-08]
plans/dxf3/planche_6-B.dxf
F1
F2
CR
PM
K420
F3
AF
AN
