jdb666/cao_hc16/plans/dxf3/pieces/BC2.dxf

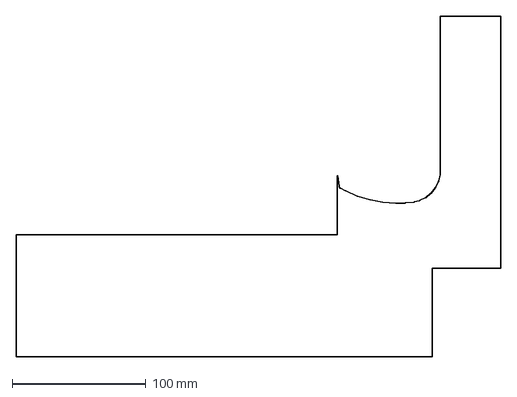
[picture p188: CAD file, 2026-10-10]
plans/dxf3/pieces/BC2.dxf
362.1 x 254.0 mm
