jdb666/cao_hc16/plans/dxf3/planche_6-C.dxf

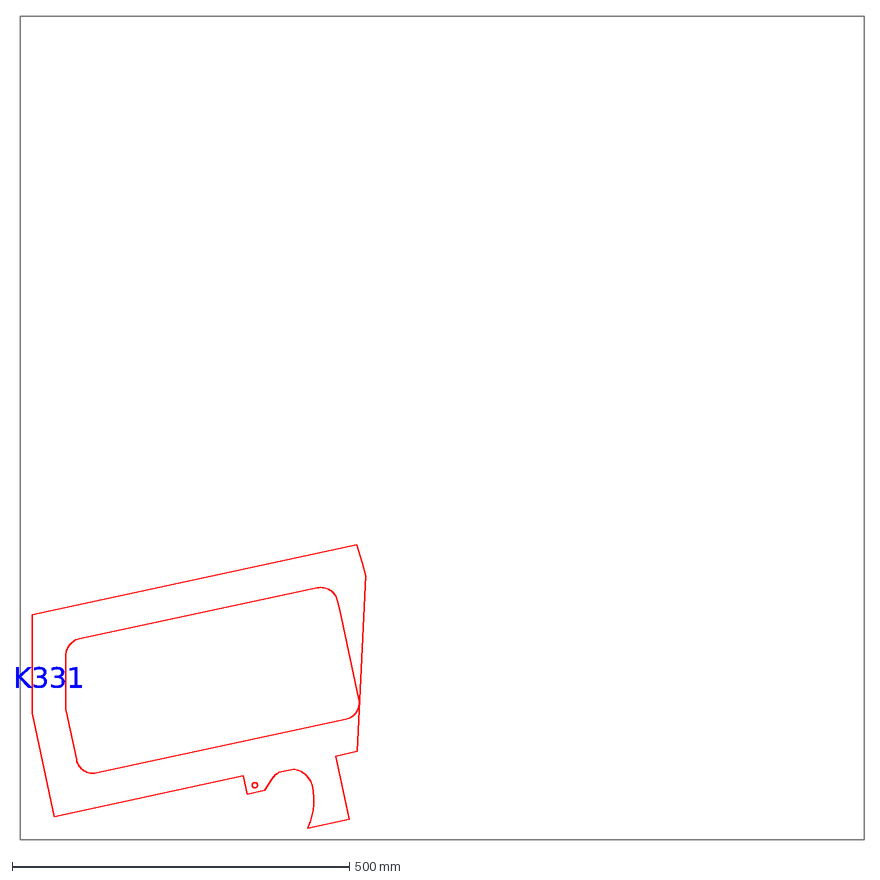
[picture p189: CAD file, 2026-10-06]
plans/dxf3/planche_6-C.dxf
K331
