jdb666/cao_hc16/plans/dxf3/pieces/BC3.dxf

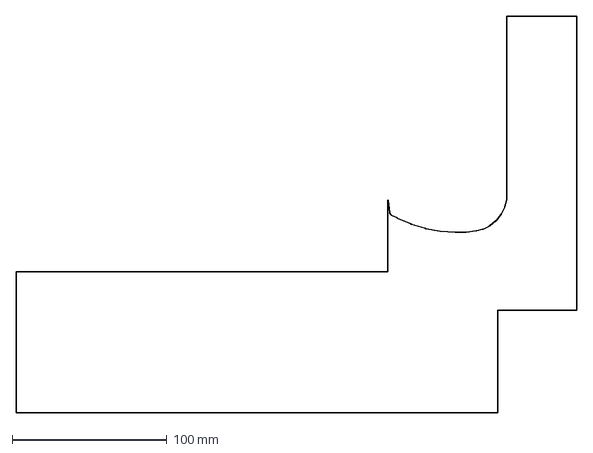
[picture p190: CAD file, 2026-10-10]
plans/dxf3/pieces/BC3.dxf
362.0 x 256.1 mm
