jdb666/cao_hc16/plans/dxf3/pieces/BL4.dxf

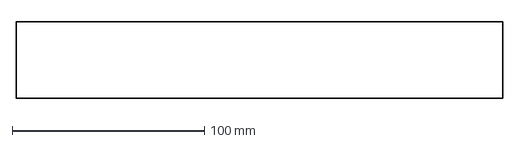
[picture p191: CAD file, 2026-10-10]
plans/dxf3/pieces/BL4.dxf
253.0 x 40.0 mm
