jdb666/cao_hc16/plans/dxf3/pieces/AI.dxf

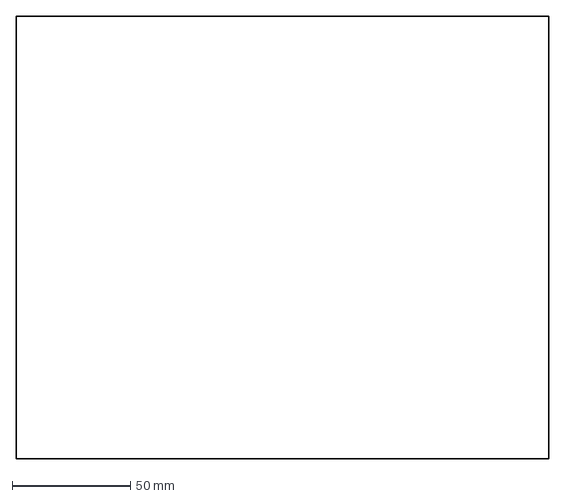
[picture p192: CAD file, 2026-10-10]
plans/dxf3/pieces/AI.dxf
225.0 x 187.0 mm
