jdb666/cao_hc16/plans/dxf3/pieces/CO1.dxf

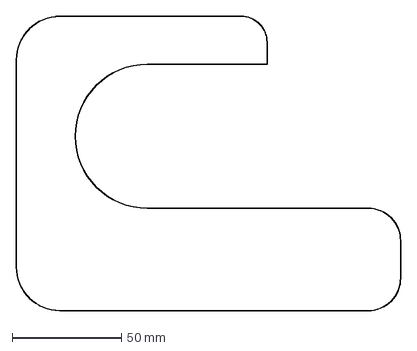
[picture p193: CAD file, 2026-10-10]
plans/dxf3/pieces/CO1.dxf
176.3 x 135.0 mm
