jdb666/cao_hc16/plans/dxf3/pieces/LG.dxf

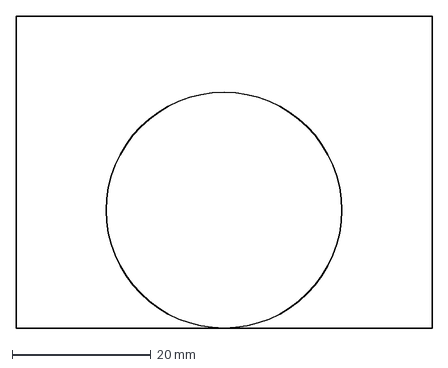
[picture p194: CAD file, 2026-10-10]
plans/dxf3/pieces/LG.dxf
60.0 x 45.0 mm
