jdb666/cao_hc16/plans/dxf3/pieces/P1.dxf

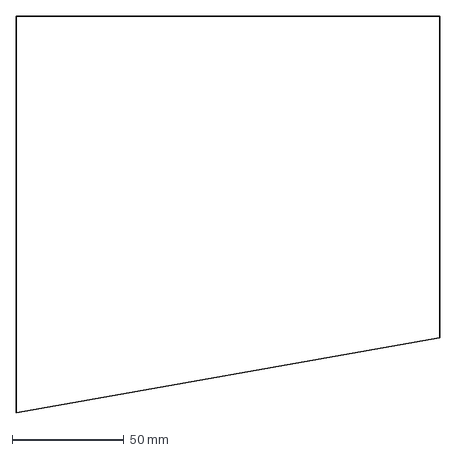
[picture p195: CAD file, 2026-10-10]
plans/dxf3/pieces/P1.dxf
190.0 x 177.6 mm
