jdb666/cao_hc16/plans/dxf3/pieces/B3.dxf

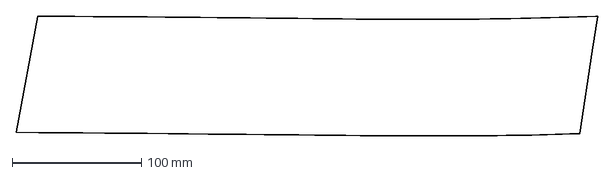
[picture p196: CAD file, 2026-10-10]
plans/dxf3/pieces/B3.dxf
449.2 x 92.7 mm
