jdb666/cao_hc16/plans/dxf3/pieces/BJ.dxf

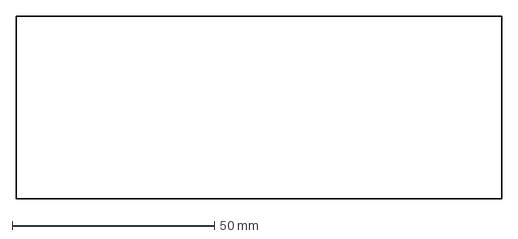
[picture p197: CAD file, 2026-10-10]
plans/dxf3/pieces/BJ.dxf
120.0 x 45.1 mm
