jdb666/cao_hc16/plans/dxf3/pieces/CO3.dxf

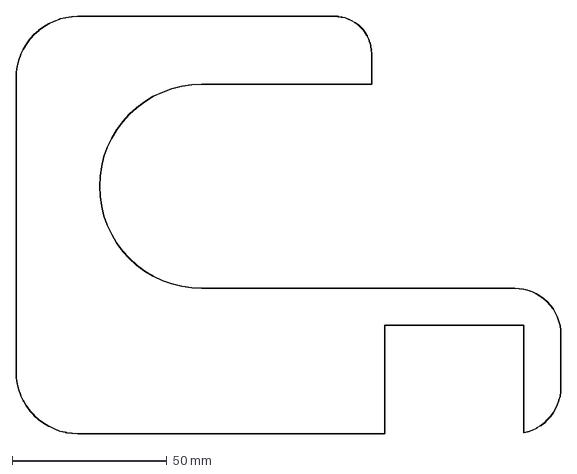
[picture p198: CAD file, 2026-10-10]
plans/dxf3/pieces/CO3.dxf
176.2 x 135.0 mm
