jdb666/cao_hc16/plans/dxf3/pieces/TP.dxf

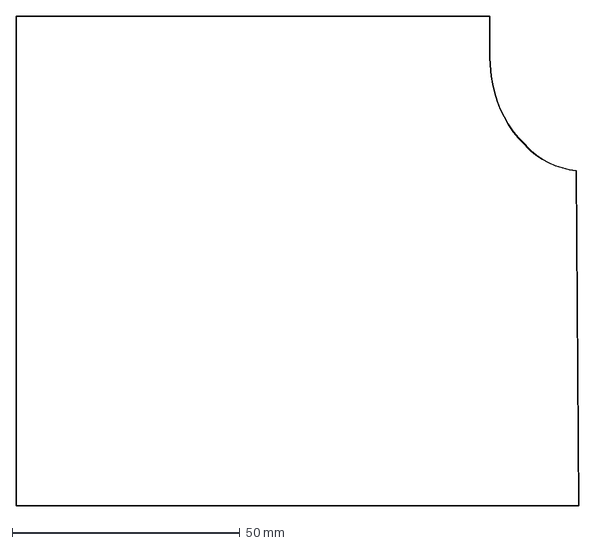
[picture p199: CAD file, 2026-10-10]
plans/dxf3/pieces/TP.dxf
123.4 x 107.5 mm
