jdb666/cao_hc16/plans/dxf3/pieces/BL2.dxf

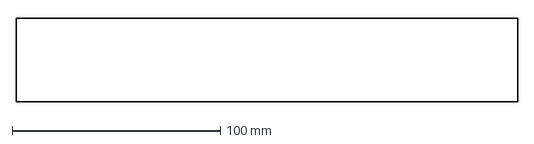
[picture p200: CAD file, 2026-10-10]
plans/dxf3/pieces/BL2.dxf
241.0 x 40.0 mm
