jdb666/cao_hc16/plans/dxf3/pieces/P3.dxf

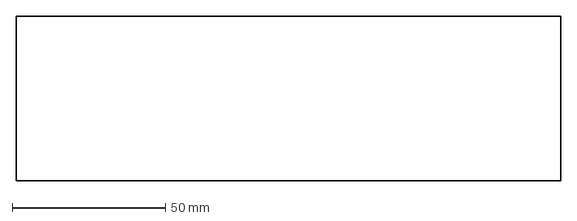
[picture p201: CAD file, 2026-10-10]
plans/dxf3/pieces/P3.dxf
177.6 x 53.5 mm
