jdb666/cao_hc16/plans/dxf3/pieces/PM.dxf

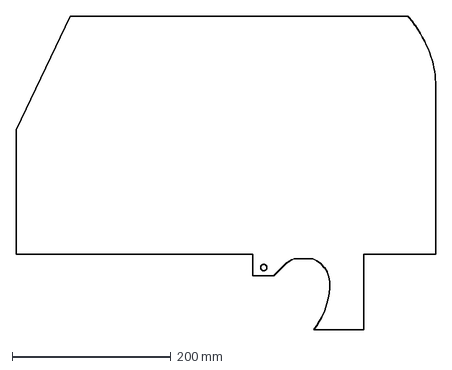
[picture p202: CAD file, 2026-10-10]
plans/dxf3/pieces/PM.dxf
528.0 x 395.0 mm
