jdb666/cao_hc16/plans/dxf3/pieces/F2.dxf

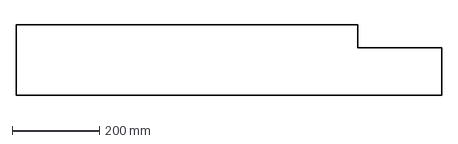
[picture p203: CAD file, 2026-10-10]
plans/dxf3/pieces/F2.dxf
975.8 x 162.5 mm
