jdb666/cao_hc16/plans/dxf3/pieces/AV.dxf

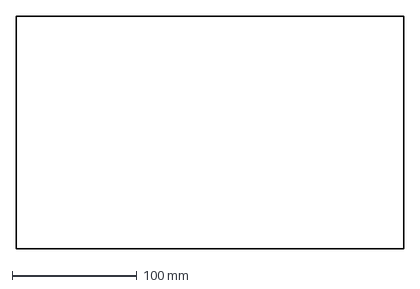
[picture p204: CAD file, 2026-10-10]
plans/dxf3/pieces/AV.dxf
311.0 x 187.0 mm
