jdb666/cao_hc16/plans/dxf3/pieces/LC.dxf

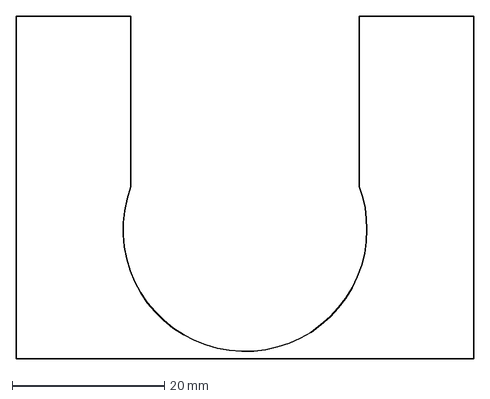
[picture p205: CAD file, 2026-10-10]
plans/dxf3/pieces/LC.dxf
60.0 x 45.0 mm
