jdb666/cao_hc16/plans/dxf3/pieces/HI1.dxf

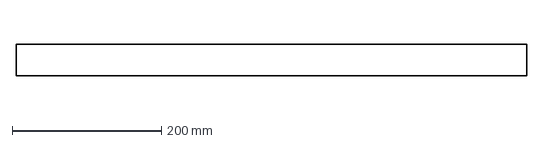
[picture p206: CAD file, 2026-10-10]
plans/dxf3/pieces/HI1.dxf
683.2 x 42.4 mm
