jdb666/cao_hc16/plans/dxf3/pieces/SR.dxf

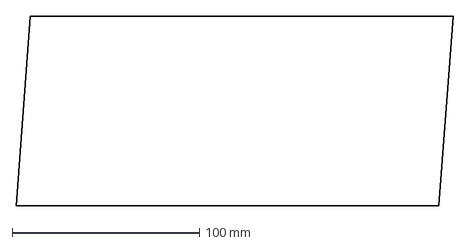
[picture p207: CAD file, 2026-10-10]
plans/dxf3/pieces/SR.dxf
233.6 x 101.3 mm
