jdb666/cao_hc16/plans/dxf3/pieces/RP.dxf

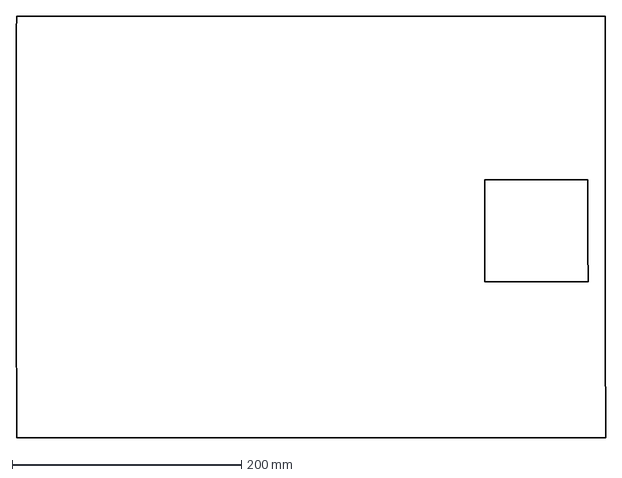
[picture p208: CAD file, 2026-10-10]
plans/dxf3/pieces/RP.dxf
514.7 x 368.2 mm
