jdb666/cao_hc16/plans/dxf3/pieces/CE.dxf

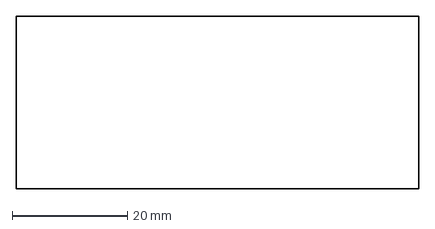
[picture p209: CAD file, 2026-10-10]
plans/dxf3/pieces/CE.dxf
70.0 x 30.0 mm
