jdb666/cao_hc16/plans/dxf3/pieces/PL.dxf

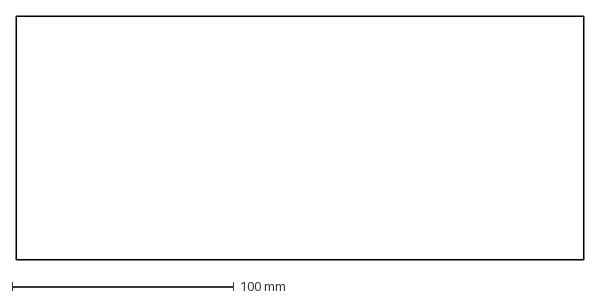
[picture p210: CAD file, 2026-10-10]
plans/dxf3/pieces/PL.dxf
256.0 x 110.0 mm
