jdb666/cao_hc16/plans/dxf3/pieces/F1.dxf

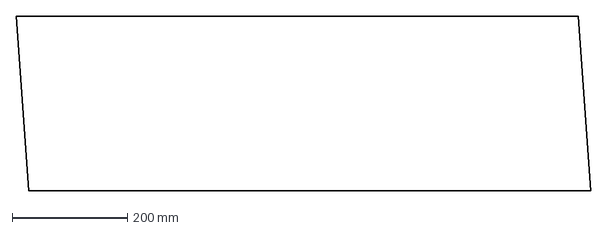
[picture p211: CAD file, 2026-10-10]
plans/dxf3/pieces/F1.dxf
998.2 x 303.7 mm
