jdb666/cao_hc16/plans/dxf3/pieces/JE.dxf

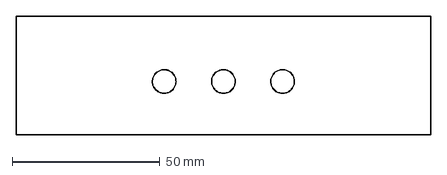
[picture p212: CAD file, 2026-10-10]
plans/dxf3/pieces/JE.dxf
140.1 x 40.0 mm
