jdb666/cao_hc16/plans/dxf3/pieces/AF.dxf

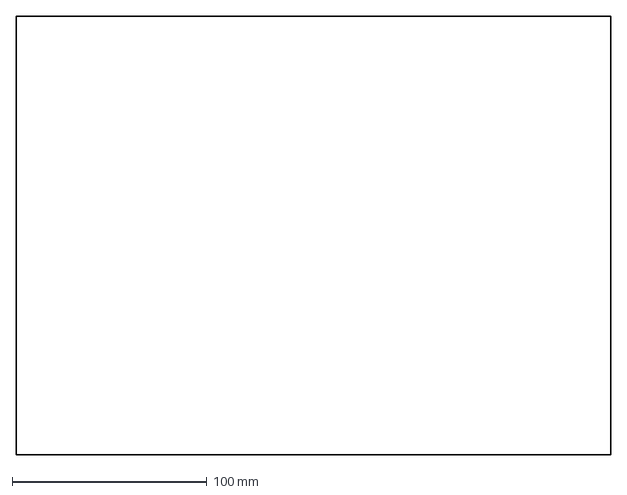
[picture p213: CAD file, 2026-10-10]
plans/dxf3/pieces/AF.dxf
305.0 x 225.0 mm
