jdb666/cao_hc16/plans/dxf3/pieces/J.dxf

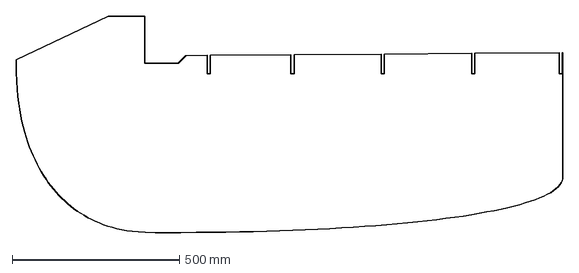
[picture p214: CAD file, 2026-10-10]
plans/dxf3/pieces/J.dxf
1634.1 x 645.6 mm
