jdb666/cao_hc16/plans/dxf3/pieces/P2.dxf

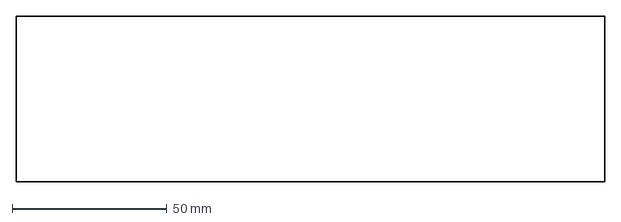
[picture p215: CAD file, 2026-10-10]
plans/dxf3/pieces/P2.dxf
190.0 x 53.5 mm
