jdb666/cao_hc16/plans/dxf3/pieces/AN.dxf

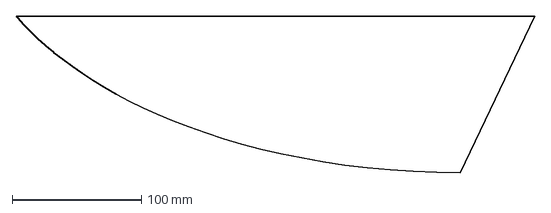
[picture p216: CAD file, 2026-10-10]
plans/dxf3/pieces/AN.dxf
400.9 x 121.0 mm
