jdb666/cao_hc16/plans/dxf3/pieces/B2.dxf

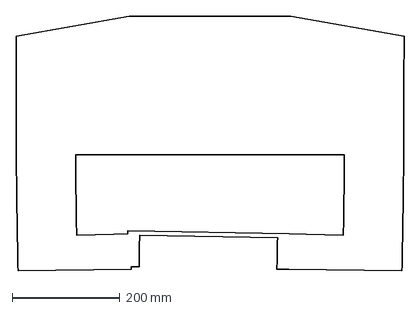
[picture p217: CAD file, 2026-10-10]
plans/dxf3/pieces/B2.dxf
720.0 x 472.5 mm
