jdb666/cao_hc16/plans/dxf3/pieces/BC1.dxf

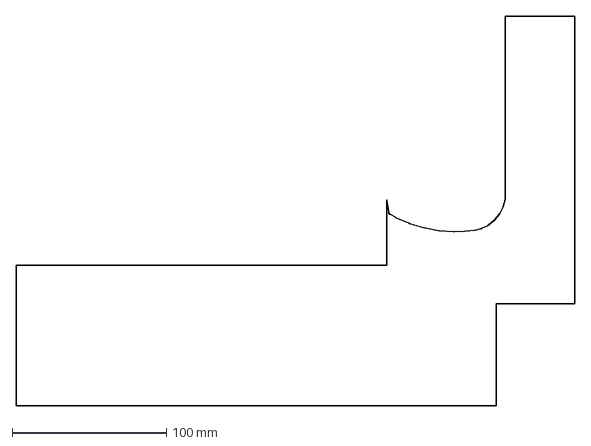
[picture p218: CAD file, 2026-10-10]
plans/dxf3/pieces/BC1.dxf
362.0 x 252.2 mm
