jdb666/cao_hc16/plans/dxf3/pieces/AS.dxf

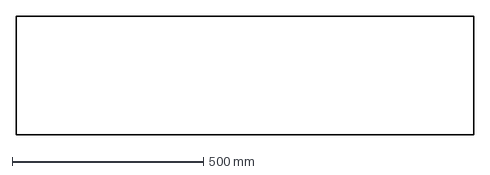
[picture p219: CAD file, 2026-10-10]
plans/dxf3/pieces/AS.dxf
1195.5 x 311.0 mm
