jdb666/cao_hc16/plans/dxf3/pieces/BL1.dxf

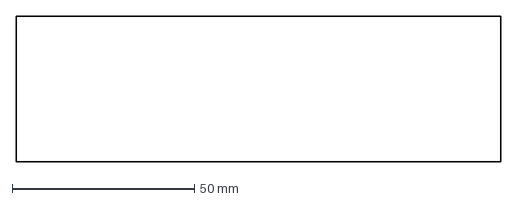
[picture p220: CAD file, 2026-10-10]
plans/dxf3/pieces/BL1.dxf
133.0 x 40.0 mm
