jdb666/cao_hc16/plans/dxf3/pieces/B1.dxf

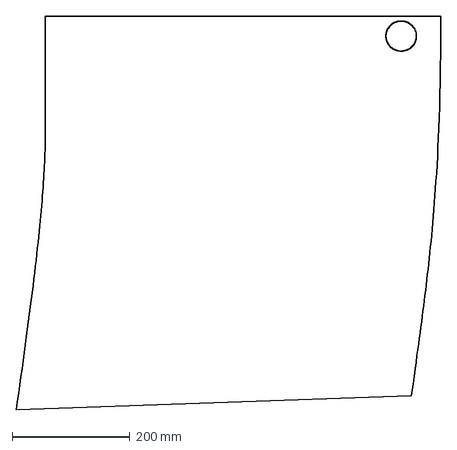
[picture p221: CAD file, 2026-10-10]
plans/dxf3/pieces/B1.dxf
720.6 x 668.9 mm
