jdb666/cao_hc16/plans/dxf3/pieces/K850.dxf

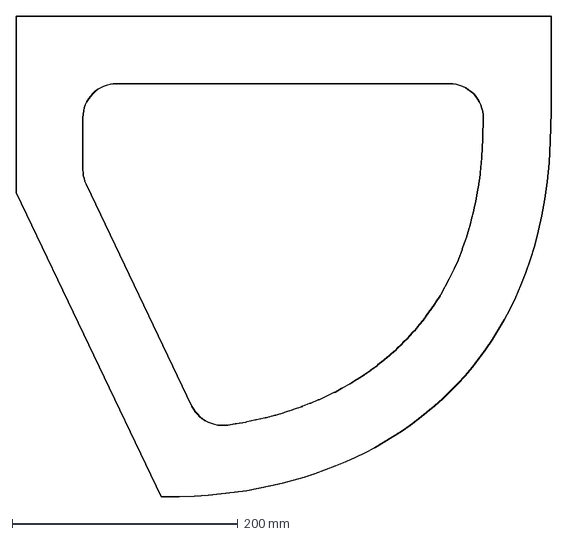
[picture p222: CAD file, 2026-10-10]
plans/dxf3/pieces/K850.dxf
474.4 x 426.5 mm
