jdb666/cao_hc16/plans/dxf3/pieces/C4.dxf

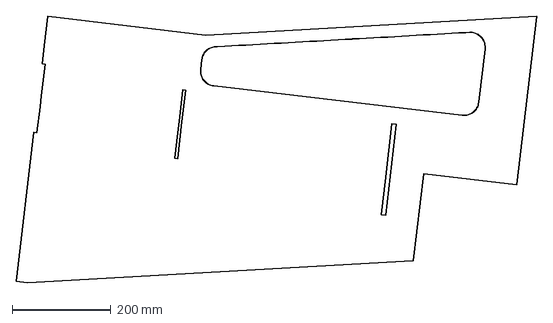
[picture p223: CAD file, 2026-10-10]
plans/dxf3/pieces/C4.dxf
1053.5 x 538.8 mm
