jdb666/cao_hc16/plans/dxf3/pieces/BL3.dxf

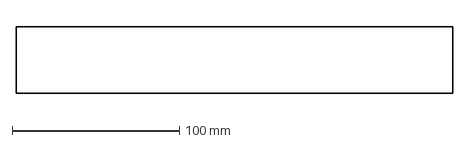
[picture p224: CAD file, 2026-10-10]
plans/dxf3/pieces/BL3.dxf
261.0 x 40.0 mm
