jdb666/cao_hc16/plans/dxf3/pieces/BC5.dxf

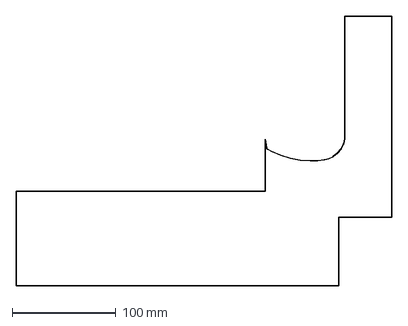
[picture p225: CAD file, 2026-10-10]
plans/dxf3/pieces/BC5.dxf
362.0 x 260.0 mm
