jdb666/cao_hc16/plans/dxf3/pieces/K420.dxf

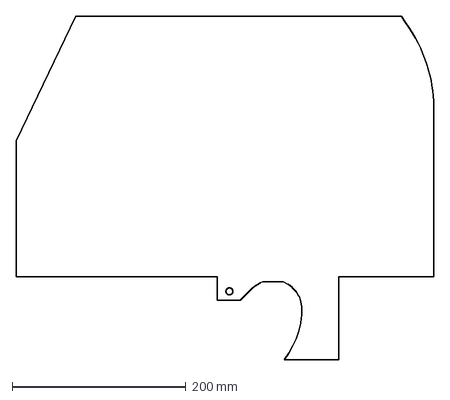
[picture p226: CAD file, 2026-10-10]
plans/dxf3/pieces/K420.dxf
480.4 x 395.0 mm
