jdb666/cao_hc16/plans/dxf3/pieces/HI2.dxf

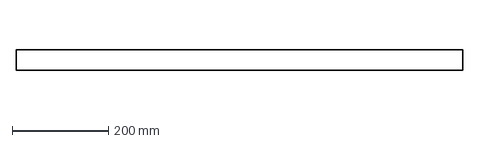
[picture p227: CAD file, 2026-10-10]
plans/dxf3/pieces/HI2.dxf
929.0 x 42.4 mm
