jdb666/cao_hc16/plans/dxf3/pieces/TG.dxf

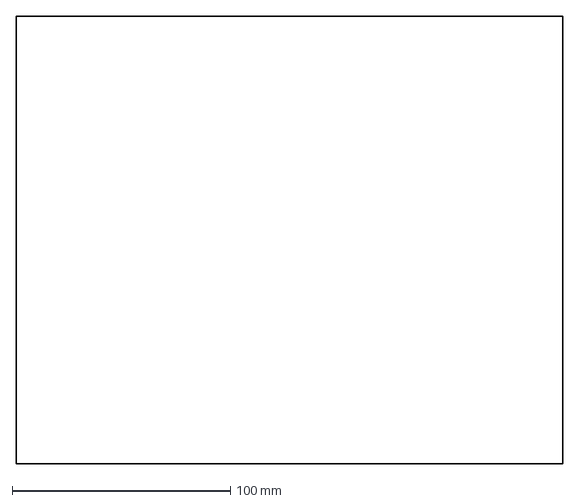
[picture p228: CAD file, 2026-10-10]
plans/dxf3/pieces/TG.dxf
250.0 x 205.0 mm
