jdb666/cao_hc16/plans/dxf3/pieces/CR.dxf

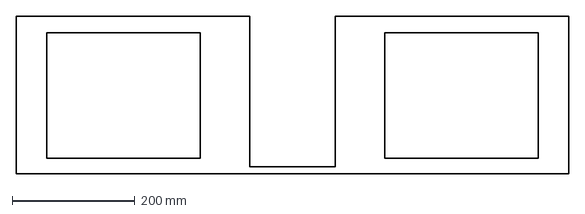
[picture p229: CAD file, 2026-10-10]
plans/dxf3/pieces/CR.dxf
900.0 x 256.5 mm
