jdb666/cao_hc16/plans/dxf3/pieces/GA.dxf

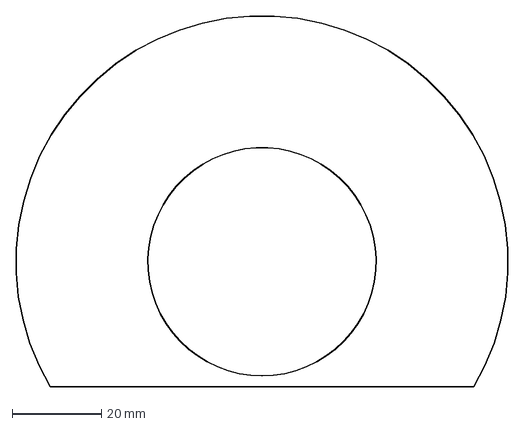
[picture p230: CAD file, 2026-10-10]
plans/dxf3/pieces/GA.dxf
109.9 x 82.9 mm
