jdb666/cao_hc16/plans/dxf3/pieces/GP2.dxf

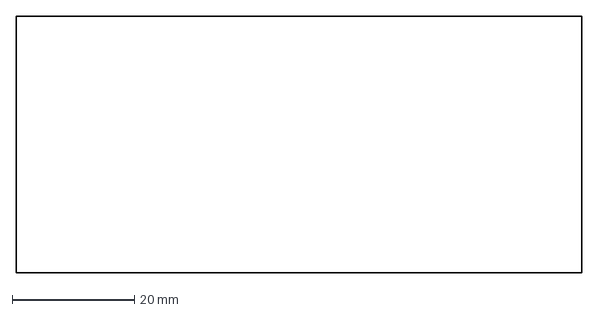
[picture p231: CAD file, 2026-10-08]
plans/dxf3/pieces/GP2.dxf
92.5 x 42.0 mm
