jdb666/cao_hc16/plans/dxf3/pieces/GP3.dxf

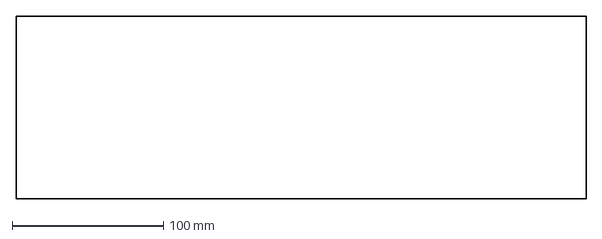
[picture p232: CAD file, 2026-10-08]
plans/dxf3/pieces/GP3.dxf
377.0 x 121.0 mm
