jdb666/cao_hc16/plans/dxf3/pieces/GP4.dxf

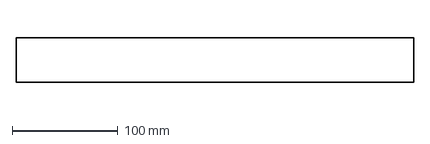
[picture p233: CAD file, 2026-10-08]
plans/dxf3/pieces/GP4.dxf
377.0 x 42.0 mm
