jdb666/cao_hc16/plans/dxf3/pieces/F4.dxf

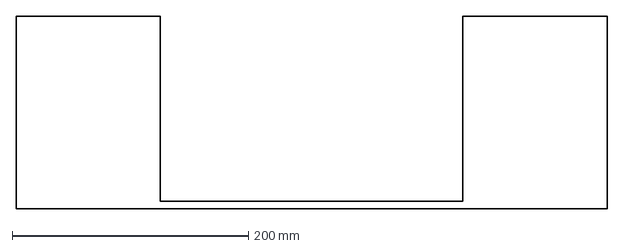
[picture p234: CAD file, 2026-10-08]
plans/dxf3/pieces/F4.dxf
500.0 x 162.5 mm
