jdb666/cao_hc16/plans/dxf3/pieces/B4.dxf

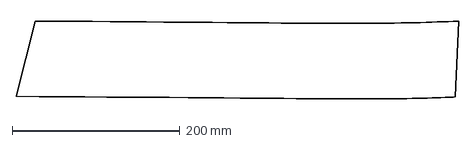
[picture p235: CAD file, 2026-10-08]
plans/dxf3/pieces/B4.dxf
528.2 x 92.8 mm
