jdb666/cao_hc16/plans/dxf3/pieces/K331.dxf

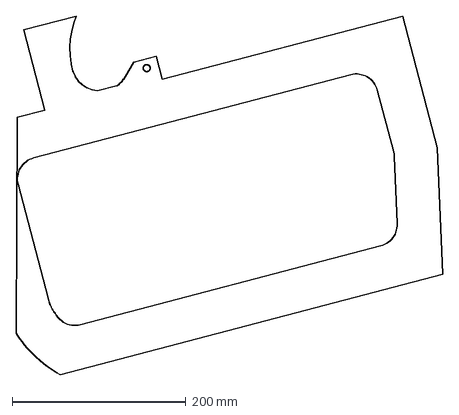
[picture p236: CAD file, 2026-10-07]
plans/dxf3/pieces/K331.dxf
491.3 x 413.3 mm
