jdb666/cao_hc16/plans/dxf3/pieces/F5.dxf

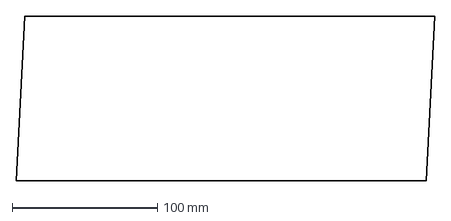
[picture p237: CAD file, 2026-10-07]
plans/dxf3/pieces/F5.dxf
287.9 x 113.2 mm
