jdb666/cao_hc16/plans/dxf3/pieces/BR.dxf

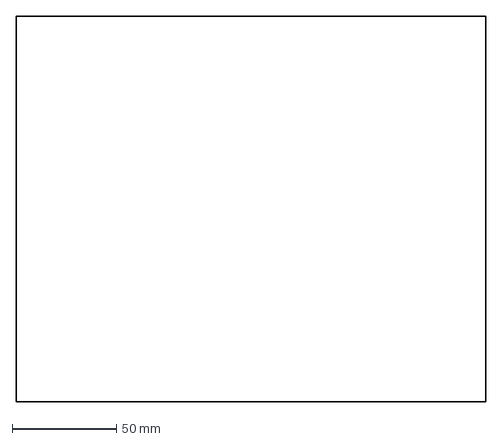
[picture p238: CAD file, 2026-10-07]
plans/dxf3/pieces/BR.dxf
225.0 x 185.0 mm
