jdb666/cao_hc16/plans/dxf3/pieces/BV.dxf

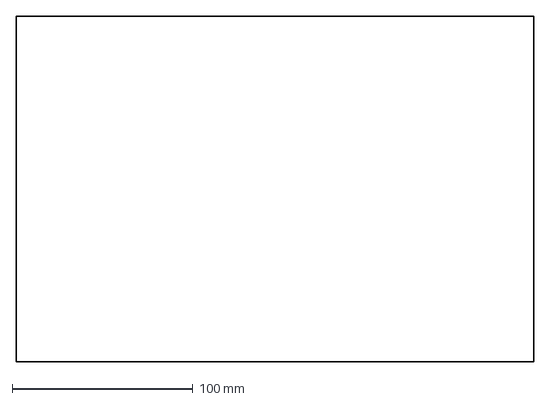
[picture p239: CAD file, 2026-10-07]
plans/dxf3/pieces/BV.dxf
286.0 x 191.0 mm
