jdb666/cao_hc16/plans/dxf3/pieces/BB.dxf

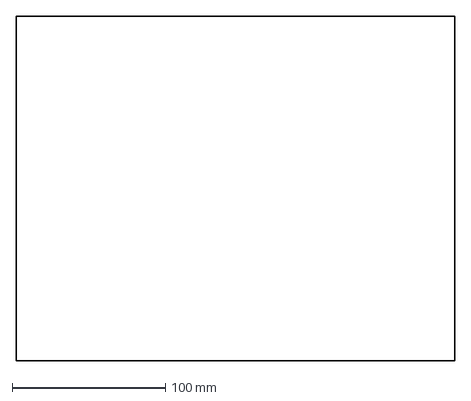
[picture p240: CAD file, 2026-10-07]
plans/dxf3/pieces/BB.dxf
286.0 x 225.0 mm
