jdb666/cao_hc16/plans/dxf3/pieces/CL2.dxf

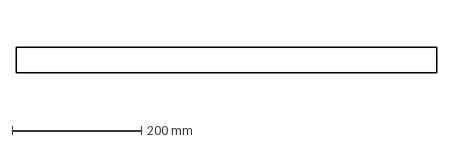
[picture p241: CAD file, 2026-10-06]
plans/dxf3/pieces/CL2.dxf
650.0 x 40.0 mm
