jdb666/cao_hc16/plans/dxf3/pieces/TA.dxf

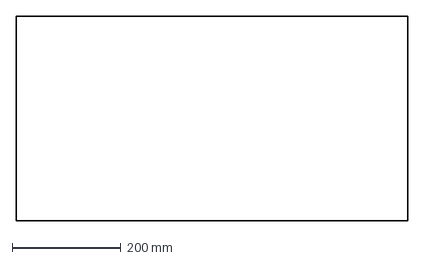
[picture p242: CAD file, 2026-10-06]
plans/dxf3/pieces/TA.dxf
720.0 x 376.0 mm
