jdb666/cao_hc16/plans/dxf3/pieces/CL1.dxf

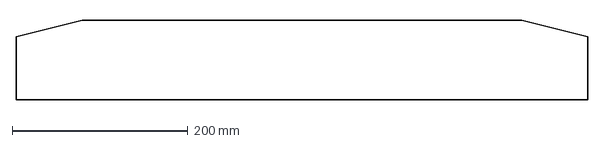
[picture p243: CAD file, 2026-10-06]
plans/dxf3/pieces/CL1.dxf
650.0 x 90.8 mm
