jdb666/cao_hc16/(list of files, cad)

Other CAD files:
plans/dxf_tente/patron_tente_laize1500.dxf
bundle/hc16_rando_moteur_en_marche.step
cata_releve.step
