jdb666/cao_hc16/cotes.yaml

# HC16 + gréement Rando, mâts posés sur le pont — sans coffre
# Repère : origine = étrave à la flottaison, dans l'axe du bateau
#   X vers l'arrière, Y vers bâbord, Z vers le haut. Unités : mm.
# Source : profil et plan F. Chevalier recalés (±30 mm), plan Rando (JD).

coques:
  longueur: 5050           # P1 (relevé 28/09/2026)
  entraxe: 2000            # V1 = A1 : axe à axe des coques, aux deux poutres
  quille:        [[0,420],[150,120],[500,-54],[1000,-143],[1500,-188],[2400,-188],[3200,-143],[4200,-54],[5050,60]]   # Chevalier, creux recalé sur P6 (500 à la poutre AV)
  pont:          [[0,450.0],[500,398.1],[1000,351.1],[1500,324.2],[2000,312.3],[2500,310.3],[3000,318.4],[3500,326.5],[4000,339.6],[4500,357.6],[5000,378.7],[5050,380.0]]   # P7 : cordeau étrave (450) -> tableau (380) moins les flèches relevées
  demi_largeur:  [[0,4],[300,70],[800,140],[1500,187],[2500,199],[3500,193],[4500,175],[5050,152]]   # Chevalier ×1,168 : D3 = 190 au pied de mât
  bouge_pont: 35           # bombé : la ligne "pont" est le dessus du bombé, dans l'axe (non relevé : V7)

plateforme:
  poutre_av_x: 2070        # P2
  poutre_ar_x: 4145        # P3 = 4 140 et D1 = 2 080 : 4 145
  poutre_av_z: 539.5       # axe aux bouts ; P5 : dessus du longeron 250 au-dessus du pont au pylône AV
  poutre_ar_z: 524         # A3 : dessus de la poutre AR 210 au-dessus du pont
  poutre_z: 532            # moyenne (utilisée par le coffre tant qu'il n'est pas recalé)
  poutre_av_fleche: 100    # V2 : dessus au milieu − dessus au ras des pièces d'angle
  poutre_av_y_libre: 925   # parabole entre les pièces d'angle (ajustement sur photo de face, écart rms < 1 px), droite au-delà
  poutre_axe_u: 16.5       # D5 = 2 170 (face AV poutre AV → face AR poutre AR) : l'axe relevé passe 16,5 derrière le centre du nez, au milieu de la section
  poutre_diam: 62          # nez du profil en goutte (DWG)
  poutre_longueur: 2080    # bouts dans les pièces d'angle (y ±1 040), le longeron passant à l'extérieur
  longeron_y: 1093         # D2 : 2 230 entre faces extérieures des longerons (28/09) → axe du nez à 1 115 − 22
  longeron_dans_pieces: 60 # le longeron entre de 60 dans chaque pièce d'angle
  longeron_diam: 44        # nez du profil en goutte (DWG)
  pylone_diam: 70          # non relevé
  piece_angle:             # pièces d'angle poutre / longeron, d'après les photos du 28/09 (cotes approchées)
    y_int: 925               # face intérieure (A2 = 1 850)
    y_ext: 1122              # nez arrondi : 7 au-delà de la face extérieure du longeron
    y_nez: 1040              # le nez couvre y 1 040 → y_ext
    y_pylone: 1000           # emboîture sur le pylône (axe de coque)
    manchon: 54              # manchon de poutre : ±54 autour de l'axe relevé (poutre 95,5 + parois)
    manchon_demi_h: 40
    nez_x: 97                # le nez dépasse de 97 devant l'axe de la poutre AV (derrière pour l'AR) : ≈ 50 devant la face de la poutre, à confirmer (D6)
    nez_x_fin: 5             # le nez s'arrête 5 devant l'axe : le longeron sort de la pièce
    nez_demi_h: 35
    nez_r: 35
    bossage_d: 84
    bossage_bas: 58          # bas de l'emboîture sous l'axe de poutre
  trampoline_z: 580        # au centre du trampoline (bord avant sur la poutre cintrée, bord arrière à 524)
  trampoline_milieu: {jeu: 20, pas: 150, diam: 4}   # (JD 09/10) deux moitiés lacées au milieu, dans la longueur : l'eau s'en va par l'arrière toute seule
  martingale:              # V4, V5 (28/09/2026) ; pilier + deux tiges inox rigides (pas des câbles)
    pied_sous_axe_extremites: 170   # V4 : bas du pilier sous l'axe de la poutre aux extrémités
    y_cable: 1000                   # V5 : attaches des tiges à 1 000 de l'axe du bateau (axe des coques)
    cable_sous_axe_extremites: 49   # (ancien paramètre) remplacé par le jour ci-dessous
    jour_sous_poutre: 15            # V5 : jour de 15 entre le dessous de la poutre et la tige, au ras de la pièce d'angle (confirmé photo)
    y_jour: 925
    tige_diam: 6                    # Ø des tiges inox : non relevé

mats:
  x_pied: 1960             # (JD 06/10 : réaligner les CV) CV voiles pleines = CV du HC16 d'origine par la même méthode (contours, rond compris : x 3 206) ; 1 766 avant (aligné sur 3 010, un CV de triangles)
  y_axe: 1161              # (JD 06/10 : gréement indépendant du coffre) largeur/2 + diam/2 + 11 : 11 de jeu à la joue pour le mât qui tourne ; bord du mât au bord du pont (1 190), la paroi de coque reprend l'effort vertical (JD 29/09) ; avant : 1 151, à 1 de la joue
  z_pied: 345.4            # dessus de la semelle CP au pied de mât : renfort de pont 8 + bourrage 3 mini (pente P4) + CP 18 (348,1 à x 1 766, avant le recul)
  collier_hauteur: 750     # référence du coffre : les joues montent à 25 au-dessus (z 1 122) ; le collier lui-même est au-dessus des joues (mats.collier)
  collier:                 # (JD 06/10) collier indépendant du coffre : bague où le mât tourne, tourillon emmanché dans le tube (il tourne quand on change de cran), attaches des haubans
    jeu_joue: 10           # dessous du collier à 10 au-dessus du haut des joues (hauteur calculée ; ou `hauteur` le long du mât depuis le dessus de semelle)
    ep: 70                 # (JD 06/10 soir) CP collé stratifié : 7 plis de CP 10 collés à l'époxy, verre-époxy dessus (arêtes arrondies) ; ferrures inox boulonnées à travers, contre-plaques
    materiau: cp
    plis: 7
    alesage: 62            # le mât Ø 60 tourne dans une chemise PEHD de 2 (fendue, emboîtée, vissée : le PEHD ne se colle pas) dans l'alésage du CP (Ø 66) et le long de l'ouverture
    chemise: 2
    r_bague: 55
    nez: 60                # avant du collier, devant l'axe du mât (105 quand le tube était devant)
    demi_y_int: 80         # face intérieure (côté tube) à 80 de l'axe du mât : la branche intérieure va jusqu'au tourillon, derrière le mât
    tourillon_bord: 12     # matière derrière le tourillon
    ouverture_ar: true     # (JD 06/10) ouvert vers l'arrière pour poser le mât (il arrive par l'arrière en se relevant sur l'emplanture), largeur = alésage
    arriere: 55            # bout des branches derrière l'axe du mât
    axe: {d: 10, s: 38}    # axe inox de fermeture derrière le mât, à travers les deux branches, goupillé
    demi_y: 55
    tourillon: {d: 45, l: 80, jeu_tube: 3, prise: 35}   # tube alu Ø 45 collé à l'époxy dans une encoche des plis 2 à 6 (35 de prise), goupillé à travers les plis ; dépasse de 80 dans le tube Ø 50 × 2
    oeil: {saillie: 22, ep: 6, h: 24, dy_av: 40, dy_croise: -30, ar: [20, 70]}   # ferrures inox boulonnées : devant (direct AV à 40 vers l'extérieur ; croisé AV à 30 vers l'intérieur, loin de la livarde rangée) ; AR sur la face extérieure, de 20 à 70 derrière l'axe du mât (JD 06/10 : le hauban AR reste à l'extérieur du mât) ; diagonale en haut de la face intérieure
  emplanture:               # (JD 06/10) cale triangulaire dans un rail U sur la semelle ; le mât tourne sur l'ergot ; la quête se règle au trou du boulon
    rail: {type: joues_cp, l: 140, joue_ep: 10, h: 40, jeu: 0.5, trou: 8, pas: 20, crans: [-1, 0, 1], axe_z: 18}   # (JD 08/10 soir) 3 crans au lieu de 5 : joues de 140 (180 avant)
    # avant le 08/10 soir : l 180, crans [-2, -1, 0, 1, 2]   # (JD 06/10 soir) deux joues CP 10 collées sur la semelle et stratifiées, trous Ø 8 tous les 20 (surpercés, remplis d'époxy, repercés), axe du boulon à 18 au-dessus de la semelle
    cale: {haut: 70, pointe: 6, pointe_z: 7, h: 38, larg: 30, plis: 3}   # (JD 06/10 soir) 3 plis de CP 10 collés, stratifiés ; triangle pointe en bas : elle pivote sur le boulon (quête, pose du mât), le boulon la tient ; dessus 70 de long à 45 au-dessus de la semelle
    ergot: {d: 20, h: 20}   # sur le dessus de la cale ; le pied du mât (embout percé) tourne dessus ; mât raccourci de 45 pour garder la bordure
  longueur: 7300
  diam: 60
  quete_deg: 3
  haubanage: 700           # le long du mât, depuis le pied
  semelle:                 # plat CP collé au pont sur bourrage époxy, perpendiculaire au mât, parallèle au collier CP (JD 28/09)
    y_mat: 1161            # axe du mât : 161 à l'extérieur de l'axe de coque (1 151 avant le 06/10)
    dx: [-304, 90]         # (JD 08/10 soir) une seule semelle par bord pour le mât et les deux tubes du coffre : x 1 656 → 2 050 (plus de pontets au bout)
    # avant : dx: [-100, 150]        # autour du pied de mât (x_pied) : x 1 860 → 2 110, 14 derrière la semelle des tubes du coffre ; à 10 du pylône de la poutre AV
    dy: [-141, 26]         # y 1 020 → 1 187 (tubes du coffre à y 1 066)
    encoche: {dx0: 65, dy1: -116}   # coin arrière intérieur échancré au pylône de la poutre AV : x ≥ 2 025 et y ≤ 1 045 (10 de jeu)
    # avant : dy: [-116, 26]         # côté bâbord (miroir à tribord) : y 1 045 → 1 187 (joue extérieure de l'emplanture CP), 10 de jeu au pylône de la poutre AV ; reçoit le rail de l'emplanture et les pontets (les tubes du coffre ont leurs semelles : coffre.pylones.semelle)
    ep: 18                 # 2 × CP 9 collés
    bourrage_min: 3
    inclinaison_laterale: 0   # mât vertical en travers ; la quête (quete_deg) et l'inclinaison sont fixées par la semelle et le collier
    pente_pont_p4: 2.13    # pente locale du pont retenue au pied de mât (P4 + assiette 0,43°), au lieu de 1,32° pour la tonture du modèle
    renfort:               # renfort de pont cintré sur toute la largeur (JD 29/09) : 2 plis croisés de CP 4 collés en place
      ep: 8
      dx: [-344, 170]      # de 150 devant les tubes du coffre (x 1 616) à 20 derrière la semelle du mât (x 2 130)
      demi_y: 186          # toute la largeur du pont (demi-largeur 190)
      evite: pylone_av     # découpé autour du pylône de la poutre AV (10 de jeu)

voile:                     # repère du mât : u perpendiculaire vers l'arrière, w le long du mât depuis le pied
  contour: [[0,1123],[2839,1603],[2295,3587],[1575,5363],[823,6803],[0,7163]]   # plan Rando 1/25 : amure, écoute, rond de chute, têtière
  livarde:                 # tube carbone droit, d'un seul côté de la voile, du mât (5,10 m sous la têtière) au point d'écoute (JD 29/09)
    w_mat: 2060
    diam: 30
    ep: 1.5
    jeu_mat: 5
    rangee: auto           # auto : rangée dès que la voile est roulée, même en partie
    rangement: {vertical: true}          # rangée debout, verticale, dans le fourreau du coffre (coffre.fourreaux_livarde, JD 30/09) : loin du mât pour ne pas gêner l'enroulement
                                         # (ancienne place : {dx: 85, dy: 0, dw: 800}, parallèle au mât, pied dans un godet sur l'avant du collier)
  enroulement: {babord: 0.5, tribord: 0.5}      # part de surface enroulée : 0 = pleine, 1 = roulée

coffre:                    # joues ellipsoïdales (pointe avant du coffre, collier, bout arrière du banc) ; coffre sous la joue ; CP cousu-collé
  largeur: 2240            # joues à ±1 120 : mâts à ±1 151, tout près du bord du pont ; joues au-dessus du nez des longerons (±1 115)
  face_ar_x: 2022.5        # C4 contre le nez de la poutre AV, sans jour (JD 29/09) ; poches dans les coins arrière pour le nez et le manchon des pièces d'angle
  poches_pieces_angle: {jeu: 4, ouverte_dessous: true}   # ouverte dessous (JD 30/09) : le coffre se pose par-dessus ; avant, le fond fermait la poche et la pièce d'angle bloquait la pose   # coins arrière du coffre évidés autour des pièces d'angle AV (nez jusqu'à x 1 973, manchon dès x 2 016), parois CP comme le bordé
  fond_z: 270              # (JD 09/10, moustache à 10°) fond remonté de 20 : aileron relevé au ras (274), hélice 26 au-dessus ; avant : 250
                           # fond polygonal à 3 segments : plat au milieu ; puits moteur descendu sous l'hélice relevée (JD 29/09 : hélice à 296, aileron à 274)
  fond_plat_demi: 150       # (JD 09/10) plat réduit à ±150 (puits ±134 + parois) : le V à 10° part plus près du milieu et reste haut au-dessus des coques ; avant : 250
                            # plat C1 de 500 ; au-delà, le V remonte aux joues et reste 19 au-dessus des haubans croisés AR (z 342 au droit de C4, y ±704)
  avant_plat_demi: 360      # pointe du fond : x 1 250 sur ±360, raccord droit jusqu'aux joues (forme de l'avant inchangée)
  fond_z_cotes: 439.4      # (JD 09/10) moustache : fond à 10° vers les joues, comme le dessus (270 + 961 × tan 10°) ; avant : 465 (14°)
  fond_pente_cotes_deg: 10 # (pour mémoire : fond_z_cotes en découle)
  dessus_z: 810            # partie centrale plate au niveau du haut de la caisse batterie + ancre (JD 30/09) ; la table se pose dessus
  fourreaux_livarde: null  # (ancien, JD 30/09 matin : trou dans le dessus + fourreau dans le coffre) {dx: 180, y: 1080, diam: 40, ep: 2, l: 300, collier: {h: 20, ouverture: 70}}
  rangement_livarde:       # (JD 30/09 soir) livarde rangée debout À L'EXTÉRIEUR, contre la face extérieure de la joue, 180 devant l'axe du mât au collier :
                           # en bas un godet (bloc CP 2 × 10 : pli percé du trou + pli plein), en haut un collier ouvert vers l'extérieur (bloc CP 2 × 10), collés sur la joue
    dx: 180
    jeu: 2                 # entre la livarde et la joue
    bloc: {larg: 60, saillie: 45, ep: 10}
    godet: {diam: 34, au_dessus_bas: 15}
    collier: {diam: 32, ouverture: 30, sous_haut: 60}   # 60 sous le haut de la joue : 20 sous le hauban direct AV   # livarde rangée (JD 30/09) : trou dans le dessus, 180 devant l'axe du mât au collier,
                                                                                                     # contre la joue ; fourreau de 300 dans le coffre, collier ouvert sur le dessus pour la tenir
  table: null              # (JD 07/10) retirée avec la caisse de la batterie qui la portait (avant : x 1 384 → 1 760, demi_y 360, CP 10, découpée pour la tête du moteur)
  capot_arriere: {x0: 1760, z_c4: 810, demi_y: 450, ep: 6, decoupe_moteur: {x0: 1771, demi_y: 70}, demontable: false}   # (JD 09/10) capot horizontal à 810 (dessus des caissons de rangement à plat, au ras du dessus) : depuis le recul des mâts (06/10), les haubans collier -> poutre passent à 38 au-dessus ; avant : en pente jusqu'à 740 contre C4   # (JD 08/10) élargi à ±450 avec le dessus plat ; fixe (collé) : les batteries sont dans les accoudoirs, une trappe par caisson de rangement   # (JD 05/10) dessus du milieu en pente de x 1 760 (z 810) à C4 (z 740) : les haubans collier -> milieu de la poutre AV passent au-dessus
  dessus_plat_demi: 450      # (JD 08/10) surface plate agrandie de chaque côté du moteur : ±360 -> ±450 (caissons de rangement dessous) ; même cassure que le fond, bordé central C5 cylindrique
  dessus_cotes_au_dessus_collier: 25   # hauteur du collier sur le mât (collier_geom) : inchangée ; le dessus ne monte plus jusqu'au collier
  dessus_pente_cotes_deg: 10   # (JD 09/10) moustache : dessus à 10° du plat (±450) jusqu'aux joues (z 926,6), même angle que le fond ; avant : jusqu'au collier (≈ 25°)
  pattes_collier: null     # (JD 09/10) inutiles : le mât ne tient plus au coffre (avant : pattes alu {larg: 60, ep: 10, ecart: 50, recouvrement: 120, au_dessus_axe_collier: 40})
  dessus_au_dessus_collier: 25   # haut du coffre et des joues = haut du collier
  avant_x: 1584            # pointe avant au droit des joues : 1 390 avant le 06/10 ; reculée de 194 avec les mâts (JD : côtés raccourcis, joue toujours tangente au collier)
  dossier: {h: 400, courbe_continue: true, x_fin_montee: 2160}   # (JD 09/10) dossier relevé à 400 au-dessus de l'assise (z 1 085), indépendant du dessus du coffre (moustache 10°, 927 contre la joue) ;
                           # courbe continue (JD 11 h 45, « pas de décrochage ») : l'arrondi de la joue monte de la pointe jusqu'au dossier, la joue dépasse au-dessus du coffre ;
                           # (courbe_continue: false : montée en S derrière le mât jusqu'à x_fin_montee)
  joues_forme: {n_avant: 2.3, n_arriere: 2.2, plat_jusqu_a_c4: true}   # joues arrondies (JD 30/09) : superellipses (2 = ellipse) ; avant tangent horizontal au collier sans saut de courbure,
                                                                       # dessus plat du collier à C4 (comme le coffre), dossier depuis C4 ; le bordé du coffre suit l'avant à la station des joues
  avant_x_milieu: 1584     # (JD 07/10) avant droit au ras de la pointe des joues : coffre raccourci de 334 au milieu (avant : 1 250, pointe avancée au milieu seulement, JD 29/09 soir)
  fond_pente: {deg: 25, x0: 1860}   # (JD 09/10 : « garder voire augmenter », c'est lui qui protège des vagues) 12° -> 25° (pointe + 55 sur 15°) ; fond bas (z 250) sous l'aileron et l'hélice relevés, de x 1 860 à C4, puis remonte à 12° jusqu'à la pointe (z ≈ 380 au milieu) ; même pente partout -> panneaux plans
  plateau_z: 900           # plateau intérieur
  ep_bordé: 6
  ep_plateau: 6
  ep_fond: 6
  ep_face_ar: 6
  ep_flasque: 9            # joues porte-mât
  ep_cloison: 6
  pas_cloisons: 560
  cloisons_y: []           # ancienne C9.1 (y -500) remplacée par le compartiment batterie (JD 29/09)
  compartiment_batterie: null   # (JD 07/10) plus de caisse de batterie dans le coffre (avant : CP 6 à 3 du bac, montée jusqu'à z 810)
  ancre: {faisceau: [200, 100], verge: [120, 20], anneau: 50, sur: fond}   # grappin pliant ≈ 3–4 kg (hypothèse), couché en travers sur le fond du coffre à ancre, contre la cloison du puits
  coffre_ancre: {demi_y: 250, ep: 6}   # (JD 07/10) petit coffre à ancre devant le puits : deux cloisons CP 6 à ±250, de l'avant à la cloison du puits ; couvercle découpé dans le bordé (trappe)
  yinyang:                 # dessin du bateau (JD 29/09) : taijitu sur la face extérieure des joues et sur les deux faces des voiles
    joues: null            # (JD 09/10) plus de yin-yang sur les joues ; avant : {x: 2250, z: 870, r: 180, ep: 0.5}, sur le dossier derrière le mât
    voiles: {dx: 2558, dz: 1791, r: 180, marge: 30}    # même taille que sur les joues, dans le coin du point d'écoute au-dessus de la livarde (JD 29/09) : centre x 4 324, z 2 139, à 100 de la chute et 60 de la livarde ; suit la toile quand elle est roulée
  couples_coffre:          # couples intérieurs dans le plan des accroches de la poutre AV (JD 29/09) : les efforts des accroches passent dans le fond et le dessus
    - {y: 420, x0: puits, ep: 6}   # (JD 08/10) couple plein déplacé de ±331 à ±420 : côté extérieur des caissons de rangement, de la cloison du puits à C4 (avant : ±331 évidé)
    - {y: 850, ep: 9, evidement: {marge: 60, rayon: 30}}              # sous l'avant des bancs ; ±131 : parois du puits moteur
  couples_travers: []      # retirés (JD 30/09 : seulement les couples dans le sens de la longueur) ; x = face avant, y0 = départ (caisse | puits), jusqu'à la joue
                           # essai du 29/09 : {x: 1497, y0: caisse, ep: 6}, {x: 1705, y0: caisse, ep: 9}, {x: 1811.5, y0: puits, ep: 9}, évidés {marge: 60, rayon: 30}
  batterie: null           # (JD 07/10) plus de batterie dans le coffre (avant : Dyness 24 V 100 Ah, 531 × 206 × 217, 19,3 kg, dans un bac 650 × 315 × 320 en travers devant le puits, x 1 393 → 1 708)
  batterie_banc: null      # (JD 08/10) plus de caisson sur l'avant du banc : deux batteries, une dans chaque accoudoir, au bout des bancs (07/10 : une 24 V 50 Ah dans un caisson sur l'avant du banc bâbord)
  batteries_puits: null    # (JD 08/10 matin, abandonné) deux batteries au fond du coffre, de chaque côté du puits
  accoudoirs:              # (JD 08/10) caisson étanche sur l'arrière de chaque banc, comme un accoudoir, le plus petit possible : toute la profondeur de l'assise, batterie en travers ; l'arrondi de la joue arrive au bout du dessus du caisson
    jeu: 5                 # autour de la batterie, dans le sens de la marche (en travers : 305 de libre pour 260)
    h_libre: 15            # au-dessus de la batterie, pour les bornes et les câbles
    ep: 6                  # CP 6 : face avant, côté intérieur, face arrière ; la joue fait l'extérieur, l'assise le fond
    couvercle: 6           # amovible, sur joint, deux grenouillères
    batterie: {l: 260, larg: 165, h: 210, masse: 11.0}   # LiFePO4 24 V 50 Ah (type Sterling LH2450), en travers : 260 en y, 165 dans le sens de la marche ; une par accoudoir, en parallèle : 100 Ah
    cotes: [babord, tribord]
  trappe:                  # (JD 07/10) couvercle du coffre à ancre, découpé dans le bordé avant au-dessus de z 450 (avant : dessus ouvert au droit de la caisse de batterie, x 1 384 → 1 717, ±334)
    x0: 1560
    x1: 1711               # (JD 09/10 après-midi) jusqu'à la cloison du puits seulement : poche ouverte (avant : 1 800, couvercle jusqu'au capot arrière)
    # x1: 1800             # jusqu'au capot arrière (rogné à son plan) : tout le bordé central devant le capot, entre les stations du loft à ±250 (un seul panneau développable), bords posés sur des tasseaux le long des cloisons
    y0: -250
    y1: 250
    z_seuil: 650            # (JD 09/10 17 h) face avant du coffre à ancre remontée : bordé découpé au-dessus de z 650 seulement (avant : 450, simple lèvre de 50 au-dessus du bas de la pointe)
    ouverte: true          # (JD 09/10 après-midi) coffre à ancre ouvert dessus, comme une poche, évacuation en dessous (avant : couvercle découpé dans le bordé)
    evacuation: {d: 25, x: 1698, y: [-120, 120]}   # deux trous Ø 25 dans le fond, au point bas de la poche, contre la cloison du puits
  trappes_c4: null         # (JD 08/10) une seule trappe rectangulaire par compartiment extérieur (de ±420 à la joue), la plus grande possible dans C4, à l'horizontale :
                           # surface maxi sous le haut de C4 qui monte vers la joue (25 de bord), 25 au-dessus de l'assise, 5 du poteau de la glissière ;
                           # le couple ±850 passe derrière, au milieu : il sert d'appui au couvercle (avant : y ±500 -> ±800, z 700 -> 850, puis deux au-dessus des bancs)
    # (JD 09/10 17 h 30) plus de trappes : ouvertures_c4 ; jusque-là : {y0: ±690, y1: ±1010, z0: 710, z1: 827} (320 × 117, sous le dessus abaissé, 10 du poteau)
  ouvertures_c4: {bas: 25, bord: 25, couple: 25, poteau: 5, rayon: 30}   # (JD 09/10 17 h 30 : « pas de trappes sur les caissons extérieurs, une ouverture polygonale aussi grande que possible
                           # au-dessus du niveau des sièges ») : dans C4, une par compartiment extérieur, sans couvercle : de 25 au-dessus des assises jusqu'à 25 sous le haut de C4
                           # (qui monte à 10° vers la joue), de 25 du couple plein ±420 à 5 du poteau d'appui du tube ; coins arrondis R 30 ; le couple ±850 passe derrière
  trappes_exterieures: null   # (JD 08/10) essai d'une grande trappe dans le dessus des compartiments extérieurs, abandonné : la trappe va dans C4
  rangements:              # (JD 08/10) caissons de rangement de chaque côté du moteur : de la paroi du puits au couple plein ±420, de la cloison du puits (prolongée jusqu'au couple) à C4 ; fermés dessus par le capot arrière
    trappe: {x0: 1785, x1: 1990, y0: 150, y1: 400}   # découpée dans le capot, posée sur un cadre de tasseaux 15 x 15 collés sous le capot, joint, deux tourniquets
  glissiere_collier:       # (JD 08/10) reprise des efforts verticaux des colliers : c'est le TUBE (où les colliers tournent sur leurs tourillons) qui repose dans une glissière ;
                           # le collier ne la touche pas (il reste libre de tourner autour du tube quand on change la quête)
    type: poteau_coffre    # (JD 09/10 : « mettre le poteau du collier dans le coffre ») poteau carbone dans le coffre, contre C4, sur le toit de la poche de la pièce d'angle ;
                           # il sort par le dessus et porte une potence CP qui passe au-dessus de C4 jusqu'au berceau PEHD du tube
    x: [2050, 2120]        # berceau centré sur l'axe du tube (x 2 085)
    y_int: 990             # sous tout le tourillon (1 001 -> 1 081 dans le tube)
    berceau: {y_fin: 1078, sous_axe: 11, jeu_x: 3}   # U sous le bout du tube, creusé dans le bloc PEHD ; joues 11 sous l'axe (le tube s'enlève par le haut), 3 de jeu
    bloc: null             # (JD 09/10 après-midi) plus de glissière : le collier tourne dans le tube, le tube n'a pas à tourner ; il repose à plat
                           # sur la potence et les haubans l'avancent ou le reculent (avant : bloc PEHD {jeu_tube: 0.5, sous_tube: 10}, berceau en U creusé)
    potence: {h: 40, devant_poteau: 10}              # CP collé (4 × CP 10), du devant du poteau au bout du berceau ; porte-à-faux ≈ 95 de l'axe du poteau à celui du tube
    poteau: {d: 50, ep: 2.5, y: 1045, jeu_c4: 3, douille: 20}   # tube carbone Ø 50 × 2,5 à 3 de C4 ; douille de 20 dans la potence ; dessus du coffre percé, bague CP 18 dessous
    cale: true             # cale coulée (époxy chargée) entre le toit de la poche et le nez de la pièce d'angle, sous le poteau (coffre en place)
  glissiere_collier_avant_0910:   # glissière du 08/10 soir : bloc PEHD vissé à travers la joue, poteau carbone Ø 40 × 2 derrière C4, à travers l'assise, sur la pièce d'angle
    type: tube_pehd
    x: [2050, 2120]
    y_int: 990
    berceau: {y_fin: 1078, sous_axe: 11, jeu_x: 3}
    bloc: {h: 60, jeu_tube: 0.5, douille: 15}
    poteau: {d: 40, ep: 2, y: 1025}
    cale: true
  hiloire: {h: 30, ep: 9, inclinaison_deg: 45, x_milieu: 1755, y_plat: 460, x_joue: 1950}   # (JD 09/10) hiloire (brise-lames) CP 9 en haut de l'arrondi avant, 30 de haut, penchée à 45° vers l'avant (JD, avant : 50 debout) : droite devant le capot et les trappes (x 1 755, ±460),
                           # puis en V jusqu'aux joues (x 1 950, 30 devant le poteau de la glissière) ; l'eau qui monte sur l'arrondi est renvoyée sur les côtés
  glissiere_collier_avant_0810:   # ancienne glissière (JD 08/10 midi) : sabot 6 × CP 10, berceau 4 × CP 9, garniture PEHD 3, poteau caisson 3 parois CP 9
      x: [2050, 2120]        # sabot centré sur l'axe du tube (x 2 085)
      y_int: 990             # sabot assez long : de la joue jusqu'à y 990, sous tout le tourillon (1 001 -> 1 081 dans le tube)
      berceau: {y_fin: 1078, sous_axe: 11, jeu_x: 3}   # glissière en U sous le bout du tube (jusqu'à 1 078), 4 × CP 9 sur le sabot ; ses joues s'arrêtent 11 sous l'axe du tube (le tube s'enlève par le haut), 3 de jeu de chaque côté
      pehd: {ep: 3}          # garniture PEHD dans le berceau : le tube glisse dans son axe
      sabot: {h: 60}         # de 1 078 à la joue, le sabot reste au ras du haut de la joue : 10 sous le collier
      poteau: {x: [2055, 2115], ep: 9}   # poteau caisson (3 parois CP 9, la joue fait la 4e) collé contre la joue, sur toute la longueur du sabot (990 -> joue) : du sabot à l'assise, puis de l'assise au bas de la joue
      cale: true             # cale coulée (époxy chargée) sous la joue et le poteau, posée sur la pièce d'angle AV
  moteur:                  # Haswing Protruar 2.0 24 V
    mode: vertical2        # JD 29/09 soir : relevage vertical dans l'axe, puits le plus petit possible ; bascule abandonnée
    vertical2:
      levee: 0             # 0 = en marche ; levee_max = relevé (l'arbre coulisse dans la bride, vis de serrage de la direction)
      levee_max: 674       # course ≈ 900 − 164 (fourreau) − 52 (collier) = 684, moins 10 : la nacelle s'arrête 10 sous la bride ; hélice et nacelle dans le coffre
      x_arbre: 1910        # hélice 15 devant C4 une fois rentrée ; tête (129 devant l'arbre) 15 derrière le tube des colliers avancé
      y: 0
      tete_bas: 690        # bas de la tête en marche : l'arrière de la tête passe au-dessus du nez de la poutre AV (z 670 au milieu)
      # cotes du Protruar 2.0 relevées sur le schéma du manuel (p. 13), à l'échelle de l'arbre (900 entre tête et nacelle, Ø 30) ; largeurs estimées
      tete: {avant: 129, arriere: 135, demi_y: 60, h: 140}        # boîtier de commande + articulation de la barre, sans la barre
      barre: {d: 40, l: 315, x: -99}                             # barre franche repliée vers le haut, articulation 99 devant l'arbre
      nacelle: {d: 100, avant: 159, arriere: 61}                 # nez 159 devant l'arbre (côté planche), arrière 61 derrière
      helice: {d: 236, x: 66, ep: 25}                            # hélice tripale Ø 236 (9,3"), disque 66 → 91 derrière l'arbre
      aileron: {h: 90, x0: -50, x1: 10, ep: 10}                  # aileron sous la nacelle
      bride: {dessous_tete: 52, h: 164, derriere: 40, demi_y: 40}  # fourreau de direction 164 de haut ; collier de hauteur (52) entre tête et bride
      tableau: {ep: 40, h: 110, devant_arbre: 56, sous_bride: 48}  # planche CP collée entre les parois du puits, face arrière à 56 de l'arbre ; bas à 16 au-dessus de la nacelle rentrée
      puits: {ep: 6, demi_y: 128, x_av: 1717, fond_ouvert: true, arriere_ouvert: true}  # puits CP 6 de 256 × 300, ouvert dessous et dessus : l'hélice (Ø 236) y rentre ; paroi avant = cloison arrière du compartiment batterie
                           # (JD 09/10 17 h) arriere_ouvert : plus de face arrière (C4 ouverte sur toute la largeur du puits, du fond au capot) : l'eau des vagues qui frappent ressort derrière au lieu de monter dans le puits
      encoche_c4_z: 680    # C4 échancrée au-dessus : l'arrière de la tête dépasse de C4 au-dessus du nez de la poutre
      encoche_c4_demi_y: 70
      trou_fond: 50
      bras_tube: {larg: 30, ep: 8}                               # bras rabattu du tube des colliers sur l'arbre, en position haute
    avant2:
      bascule: 0             # 0 = en marche ; 90 = relevé, arbre à l'horizontale devant le coffre, nacelle debout
      y: 35                  # arbre à 35 côté bâbord : nacelle tournée de 160° (hélice décalée), le bas du moteur reste centré
      pivot_x: 1620          # coin de la tête à 11 de C4 au pire de la bascule (vers 80°) ; relevé : 11
      pivot_z: 530           # en marche : nacelle à -310 ; relevé : nez de nacelle sous les haubans croisés du collier
      arbre_devant_pivot: 10
      arbre_au_dessus: 110   # arbre au-dessus de la bride : hélice au plus profond
      rotation: 160          # nacelle tournée de 160° (butée de direction) : poussée à 20° de l'axe
      tableau: {derriere_pivot: 60, ep: 40, sous_pivot: 40, h: 70, demi_larg: 118}  # planche de serrage derrière l'arbre (bride à l'envers), collée entre les parois du canal
      fente: {larg: 60, haut: 580, ep: 6}      # fente étroite de l'arbre : fond et face avant, coffrage fermé au-dessus
      canal: {x0: 1454, demi_larg: 118, ep: 6, x_ouvert: 1975}   # canal de la tête : ouvert dessus jusqu'à x 1 975 (passage de la tête)
    transversal:
      bascule: 0           # 0 = en marche ; 90 = relevé, couché vers bâbord dans le coffre
      x_arbre: 1775
      charniere_z: 500     # axe de la charnière (longitudinal)
      charniere_decalage: 80   # axe 80 côté tribord (côté tête) : relevé, le moteur se couche 80 au-dessus de la charnière
      palier_av_x: 1510
      palier_ar_x: 1625
      bride_sous_charniere: 40 # bord haut de la planche 40 sous l'axe
      arbre_au_dessus: 120 # en marche : axe d'hélice à -330
      planche_ep: 40
      planche_h: 70
      planche_demi_larg: 100
      flasque_ep: 20
      encoche_arbre: 80    # le volet laisse passer l'arbre en marche
      volet: true
      fente:               # ouverture du fond pour la bascule, fermée par le volet une fois le moteur relevé
        x0: 1610
        x1: 1966
        y0: -40
        y1: 905
    ancien_mode: transversal      # "arriere" : bascule vers l'arrière sous la martingale ; "avant" et "vertical" : variantes
    arriere:               # bascule vers l'arrière sous la martingale
      type_chaise: fixe    # "fixe" : planche fixe, le moteur bascule sur l'axe de sa bride ; "pivotante" : variante à charnière
      bascule: 0           # 0 = en marche ; 90 = relevé à l'horizontale sous la martingale et le trampoline
      y: 620               # décalé sur bâbord : tête sous la pente haute du dessus (plat élargi à ±360)
      encoche_c4:          # passage de l'arbre basculé sous le bas de la face arrière
        demi_y: 45
        z: 470
      x_arbre: 1850
      bride_axe_z: 405     # axe de bascule de la bride : descendu de 15 (plateforme relevée) ; relevé, 17 sous la tige de martingale et le trampoline
      bride_axe_devant_arbre: 10     # géométrie de bride estimée (à relever sur la Protruar)
      bride_axe_derriere_planche: 60
      bride_axe_sur_planche: 40      # l'axe est 40 au-dessus du bord de la planche
      arbre_au_dessus: 120 # arbre 120 au-dessus de l'axe : hélice à -410 en marche ; relevé, la tête reste devant la planche
      rotation_tete_avant_bascule: 90  # barre tournée de 90° avant de basculer : nacelle en travers
      planche_ep: 40
      planche_h: 70         # 7 cm suffisent au serrage de la bride
      demi_larg: 100
      demi_passage: 110    # joues de part et d'autre du passage de la tête
      ep_joue: 25
      long_joue: 160
      carter:              # boîte sous le coffre prolongeant les joues de chaise : la tête relevée y est protégée
        x_av: 1420
        ep: 9
      niche:               # boîte dans le coffre, ouverte en dessous : loge la tête en marche et son balayage
        x0: 1429
        x1: 2016.5
        demi_y: 125          # 250 : la tête (200 × 140, diagonale 244) tourne de 90° dans le puits avant la bascule
        z_haut: 2000         # parois jusqu'au bordé
        ep: 6
      # variante chaise pivotante (type_chaise: pivotante)
      charniere_z: 490
      charniere_derriere_arbre: 70
      bride_z: 500
      arbre_au_dessus_bascule: 50
      planche_ep_piv: 40
      ep_ferrure: 10
      long_ferrure: 80
    avant:                 # moteur reculé et rehaussé au maximum, dans une boîte au milieu du coffre ; bascule vers l'avant par une fente
      bascule: 0           # 0 = en marche ; 90 = relevé à l'horizontale vers l'avant
      rotation_tete: 160   # tête tournée de 160° : l'hélice tire vers l'avant (poussée à 20° de l'axe)
      x_arbre: 1575        # reculé au maximum : en bascule, l'angle de la tête passe 16 mm devant la face arrière
      pivot_z: 610         # rehaussé : axe d'hélice à -240 en marche (immersion mini raisonnable pour Ø 236)
      tableau_ep: 40       # tableau de serrage derrière l'arbre, sous le fond du coffre
      demi_larg: 90
      tableau_haut: 470    # 140 sous l'axe : la tête basculée passe au-dessus
      tableau_bas: 350
      ep_joue: 25
      long_joue: 120
      boite:               # boîte étroite dans le coffre : loge la tête en marche et au relevage ; trappe au-dessus
        demi_y: 100
        ep: 6
        x_ar: 1960
        z_fente: 660       # passage de l'arbre dans la face avant au relevage
        face_fermee: false # la tête dépasse du coffre en marche : boîte ouverte devant et dessus (capot amovible)
    levee: 0               # 0 = en marche ; 650 = relevé (course de réglage de l'arbre ≈ 620–700 mm selon Haswing)
    arbre_l: 900           # arbre 900 mm (35,5")
    arbre_d: 30
    bride_nacelle_max: 850 # distance bride -> axe de nacelle, arbre descendu au maximum (estimée)
    recul_arbre: 70        # axe de l'arbre derrière la face arrière de la chaise
    tete: [200, 140, 260]  # tête (estimée), barre franche repliée à la verticale
    nacelle_d: 100
    nacelle_l: 300
    helice_d: 236          # hélice tripale 9,3"
    chaise:                # tableau de serrage sous le fond du coffre, au milieu ; la bride serre son bord haut
      x_face_ar: 1700
      ep: 40
      demi_larg: 120
      z_bride: 500         # bord haut = fond du coffre : hélice à -350 en marche
      z_bas: 380
    puits:                 # boîte verticale à travers le coffre (tête et arbre au relevage), trappe au-dessus
      x0: 1660
      x1: 1910
      demi_y: 120
      ep: 6
  joues:
    montee_fin_devant_mat: 0
  pylones:                 # seuls appuis du coffre sur le pont : tubes carbone sous les joues, posés sur les semelles (JD 29/09)
    type: tube
    diam: 40
    ep: 2
    dx: [-50, 50]          # deux tubes par bord, de part et d'autre du pied de mât
    y_int: 45              # axe à 45 à l'intérieur de la joue
    renfort: {ep: 18, dx: 120, dy: 100}   # semelle CP 18 collée sur le fond contre la joue, sur les deux tubes (220 × 100) (JD 30/09 : pas de couple en travers) ; haut du tube coupé à la pente du fond
    dy: 90                 # (ancien pylône CP)
    x_ref: 1766            # (JD 06/10) les tubes restent à l'ancienne place du pied de mât
    semelle: null          # (JD 08/10 soir) les tubes portent sur la semelle du mât (une seule par bord) ; avant : {dx: [-110, 80], y: [1020, 1111], ep: 18}
    sur_semelle_mat: true  # pied des tubes dans le plan de la semelle du mât
    # ancienne semelle des tubes (JD 06/10, mâts reculés) semelles CP 18 des tubes, sur bourrage, à l'ancienne place de la semelle du mât (même plan), x 1 656 → 1 846
  ref_mat: {z_pied: 348.1}   # (JD 06/10) hauteurs du coffre : ancien dessus de semelle (haut des joues z 1 122) ; le sommet des joues suit le mât (x)
  milieu_x_pied: 1766        # (JD 06/10) milieu inchangé (batterie, caisse, puits, table) : courbe avant au milieu sur l'ancien pied de mât ; raccord linéaire de ±360 aux joues
  accroches_poutre:        # accroches sur la poutre AV : demi-profil DWG + jeu, ouvertes vers le bas, collées derrière C4 (JD 29/09)
    y: [-850, -420, -131, 131, 420, 850]   # dans le plan des couples intérieurs : parois du puits (±131), couples des caissons de rangement (±420, JD 08/10 ; avant ±331), couples ±850
    ep: 9
    jeu: 2
    au_dessus: 45          # dépasse de 45 au-dessus de la poutre
    sous_axe: 64           # bas de la lèvre sous le nez (JD 30/09 : accroches plus enveloppantes dessous)
    integre: true          # (JD 30/09) accroches découpées d'une pièce avec les couples du coffre (±850), les côtés de caisse (±331) et les parois du puits (±131), au travers de C4 (fentes)
    pose: {angle: 45, course: 33}   # fin de pose en diagonale arrière-bas (45°, 33 mm) : la lèvre passe sous le nez de la poutre ; seul le dessous de la queue reste ouvert (trampoline)
    sous_assise: [-850, 850]   # sous les bancs : l'accroche monte jusqu'à l'assise et sert de couple avant
    brelage: {diam: 5, trou: {u: -20, v: -50, diam: 8}}   # (JD 30/09) brêlage en diagonale, d'un trou dans la lèvre (u, v : depuis le centre du nez) au pied du pilier de martingale
                                                          # (avant : œil dans C4, 12 sous le nez : {diam: 5, sous_nez: 12})
    fin_x: 2112            # 6 avant la fente du trampoline (queue à 2 118)
  bancs:
    plan_z: 585            # fond du banc au-dessus du trampoline (574 au bord intérieur, à l'avant) : le banc repose sur ses couples
    longueur: 1195.5       # depuis C4 : fin des bancs et des joues à x 3 218 (inchangée)
    x_debut: 2022.5          # assise collée contre C4 (bancs liés au coffre, JD 29/09) : passe au-dessus de la poutre et des pièces d'angle
    y_int: 800             # assise de 311 de large (jusqu'à la joue à 1 111)
    hauteur: 100
    rayon_aretes: 20
    etancheite: {joint: {larg: 10, h: 10}, tape: {ep: 6, marge: 30, jeu: 1}}   # (JD 09/10, trampoline étanche) joint néoprène sur le longeron sous la joue, tape CP au-dessus de la pièce d'angle AV (posée après le coffre)
    ep_assise: 9
    ep_cotes: 6
    ep_fond: 4
    poutre_x: 2070
    poutre_z: 539.5
    longeron_y: 1093
    encoche_poutre_r: 42
    encoche_longeron_r: 28
    couples_x: [2160, 2410, 2680, 2950, 3212]   # couples transversaux accrochés au longeron (demi-profil DWG + jeu, ouverts vers le bas) ; 1er reculé de 2 136 à 2 160 (JD 30/09) :
                                                # pendant la fin de pose en diagonale, il passe au-dessus de la queue de la pièce d'angle AV (fin à x 2 124)
    couple_ep: 9
    caisson: false         # banc ouvert dessous (JD 29/09) : assise seule sur les couples, rien sous l'assise
    joue_jusqu_au_longeron: true   # rangement entre trampoline et assise (JD 29/09) : la joue (dossier) descend jusqu'au longeron
    entaille_dans_joue: true       # (JD 30/09 : couple trop fragile) c'est la joue qui est entaillée par le bas au droit des couples, le couple reste entier
    jeu_joue_longeron: 2
    evidement: null        # (08/10) couples pleins sous l'assise : l'âme de 55 sous un pied au bord travaillait à 23 MPa (avant : {ame: 55, rayon: 25, marge: 35}, JD 29-30/09)
    jambe: {sous_axe: 115, ext: 1162, joues: 9}   # (08/10) jambe extérieure du couple descendue à 115 sous l'axe du longeron, élargie à 1 162, doublée de deux joues CP 9 : le laçage passe dessous, 2,2 fois plus bas sous le pivot (basculement du banc vers l'intérieur)
    lisse_rive: {h: 40, ep: 9}   # (08/10) lisse CP 9 x 40 collée sous la rive intérieure de l'assise, entre les couples : un pied au bord passe de SF 1,1 à 2,9
    rayon_assise: 4
    couple_ext: 1140       # joue extérieure du couple : 25 au-delà du nez du longeron, pour boulonner la mâchoire (JD 29/09)
    couple_sous_axe: 44    # à l'extérieur du nez, descend 22 sous le nez (JD 30/09 : plus enveloppant) ; le laçage passe dessous
    couple_ext_haut: 25    # (JD 30/09) la joue du couple monte 25 au-dessus du fond du banc : la joue (dossier) est entaillée d'autant, le cou du couple fait ≈ 50
    # (JD 30/09) plus de mâchoire boulonnée : le couple tient par sa joue extérieure, qui descend sous le nez, et par le laçage sous la toile ; ancienne : {ep: 9, levre: 12, u_ext: -47, v_haut: -4}
    lacage: {x: [2160, 2410, 2680, 2950, 3212], diam: 5, haut: 25, droit: true, matiere: Dyneema}   # (08/10) Dyneema 5 (raide : le banc bascule de moins de 1°) ; droit : sous le bas des jambes de couple, d'un bord à l'autre   # d'un longeron à l'autre sous la toile (JD 29/09) ; plus de moteur sous le trampoline : tous les couples
  haubans:                 # coffre haubané sur les pièces d'origine (JD 28/09) ; attaches sur le collier, devant et derrière le mât
    diam: 5                  # (JD 08/10) Ø 5 inox 1x19 (rupture ≈ 19,5 kN) : à la gîte maxi le plus chargé monte à ≈ 5 kN (7,9 kN avec x1,5) ; Ø 4 (12,6 kN) était juste
    attache_dx: 60           # attaches à ±60 de l'axe du mât, dans le plan du collier
    attache_dy_av: 40        # (JD 30/09 soir) direct AV du collier attaché 40 plus à l'extérieur, sur l'oreille du collier : il passait contre la joue, là où la livarde est rangée
    etrave: {x: 50, dz: 12}  # pattes d'étrave (pointes des coques), sur l'axe de coque, au-dessus du pont
    cadene: {x: 2690, dy: 186, dz: 8}   # cadènes d'origine, bord extérieur du pont, ≈ 620 derrière la poutre AV (photo de dessus)
    croises_avant: false     # (JD 08/10 soir) collier à 3 haubans : direct AV, direct AR, diagonale vers la poutre ; avant : croisés vers la patte d'étrave opposée
    croise_dz: 45            # ancien collier : œil des croisés sur un plot au-dessus du collier (35 -> 45 avec les joues arrondies, JD 30/09) ; collier du 06/10 : ferrure avant
    croises_arriere: false   # retirés (JD 29/09) : remplacés par le tube entre les colliers
    x_croise_ar: 1995
    collier_poutre: {dz: 100, poutre_dz: 10, x_poutre: 2085}   # (JD 05/10) hauban du collier au milieu de la poutre AV, en diagonale au-dessus du coffre, ferrure sur le dessus de la poutre (y 0) ; ancien collier : œil sur un plot de 100 (dz) ; collier du 06/10 : ferrure en haut de sa face intérieure
    tube_colliers: {diam: 50, ep: 2, x: 2085}   # tube alu d'un collier à l'autre, au-dessus du coffre (JD 06/10 : z calculé, sur l'axe des tourillons) ; x 2 085 avec les mâts reculés : derrière la tête du moteur (15), au-dessus de la poutre AV ; avant : x 1 741, devant la tête
    semelle: null            # (JD 08/10 soir) plus de haubans de pied : la semelle collée sur le renfort passe l'effort du pied (≈ 2,4 kN) au pont
    semelle_avant_0810:      # ancien étage des semelles (JD 29/09) : directs AV et AR ; croisés passés à l'arrière (libèrent le moteur relevé)
      attache_dx: 100        # pontets sur la semelle, au bout du rail (60 avant le 06/10)
      attache_dx_av: 100     # pontet AV 100 devant le pied de mât, 14 vers l'extérieur (attache_dy_av) : le croisé AV passe à 14 des tubes du coffre
      attache_dy_av: 14
      attache_dx_ar: 140     # pontet AR 140 derrière le pied de mât : le croisé AR passe derrière le pylône de la poutre AV
      dz: 10                 # hauteur de l'œil au-dessus de la semelle
      croises_avant: true    # rétablis : le moteur ne bascule plus (croisement x 820, z 412, loin devant le coffre)
      croises_arriere: true  # rétablis (JD 29/09 soir) : vers un pontet au bord intérieur du pont opposé (jusqu'à la cadène, ils traverseraient le pont bombé)
      pontet_interieur: {x: 2690, dy: 186, dz: 8}

hc16_origine:              # gréement Hobie 16 d'origine, approché (book, comparaison des CV) : mât 8,08 m (26'6"), GV 13,77 m² et foc 5,12 m² (manuel Hobie Cat Europe 2015),
                           # GV : guindant 7 315, bordure 2 743, chute 7 666 (Good Old Boat, données voilier) ; foc : contour fait pour 5,12 m² entre l'étai et un point d'écoute plausible
  mat: {x: 2070, z: 700, quete_deg: 7.5, longueur: 8080, diam: 75}   # rotule sur le dessus de la poutre AV au milieu (670 + 30) ; quête 7,5° (hypothèse du 24/09)
  gv: {amure_w: 600, tetiere_w: 7950, bordure: 2740, chute: 7666, surface: 13.77, lattes: 7}   # bôme à 1,30 m de la flottaison
  foc: {surface: 5.12, point_ecoute: [2250, 1000], jeu_amure: 150, jeu_tete: 150}
  etai: {capelage_w: 6100, patte_oie: 1130, ferrure: [250, 1000, 440]}   # pattes d'oie ≥ 44" (1 118) entre les ferrures d'étrave et le point d'étai
  cadene_hauban: [2250, 1150, 330]
  ecoute_gv: [4145, 565]   # chariot sur la poutre AR
  ecoute_foc: [2070, 330, 690]
  cv_reference: {x: 3010, z: 3360}   # CV HC16 retenu le 24/09 (triangles de voilure) pour placer le pied de mât Rando

safrans:
  x: 5120
  corde: 220
  hauteur: 800
  z_centre: -120
  epaisseur: 20
  barre_x: 5350
  barre_z: 300

tente:                     # (JD 09/10) tente igloo, deux arceaux diagonaux croisés au sommet (camping au mouillage) : couvre le dessus du coffre derrière l'hiloire, les bancs et le trampoline ; voiles roulées. (JD 12/10) arceaux posés sur le tube des colliers et sur la poutre AR, avancée devant le tube
  derriere_hiloire: 15     # (JD 09/10 17 h 40 : « tente inclut le coffre, ou derrière l'hiloire ») bord avant posé sur le dessus du coffre, 15 derrière le pied de l'hiloire
  devant_collier: 40       # coins avant sur les joues, 40 devant les colliers : l'arceau passe en dedans du collier
  garde: 25                # la toile passe à 25 au moins au-dessus du bateau (coffre, tube, moteur) ; les colliers traversent les flancs (manchons)
  x0: 2125                 # (16 h 40) bord avant lacé sur le tube des colliers, juste derrière lui ; plus utilisé (avant, 30/09 : sur le dessus du coffre, x 1 540)
  x1: 4145                 # bord arrière : poutre arrière (axe)
  demi_y: 1112             # bords latéraux : haut des joues (dossiers) et des accoudoirs, puis le long des longerons
  z_arriere: 555           # dessus de la poutre arrière
  z_tube: 1197             # bord avant sur le dessus du tube (1 194)
  y_tube: 1040             # au-delà, le bord descend vers les coins, sur les joues, derrière les colliers
  sommet_z: 1880           # 1 300 au-dessus du trampoline
  arceau_diam: 11          # 2 arceaux alu Ø 11 en diagonale, croisés au sommet
  pieds_av: {y: 1050}      # (JD 12/10) arceaux posés sur le tube des colliers, au bout, contre les joues (au-dessus des potences) ; avant : coins sur les joues devant les colliers
  pieds_ar: {y: 1040}      # (JD 12/10) et sur la poutre AR, au bout, contre les pièces d'angle
  avancee: hiloire         # (JD 12/10) devant le tube, la toile descend en avancée jusqu'au bord avant : hiloire (dessus du coffre, 15 derrière l'hiloire) ou c4 (haut de C4, juste sous le tube)
peinture:                  # finition (JD 29/09 soir) : coffre et bancs blancs, couples et pièces de maintien noirs (le premier motif qui convient l'emporte)
  - ['^banc_.*_(couple|machoire)', [0.13, 0.13, 0.14]]
  - ['^(accroche_poutre|machoire_poutre|collier_|semelle_|renfort_pont_|bourrage_)', [0.13, 0.13, 0.14]]
  - ['^(couple_coffre|moteur_puits|moteur_tableau|pylone_renfort)', [0.13, 0.13, 0.14]]
  - ['^coffre_trappe', [0.91, 0.72, 0.14]]   # (JD 09/10) trappes en jaune
  - ['^(coffre_coque|coffre_capot|coffre_caisse|coffre_batterie_|coffre_cloison_moteur|coffre_table|joue_|banc_.*_(assise|caisson))', [0.95, 0.95, 0.93]]
  - ['^trampoline', [0.89, 0.91, 0.92]]   # (JD 09/10) trampoline étanche PVC (mesh blanc avant, JD 29/09)
  - ['^lacage_trampoline', [0.18, 0.44, 0.69]]
