jdb666/cao_hc16/v_pleine_0.yaml

coques:
  longueur: 5050
  entraxe: 2000
  quille:
  - - 0
    - 420
  - - 150
    - 120
  - - 500
    - -54
  - - 1000
    - -143
  - - 1500
    - -188
  - - 2400
    - -188
  - - 3200
    - -143
  - - 4200
    - -54
  - - 5050
    - 60
  pont:
  - - 0
    - 450.0
  - - 500
    - 398.1
  - - 1000
    - 351.1
  - - 1500
    - 324.2
  - - 2000
    - 312.3
  - - 2500
    - 310.3
  - - 3000
    - 318.4
  - - 3500
    - 326.5
  - - 4000
    - 339.6
  - - 4500
    - 357.6
  - - 5000
    - 378.7
  - - 5050
    - 380.0
  demi_largeur:
  - - 0
    - 4
  - - 300
    - 70
  - - 800
    - 140
  - - 1500
    - 187
  - - 2500
    - 199
  - - 3500
    - 193
  - - 4500
    - 175
  - - 5050
    - 152
  bouge_pont: 35
plateforme:
  poutre_av_x: 2070
  poutre_ar_x: 4145
  poutre_av_z: 539.5
  poutre_ar_z: 524
  poutre_z: 532
  poutre_av_fleche: 100
  poutre_av_y_libre: 925
  poutre_axe_u: 16.5
  poutre_diam: 62
  poutre_longueur: 2080
  longeron_y: 1093
  longeron_dans_pieces: 60
  longeron_diam: 44
  pylone_diam: 70
  piece_angle:
    y_int: 925
    y_ext: 1122
    y_nez: 1040
    y_pylone: 1000
    manchon: 54
    manchon_demi_h: 40
    nez_x: 97
    nez_x_fin: 5
    nez_demi_h: 35
    nez_r: 35
    bossage_d: 84
    bossage_bas: 58
  trampoline_z: 580
  trampoline_milieu:
    jeu: 20
    pas: 150
    diam: 4
  martingale:
    pied_sous_axe_extremites: 170
    y_cable: 1000
    cable_sous_axe_extremites: 49
    jour_sous_poutre: 15
    y_jour: 925
    tige_diam: 6
mats:
  x_pied: 1960
  y_axe: 1161
  z_pied: 345.4
  collier_hauteur: 750
  collier:
    jeu_joue: 10
    ep: 70
    materiau: cp
    plis: 7
    alesage: 62
    chemise: 2
    r_bague: 55
    nez: 60
    demi_y_int: 80
    tourillon_bord: 12
    ouverture_ar: true
    arriere: 55
    axe:
      d: 10
      s: 38
    demi_y: 55
    tourillon:
      d: 45
      l: 80
      jeu_tube: 3
      prise: 35
    oeil:
      saillie: 22
      ep: 6
      h: 24
      dy_av: 40
      dy_croise: -30
      ar:
      - 20
      - 70
  emplanture:
    rail:
      type: joues_cp
      l: 140
      joue_ep: 10
      h: 40
      jeu: 0.5
      trou: 8
      pas: 20
      crans:
      - -1
      - 0
      - 1
      axe_z: 18
    cale:
      haut: 70
      pointe: 6
      pointe_z: 7
      h: 38
      larg: 30
      plis: 3
    ergot:
      d: 20
      h: 20
  longueur: 7300
  diam: 60
  quete_deg: 3
  haubanage: 700
  semelle:
    y_mat: 1161
    dx:
    - -304
    - 90
    dy:
    - -141
    - 26
    encoche:
      dx0: 65
      dy1: -116
    ep: 18
    bourrage_min: 3
    inclinaison_laterale: 0
    pente_pont_p4: 2.13
    renfort:
      ep: 8
      dx:
      - -344
      - 170
      demi_y: 186
      evite: pylone_av
voile:
  contour:
  - - 0
    - 1123
  - - 2839
    - 1603
  - - 2295
    - 3587
  - - 1575
    - 5363
  - - 823
    - 6803
  - - 0
    - 7163
  livarde:
    w_mat: 2060
    diam: 30
    ep: 1.5
    jeu_mat: 5
    rangee: auto
    rangement:
      vertical: true
  enroulement:
    babord: 0
    tribord: 0
coffre:
  largeur: 2240
  face_ar_x: 2022.5
  poches_pieces_angle:
    jeu: 4
    ouverte_dessous: true
  fond_z: 270
  fond_plat_demi: 150
  avant_plat_demi: 360
  fond_z_cotes: 439.4
  fond_pente_cotes_deg: 10
  dessus_z: 810
  fourreaux_livarde: null
  rangement_livarde:
    dx: 180
    jeu: 2
    bloc:
      larg: 60
      saillie: 45
      ep: 10
    godet:
      diam: 34
      au_dessus_bas: 15
    collier:
      diam: 32
      ouverture: 30
      sous_haut: 60
  table: null
  capot_arriere:
    x0: 1760
    z_c4: 810
    demi_y: 450
    ep: 6
    decoupe_moteur:
      x0: 1771
      demi_y: 70
    demontable: false
  dessus_plat_demi: 450
  dessus_cotes_au_dessus_collier: 25
  dessus_pente_cotes_deg: 10
  pattes_collier: null
  dessus_au_dessus_collier: 25
  avant_x: 1584
  dossier:
    h: 400
    courbe_continue: true
    x_fin_montee: 2160
  joues_forme:
    n_avant: 2.3
    n_arriere: 2.2
    plat_jusqu_a_c4: true
  avant_x_milieu: 1584
  fond_pente:
    deg: 25
    x0: 1860
  plateau_z: 900
  ep_bordé: 6
  ep_plateau: 6
  ep_fond: 6
  ep_face_ar: 6
  ep_flasque: 9
  ep_cloison: 6
  pas_cloisons: 560
  cloisons_y: []
  compartiment_batterie: null
  ancre:
    faisceau:
    - 200
    - 100
    verge:
    - 120
    - 20
    anneau: 50
    sur: fond
  coffre_ancre:
    demi_y: 250
    ep: 6
  yinyang:
    joues: null
    voiles:
      dx: 2558
      dz: 1791
      r: 180
      marge: 30
  couples_coffre:
  - y: 420
    x0: puits
    ep: 6
  - y: 850
    ep: 9
    evidement:
      marge: 60
      rayon: 30
  couples_travers: []
  batterie: null
  batterie_banc: null
  batteries_puits: null
  accoudoirs:
    jeu: 5
    h_libre: 15
    ep: 6
    couvercle: 6
    batterie:
      l: 260
      larg: 165
      h: 210
      masse: 11.0
    cotes:
    - babord
    - tribord
  trappe:
    x0: 1560
    x1: 1711
    y0: -250
    y1: 250
    z_seuil: 650
    ouverte: true
    evacuation:
      d: 25
      x: 1698
      y:
      - -120
      - 120
  trappes_c4: null
  ouvertures_c4:
    bas: 25
    bord: 25
    couple: 25
    poteau: 5
    rayon: 30
  trappes_exterieures: null
  rangements:
    trappe:
      x0: 1785
      x1: 1990
      y0: 150
      y1: 400
  glissiere_collier:
    type: poteau_coffre
    x:
    - 2050
    - 2120
    y_int: 990
    berceau:
      y_fin: 1078
      sous_axe: 11
      jeu_x: 3
    bloc: null
    potence:
      h: 40
      devant_poteau: 10
    poteau:
      d: 50
      ep: 2.5
      y: 1045
      jeu_c4: 3
      douille: 20
    cale: true
  glissiere_collier_avant_0910:
    type: tube_pehd
    x:
    - 2050
    - 2120
    y_int: 990
    berceau:
      y_fin: 1078
      sous_axe: 11
      jeu_x: 3
    bloc:
      h: 60
      jeu_tube: 0.5
      douille: 15
    poteau:
      d: 40
      ep: 2
      y: 1025
    cale: true
  hiloire:
    h: 30
    ep: 9
    inclinaison_deg: 45
    x_milieu: 1755
    y_plat: 460
    x_joue: 1950
  glissiere_collier_avant_0810:
    x:
    - 2050
    - 2120
    y_int: 990
    berceau:
      y_fin: 1078
      sous_axe: 11
      jeu_x: 3
    pehd:
      ep: 3
    sabot:
      h: 60
    poteau:
      x:
      - 2055
      - 2115
      ep: 9
    cale: true
  moteur:
    mode: vertical2
    vertical2:
      levee: 0
      levee_max: 674
      x_arbre: 1910
      y: 0
      tete_bas: 690
      tete:
        avant: 129
        arriere: 135
        demi_y: 60
        h: 140
      barre:
        d: 40
        l: 315
        x: -99
      nacelle:
        d: 100
        avant: 159
        arriere: 61
      helice:
        d: 236
        x: 66
        ep: 25
      aileron:
        h: 90
        x0: -50
        x1: 10
        ep: 10
      bride:
        dessous_tete: 52
        h: 164
        derriere: 40
        demi_y: 40
      tableau:
        ep: 40
        h: 110
        devant_arbre: 56
        sous_bride: 48
      puits:
        ep: 6
        demi_y: 128
        x_av: 1717
        fond_ouvert: true
        arriere_ouvert: true
      encoche_c4_z: 680
      encoche_c4_demi_y: 70
      trou_fond: 50
      bras_tube:
        larg: 30
        ep: 8
    avant2:
      bascule: 0
      y: 35
      pivot_x: 1620
      pivot_z: 530
      arbre_devant_pivot: 10
      arbre_au_dessus: 110
      rotation: 160
      tableau:
        derriere_pivot: 60
        ep: 40
        sous_pivot: 40
        h: 70
        demi_larg: 118
      fente:
        larg: 60
        haut: 580
        ep: 6
      canal:
        x0: 1454
        demi_larg: 118
        ep: 6
        x_ouvert: 1975
    transversal:
      bascule: 0
      x_arbre: 1775
      charniere_z: 500
      charniere_decalage: 80
      palier_av_x: 1510
      palier_ar_x: 1625
      bride_sous_charniere: 40
      arbre_au_dessus: 120
      planche_ep: 40
      planche_h: 70
      planche_demi_larg: 100
      flasque_ep: 20
      encoche_arbre: 80
      volet: true
      fente:
        x0: 1610
        x1: 1966
        y0: -40
        y1: 905
    ancien_mode: transversal
    arriere:
      type_chaise: fixe
      bascule: 0
      y: 620
      encoche_c4:
        demi_y: 45
        z: 470
      x_arbre: 1850
      bride_axe_z: 405
      bride_axe_devant_arbre: 10
      bride_axe_derriere_planche: 60
      bride_axe_sur_planche: 40
      arbre_au_dessus: 120
      rotation_tete_avant_bascule: 90
      planche_ep: 40
      planche_h: 70
      demi_larg: 100
      demi_passage: 110
      ep_joue: 25
      long_joue: 160
      carter:
        x_av: 1420
        ep: 9
      niche:
        x0: 1429
        x1: 2016.5
        demi_y: 125
        z_haut: 2000
        ep: 6
      charniere_z: 490
      charniere_derriere_arbre: 70
      bride_z: 500
      arbre_au_dessus_bascule: 50
      planche_ep_piv: 40
      ep_ferrure: 10
      long_ferrure: 80
    avant:
      bascule: 0
      rotation_tete: 160
      x_arbre: 1575
      pivot_z: 610
      tableau_ep: 40
      demi_larg: 90
      tableau_haut: 470
      tableau_bas: 350
      ep_joue: 25
      long_joue: 120
      boite:
        demi_y: 100
        ep: 6
        x_ar: 1960
        z_fente: 660
        face_fermee: false
    levee: 0
    arbre_l: 900
    arbre_d: 30
    bride_nacelle_max: 850
    recul_arbre: 70
    tete:
    - 200
    - 140
    - 260
    nacelle_d: 100
    nacelle_l: 300
    helice_d: 236
    chaise:
      x_face_ar: 1700
      ep: 40
      demi_larg: 120
      z_bride: 500
      z_bas: 380
    puits:
      x0: 1660
      x1: 1910
      demi_y: 120
      ep: 6
  joues:
    montee_fin_devant_mat: 0
  pylones:
    type: tube
    diam: 40
    ep: 2
    dx:
    - -50
    - 50
    y_int: 45
    renfort:
      ep: 18
      dx: 120
      dy: 100
    dy: 90
    x_ref: 1766
    semelle: null
    sur_semelle_mat: true
  ref_mat:
    z_pied: 348.1
  milieu_x_pied: 1766
  accroches_poutre:
    y:
    - -850
    - -420
    - -131
    - 131
    - 420
    - 850
    ep: 9
    jeu: 2
    au_dessus: 45
    sous_axe: 64
    integre: true
    pose:
      angle: 45
      course: 33
    sous_assise:
    - -850
    - 850
    brelage:
      diam: 5
      trou:
        u: -20
        v: -50
        diam: 8
    fin_x: 2112
  bancs:
    plan_z: 585
    longueur: 1195.5
    x_debut: 2022.5
    y_int: 800
    hauteur: 100
    rayon_aretes: 20
    etancheite:
      joint:
        larg: 10
        h: 10
      tape:
        ep: 6
        marge: 30
        jeu: 1
    ep_assise: 9
    ep_cotes: 6
    ep_fond: 4
    poutre_x: 2070
    poutre_z: 539.5
    longeron_y: 1093
    encoche_poutre_r: 42
    encoche_longeron_r: 28
    couples_x:
    - 2160
    - 2410
    - 2680
    - 2950
    - 3212
    couple_ep: 9
    caisson: false
    joue_jusqu_au_longeron: true
    entaille_dans_joue: true
    jeu_joue_longeron: 2
    evidement: null
    jambe:
      sous_axe: 115
      ext: 1162
      joues: 9
    lisse_rive:
      h: 40
      ep: 9
    rayon_assise: 4
    couple_ext: 1140
    couple_sous_axe: 44
    couple_ext_haut: 25
    lacage:
      x:
      - 2160
      - 2410
      - 2680
      - 2950
      - 3212
      diam: 5
      haut: 25
      droit: true
      matiere: Dyneema
  haubans:
    diam: 5
    attache_dx: 60
    attache_dy_av: 40
    etrave:
      x: 50
      dz: 12
    cadene:
      x: 2690
      dy: 186
      dz: 8
    croises_avant: false
    croise_dz: 45
    croises_arriere: false
    x_croise_ar: 1995
    collier_poutre:
      dz: 100
      poutre_dz: 10
      x_poutre: 2085
    tube_colliers:
      diam: 50
      ep: 2
      x: 2085
    semelle: null
    semelle_avant_0810:
      attache_dx: 100
      attache_dx_av: 100
      attache_dy_av: 14
      attache_dx_ar: 140
      dz: 10
      croises_avant: true
      croises_arriere: true
      pontet_interieur:
        x: 2690
        dy: 186
        dz: 8
hc16_origine:
  mat:
    x: 2070
    z: 700
    quete_deg: 7.5
    longueur: 8080
    diam: 75
  gv:
    amure_w: 600
    tetiere_w: 7950
    bordure: 2740
    chute: 7666
    surface: 13.77
    lattes: 7
  foc:
    surface: 5.12
    point_ecoute:
    - 2250
    - 1000
    jeu_amure: 150
    jeu_tete: 150
  etai:
    capelage_w: 6100
    patte_oie: 1130
    ferrure:
    - 250
    - 1000
    - 440
  cadene_hauban:
  - 2250
  - 1150
  - 330
  ecoute_gv:
  - 4145
  - 565
  ecoute_foc:
  - 2070
  - 330
  - 690
  cv_reference:
    x: 3010
    z: 3360
safrans:
  x: 5120
  corde: 220
  hauteur: 800
  z_centre: -120
  epaisseur: 20
  barre_x: 5350
  barre_z: 300
tente:
  x0: 2125
  x1: 4145
  demi_y: 1112
  z_arriere: 555
  z_tube: 1197
  y_tube: 1040
  sommet_z: 1880
  arceau_diam: 11
peinture:
- - ^banc_.*_(couple|machoire)
  - - 0.13
    - 0.13
    - 0.14
- - ^(accroche_poutre|machoire_poutre|collier_|semelle_|renfort_pont_|bourrage_)
  - - 0.13
    - 0.13
    - 0.14
- - ^(couple_coffre|moteur_puits|moteur_tableau|pylone_renfort)
  - - 0.13
    - 0.13
    - 0.14
- - ^coffre_trappe
  - - 0.91
    - 0.72
    - 0.14
- - ^(coffre_coque|coffre_capot|coffre_caisse|coffre_batterie_|coffre_cloison_moteur|coffre_table|joue_|banc_.*_(assise|caisson))
  - - 0.95
    - 0.95
    - 0.93
- - ^trampoline
  - - 0.89
    - 0.91
    - 0.92
- - ^lacage_trampoline
  - - 0.18
    - 0.44
    - 0.69
