jdb666/cao_hc16/(commit log)

2026-10-05 Projet HC16 Nacra 5.80 Rando : modèle, cotes, synthèse, page 3D, plans de découpe (état du 30/09/2026)
    Claude-Session: https://claude.ai/code/session_013SgiKxrueiCmJhE2J2EkWc
    [AS.dxf, B1.dxf, B2.dxf, B3.dxf, B4.dxf, BC1.dxf, BC2.dxf, BC3.dxf]
2026-10-05 Exports STEP du modèle
    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
    [cata_pleine_0.step, cata_releve.step, hc16_plateforme.step, hc16_rando_moteur_en_marche.step, hc16_rando_moteur_releve.step]
2026-10-05 Photos des relevés, dessins du gréement, dossier du 26/09
    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
2026-10-05 Centres véliques, gréement HC16 d'origine, book du projet
    - page 3D : CV de chaque voile et des deux, CV du HC16 d'origine au même
    réglage, gréement Hobie d'origine approché, couple de chavirage à méthode égale
    - etudes/greement_hc16.py, section hc16_origine des cotes
    - book/ : captures Playwright des vues et des figures
    - plan de découpe : notes sur les livardes corrigées
    - synthèse à jour
    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
    [cotes.yaml]
2026-10-05 Haubans des colliers vers le milieu de la poutre AV, capot arrière en pente
    - coffre.haubans.collier_poutre : œil sur plot de 100 au-dessus de l'attache arrière du collier,
    ferrure au milieu de la poutre AV (x 2085), Ø 4, 1 285 de long
    - coffre.capot_arriere : table jusqu'à x 1 760, capot CP 6 à 15° jusqu'à z 740 contre C4,
    découpe ±70 pour la tête du moteur, joues triangulaires CP 4
    - etudes/hauban_collier_poutre.py : jeux moteur en marche et relevé
    - page 3D, règles du plan de découpe (CR, CJ), synthèse
    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
2026-10-06 Collier indépendant du coffre sur le tube, emplanture sur rail
    - mats.collier : bloc CP 7 × CP 10, bague PEHD (le mât tourne), tourillon alu Ø 45 dans le tube,
    ferrures des haubans ; dessous 10 au-dessus du haut des joues
    - tube des colliers au-dessus du coffre (x 1 741, z 1 174), plus de traversée des joues
    - mats.emplanture : rail U 40 × 25 × 4, cale triangulaire boulonnée, ergot ; quête 0 à 6° au cran
    - mâts à y ±1 161 (11 de jeu à la joue), pontets du pied au bout du rail
    - etudes/collier_tube.py, dessin de la semelle, page 3D, synthèse
    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
2026-10-06 Mâts reculés de 194 (CV alignés sur le HC16), côtés du coffre raccourcis, formulaire des cotes manquantes
    - mats.x_pied 1960, z_pied 345.4 : CV par les contours x 3 206 comme le HC16, 258 plus haut, couple 125 %
    - coffre : joues tangentes au collier (pointe des joues 1 390 -> 1 584), milieu inchangé ; 754 -> 676 L
    - semelles des tubes du coffre (ST), renfort de pont découpé autour du pylône, pontets des haubans du pied
    - tube des colliers x 2 085 derrière la tête du moteur, collier 180 x 135
    - plan de découpe : 40 repères, 88 pièces ; book : captures et textes refaits
    - etudes/vol_zones.py : volume du coffre par zones (432 L hors zone centrale)
    - releves/page_cotes.py : formula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
    [AS.dxf, B1.dxf, B2.dxf, B3.dxf, B4.dxf, BC1.dxf, BC2.dxf, BC3.dxf]
2026-10-06 Formulaire des cotes : moteur réduit à la largeur de la tête et à l'ouverture de la bride
    Les cotes de profil du Protruar viennent déjà du schéma du manuel (p. 13) :
    elles sont affichées en gris sur le croquis ; 45 cotes au lieu de 58.
    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
2026-10-06 README à jour, sources du deck du book et script de mise à jour du book
    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
2026-10-06 Collier et emplanture en CP collé stratifié, haubanage à nu, fiche technique
    - Collier : 7 plis de CP 10 collés et stratifiés, chemise PEHD de 2 vissée,
    tourillon alu collé dans les plis 2 à 6 et goupillé ; emplanture : joues
    CP 10 × 40 percées Ø 8 tous les 20, cale en 3 plis de CP 10.
    - Plan de découpe : CO1-3, JE, CE (45 repères, 112 pièces, 7 plaques).
    - Book (71 pages) : haubans sans coffre ni trampoline, détail d'un pied,
    section 08 « Fiche technique » ; images et nomenclature refaites.
    - etudes/fiche_technique.py : poids estimés (≈ 215 kg à vide), charge utile
    (≈ 170 kg au déplacement maxi CE du HC16), assiette, comparaison HC16.
    - STEP complet, page 3D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
    [AS.dxf, B1.dxf, B2.dxf, B3.dxf, B4.dxf, BC1.dxf, BC2.dxf, BC3.dxf]
2026-10-06 Assiette refaite avec l'équipage près de la poutre AV, remèdes chiffrés
    - Référence : HC16 avec 2 équipiers près de la poutre AV (x 2 300), à plat
    (JD : « on navigue assis près de la poutre avant ») ; CdG du HC16 nu x 2 380.
    - Rando, équipage au même endroit : 0,9° sur le nez coffre vide, 1,6° avec
    60 kg au coffre ; garde du coffre ; bilan des moments par poste.
    - Remèdes : batterie devant la poutre AR, lourd sous l'arrière des bancs,
    équipage reculé ; page « Poids, charge et assiette » du book à jour.
    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
2026-10-07 Assiette : CdG des gréements poste par poste, écart statique avec le HC16
    - CdG du gréement HC16 (x 2 869 : quête 7,5°, bôme, voiles) et Rando
    (x 2 404) calculés poste par poste au lieu d'un décalage fixe.
    - Écart Rando − HC16 à équipage égal : 1,1° sur le nez coffre vide, 1,8°
    avec 60 kg au coffre ; calcul statique, sans l'enfoncement de l'arrière
    en route ni le couple de la voile (communs aux deux bateaux).
    - Batterie maintenue au centre ; page « Poids, charge et assiette » du
    book et synthèse à jour.
    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
2026-10-07 Batterie 24 V 50 Ah dans un caisson sur le banc, coffre raccourci, coffre à ancre
    - Plus de caisse ni de bac de batterie dans le coffre, plus de table ;
    avant du coffre droit au ras des joues (x 1 584) : 481 L (676 avant).
    - Coffre à ancre devant le puits : cloisons CP 6 à ±250, couvercle = bordé
    central au-dessus de z 450, rogné au capot arrière (une seule pièce, CV).
    - Caissons CP 6 sur l'avant des bancs contre C4 (BB, BR, BV) ; batterie
    LiFePO4 24 V 50 Ah à bâbord, rangement à tribord.
    - Contrôles : recouvrements 89, relevage sans contact, jeux du gréement
    inchangés ; plan de découpe 44 repères, 107 pièces, CP 10 en demi-plaque.
    - Fiche : ≈ 200 kg à vide, ≈ 1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
    [AN.dxf, AS.dxf, B1.dxf, B2.dxf, B3.dxf, BB.dxf, BC1.dxf, BC2.dxf]
2026-10-08 Accoudoirs, caissons de rangement, trappes de C4, glissière du tube, bancs renforcés
    - Batteries : deux 24 V 50 Ah en parallèle, une dans chaque accoudoir étanche
    au bout des bancs (CP 6, x 3 031 → 3 218) ; plus de caisson sur l'avant des bancs.
    - Dessus plat élargi à ±450, capot arrière d'autant ; caissons de rangement de
    42 L de chaque côté du moteur (couple plein déplacé de ±331 à ±420), trappe
    205 × 250 dans le capot ; une trappe 398 × 188 dans C4 par compartiment
    extérieur (139 L).
    - Le tube des colliers repose à chaque bout dans un berceau en U garni de PEHD,
    sur un sabot 6 × CP 10 au ras de la joue et un poteau caisson CP 9 jusqu'à la
    pièce d'angle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
    [AF.dxf, AI.dxf, AN.dxf, AS.dxf, AV.dxf, B1.dxf, B2.dxf, B3.dxf]
2026-10-08 Nom du projet : HC16 Rando, plus de référence au Nacra 5.80
    Titre du book, bandeau du plan de découpe, README, synthèse et en-tête de cotes.yaml.
    Couverture et pages 23 et 25 du book reprises telles que JD les a retouchées.
    Synthèse : question du poteau de la glissière (dans le coffre ?) notée en points ouverts.
    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
2026-10-08 Simplifications du gréement (modèle) : plus de haubans de pied, collier à 3 haubans, glissière tube carbone + bloc PEHD, semelle unique, emplanture 3 crans
    - haubans.semelle: null (étage des semelles retiré), croises_avant: false (ferrure du croisé retirée du collier) ;
    - glissière type tube_pehd : bloc PEHD (sabot et berceau d'une pièce) vissé à la joue, poteau tube carbone Ø 40 × 2
    au travers de l'assise, godet coulé sur le manchon de la pièce d'angle ;
    - une semelle par bord pour le mât et les tubes du coffre (échancrée au pylône), tubes posés dans son plan ;
    - emplanture à 3 crans (1,6 · 3,0 · 4,4°), joues de 140 ;
    - efforts refaits : hauban le plus chargé 6,6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
2026-10-08 Pont surélevé en mousse sur les coques, puits de mât, coffre et bancs posés dessus (modèle, en cours)
    - pont_sureleve : de l'étrave (x 150, épaisseur nulle) au plateau z 495 (x 1 400), sous le coffre (3 de jeu), sous la
    poutre AV et les longerons, jusqu'à x 4 080 (bout du trampoline) ; plafonné sous la pièce d'angle AV, la martingale,
    le brêlage et l'accroche ±850 ; trou autour du pylône AV ; 201 L par coque ;
    - puits de mât rond (quête fixe 3°) : fourreau Ø 63 intérieur, plot CP sous le talon, ergot ; talon à la même hauteur
    que l'ancienne cale (voile inchangée) ; plus de semelle, bourrage, renfort de pont ni emplanture ;
    - coffre posé sur le pont surélevé (plu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
    [cotes.yaml, v_pleine_0.yaml, v_releve.yaml]
2026-10-09 Retour sans pont surélevé (JD 09/10) : il n'empêche pas la coque sous le vent de s'enfoncer à la gîte
    Le pont surélevé ne porte qu'une fois le bord du pont dans l'eau, et ses 32 kg font enfoncer davantage la coque
    sous le vent. Retour à la semelle commune, à l'emplanture à 3 crans, aux tubes carbone du coffre et au laçage des
    bancs ; les autres simplifications restent (plus de haubans de pied, collier à 3 haubans, glissière tube carbone et
    bloc PEHD). À la place : liston en mousse sur le flanc extérieur des coques (options à l'étude).
    This reverts commit cc8a5ac.
    Claude-Session: https://claude.ai/code/session_013SgiKx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
    [cotes.yaml, v_pleine_0.yaml, v_releve.yaml]
2026-10-10 Plus de glissière, poche à ancre et puits ouverts, ouvertures de C4, trampoline lacé, tente igloo, vues par en dessous (JD 09/10 après-midi)
    - Appui du tube : plus de bloc PEHD ; le tube repose à plat sur la potence (remontée de 40),
    les haubans l'avancent ou le reculent ; poteau carbone Ø 50 × 2,5 de 534.
    - Coffre à ancre ouvert comme une poche : plus de couvercle, face avant jusqu'à z 650,
    deux évacuations Ø 25 au fond.
    - Puits du moteur sans face arrière : C4 ouverte sur ±128 du fond au capot (C4 en deux moitiés).
    - Compartiments extérieurs : grande ouverture polygonale dans C4 au-dessus des assises, sans trappe.
    - Trampoline en deux moitiés lacées au milieu ; trappe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
    [AF.dxf, AI.dxf, AN.dxf, AS.dxf, AV.dxf, B1.dxf, B2.dxf, B3.dxf]
2026-10-10 Reprendre avec un autre compte Claude : README, three.js et polices des captures dans book/vendor
    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
2026-10-10 requirements : scikit-fem (étude de résistance du banc)
    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
2026-10-10 Book en PDF : book/book_pdf.py (diapos du deck, images locales, polices vendor) -> book/HC16_Rando_book.pdf, 80 pages 1920 × 1080
    Images du deck absentes de carte_images.json dans book/img/blobs ; d-etanche.html repris de la version en ligne (retouche JD).
    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
2026-10-10 book_pdf.py --leger : version courriel du book (JPEG à leur taille d'affichage, qualité 72) : 4,5 Mo au lieu de 16,8
    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
2026-10-12 Équipage assis face à face (H 1,80 m, F 1,60 m) et point d'écoute automatique selon l'enroulement (JD 12/10)
    - Page 3D : case « Équipage assis », deux mannequins sur les bancs (proportions Drillis et Contini),
    place réglable, changer de bord ; gardes des têtes sous les voiles et des bras au tube des colliers.
    - Point d'écoute automatique : voile pleine sur le rail de la poutre AR ; roulée, l'écoute va au point
    qui suit la tire idéale, du bout du flotteur à l'angle des poutres ; chaque voile a son point.
    - etudes/equipage_ecoutes.py : gardes et points calculés par la page ; book : page « Deux équipiers
    assis face à face », page écoute refaite, vues à 50 et 75 % refai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
2026-10-12 Tente sur arceaux croisés du tube des colliers à la poutre AR, avancée sous le tube (JD 12/10)
    - plans/tente.py v3 : pieds sur le dessus du tube des colliers (y ±1 050) et sur la poutre AR (y ±1 040) :
    rectangle d'appui 2 060 × 2 100 (2 080 derrière), avant 639 plus haut ; arceaux en élastique, 3 755,
    40° / 65° aux pieds ; toile en membrane tendue au-dessus du bateau (garde 25), sommet z 1 881 ;
    avancée jusqu'à l'hiloire (par défaut) ou rideau sous le tube (variante c4) ; hauteur sous la toile.
    - Page 3D et book (page tente, points ouverts) mis à jour, PDF refait.
    - SYNTHESE : tente du 12/10, étude « CP 6 partout ? » (poids, cintrage du bordé, bancs).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
2026-10-12 Études du 12/10 : tente igloo du commerce (≈ 250 × 200) et CP 6 partout
    - etudes/tente_commerce.py : dôme du commerce à 2 arceaux croisés posé sur la maquette, pieds AR sur
    la poutre AR, pieds AV sur l'avant du coffre (arceaux rallongés à 4,35 m) ; 250 × 200, 240 × 210,
    260 × 210 (MH100 4 places) : pieds, sommet, ce qui traverse la toile, gréement, hauteurs ; vues.
    - etudes/cp6_poids.py : poids et surface de CP en CP 6, rayons de cintrage du bordé de l'avant.
    - etudes/banc_resistance.py : BANC_EP, BANC_COUPLES_DOUBLES, BANC_OUT (résultats CP 6 versés).
    - plateforme/page.py : TENTE_JSON, PAGE_OUT pour les variantes de tente.
    - SYNTHESE : sections « CP 6 partout ? » (fic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
